meetyaothenstop/vscode/README.md

# STM32G474 双向 Buck-Boost 主工程

用户要求的主工程为 **`MDK-ARM/bidreaction.uvprojx`**，Target 为`bidreaction`，
HEX为`MDK-ARM/bidreaction/bidreaction.hex`。保留正向Buck/Boost及反向Buck/Boost，
不复制工程。原`bench12_buck_fast`保留为唯一受限台架参考。用户自行下载，助手不烧录。

## 当前版本

2026-11-10：**MAIN反向Buck/Boost完整共用正向控制**，版本`FCTRL1`，
标签`main-reverse-forward-control-20261110`。正反向独立状态，反向只映射端口、电流符号和模式。
电压PI0.3/8、Boost前馈0.2倍、90%Vin预充、初始化/滤波/软启动/抗饱和与正向一致；
取消MAIN反向独有HOLD/重新软启动，独立OVP和其他电气/ADC/方向/时序保护保持。
反向Boost欠压仍7V试验，其余三模式9V；ADC物理通道保持。
两Buck50/10kHz、两Boost25/5kHz，PWM/ADC/快速保护150kHz；默认正向18→3V、反向12→18V。
首页`MAIN ADC FCTRL1 R7`，反向页面`REVERSE BUCK/BOOST FCTRL1`。

89组完整回归、144万步对备份正向算法完整状态逐位对比、主/bench ARM6.18构建0错误0警告、
实际映像核验通过；bench HEX保持。主HEX SHA256：
`8335E0910AECE02CA2D87E3F88C80C4CA665CDF798BE3172CDD0171EAA39390F`。
模型12→18V约17.994V；24/35→36V启动正反两方向均触发原过流保护，不能称全范围稳压通过。
新算法启动电流需求可能超过现有0.9A限流，实板仍待用户下载验证；没有证实16V抖动已解决。
修改前`pre-reverse-forward-control-20261110`已先上传核对，
见[版本与备份对照](docs/版本与备份对照.md)和[替换与测试记录](docs/反向共用正向控制测试-20261110.md)。
2026-11-11仅补充主机机制分析：90%Vin预充结束后，输出尚低于输入即进入Boost，
模型中占空命令已到0仍出现接管电流峰值；见[接管输入冲击机制](docs/Boost接管输入冲击机制-20261111.md)。
该分析没有改固件，也未确定实板欠压根因；用户工作区后续默认18→36V改动保留。

## 反向7V试验及16V现场历史（2026-11-09）

修改前板测反馈：7V反向Boost可RUNNING，但12→18V/100Ω的实测与显示输出约16V且抖动，
输入显示12V、电源面板约0.3A、CC不亮。根因未确定，待核对HOLD/参考/占空比；
本次排查未改固件。源码及合成机制证据见[16V抖动排查](docs/反向Boost16V抖动排查-20261109.md)。

2026-11-09后续：用户在反向12→18V、100Ω、电源限流0.9A时报2/IN8.99V，
要求将欠压降至7V试验。本版仅将MAIN反向Boost输入窗改为**7～42V**，
其他三模式仍9～42V；请求与后续各阶段共用该门限，其他保护、ADC、PI及控制频率保持。
保留用户默认正向18→3V、反向**12→18V**；首页`MAIN ADC B25/5 R7`，
反向Boost页`REVERSE BOOST R25V7`。版本标签`main-reverse-boost-uv7-20261109`。
86组完整回归及独立只读审查通过；主/bench ARM6.18构建均0错误0警告，实际映像核验通过，bench HEX保持。
主HEX SHA256：`54B96039A64A9CFA48E7ABD7A8A880C63BCA93AA66AE67188BF7F5E18FC23479`。
7V是用户要求的门限试验，尚未确定8.99V属于真实压降还是采样干扰；实板行为仍待用户下载验证。
详情见[反向Boost欠压7V测试](docs/反向Boost欠压7V测试-20261109.md)。

## 反向Boost门限与频率对齐历史（同日早先）

2026-11-09：MAIN反向Boost的输入/启动/过压检查及控制频率已对齐正向Boost，
版本标签`main-reverse-boost-align-20261109`。
四模式共享输入9～42V、启动严格|IL|<1A、输出残压≤3V、
OVP为min(max(最终目标×1.5,6V),40V)；两个Boost均25kHz电流/5kHz电压计算，
两个Buck50/10kHz，PWM/ADC/快速保护150kHz。
反向保持右ADC1输入、左ADC1输出及负IL，连续PI和原预充/HOLD恢复逻辑保持。
86组完整主机回归、独立旧源72万步状态对比、主/bench ARM6.18重建0错误0警告和实际映像核验通过；bench HEX保持。
首页`MAIN ADC B25/5 R1`，反向Boost页`REVERSE BOOST R25V9`。
主HEX SHA256：`93990C58277572D5109B2E6035DA3866BF8B1AE747F5380C69A9436F31C90CE6`。
保留用户默认正向18→3V、反向12→6V；反向Boost需在菜单选择reverse并设置有效升压目标。
下载由用户操作，实板时序、电气表现及硬件OCP接线未验证。
范围、指纹和复测说明见[反向Boost对齐测试](docs/反向Boost对齐测试-20261109.md)。

用户历次报错的触发条件、已知结论及完整S/T编号见[故障报错对照清单](docs/故障报错对照清单-20261109.md)。

此前接续信息见[2026-11-08对话摘要](docs/对话接续摘要-2026-11-08.md)：用户反馈正向12→24V正常，12→36V/100Ω在0.7A电源限流时报欠压，调到0.9A后报128 S7，尚未定位。本轮未继续排查这些实板故障，板上版本仍需单独核对。

## 主工程欠压9V历史（2026-11-08）

2026-11-08：按用户要求，将MAIN共用输入欠压门限**10V降至9V**，输入保护窗口为9～42V。
适用于正向Buck、正向Boost和反向Buck；请求检查与后续各阶段保护共用
`Core/Inc/power_build_config.h`的`POWER_MAIN_BUCK_INPUT_MIN_VOLTS=9.0f`。
反向Boost保持6～40V，受限bench策略及HEX保持；Buck原占空比/目标可达性检查仍生效。
保留本次工作区已有的正向**12→24V**默认设置（上版为18V输出），反向仍12→6V。
ADC2固定4.8us输入采样、Boost25/5kHz及其余50/10kHz、150kHz快速保护保持，页面标识仍B25A2。
81组完整主机回归及审查后定向边界测试通过；主/bench ARM6.18构建0错误0警告，实际镜像核验通过。
主HEX SHA256：`96CDC014A36699EF721FAFF97398E8ECA5BEA6910E376F3F5E238CCB614973BD`。
修改前4a3b4bd已用`pre-main-uv9-20261108`上传核对，版本标签`main-uv9-20261108`。
验证见[9V欠压测试](docs/主工程欠压9V测试-20261108.md)。用户自行下载并使用配套AXF；不宣称采样噪声或实板T7已解决。

## 正向统一ADC2历史

2026-11-08：按用户要求，将MAIN**正向Buck和Boost的输入电压统一到ADC2/PA0延后采样**，版本`B25A2`。
固定在PWM周期起点后4.8us触发，配置为`Core/Inc/power_build_config.h`中的`POWER_INPUT_ADC_PHASE_TICKS=23040U`。
请求快照、有效性、自举/装载/预充/换向/运行保护和worker使用同一来源；ADC2无效则拒绝启动或关断，无ADC1回退。
电流与输出电压继续原ADC1序列，反向模式保留ADC1语义。
PWM/ADC/快速保护150kHz、Boost25/5kHz、其余模式50/10kHz和10V欠压等全部门限保持。
首页`MAIN ADC B25/5 A2`，正向Boost页`FORWARD BOOST B25A2`，默认仍12→18V。

用户进一步明确关注开关沿干扰：当前4.8us为固定触发，**未动态随PWM占空比避开边沿**。
例如Boost占空指令0.18时，右桥CMP1约4.8467us，仍会靠近触发点；实际还需考虑触发延迟、采样窗口及死区。
本版不保证全工况避沿，也不宣称实板欠压或T7已消除。

81组完整主机回归及独立只读审查通过；主/bench ARM6.18构建0错误0警告，bench HEX保持。
实际HEX/CCM/整数快速路径/AXF导出核验通过。
主HEX SHA256：`ABCB45F73628DA7D55C5817E744CDC62960BAD57533679889AE78101292829F7`。
修改前`802b9ad`已用`pre-forward-input-adc2-20261108`上传并核对；版本标签`main-forward-input-adc2-20261108`。
用户自行下载主工程HEX并使用配套AXF；验证及复测见[正向统一输入ADC2测试](docs/正向输入统一ADC2测试-20261108.md)。

## 正向Boost25/5kHz历史

2026-11-08：主工程正向Boost采用用户批准的**25kHz电流/5kHz电压计算**，版本`B25/5`。
PWM、ADC及快速保护仍150kHz；正向Buck、反向Buck/Boost仍50/10kHz，唯一bench保持原150kHz控制。
mode2每6个PWM请求后台计算，T7窗口由20us变为40us，超期仍关断；其余模式每3个PWM。
仅专用Boost入口积分步长改40/200us，6238rad/s低通按对应步长重新离散化；连续PI增益及每秒斜坡保持。
原一步逻辑延迟在此频率下为40us，实际换向仍需至少3个PWM全关断并等到新的Boost plan。
输入10～42V、启动<1A/残压≤3V等保护门限保持，未因电源表12V反馈放宽欠压10V。
首页`MAIN ADC B25/5`，正向Boost页`FORWARD BOOST B25/5`；其他模式保留原参数页标识。
默认仍正向12→18V、反向12→6V。

78组完整主机回归、两速率旧算法同采样率完整状态对比、四模式名义开关模型通过。
主/bench ARM6.18构建0错误0警告，实际HEX/CCM/快速整数路径/AXF导出核验通过，bench HEX保持。
主HEX SHA256：`8389EC0754E6815AAB6A173CE2CBE537B3FDFC36CADAC166B8992FD30A9A914F`。
降频前`8564652`已用`pre-forward-boost-25k-20261108`上传并核对；版本标签`main-forward-boost-25k-20261108`。
验证与下载后观测见[正向Boost25/5kHz测试](docs/正向Boost25k5k测试-20261108.md)。
用户自行下载HEX并使用配套AXF。本版尚待实板验证，不宣称T7已消除或IN9.9V物理根因已确定。

## 正向Boost精简OPT1历史

2026-11-08：正向Boost后台精简版OPT1，保持150/50/10kHz、PI及保护门限。
真实worker仅mode2改用受保护专用入口；保留全部状态更新，移除未使用的Buck除法。
77组主机回归通过，包括独立旧源两速率共72万步完整B/X/Y逐位比对；主/bench ARM6.18均0错误0警告，bench HEX保持。
专用函数1460字节、1条VDIV，原完整入口1612字节、2条VDIV；这不是实板耗时证明。
用户已重新编译下载精简版，反馈仍报64 T7，并另报2 IN9.9V，电源表12V。
因此本版**未解决实板T7**；2表示ADC测得输入低于10V，瞬态压降与采样异常尚未区分。
用户已批准下一版仅正向Boost改25/5kHz；此处先保留OPT1原版作为降频前基线。
主HEX SHA256：`A16B03ACCC516B9DCB4FBD75D73F511150DB34E510A3007126344BAA5BBF18A7`。
记录见[正向Boost精简测试](docs/正向Boost运行精简测试-20261108.md)，版本标签`main-boost-worker-opt1-20261108`。

## 正向Boost门限对齐历史

2026-11-07：用户明确选择将MAIN正向Boost的全部电气保护与冷启动门限对齐Buck：
实测输入10～42V、启动`|IL|<1A`、输出残压≤3V、
过压线`min(max(最终目标×1.5,6V),40V)`。
统一引用[`Core/Inc/power_build_config.h`](Core/Inc/power_build_config.h)中的`POWER_MAIN_BUCK_*`门限组，
不再保留单独的正向Boost启动电流副本。请求校验与后续冷启动/运行IRQ共用缓存策略。
正向Boost启动仍要求最终目标高于实测输入、目标≤36V；不使用Buck的0.95降压关系。
10～42V是采样保护窗口，不表示当前36V输出上限能够在42V输入时升压启动。
反向Boost保持原6～40V、0.25A/0.25V、目标×1.1；电流参考6A、采样过流7.5A、
方向/ADC/时序保护、Boost预充/换向/软启动和150/50/10kHz频率保持。
这是门限策略调整，不证明原128 S8/S9或故障4的物理根因已解决。

保留用户已设置的正向默认12V→18V、反向默认12V→6V。
标识仍为`MAIN ADC ADG2 50/10`、`M-ADG2`，事件版本4。
75组完整主机回归通过；主/bench ARM6.18构建均0错误0警告，bench HEX保持，独立只读审查无需修正的问题。
主HEX SHA256：`624DA1162750FC0567DD4D6959101F2DE2C6065D6F73BB3F6D1F127C77BDDDDD`。
修改前`7c985e9`已用`pre-forward-boost-align-20261107`上传核对，
本版标签`main-forward-boost-align-20261107`。验证及范围见[正向Boost门限对齐](docs/正向Boost门限对齐Buck-20261107.md)，
前一版仅修改启动电流的记录见[启动1A历史](docs/正向Boost启动1A-20261107.md)。
由用户下载；本次没有操作板子，未证明实板稳压、最坏时序或硬件OCP接线。

## 默认电压设置

正反向菜单的默认输入、输出电压统一在
[`Core/Inc/power_build_config.h`](Core/Inc/power_build_config.h)的`Power-on menu defaults`段。
主工程修改`#if POWER_MAIN_APPLICATION`下面相邻的四个宏：

```c
#define POWER_FORWARD_DEFAULT_INPUT_VOLTS  18U
#define POWER_FORWARD_DEFAULT_OUTPUT_VOLTS  3U
#define POWER_REVERSE_DEFAULT_INPUT_VOLTS  12U
#define POWER_REVERSE_DEFAULT_OUTPUT_VOLTS 18U
```

菜单初始化直接引用这些宏；调试邮箱`power_target_volts`仍默认取正向输出值。
输入设定用于菜单选择Buck/Boost，实际输入仍由ADC测量；这里的默认值不是软启动斜坡起点。
先前集中配置时的等价性验证见[默认电压配置整理](docs/默认电压配置整理-20261107.md)；
当时的正向默认24→12V随后多次由用户调整；2026-11-09修改前以`70e5a84`保存当前18→3V默认。

用户本次反馈反向Buck已能正常从36V降至6V；本次未补充负载、运行时长或同步波形。
该反馈不扩展为全范围、实板最坏时序或硬件OCP验证；历史故障1/4/16的物理根因和调试连接状态未重新核验。

## ADG2版本历史

2026-11-04：当前为**MAIN ADG2 启动ADC入口时序定位候选**，首页`MAIN ADC ADG2 50/10`、参数页`M-ADG2`，事件版本4。
ADG1补充实板记录：ADC1入口0x1（仅ADRDY）、ADC2入口0xF（有EOC/EOS且无OVR）、reason1；用户确认持续运行，只按板上START。
冷启动BOOTSTRAP剩余30，正常闭环尚未投入。已在真实后端的合成迟到时序中复现相同标志/阶段；这不是实板迟到或物理根因的证明。
ADG2仅在ADC故障分支补填原`power_status.fault_spacing_cycles/fault_counter_ticks/fault_elapsed_cycles`，保留精确ADC入口标志，用下一次实板记录验证前一次IRQ迟到的假设。
频率仍为PWM/ADC/快速保护150kHz、电流50kHz、电压10kHz；PI、保护条件/门限及FRM1界面续传保持。用户操作下载，助手未操作板子。
修改前7564102已用`pre-adcphase-20261104`上传核对；版本标签`main-adcdiag2-20261104`。主/台架ARM6.18重建0错误0警告，台架HEX保持。
71组回归及诊断关闭兼容检查通过，独立只读审查无问题；实际镜像/CCM/栈/DMA/AXF及快速整数指令检查通过。
主HEX SHA256：`739DAAE0835E7A8207615E6D8B67473832D11E45665CA3B8819043114328E815`。
复测表达式、证据与假设边界见[ADG2测试说明](docs/ADG2启动ADC时序测试.md)。下载主工程HEX并加载配套AXF，不沿用旧地址；不宣称报1/16已解决。
最新用户反馈：目前主要报4和16，按START立即出现与接近6V后出现两种情况都有。此前提交的截图power_status.fault=0、power_event.fault.valid=0，尚无这两类新故障的有效首包；需读取fault_v_left/right、fault_il及首故障code/state。反向Buck目标6V时，4为计算输出>9V，16为计算IL>+1A连续16个PWM采样；ADC专用字段不用于判断这两项。真实越限与采样偏差仍未区分，未据此改动固件。
最新阻塞：Keil大量`Cannot access Memory`，同一fault独立项16与结构体0x01010000矛盾；用户确认OLED正常刷新、显示4。用户确认功率输出停止且故障保留后，助手尝试一次暂停CPU，Keil报`Cannot access target. Shutting down debug session.`，未能确认暂停成功；保留错误弹窗，未复位/重连/下载。用户要求先整理交接，完整接续信息见[2026-11-04摘要](docs/对话接续摘要-2026-11-04.md)，先恢复可靠调试读取，再判断电气根因。

## ADG1版本历史

2026-11-04：当时为**MAIN ADG1 ADC首故障定位候选**，首页`MAIN ADC ADG1 50/10`、参数页`M-ADG1`。
用户确认OLED已正常刷新，但按START一开始偶发报1，工况仍是右12V→左6V、100Ω。
报1为ADC有效性保护，尚无足以确定转换/触发/清标志根因的实板记录，不能据此认定控制频率过高。
本版关断后锁存原中断入口ADC1/ADC2标志，新增`power_event.fault.adc_reason`及`adc1_entry_flags/adc2_entry_flags`，事件版本3。
原因1=缺JEOS，2=JQOVF，3=两者同时，4=正向Buck所需ADC2延后采样无效；`fault_detail`同步记录原因，OLED故障码仍为1。
保留FRM1界面续传，频率仍为PWM/ADC/快速保护150kHz、电流50kHz、电压10kHz；PI和保护条件/门限保持。
修改前d54d61a已用`pre-adcdiag-20261104`上传核对，版本标签`main-adcdiag1-20261104`。
70组回归和诊断关闭兼容后端通过，独立只读审查无阻断问题；主/台架ARM6.18重建0错误0警告，实际镜像/CCM/栈/DMA/AXF及快速指令检查通过，台架HEX保持。
主HEX SHA256：`82AD7C7F52F283F974369F1B8F45C204F83DB79E6A4A9AF7C62E9B68176A7428`。
用户自行下载原主工程HEX并加载配套AXF，复测方法及原因表见[ADG1测试说明](docs/ADG1故障1定位测试.md)。不沿用旧地址，不宣称实板报1/16已解决。
ADG1首次故障截图：valid=1、code=1、detail=1，锁存冷启动BOOTSTRAP（state=1）、反向Buck（mode=3），自举剩余30、占空指令/参考均0；启动年龄0x570个CPU周期（按150MHz约9.28μs）。已定位到闭环运行前的ADC1入口JEOS缺失分支，原始ADC入口标志尚未提供，触发/完成/清标志根因待查。

## FRM1版本历史

2026-11-04：当时为**MAIN FRM1 界面续传与长时间观测候选**，首页`MAIN ADC FRM1 50/10`、参数页`M-FRM1`。
用户更正万用表电流检测输出为2.49V（运行及报错后），输出约5.9V，界面约1～2分钟后恢复并报16。
修复已复现的启动/运行切换时反复丢帧问题：暂停保存页面快照，数据包完成后推进页码，完整帧后合并新遥测；停止/故障仍优先，启动不开始新传输。
power_event.version=2，新增完整帧计数及基于既有ADC周期数的年龄，避免仅凭28.63秒回绕的DWT解释分钟级现象。
ADC计数不是独立墙钟；物理电流反转/采样尖峰/ADC异常未区分，本版不宣称16或实板问题已消除。频率、PI、保护门限保持。
修改前14b4a76已用pre-oledframe-20261104上传核对，版本标签main-oledframe1-20261104。
69组回归及独立只读审查完成；主/台架ARM6.18重建0错误0警告，实际镜像/CCM/栈/DMA/AXF和快速指令检查通过，台架HEX保持。
主HEX SHA256：`E0A1963EEFFAC4E2E9399342CE7F9FFCC6BB4CD7B64FDA79105472D4B6A365BE`。
验证记录及用户复测方式见[FRM1测试说明](docs/FRM1界面续传测试.md)。继续原主工程，用户自行下载HEX并加载配套AXF，不沿用旧地址。
用户随后报告FRM1的OLED已可正常刷新，但偶尔报1。代码1为ADC有效性保护：ADC1注入序列未完成/队列溢出，或适用时ADC2延后输入样本无效；尚无本次故障包，不能认定控制频率或模拟电流门限为根因。

## EVT1版本历史

2026-11-03：当时为**MAIN EVT1 故障阶段/前台进度诊断候选**，首页`MAIN ADC EVT1 50/10`、参数页`M-EVT1`。
基于RAW1定位反向12→6V、100Ω的故障16及OLED停更，频率/PI/保护门限保持；不宣称已修复实板问题。
Watch新增`power_event.fault`，关断后锁存原状态、自举/装载/恢复计数、指令，以及前台/UI入口和上次页面提交的时间。
前台双缓冲发布不新增关中断区，正常快速IRQ/worker无新增事件探针；下载由用户操作。
66组回归通过，主/台架ARM6.18重建0错误0警告，实际镜像/CCM/栈/DMA/AXF及快速指令检查通过；台架HEX指纹保持。
主HEX SHA256：`C8BA5AD2686512F89992D31F3282BB414555903AF222EF9A37371D1B0515936B`。
修改前9652d4b已用`pre-eventdiag-20261103`上传核对；版本标签`main-eventdiag1-20261103`。
由用户下载原主工程HEX并加载配套AXF，按[EVT1测试说明](docs/EVT1故障定位测试.md)复测，故障后保留`power_status`及`power_event.fault`。
启动准备期间mode/target可能是暂定配置；页面提交不等于物理显示完成，计时/现场解释限制见测试说明。
最新EVT1复测仍报16：锁存RUNNING、恢复标志1、参考4.300V、输出5.453V、电流+1.006A。
本次前台/UI入口最大间隔约22ms，故障前约1.7ms执行过；主机复现启动/运行频繁切换导致界面反复重发第0页、后续页饥饿的机制。
这未唯一证明实板界面根因，也未定位真实回流/采样原因；固件仍EVT1，详见[EVT1现场](docs/EVT1反向故障16现场-20261103.md)。

## RAW1版本历史

2026-11-03：当时为**MAIN RAW1 整数快速路径候选**，首页`MAIN ADC RAW1 50/10`、参数页`M-RAW1`。
PWM、ADC及快速软件保护仍为150kHz，电流环50kHz、电压环10kHz。
快速IRQ使用原始ADC整数区间及Q24脉冲密度累加，换算和浮点控制计算放在PendSV；原保护边界和T1..T7保留。
增加正常快速路径峰值、worker启动等待、运行墙钟时间和观测到的快速IRQ C耗时字段，便于区分下一次T7的时间消耗。
修正前040164c已以`pre-fastirq-raw-20261103`备份到GitHub。版本标签`main-fastirq-raw1-20261103`。
62组回归通过，主/台架ARM6.18重建均0错误0警告；实际HEX/AXF导出、CCM/PendSV/DMA及正常快速函数无FP指令检查通过。
主工程栈2KiB，台架HEX与此前逐字节一致。主HEX SHA256：`EC70E24DD17AC423BAA0C875F83C4F595246AE9813FD9F72FBE6F1239F5CA04A`。
用户反馈反向12→6V、100Ω时万用表到6V，OLED数秒停更后报16；锁存输出5.225V、电流+1.232A。
经用户授权只读查看Keil，恢复标志1、自举/装载计数均0、最后发布参考4.1898V；至少经历过HOLD恢复，故障不在未完成的自举/装载等待中。
本次记录为方向保护，尚未定位真实回流/采样异常及OLED停更根因，不能据此称实板时序、闭环稳定性或硬件OCP接线通过。
固件仍为RAW1，未修改/重新下载；现场和补测见[反向故障16记录](docs/RAW1反向故障16现场-20261103.md)，原交付验证见[RAW1测试记录](docs/控制降频RAW1测试.md)。

## 50/10kHz首版历史

2026-11-03：当时为**MAIN 50kHz电流环 / 10kHz电压环候选**，首页`MAIN ADC I50 V10`、参数页`M-50/10`。
PWM载波、ADC触发和快速软件保护仍为150kHz；控制计算移到可被快速中断抢占的PendSV，每3个PWM周期请求一次。
电压PI每5次电流环更新一次。积分/反馈滤波器按20us/100us重新离散化，连续PI增益保持。
计算完成后在最近的安全PWM中断提交两侧比较值，下一共同更新边界装载；未能在下一次50kHz请求前完成则报64 T7关断。
低占空比Buck/预充使用逐PWM周期最小/空脉冲密度调制，避免三周期脉冲成组引起低压启动摆动；正反Boost交接全关断等待新plan。
30周期自举、2周期装载等待及原有电气保护门限保留。唯一台架参考保持150kHz控制，HEX与RES1台架一致。
修改前源码已以`pre-control-multirate-20261103`备份到GitHub并核对远端SHA；大改前备份约定已写入AGENTS.md。
54组回归通过，主/台架ARM6.18均0错误0警告，实际HEX/CCM/PendSV/DMA/AXF导出核验通过；主工程专用栈2KiB。
这是待用户下载的候选，**尚无实板最坏时序或闭环稳定性验证**。构建和测试记录见[控制降频记录](docs/控制降频50k10k测试.md)。

## RES1版本历史

2026-11-03：当时为**反向Buck HOLD分步恢复候选RES1**，首页`MAIN ADC RBUCK RES1`、参数页`M-RRES1`。
W128后用户在12→6V遇到64 T5：907/1000/31072，恢复标志1、自举剩余30，确认在HOLD恢复开通低侧后超退出相位。
仅MAIN反向Buck将恢复计算/缓存与低侧开通拆到相邻IRQ：先保持全关断，下周期新鲜采样及全部保护后复查再开低侧；
完整30周期自举和2周期装载等待保留。840/27904、936/29952及T1/T2/T6、电压/电流保护保持。
48组完整回归、独立代码审查、主/台架ARM重建0错误0警告、实际HEX/CCM/DMA/无探针及AXF导出核验通过；台架HEX未变。
主HEX SHA256：`B0231D707403A763FA916BFD5CF72535160FB7ABA88B3E756B295D031CF97A55`。
本版未板测，不能据此声称T5或输出异常已消除；用户自行下载，见[分步恢复测试](docs/反向Buck分步恢复测试.md)。
下个对话接续请先读[2026-11-03对话摘要](docs/对话接续摘要-2026-11-03.md)；相同摘要已整理用于最初的`双向buckboost.md`文档顶部。

## 反向W128版本历史

2026-11-02：当前为**反向Buck W128写入窗口候选**，首页`MAIN ADC RBUCK W128`、参数页`M-RW128`。
OPT1交付后用户反馈64 T4：写前792周期、间隔1000、相位27232，比旧26880线晚11CPU周期。
本版仅将MAIN反向Buck写前相位期限26880→27904，与正向相同，更新前工程预留160→128CPU周期；
写前DWT840、写后DWT936/相位29952及T1/T2/T6保持，Boost/台架仍26880。
PI、ADC/PWM、OPT1精简直达路径及电压/电流保护保持；48组回归及主/台架ARM重建0错误0警告，
实际HEX/CCM/无探针/DMA/AXF导出核验通过；成对写入段13条ARM指令与OPT1相同，台架HEX保持。
主HEX SHA256：`8376F6A02A2C32C86D16BD85C072A85AB67D711783A62877F7083BABBE5B58BF`。
128/64周期为工程预留，不是板上最坏耗时证明；本版待用户下载测12→6V，见[反向W128记录](docs/反向Buck写入窗口W128测试.md)。

## 反向首步OPT1版本历史

2026-11-02：当时为**反向Buck首步时序OPT1候选**，首页`MAIN ADC RBUCK OPT1`、参数页`M-RBO1`。
首版交付后的用户截图为64 T3：写前855周期、间隔1000、相位29248，超过840及26880两条截止线；
参考0.1V、isr_cycles_max0符合首次控制步写前退出。当前减少重复校验/通用分发与小占空比转换开销，
只让已通过ADC及输入/输出/电流保护的后台直达Buck步；公开reverse_step接口继续检查无效输入。
时序门限840/26880、936/29952及T1/T2/T6均保持，PI/采样/PWM/全部电压电流保护保持。
48组回归通过，公开/直达路径共60万次位一致性及独立旧源参考比对通过；主/台架ARM均0错误0警告，
实际HEX/CCM/无探针/DMA与AXF导出一致性通过，台架HEX未变。Buck主体788→656字节，非实测周期结论。
主HEX SHA256：`ABE8985210FC9D531A1BFB235F3A888CBC0AAC0EE1478D6746A9AE6FA55E623D`。
本版仍待板测，不能由主机/静态代码声称T3/T4已经修复。用户自行下载并重复12→6V，见[首步时序OPT1](docs/反向Buck首步时序优化测试.md)。

## 反向12V→6V首版历史

2026-11-02：当时为**反向Buck12V→6V候选**，首页`MAIN ADC RBUCK12-6`、参数页`M-RB126`。
右侧输入12V、左侧输出6V；反向菜单默认12/6，四模式及同一主工程保留。
反向Buck保护对齐当前正向：实际输入10–42V、目标≤实际输入×0.95、OVP=min(max(目标×1.5,6V),40V)，
6V目标过压线9V；启动|IL|<1A/输出残压≤3V。6A参考/7.5A采样过流及反向错误极性检查保持。
新增反向Buck编译期精简控制步及内联比较值映射；Buck/完整Boost共享模板，PI参数保持。
反向Buck沿用较早的写前T4=26880，增加写后绝对T5=29952；DWT840/936及T1/T2/T6保持。
48组回归通过，含30万次逐步一致性、旧提交控制器比对及12→6V名义开关模型；主/台架ARM6.18均0错误0警告。
实际HEX/CCM/无探针/DMA、反向精简步/完整步及AXF导出一致性核验通过；台架HEX未变。
主HEX SHA256：`697435B7A09E3B4AA4E5244268D9F1DFA71A855D7BF35336D71668CEC19EC27B`。
本版未板测，静态代码体积和主机测试不证明板上时序/电气结果。用户自行下载，见[反向12→6V测试](docs/反向Buck12V转6V测试.md)。

## 正向过压6V下限版本历史

2026-11-02：当时为**正向Buck过压6V下限、40V上限候选**，首页`MAIN ADC OVP6-40`、参数页`M-OV640`。
用户要求目标低于6V时，原过压门限不足6V的提高到6V。仅MAIN正向Buck应用：
`OVP=min(max(目标×1.5,6V),40V)`（有效非零目标）；1/2/3/4V目标均为6V，5V仍7.5V、6V仍9V。
0V关断、启动1A/3V、反向Buck/Boost/台架、W128、PI/ADC/PWM和运行电流保护保持。
47组主机回归及主/台架ARM6.18重建0错误0警告，实际HEX/CCM/无探针/DMA及AXF导出一致性核验通过。
主HEX SHA256：`224F5F2F2EAB0CD0D2D38D150E1A4C800A3B06290E0E3A4A3D72EE80B7466D95`。
本版未板测；本次只改变过压门限，未证明低目标过冲/采样根因修复。用户自行下载，见[6V下限记录](docs/正向Buck过压6V下限测试.md)。

## 正向启动1A/3V版本历史

2026-10-31：当时为**正向Buck启动1A/3V候选**，首页`MAIN ADC START1A 3V`、参数页`M-S1A3V`。
用户在36V输入、18V目标报128 S8后要求放宽启动准备门限；仅MAIN正向Buck改为
电流绝对值<1A、输出残压≤3V，启动请求及待启动/自举/上管开放前复查使用同一门限。
反向Buck仍0.5A/1V，Boost仍0.25A/0.25V；准备时长、软启动初始参考0.1V、PI/ADC/PWM、
6A参考/7.5A采样过流、负向电流保护、W128及正向OVP=min(目标×1.5,40V)保持。
47组主机回归通过，主/台架ARM6.18重建0错误0警告，实际HEX/CCM/无探针/DMA及AXF导出一致性通过。
主HEX SHA256：`2CF1E6DFB537CAE7F0BE536A8F25B3F71F1E6B590F32F8281A580DADC03EC35B`。
本版未板测，未认定S8的物理根因或修复结果；用户自行下载，见[启动1A/3V记录](docs/正向Buck启动1A3V测试.md)。

## 正向OVP1.5、40V封顶版本历史

2026-10-31：当时为**正向Buck OVP1.5、40V封顶候选**，首页`MAIN ADC OVP1.5 C40`、参数页`M-15C40`。
按用户后续要求，正向Buck保护线=`min(目标×1.5,40V)`：9V→13.5V、26V→39V、27/30/36V→40V，
原36V目标对应54V的问题已在门限设置中取消。菜单0–36V及降压输入关系、其他模式/台架保护保持。
反向Buck仍×1.25，Boost仍×1.1，单次采样停机/首故障、W128时序、PI/ADC/PWM和6A/7.5A保持。
47组回归、主/台架ARM6.18重建0错误0警告，实际HEX/CCM/无探针/DMA及AXF导出一致性通过。
主HEX SHA256：`17BDE4B29EFDF0072DA76A4D302A6651965456751EC71214039F29039B4E8880`。
40V是软件保护设定上限，不是实际峰值保证；本版未板测，也未证明低目标过压根因修复。
用户自行下载，见[40V封顶测试](docs/正向Buck过压40V封顶测试.md)。

## 正向1.5未封顶版本历史

2026-10-31：当时为**正向Buck OVP1.5测试候选**，首页`MAIN ADC OVP1.5 6A`、参数页`M-OV1.5`。
按用户要求，仅主工程正向Buck过压线改为目标×1.5：9V→13.5V、12V→18V；
反向Buck仍×1.25，正反Boost仍×1.1，唯一受限台架指纹不变。
保护仍是单次原始ADC换算值越限即关断并锁存，W128时序、PI/软启动、ADC/PWM及6A参考/7.5A停机保持。
47组当前主机回归通过，主/台架ARM6.18重建均0错误0警告，实际HEX/CCM/无探针/DMA及AXF导出一致性通过。
主HEX SHA256：`4E5AAA5F828CCC15C33CFBED3412065002F0BE7D453967C4CDD2CB206E6EC2F5`。
这是放宽保护的测试候选，尚未板测，不代表低目标过压根因已修复。
**36V目标的新保护线是54V，高于用户此前所述50V电容额定；本候选仅供当前24V低功率测试，
不能据此认定36V/高压工况得到保护覆盖。** 用户自行下载；详细步骤见[正向Buck过压1.5测试](docs/正向Buck过压1.5测试.md)。

## W128与1.25倍过压版本历史

2026-10-31用户板测反馈：24V输入时，12V及其上方的降压目标可稳定输出，低于12V时报故障4。
本反馈接续W128交付，板上Flash身份、负载/运行时长及电气波形尚未独立核验。
用户随后补充11V及以下均报4，OLED读数闪一下即保护；该现象尚不能定位电气触发时刻。
最新用户截图已取得9V目标的故障4：锁存输出11.5719309V，超过11.25V保护线约0.322V，
保留参考9V、占空比0.393263996、采样电流−0.141685486A；尚缺故障前一控制步反馈和PI状态，
不能由锁存采样单独判定真实过冲或PI饱和。名义100Ω模型24→11/10/9/8/6/1V均未复现过压，
9V目标峰值约9.010953V；这些不是板测。见[低目标排查](docs/低目标输出保护排查.md)。
随后用户确认同次故障并提供控制状态：前一步输出采样10.0994549V、电流0.246299744A，
电流参考0.390101403A、外环积分0.71421355、内环积分0.0156148393；电流环占空比算术吻合。
到故障11.5719309V的相邻采样差约1.472V，优先同步抓输出电容端与PA1波形；尚未认定PI饱和或ADC误报。
主工程没有12V输出下限：非零后端目标允许1–36V，12V仅为默认值，0V为PWM关闭。
故障4是输出采样超过目标×1.25的保护；当前重点为低目标下的过压触发，待区分真实过冲与采样偏高，
不据此宣称全范围或最坏时序通过，也未改变PI或保护门限。

2026-10-30：当时为**W128写入窗口候选**，首页`MAIN ADC W128 6A`、参数页`M-W128`，
同一主工程保持`POWER_UNIFIED_DIAGNOSTICS=0`，四模式、PI、ADC/PWM150kHz、使能顺序及保护电流保持。
仅主工程正向Buck的写前绝对相位期限26880→27904，原160CPU周期预留改为128周期，
写前DWT840保持；新增该模式写后绝对相位T5检查29952，预留64周期给剩余检查/返回。
原DWT收尾936、T1/T2/T6保持；主Boost/反向及台架写前期限仍26880。
128/64是待板测的工程预留，静态反汇编不能证明总线/FPU/异常返回最坏耗时。
47组主机回归通过，包含首控制步792/27232、27904/27905、29952/29953、T3优先/T5/T6、
四模式切换和首故障保持；主/台架ARM6.18零错误零警告，实际HEX CCM/无探针/DMA核验及AXF导出一致。
主HEX SHA256：`221D8D688D62346430E208BA6BE16ED19B5421B2B1F7CF1F44AE5D944DABDA7B`。
台架HEX保持`A9BA257BA3FFBB49C8FAED9803E3462671F692A9B4D063C9975512D09EF6D451`。
主`power_status`链接地址已变为`0x20000B10`，不要沿用OPT2的旧绝对地址。
构建轮次未下载、连接调试器或操作板子；用户后续稳压反馈见上，完整返回余量及硬件OCP仍未独立验证。
用户下载和取数见[写入窗口测试](docs/主工程写入窗口测试.md)。

## OPT2历史（0b277f9）

2026-10-30：当时为**OPT2无插桩时序优化候选**，首页`MAIN ADC OPT2 6A`、参数页`M-OPT2`，
同一主工程保持`POWER_UNIFIED_DIAGNOSTICS=0`。
前一OPT实板读到64 T4：806周期、间隔1000、写入计数27680，超过相位期限800刻度。
OPT2将Buck比较值映射内联，并消除未使用占空比字段保存；PI/采样/四模式/使能及保护条件保持。
46组回归通过，主/台架ARM零错误零警告，实际HEX CCM/内联/无探针/DMA检查通过。
该OPT2主HEX SHA256：`D845A25DB8D14F24294885701FA8EED4EE5DF230A169D3FF4DE6DA3EC2BF93E8`。
共享代码台架新指纹为`A9BA257BA3FFBB49C8FAED9803E3462671F692A9B4D063C9975512D09EF6D451`。
OPT2交付后的最新用户截图显示64 T4：写前792周期、间隔1000、定时器计数27232，
超过26880相位期限352刻度，等效11个CPU周期、约73ns；参考仍约0.1V、isr_max为0。
截图地址与当前MAP一致，但尚未独立核验板上固件身份。806/27680属于前一OPT版；
两次读数相差14周期不等于受控提速或最坏余量证明。下一步核查完整中断/首次使能预算。
不能声称T4已消除；接续上下文见[对话接续摘要](docs/对话接续摘要-2026-10-30.md)，
操作与取数见[主工程OPT2测试](docs/主工程OPT2测试.md)。

## OPT1历史（dd3e6ff）

2026-10-30：当时为**无插桩时序优化候选**，首页`MAIN ADC OPT 6A`、参数页`M-OPT`，
同一主工程显式设置`POWER_UNIFIED_DIAGNOSTICS=0`。
依据首次控制步的分段记录，将固定保护限值移到启动发布前计算，并为主Buck增加固定模式PWM映射。
PI、四模式、ADC相位、使能顺序、6A参考/7.5A停机与840/936时限保持。
46组回归通过，主/台架ARM重建零错误零警告，实际HEX CCM/无探针/DMA检查通过。
当时台架HEX指纹不变。该版主HEX SHA256：
`FC0F63F5641465B0293D941270DA603C4E713D0C0E5CC0A7842D4719869FAD5F`。
尚未验证本候选的实板耗时或T3消除；下载与取数见[主工程时序优化测试](docs/主工程时序优化测试.md)。

## 分段诊断历史（8dc59c7）

2026-10-30：用户在24→12V启动时立即遇到64 T3，非插桩实测858周期、
计数器29344，参考约0.1V。当时同一主工程启用`POWER_UNIFIED_DIAGNOSTICS=1`，
当时交付的是**分段计时诊断候选**，用于定位首控制步热点，尚未修复或验证消除T3。
首页`MAIN ADC DIAG 6A`，参数页`M-DIAG`。PI/四模式/6A参考/7.5A停机及840/936时限保持。
45组回归通过，ARM重建零错误零警告，实际HEX CCM/DMA检查通过。
该诊断HEX SHA256：`E6F5E9E4364F70DC0FAE56BAEE760A908F9E61051E3E81BFB8392F48F6D2CC17`。
助手没有板上操作；取数步骤见[主工程T3诊断](docs/主工程T3诊断.md)。
诊断探针改变耗时，不能用其总耗时直接比较下面的非插桩版本。

## 非插桩主工程基线（4bb0c4f）

- 主配置`POWER_MAIN_APPLICATION=1`、`POWER_MAIN_ADC_SOFTWARE_ONLY=1`，台架标志全为0。
  用户明确选择ADC软件保护测试；硬件OCP接线/就绪不伪造，当前未确认硬件保护。
- Buck菜单输入12–40V、输出0–36V，保持1V步进，默认正向24→12V、反向36→12V。
  非零后端目标1–36V；0V为关闭全部PWM、负载被动放电，不是主动0V稳压/放电。
  零请求可在准备/运行/故障时执行，取消待启动并保留首故障；正目标重启仍须新鲜样本与冷启动条件。
- 限流控制为电流参考上限6A；采样过流保留主工程原7.5A，为跟踪瞬态留余量。
  参考是电感采样控制目标，实际纹波/瞬时峰值和平均负载电流不等同该数值。
- Buck输入采样保护10–42V，为标称12/40端点留余量；输出保护为目标×1.25，
  36V目标对应45V；冷启动要求电流绝对值<0.5A、输出≤1V。
  Boost沿用原输入6–40V、目标1–36V、1.1倍OVP及0.25A/0.25V冷启动；反向Boost同原策略。
- 降压输出须低于实际输入。正向Buck请求及每次新样本均检查目标≤实际输入×0.95，
  36V可在40V输入下测试；12V输入下设置36V时菜单选择Boost。不可达的Buck请求拒绝启动，
  运行中输入跌至不可达时停机。反向Buck保留严格输出<实际输入及原HOLD/恢复流程。
- 正向Buck用优化控制步，正向Boost保留完整步，反向算法保留；共用一个步模板，
  通过STOP/重新初始化切换，PI系数不变。所有模式热路径迁入CCM，840/936周期保护保持。
- 正向Buck和STOP显示使用ADC2晚PA0采样；活动Boost/反向继续原ADC1反馈时序，
  每周期清理不用的ADC2标志；需要的采样缺失/溢出仍停机。STOP/清故障使样本失效，重启需新样本。
- OLED使用200ms调度的前台DMA页刷新，按键/STOP先处理、启动阶段静默；
  主界面`MAIN ADC SW 6A`，参数页`SW-MAIN`，与台架版本区分。

2026-10-30复验：**43组主机测试通过**（旧32组保留），包含主工程四模式、零输出所有阶段、
新旧采样选择、硬件故障锁存、输入/目标/过流边界、不可达/输入跌落、DMA和菜单。
优化/完整控制步对比540000个Buck及120000个Boost样本，并验证模式重新初始化。
名义100Ω开关模型覆盖12→1/6/11V、24→12V、40→1/12/36V，40→36V最终约36.015V、
峰值36.216496V；这些不是实板测量或6A满载验证。

主工程Keil ARM6.18重建0错误0警告；Code45500/RO1288/RW44/ZI4476。
CCM7712字节，运行0x10000000、加载0x080098A4；实际HEX向量/启动拷贝、四模式函数、
DMA普通SRAM和无插桩检查通过。主HEX SHA256：
`C21781791837435A881C1C96CB96A9982E10094D842736E7459EFF39D50A7749`。
本轮没有连接、下载、复位或启动硬件；主工程板上时序、电流标定、各负载和全范围稳定性待验证。
详细范围/0V语义/启动步骤见[主工程Buck测试](docs/主工程Buck测试.md)。

## 受限台架历史（共享源码参考）

下列记录属于以前台架实验；本轮共享代码重建台架也通过0错误0警告、CCM/显示链接检查，
新台架HEX哈希为`7D9ADE7EC0931D15CEA20725440093E05D75BE36B98B11FE4B0A2B6FB23C0056`。
旧记录中的哈希仅对应其当时构建，不代表现在磁盘上的主工程或台架映像。

- 24V→12V过压15V/采样过流6A待测版：OLED首页 `24V BUCK DMA OVP15 C6`，参数页 `SW15-C6`。
- 用户最新反馈：12V输入已可稳定输出6V，同时OLED正常显示。已记录为用户板测反馈，
  未独立核对运行时长、波形、最坏IRQ耗时或固件指纹。
- 当前受限正向Buck默认设置24V输入、12V输出，后端目标允许1–12V。
  用户已补充负载额定150W、输出电容耐压50V；若继续100Ω，12V稳态负载功率1.44W，
  这两项额定值有余量。用户随后说明输入/输出对称、当前输入24V，并确认正常STOP/输出关闭；
  两侧电容按该用户描述记录为50V，未独立读取器件标识，也不代表整板应力验证。
- 用户确认电流电阻串在电感与右桥之间；右输出电容标称2×220µF＋2×10µF，
  合计460µF，台架模型已按此修正。
- 准备阶段 `|采样电流| < 0.5A`、右输出电压 `<= 1V`。
- 当前24V测试档输入允许20.0–28.0V，给标称24V留出采样余量，
  启动及运行统一检查，超出窗口仍按单次采样立即关断。
- 用户在24V档报故障8后要求最大电流6A：本档采样过流门限1.5A→6A，电流参考仍1.0A。
  冷启动0.5A/1V、反向电流和ADC量程保护保持；旧12V档采样过流仍1.5A。
  硬件过流保护接线尚未验证，6A门限不等于保证实际峰值受限。
  1A参考是电压环给电流内环指令的上限；实际采样电流有纹波和超调，可超过该目标。
  6A是独立的采样过流停机线，负载平均电流则由负载及输出电压决定。
  固定相位采样电流不等于平均负载电流：实际C开关模型在24→12V、0.5A参考下只到6.367V；
  0.75A在28V输入也不能到12V。1.0A在20/24/28V输入的名义模型均收敛12V，
  最大采样电流约1.079A、输出峰值约12.589V。这些不是板测或真实瞬时电流上界。
- FAST输入电压改为ADC2在每周期4.8µs硬件触发采样同一PA0；ADC1电流、
  输出电压采样时刻及PI参数保持。缺少新鲜ADC2结果或溢出时拒绝启动/停机。
- 用户在6A版交付后报告故障4并要求保护提高到15V：24V档输出保护为15/12倍，
  12V目标对应15V，6V目标对应7.5V，低目标仍按比例；默认/最高目标仍12V。
  PI保持。`POWER_BENCH_24V_BUCK_TEST`默认随FAST开启，显式0恢复旧12V档的
  10–14V输入、默认6V、0.5A参考及8/6倍输出保护；非FAST仍为原配置。
- 控制热路径放置于 CCM；裁掉未参与 Buck 的 Boost 计算。
- 840周期写入、定时器相位和936周期收尾等时序保护仍启用。
- FAST运行态恢复每200ms调度一帧遥测，通过I2C1 TX DMA分8页发送，
  控制IRQ优先级0、显示IRQ优先级3。启动请求/预充电/等待使能仍暂停新显示传输。
- 按键和STOP先处理；显示错误或单包超过50ms时将显示锁定离线直到复位，
  不等待屏幕、不复用可能仍被DMA使用的缓冲。此时控制/按键继续，屏幕可能停在旧值。
- `POWER_BENCH_LIVE_OLED`在FAST默认1；设为0可恢复原来的全活动态静默对照。

2026-10-29本轮24V候选版：完整主机测试32组通过，Keil ARM6.18重建0错误0警告。
包含24V档20/28V请求边界及各启动/运行阶段越界、15V相邻ADC码首次关断、
低目标比例、ADC2失效、冷启动、电流/反向/时序保护、菜单/实时UI/STOP，及旧28组回归。
Code40420、RO1288、RW32、ZI4264；CCM3380字节，加载0x080095B8、运行0x10000000。
CCM拷贝/向量/无插桩及显示DMA/I2C向量/普通SRAM缓冲检查通过。
HEX SHA256：`744BE08E77F5F78F9F5DD417255C01ABC313BEF55D8D97FED45A5A227BA5788C`。
输出raw865约14.98461V通过、raw866约15.00193V首次关断；6V目标7.5V比例保护通过。
新增6A边界检查：raw3822约5.99333A通过，raw3823约6.00142A首次停机并锁存。
原动态模型采样峰值<1.5A断言保持，不因保护放宽而放宽模型要求。
当前15V/6A候选尚未由助手下载。按用户要求，只交付编译固件，由用户操作下载。
本次故障4仅为用户报告，未读取同次RAM/波形或重新核对板上身份；提高门限不等于根因修复。
前一版1.5A固件在用户确认STOP后下载，Keil日志18:46:59显示Erase Done、
Programming Done、Verify OK，CLI退出0；该旧1.5A版AXF导出HEX的SHA256为
`F07116B02C42882430DAC75602AEECB8F07C36F70CA7D4FD1BD4841EB189E631`，与新6A候选区分。
用户已确认旧`SW24-14`及12V目标，随后手动启动报故障8。HOTPLUG只读得到首故障采样
1.6527462A/raw3285、输出6.0804605V、保留参考7.170691V、前步电流参考0.6817135A。
PI参考未达1A上限；实际电流/电压波形及根因仍未确认。现场已保存，未清故障或重启。
后续按[Buck测试步骤](docs/Buck优化版测试.md)执行，840/936周期门限保持。

前一轮12V显示修复反馈：实际输出已可稳定在6V，但OLED停在启动前一刻。
源码确认原FAST启用了运行态静默，这足以解释此显示现象；本轮未连接调试器核对
板上固件身份和电气波形，也未下载、复位或启动板子。
当时实时显示候选版通过28组主机测试及Keil ARM6.18重建（0错误0警告），
含DMA页快照、错误/超时/时钟回绕、繁忙或离线时STOP、启动静默及旧FAST对照。
CCM向量/拷贝/无插桩检查通过（3384字节），新增DMA/I2C向量与普通SRAM缓冲通过核对。
Code40412、RO1288、RW32、ZI4264；HEX SHA256为
`9444BC857DAE17ED4159AE13CA9BB7AD78FC476571A9F70DAEE89ED407FFC924`。
随后授权的下载尝试因“No ST-LINK detected”未完成，用户按Esc停止Computer Use。
用户之后报告12V→6V与OLED均正常；本轮没有读取核对这次实际板上固件身份。

前一版本软件验证（2026-10-29，8V保护静默版）：25组主机测试通过，含54万个算法采样点对比、
7.05056V样本通过、8V两侧相邻ADC码的通过/首次关断、较低目标比例保护、ADC2六个配置/启动失败点
及缺失/不完整/溢出样本保护；Keil 编译0错误0警告。
CCM向量、拷贝和无插桩检查通过，代码3384字节；IRQ反汇编确认晚采样读取为
寄存器操作，无新增HAL等待调用。这些检查不证明板上耗时和采样精度。
新HEX已生成，本轮没有下载、复位或启动硬件；板上8V效果待验证。新构建后不能
直接把旧AXF/旧故障读数当作新映像的现场。ARM中保护系数字面量已核对为0x3FAAAAAB（8/6）。
固件SHA256为`6B66382C4F72FC9F3CAD21AF988D5B5945E4BDE1DE7CB5AFC0E03721A09FE94F`。
用户提供调整电容后的PLECS截图并报告仿真电流上限6A、PI未改，输出收敛到约6V。
该截图不等同实板采样或全工况闭环验证；实板仍为0.5A电流参考上限及1.5A采样过流。
2026-10-28最新现场：Keil已有17:35:55的Verify OK日志；直接读取板上Flash和
执行中的CCM，均为7/6保护系数，相关IRQ指纹及状态地址也与当前AXF一致，
未进行整片Flash哈希比对。实际目标/软启动参考均为6V，fault=4，首故障输出
7.05056286V（raw407），上一控制步输出反馈5.94187450V，电流参考0.22793305A，
占空比0.46383464。PI算术相符且未到上限，不能据此判定积分饱和；相邻输出采样
相差1.10868836V，需要同次输出电容/PA1波形区分真实过压与采样瞬态。
用户确认尚未抓到本次波形。已记录的isr_cycles_max=773来自已完成的普通路径，
不是这次故障IRQ耗时。会话保持暂停，未发送复位、清故障或启动命令；输入晚采样
效果、完整稳态及长期时序仍未通过实板验证。
较早板上反馈（2026-10-26）：Buck FAST 连续计算至参考约0.601V后触发输入保护2，
用户报告 IN13.53V；此前记录中断最大耗时755周期，首次控制计算的T3障碍本次已跨过。
用户随后用万用表及示波器观察输入约11.9–12V，因此采样干扰需继续核查。
随后另一次报IN10.31V，说明故障采样也存在偏低读数；当前已放宽到10–14V，待复测。
当时完整6V运行尚待验证；后续6V用户反馈见上，不等同独立时序验证。详见[板上测试记录](docs/板上测试记录.md)，
操作步骤见[Buck优化版测试](docs/Buck优化版测试.md)。

此前输出保护调查：10ms/div、约6.63V上升沿触发的示波器记录显示峰值6.6875V，
随后输出放电，真实输出越过6.6V保护线已有测量依据。460µF理想模型峰值约6.136V，
尚未复现板上越限；当时PI状态因调试连接丢失未能读取，固件PI参数暂未调整。

2026-10-27最新重读：旧会话读取故障RAM及CPUID均报AGDI读取失败，
此前Watch零值不能作为实时现场。重新附加后，未加载符号即按当前AXF核对的
RAM地址取得完整12项：fault=4，fault_v_right=6.65212822V，参考5.74725485V，
上一控制步V_right=5.17965174V，电流参考0.35579288A，占空比0.421813309。
该控制步的PI运算与代码系数一致，不能据此认定积分饱和；需解释上一控制输入
与首故障采样相差约1.472V。此次参考尚未到6V，勿与历史尝试拼接。
SWD请求1MHz（选择0.950MHz），Cache Memory关闭；保留不自动下载、
不自动运行到main、不连接后复位的配置。当次会话保持暂停，PI参数未修改；
未执行下载、复位、清故障或启动命令。原12项Watch 2保留，新会话尚未加载
符号，因此当前显示cannot evaluate；有效数值来自Command的直接RAM查询。
完整数值、地址及证据边界见[板上测试记录](docs/板上测试记录.md)。

## 以前使用的工程

| 工程文件（MDK-ARM 下） | 用途 |
| --- | --- |
| `bidreaction.uvprojx` | 通用工程 |
| `ocp_verified_build.uvprojx` | 硬件保护配置验证 |
| `bench12_buck.uvprojx` | 12V 受限 Buck 台架 |
| `bench12_buck_oled_test.uvprojx` | OLED 活动期间暂停刷新对照 |
| `bench12_unified_diag.uvprojx` | 分段耗时与首故障诊断 |
| `bench12_ccm_diag.uvprojx` | CCM 放置及耗时诊断 |
| `bench12_ccm_base.uvprojx` | CCM 无额外耗时插桩对照 |
| `bench12_buck_fast.uvprojx` | 当前维护的 Buck 优化工程 |

这些工程共享 `Core` 和 `Drivers`。这次 Git 初始提交记录的是当前文件状态，
不是过去各次测试时的完整源码历史；旧工程重新编译会使用当前共享源码。
此前的源码备份、诊断记录、构建脚本和固件哈希保存在 `.superpowers` 相关目录，
设计与测试文档在 `docs`。原先嵌套的 `bidreaction` 目录作为已有参考资料保留。

## 构建和版本记录

GitHub 仓库：[meetyaothenstop/vscode](https://github.com/meetyaothenstop/vscode)。
`origin` 使用 SSH 地址：

```text
git@github.com:meetyaothenstop/vscode.git
```

按用户约定，每次新版本或修改完成并验证后，都要提交并推送当前分支及该版本新建的
标签到 GitHub，不再等待单独的上传请求。推送后核对远程分支提交号；本地提交不等于
上传完成。若网络或认证失败，保留本地提交并明确说明待上传，不强制覆盖远程历史。
若SSH认证尚不可用，可使用同仓库的HTTPS地址及本机已有Git凭据推送，保留SSH
`origin`并说明实际上传方式；不关闭主机验证。
主应用维护既有`MDK-ARM/bidreaction.uvprojx`，受限台架仅保留上述唯一参考工程；
上传源码、测试和文档，不上传可重建二进制及IDE界面状态。

Keil MDK 工程使用本机 ARM Compiler 6.18；生成的 HEX 位于
`MDK-ARM/bidreaction/bidreaction.hex`。
受限台架参考产物另为`MDK-ARM/bench12_buck_fast/bidreaction_bench12_buck_fast.hex`，
不作为主应用下载文件。
编译产物可以重新生成，由 `.gitignore` 排除。

运行主机回归：

```powershell
./tests/run_tests.ps1
```

普通修改在同一个工程进行，完成适当验证后提交。记录板上测试结果时，注明
提交号、输入电压、负载、故障码和关键观测值；确认有意义的测试节点后再打标签。
首次导入不能标记为“硬件已通过”。通过 Git 查看/恢复旧文件时，不需要复制工程目录。
