meetyaothenstop/vscode/.superpowers/hardware-overcurrent/progress.md

# SDD ledger — plan: docs/superpowers/plans/2026-10-23-hardware-overcurrent.md

- User asks to add hardware-fast overcurrent code; original circuit and code use INA240A1 OUT on PA2,2.5V zero,.1V/A. MCU STM32G474CBT6 LQFP48 confirmed inIOC.
- No Git repo. Work in authorized outer project; source backups before mutation. No flashing or physical operations.
- Pre-flight: backend and driver share the four PowerProtection APIs; backend tests use a stub, hardware module has separate fixture. Hardware pin confirmation is pending; default image must not allow an unverified power start.
- Ruling: use internalCOMP1/COMP2 +DAC3 andFAULT4/FAULT1, not ADC polling. G4 lacks common-input window mode; need two extra physical signal connections. PB1/PA7 proposed and unused incode; user asked asynchronously about board availability.
- Ruling: prepare the code with confirmation0, no unknown GPIO configuration, startup fault512; actual activation waits for verified wiring, regardless of code build success. Costs: current default HEX no longer starts power until commissioning.
- Primary hardware route audit complete: RM0440Table228 confirmsCOMP1→FLT4 andCOMP2→FLT1; CSR.VALUE is before inversion, soCOMP2raw0 islowerfault; DACMODE3 internalnormal, transfer/4096; hardwarefaultclearsOEN andrequiresmanualrearm; commonFLTlockfreezesenablebits,enablebeforelock. INAresponse andinputrange limitations recorded.
- Task1: complete. BackendtestfirstfailedmissingprotectionInitcall. Init/readiness512/FAULT256/startfinalcommit/clearIRQ andperiodpollimplemented; testsPASSincludingtransientflag,activeclearrefusal,pendingstart,allmodesandHOLD. Addedbootstrap/arming/changeover andforegroundcommitfaultcoverage.
- Task2: complete. TestsREDinitialmissingmodule; initialmodulefailedinvalidhandleleavingIERenabled, movedmaskbeforehandlevalidation. Confirmed/unconfirmeddriver testsnowPASS; testscover15HALfailurepoints,rawpolarity,bothroutes/DACcodes,bootflagpreservation,maskonlyIRQandACKraces. DefaultKeil0errors0warnings; enabledbranchverifiedcopyKeil0errors0warnings(Code38684RO1292RW40ZI4176).
- Ruling: KeilcannotparseXmlDocument-reserializedemptytags(producedexit15,nolog); verificationprojectnowcopiesraworiginaltextandreplacesonlydefines/outputpaths. Verifiedbuilddoesnotchangeoriginalprojectdefaultguard0 oritsHEX.
- Independent finalreview foundP1: shortfaultafterentrypollcouldbeoverriddenbylaterOENinsamepriorityTimerIRQ. Newafter-safe-snapshotinjectionreproducedRED(ARMING→RUNNING,output0xf,fault0). Centralenable_outputsnowchecksbefore&afterOEN, tripsandabortsallfourenablepaths. Testsforentry/preenableinjectionatcoldbootstrap/finalarming/readyBoostchangeover/HOLDresumeGREEN. Reviewerrecheckedandre-ranbackendPASS, no remainingimportantfindings. No zero-instruction-window orphysicaldelay guaranteeclaimed.
- Task3: complete. Finalfreshfullsuite12/12PASS; bothKeilfullrebuilds0errors/0warnings. DefaultCode35768RO1272RW40ZI4080; enabledverificationCode38936RO1292RW40ZI4176. Staticforeground528+IRQ144+FPframe104≈776/1024B(withunknownboundaries); steadyFaultPendingstack0andnoHALcalls.
- Finalartifacts: Core/Src/power_protection.c, Core/Inc/power_protection.h; updatedmainKeilproject+ISR/backend+HALdrivers/tests; 硬件过流保护接线与验证.md andPWM使用说明.md. DefaultHEXMDK-ARM/bidreaction/bidreaction.hexremainsguard0(START→FAULT512); enabledbranchonlycompileverifiedseparateMDK-ARM/ocp_verified. AwaitphysicalPB1/PA7wiringavailability/confirmation; noactivation, flashing orpoweroperationperformed. OriginalPLECSreversehashesunchanged. DownloadmanualhelpercancelledwithCtrlCafterserverstall; primarymanualevidenceobtainedthroughSTindexedsectionsinstead.
