meetyaothenstop/vscode/docs/superpowers/specs/2026-11-07-forward-boost-t7-design.md

# 正向Boost T7计算精简设计

## 依据与目标

用户已同意针对正向Boost正常运行的T7核对预算并优先做保持控制行为的精简。
首包valid1/code64/detail7/state3/mode2，目标与参考均18V，软件运行年龄237.378ms。
此前锁存输入12.010574V、输出18.01618V、IL0.618118A；请求到检查3388周期，
已完成请求峰值2985周期，不能由这些峰值唯一确定纯PI或抢占耗时。

实际ARM6.18基线完整正向控制步1612字节、两条VDIV，其中一条计算未选择的Buck前馈。
目标是减少MAIN mode2后台的无效运算，保持所有有效控制输出和控制器状态逐步一致。
交付为待用户板测的优化候选，不把静态指令减少称为T7已消除或实板WCET通过。

## 方案

采用既有编译期控制模板生成受保护的`forward_main_boost_step()`：固定mode2使能，
移除未选择的Buck前馈除法及零权重Buck电流参考项，保留其余预充、滤波、PI、斜坡、
积分器状态和更新顺序。只由已通过保护的多速率worker调用，公共`forward_step()`保留原行为。
新增入口按既有reverse后台头文件模式声明，错误模式清输出并锁存错误。

选择该方案是因为可明确限定调用契约，并保持公共完整路径作为兼容路径。
仅在通用函数中跳过未选分支会扩大公共输入语义变化；改变控制频率涉及重新离散化，
本轮不采用。没有冻结任何预充或滤波状态，以便对全部B/X/Y做独立基线逐位对比。

## 保持的约束

- 沿用现有`codex/main-buck`及活动`MDK-ARM/bidreaction.uvprojx`；原IDE改动排除在提交外。
- 唯一bench仍为`bench12_buck_fast.uvprojx`，四模式保持；用户操作下载。
- PWM/ADC/快速保护150kHz、电流50kHz、电压10kHz及PI、全部门限、T1～T7保持。
- 受保护入口消费已初始化mode2及新鲜、有限、正输入电压的ADC快照；不供未校验外部输入调用。
- 紧急关断、启动、换向、HOLD、取消/发布竞争逻辑保持。
- 修改前标签`pre-boost-t7-opt-20261107`已上传核对，指向`307bcdd2b06b0e086968c88d3aa5e129c00e24e2`。
- 新入口必须在CCM，HEX拷贝/向量、AXF导出、栈/DMA位置需核验，二进制不提交。

## 验收

以备份标签的独立旧源编译参考控制器，在150kHz兼容及实际50/10kHz两种配置下逐步比较
预充、切换、软启动、随机反馈、饱和及重初始化的B/X/Y和电压更新数。
实际ARM入口VDIV由2条减至1条、函数小于基线完整步，worker确实调用新入口且位于CCM。
完整回归与主/bench构建通过、bench HEX保持，再做独立只读审查、提交上传核对远端。
