meetyaothenstop/vscode/docs/superpowers/specs/2026-10-29-bench24-ovp15-design.md

# 24V档15V输出保护试验

用户在6A固件交付后报告“这次报错4，把输出电压保护升高到15v”；未独立核对该次板上固件身份。
按既有比例保护语义，将24V档比率14/12→15/12：12V目标对应15V，6V目标对应7.5V。
只维护bench12_buck_fast工程，旧12V档8/6和非bench1.1保持。
采样过流6A、参考1A、输入20–28V、默认/最高目标12V、PI、ADC/DMA及时序保持。
新首页`24V BUCK DMA OVP15 C6`、参数`SW15-C6`，均须适配21列。
测试14.2V通过、15V相邻ADC码首次停机/锁存及低目标比例，原13.2V名义模型峰值断言保持。
本次只收到用户故障4报告，未读取本次RAM/真实波形；提高门限不证明过冲或采样根因修复。
按用户最新要求仅修改、验证、上传和交付固件，不连接板子或代为下载。
