meetyaothenstop/vscode/docs/superpowers/specs/2026-10-29-bench24-oc6-design.md

# 24V档6A采样过流门限试验

用户在24V→12V启动报错8后明确要求“将最大电流升为6安”。按该故障上下文，
本次将24V档采样过流门限1.5A→6A，电流参考上限保留1A；不是要求恒流输出6A。
只维护既有bench12_buck_fast工程，不复制工程。

故障8首现场已用HOTPLUG只读取得并保存；报错时采样电流约1.652746A、输出6.08046V、
参考7.17069V，前一步电流参考约0.6817A，未达1A参考限幅。尚未取得同次真实电流/电压波形，
该门限修改是用户要求的试验，不证明原事件为误报或已修复采样/环路根因。

- 24V档仅改采样过流宏6A；旧12V档1.5A、非bench7.5A保持。
- 目标12V、输入20–28V、输出保护14V、参考1A、启动0.5A/1V、反向电流、ADC量程和
  ADC新鲜度、PI/相位、DMA及840/936时序保护保持。
- 新首页`24V BUCK DMA OVP14 C6`（21列），参数`SW24-C6`，明确区分已下载旧1.5A版。
- 验证旧故障1.652746A可通过；6A两侧相邻ADC码、首次关断/锁存、量程端点及其他保护保持。
  名义动态模型的原1.5A采样峰值回归断言不随保护放宽。
- 编译/CCM/链接/主机验证后提交推送。下载会复位并清现场，需保持故障停机或STOP；
  当前故障8现场保留后才下载，不自动发功率启动。板上6A门限和运行效果待测试。
