meetyaothenstop/vscode/docs/superpowers/specs/2026-10-29-bench24-design.md

# 24V→12V受限Buck测试设计

用户已报告12V输入下可稳定输出6V并更新OLED，要求下一步24V→12V，适当提高保护范围。
这是用户板测反馈，未独立测量持续时间、波形或板上固件指纹。

继续唯一活动工程`MDK-ARM/bench12_buck_fast.uvprojx`，不创建复制工程。
选择现有FAST配置中的编译开关`POWER_BENCH_24V_BUCK_TEST`，默认随FAST开启；
显式0保留旧12V→6V测试，非FAST仍用原配置。与直接全局改门限相比，这保留历史回归；
新增独立工程不符合用户约定。具体电压余量由用户要求“适当提高”授权工程判断。

- 24V档默认输入设置24V、输出12V，后端目标允许1–12V，仍只接受正向Buck。
- 输入启动/运行窗口20–28V；采样越界仍首次关断，无新增滤波或故障忽略。
- 输出保护比例14/12，12V目标对应14V，6V目标对应7V；越限仍首次关断。
  14V是本次选择，低于照搬旧8/6比例所得16V；并非用户确认的元件耐压。
- 24V档电流参考1.0A，旧12V档0.5A；采样过流1.5A、反向电流保护、冷启动0.5A/1V保持。
  真实C开关模型证实24→12V沿用0.5A只达到6.367V，固定相位采样电流不等于平均负载电流。
  0.75A在28V输入只能8.826V；1.0A在20/24/28V均收敛12V，模型采样峰值1.079A。
  这是本次基于模型的配置决定，不能代替板测或作为瞬时峰值电流上界。
- PI、软启动、ADC2晚采样、DMA OLED、840/936时序保护保持；不自动启动输出。
- OLED首页`24V BUCK DMA OVP14`，参数页`SW24-14`，用于区分档位。
- 下载/24V上电前确认STOP和输出关闭，并确认负载功率/元件耐压。100Ω在12V下1.44W，
  大于旧6V下0.36W。原始上下文给出额定输入12–36V，未证明本次元件额定值。
  同日用户后续确认负载额定150W、输出电容耐压50V；输入侧耐压和当前STOP状态待确认。
  再后续用户说明输入/输出对称、当前24V且正常STOP/输出关闭；已下载校验，功率输出待测。

验证：旧28组保留，新增实际24V输入/12V目标的后端保护、菜单与实时UI、理想开关模型；
核对20/28V边界及越界、14V邻近ADC码首次故障、低目标比例、电流/ADC/时序保护。
ARM重建、CCM/向量/SRAM检查和独立审查。软件检查不证明实板时序/电气通过。
最后按长期约定提交推送并核对远程SHA。
