meetyaothenstop/vscode/docs/superpowers/specs/2026-10-29-live-oled-design.md

# FAST运行态OLED实时显示

用户报告实板可稳定输出6V，OLED停在启动前画面。源码确认原因是
POWER_TEST_SKIP_OLED_ACTIVE令pending/STARTING/RUNNING直接返回。
恢复FAST稳定运行态的既有200ms刷新周期；启动阶段不开始新的显示传输。

## 边界

- 同一bench12_buck_fast工程/分支，保留现有未提交IDE设置。
- 6V目标、8V输出保护、0.5A电流参考、1.5A过流、输入10–14V、PI和采样相位保持。
- HRTIM优先级0和840/936周期保护保持；显示DMA/I2C中断优先级3。
- 使用DMA1_Channel1/DMAMUX的I2C1_TX。无其他DMA用户。
- HAL_I2C_Master_Transmit_DMA发送SSD1306控制字节和负载；避免Mem_Write_DMA
  中仍存在的I2C_RequestMemoryWrite轮询。初始化屏幕的阻塞操作仍在PWM启动前完成。

## 传输与UI

一页先发送4字节命令包，再发送129字节数据包（含0x40控制字节）。
驱动复制到静态独立缓冲；DMA使用期间不修改。完成/错误回调只标记状态，
后续传输由前台轮询推进。只在上一页完成后接受下一页，整帧完成后才重新绘图。
HAL_BUSY表示未完成，不当作失败。按键扫描/STOP在传输轮询之前执行。

pending/STARTING时不启动新页；正在发送的数据包允许完成，完成的命令包可直接
舍弃其数据阶段。STOP/FAULT后重画完整新帧，不沿用先前页号。

每个包超时50ms。初始化/提交/异步错误或超时只令显示离线，停止其IRQ及后续提交，
直到复位后重新初始化；不阻塞等待、不在故障路径重置共用时钟、不影响控制或按键。
该取舍避免在卡住的总线上反复重启DMA或复用仍被DMA持有的缓冲。

## 验证

硬件边界测试验证包内容、快照所有权、分阶段完成、错误/超时/计时回绕、IRQ配置。
UI行为测试验证RUNNING下6V读数更新、启动静默、繁忙时STOP和故障后的完整重画。
保留旧静默配置测试，完整主机回归及ARM/CCM检查、独立代码审查。
本轮只准备候选固件，不在用户正在稳定输出时下载/暂停CPU；板上显示、总线和
最坏控制耗时需在停机后换版实测。按AGENTS提交、推送并核对GitHub。
