meetyaothenstop/vscode/PWM使用说明.md

# PWM 与双向闭环使用说明

本次修改的是外层 `bidreaction` 工程。Keil 工程为 `MDK-ARM/bidreaction.uvprojx`。

**2026-10-25 独立12V测试版：用户选择暂不新增硬件过流飞线，使用可调电源12V/0.2A开始正向Buck。另建 `MDK-ARM/bench12_buck.uvprojx`，输出独立HEX，仅允许输入10.5～13.5V、正向Buck、目标1～6V，电流参考0.5A、采样过流1.5A，OLED带SW标识。默认工程仍保留下面的硬件保护启动要求。详见[12V正向Buck测试](docs/12V正向Buck测试.md)。十五组主机测试和两个最终Keil构建通过；实际PWM/驱动与功率闭环仍待实测。**

后续实板报告不同尝试出现128、64、2，静态反馈11.95V/0.03V/0.1A，电源未见CC；根因尚未确认。最新同路径测试HEX为诊断版，首页 `12V BUCK SW DIAG`，保留首故障S/T子码、计时值及故障时采样，报2时底行显示锁存输入电压。仍未放宽任何保护门限，详见上述测试文档的诊断章节。

**2026-10-23 更新：已加入可配置的双向硬件过流代码。默认未确认新增 PB1/PA7 接线，`POWER_OCP_WIRING_CONFIRMED=0`，当前默认固件拒绝功率启动并显示 `FAULT:512`；OLED、按键、ADC可用。见 [硬件过流保护接线与验证](硬件过流保护接线与验证.md)。**

## 硬件前提

- PA0 / ADC_VH：左侧 H_VIN+ 电压；PA1 / ADC_VL：右侧 L_VIN+ 电压。
- PA2 / ADC_L：**电感电流**。新增 5 mΩ 电阻串在 SW_1 与 D4 左端之间，INA240A1 的 IN+ 接 SW_1 侧，IN− 接 D4 侧。U8 原来通向输入 R33 的采样连接应改接到新增电阻两端。
- 2026-10-24/25 初步实板标定统一在 `Core/Inc/adc_measure.h`：ADC 参考 3.31 V、左侧电压增益 0.0461、右侧电压增益 0.04666、电流零点 2.49 V。INA240A1 增益 20、5 mΩ 对应 0.1 V/A，电流增益尚未用已知电流验证。OLED、控制中断和硬件过流阈值共用这些参数。
- 左侧标定依据：未焊 MOS 管、STOPPED 状态，实测输入 11.83 V，旧显示约 11.57±0.02 V；上一组 11.93 V 对旧显示 11.63～11.68 V 也基本一致。按旧增益 0.047 与旧参考 3.30 V，修正增益为 `0.047×(11.57/11.83)×(3.31/3.30)≈0.046107`，取 0.0461。随后实测 11.93 V 对显示 11.91～11.94 V、5.88 V 对显示 5.89～5.91 V，已作初步复核。PA0 的粗测 0.54 V 不用于精确反算增益。
- 2026-10-25 右侧初标依据：右侧供电、reverse 页面，端口实测 11.9 V 对旧显示约 11.8 V，23.9 V 对旧显示 23.70～23.77 V；两处 IL 均约 0～0.1 A。取后一组显示中值 23.735 V，拟合共同显示比例约 1.00725，右侧增益暂取 0.04666；读数精度有限，这不是精密校准。新固件烧录后需复测两点，预计显示约 11.89 V、23.87～23.94 V。此项不增加显示滤波，原有小幅波动仍会显示；当前零点和名义电流灵敏度保持不变。
- PA10 = 左上管，PA11 = 左下管；PA8 = 右上管，PA9 = 右下管。两路驱动输入均按高电平有效。
- 该版本按双侧均只有自举供电设计，已接入正反向 Buck / Boost。正向输入左侧、输出右侧；反向输入右侧、输出左侧。IL 始终以物理左到右为正。

## 已接入的执行链路

HRTIM A CMP2 → HRTIM ADC Trigger 2 → ADC1 注入序列（PA2 电流、PA0 VH、PA1 VL）→ 下一个 Timer B 周期中断 → 按方向执行 `forward_step()` 或 `reverse_step()` → Timer A/B 比较值预装载 → 下一周期共同生效。每周期只执行一个方向的控制器。

2026-10-24 实板排查修正：原代码误用 HRTIM ADC Trigger 1。该触发源仅适用于 ADC3/4/5 的注入组；其 JEXTSEL 编码在 ADC1/2 上实际选择 TIM16_CC1，导致无采样、OLED 实时反馈持续显示横杠。现改为 ADC1 支持的 Trigger 2，并使用 Timer A CMP2，保持周期 25% 的采样时刻。后台测试增加 ADC 实例与触发路径检查；之前的主机合成 JEOS 测试未发现此硬件映射错误。

- CPU/HRTIM 基础时钟 150 MHz，HRTIM 倍频 32，周期寄存器 32000：150 kHz。
- A/B 同时启动，两个周期相同；A 驱动右侧，B 驱动左侧。
- 硬件互补输出，双边正死区 200 ns；死区寄存器时钟为 150 MHz × 8，数值 240。
- ADC 时钟 37.5 MHz，每路采样 24.5 周期，加转换 12.5 周期；三路共约 2.96 μs。在周期 25% 处触发，在下一周期开始读取。
- ISR 不轮询 ADC，也不调用毫秒延时。主循环的 `adc_measurements` 为同步注入采样的换算结果。

自举刷新适配以有效上管占空比表示：

| 方向/阶段 | 左上管 | 右上管 |
| --- | --- | --- |
| 正向 Buck/预充 | `0.85 × D_cmd` | `0.85` |
| 正向 Boost | `0.85` | `0.85 × (1 − D_cmd)` |
| 反向 Buck/预充 | `0.85` | `0.85 × D_cm_R` |
| 反向 Boost | `0.85 × (1 − D_cm_R)` | `0.85` |

这样保留理想平均电压变比，同时让两边下管均周期导通。比较值补偿 200 ns 的上管导通延迟。正向保持原约 267 ns 最小有效脉宽。反向 Buck/预充的输入侧脉冲小于此值时使用 CMP1=0 的零占空比，避免冷启动时强制小脉冲造成电流冲击；依赖 HRTIMv2 连续模式、周期置位、CMP1 复位及 EQUAL 比较设置（AN4539 A.1.9）。反向 Buck/预充命令允许到 1，但实际上管占空比仍不超过 85%；Boost 命令上限 0.95。**停止通过关闭全部输出实现**。

这些设置采用 ST [AN4539 HRTIM cookbook](https://www.st.com/resource/en/application_note/an4539-hrtim-cookbook-stmicroelectronics.pdf) 中的互补输出、预装载和同步 ADC 触发机制。刷新时间是否满足实际自举充电条件，需要测量 HB–HS 电压确认。

## 启动和停止

上电运行采样与时间基准并显示首页，四路 PWM 输出均禁用。硬件保护接线与配置就绪后，只有在参数页确认 `start` 才请求启动。

### OLED 与四按键

0.96 寸 OLED 按 128×64、6×8 字体显示。首页选择 `forward` 或 `reverse` 后，直接进入参数页，不再单独选择 Buck/Boost。

| 按键 | 浏览时 | 电压编辑时 |
| --- | --- | --- |
| KEY1 / PB4 | 向上循环选择 | 加 1 V |
| KEY2 / PB5 | 向下循环选择 | 减 1 V |
| KEY3 / PB6 | 进入、编辑或执行 start/stop | 确认保存 |
| KEY4 / PC13 | 返回首页；运行中先停机 | 取消本次修改 |

左列从上到下是 `input_v`、`output_v`、`start`；右列是只读的 `IL`、`intput_ret`、`output_ret`，分别显示电感电流、输入电压和输出电压，约每 200 ms 更新。`>` 为当前选择，`*` 为正在编辑。数值在标签下一行显示，底部显示状态或故障码。

`input_v` 是外部输入电源的标称设置，不会调节外部电源；范围 6～40 V。`output_v` 是闭环输出目标，范围 1～36 V。正反向各保留一组 RAM 参数，重新上电恢复默认：forward 12→36 V，reverse 36→12 V。

标题按已经确认的设置自动显示 `BUCK` 或 `BOOST`：输出低于输入执行 Buck，输出高于输入执行 Boost；两者相等时提示 `SET VIN != VOUT`，不启动。实际启动还会检查 ADC 实测输入电压与目标的关系；若标称设置与实际输入不一致，可能被拒绝启动。

选择 `start` 按 KEY3 后，先显示 `STARTING`，进入实际运行后显示 `RUNNING`，原位置变为 `stop`。再次确认 `stop` 或按 KEY4 返回均停机；启动准备阶段也可停止。启动/运行中不允许编辑电压。

reverse 页面已接入反向控制，按设定电压自动选择反向 Buck 或 Boost，并显示右侧输入、左侧输出电压。反向运行时 IL 为负，不应再次取反。无有效采样显示 `--`。

故障保持锁存并显示 `FAULT:位掩码`；菜单不自动清故障或重启，使用下面的调试命令显式清除后，再按 start。硬件故障来源仍有效时不得清除；保护未确认接线时，再次启动仍被拒绝。OLED 逐页传输，每轮主循环最多发送一页，传输与绘字不关闭 HRTIM 控制中断。

OLED 初始化使用 `20h + 02h` 的页寻址设置，与逐页传输相配合，见 [SSD1306 数据手册，第 10.1.3 节](https://www.olimex.com/Products/Modules/LCD/MOD-OLED-128x64/resources/SSD1306.pdf)。

### 调试器启停接口

在 Keil Watch 中查看 `power_status`，使用运行期间可更新变量的调试方式修改：

| 操作 | 变量赋值 |
| --- | --- |
| 正向 Boost，默认输出 36 V | `power_target_volts = 36.0`，然后 `power_command = 1` |
| 停止四路输出 | `power_command = 2` |
| 清除锁存故障，回到停止 | `power_command = 3` |
| 正向 Buck | 先设 `power_target_volts`，然后 `power_command = 4` |
| 反向 Buck | 先设 `power_target_volts`，然后 `power_command = 5` |
| 反向 Boost | 先设 `power_target_volts`，然后 `power_command = 6` |

主循环读取命令后会自动清零。清除故障不会自动启动。前台 `Power_RequestStart(mode, target)` 的模式为：1=正向 Buck，2=正向 Boost，3=反向 Buck，4=反向 Boost；例如反向 36→12 V 调用 `Power_RequestStart(3U, 12.0f)`。停止/清故障接口为 `Power_Stop()`、`Power_ClearFault()`。

启动检查要求：至少两组采样有效，输入 6～40 V，输出目标 1～36 V，静态电流绝对值小于 0.25 A，**输出电容已放电至 0.25 V 以下**。当前按零输出冷启动设计，避免输出已有残压时小占空比预充电引起反向电流。Boost 要求输入小于目标，Buck 要求输入大于目标。启动先只开放两侧下管约 200 μs，等待比较值生效，再开放上管。

**带电运行期间不要断点暂停或单步控制 ISR。** 暂停 CPU 会让软件保护停止执行，调试器命令也需要主循环继续运行才能处理。

## 控制器适配与限值

沿用原 `forward.c` 的电压 PI、电流 PI、反馈滤波器、预充电和 Boost 状态机。为 MCU 做了以下修改，当前文件不再与 PLECS 原始导出文件逐字相同：

- 模型状态、接口和常量改为单精度，使用 Cortex-M4F 硬件浮点。
- `forward_configure()` 设置初始参考、目标和电流参考上限。Boost 参考从启动时输入电压开始，以 120 V/s 升到目标并保持；Buck 从 0.1 V 开始。
- 预充电结束门槛从 95% 输入改为 90%，避免停留在可达占空比边界；保留原三周期延迟和 Boost 电流参考渐入。
- 电压环参考电流上限暂设 6 A，预充电参考仍最多 2.5 A；增加 PI 条件积分，限制饱和时继续积累。
- 采样电流绝对值达到 7.5 A、PA2 接近 ADC 上下轨、输出超过目标 110%、输入超界、控制结果非法、ADC 序列缺失或计算超时，均关断四路输出并锁存故障。正向仍在 IL＜−1 A 时判定方向异常；反向以连续 16 次 IL＞+1 A 判定方向异常（约 107 μs），容许同步 Boost 轻载恢复的短暂纹波。绝对过流判据不做这项延迟。

反向工程副本另外修正了原始导出的以下问题（桌面 `plecs/四开关代码/reverse.c/h` 保持不变）：

- 原参考固定从 24 V 开始、以 120 V/s 无上限增加；现支持目标配置并限幅。反向 Buck 从 0.1 V 开始，Boost 从实测输入开始，Boost 预充期间暂停参考爬升。
- 原预充参考以 500 A/s 无上限增加；现限制在 2.5 A，电压环电流参考上限 6 A，并使用条件积分。
- Boost 前馈由错误的 `Vin/Vref − 1` 改为 `1 − Vin/Vref`。
- 反向预充门槛为 99% 输入电压，配合预充命令上限 1，降低进入 Boost 时的电感冲击；原三周期延迟期间关闭四路输出。Boost 比较值再跨过一个预装载边界后才重新使能输出。
- 输出达到最终目标的 100.5% 时进入 `POWER_HOLD`：关闭四路输出，继续更新滤波与参考，冻结电压积分并清除电流积分。输出降到目标的 99% 以下、且 |IL|＜0.25 A 后，参考从实测输出重新起步，保留 Boost 状态，刷新自举 200 μs、等待正确比较值生效后恢复。避免空载继续充电和轻载反复恢复时积分累积。OLED 将 HOLD 显示为 RUNNING，仍可停机，不能编辑电压。

`power_status.state`：0=停止，1=自举，2=比较值准备，3=运行，4=故障，5=反向预充切换，6=反向输出保持。

6 A 是首轮软件参考上限。原采样电路 +8 A 已对应 3.3 V 满量程，因此留出裕量；本次没有把软件设置成能在 8 A 附近持续调节。输入 12 V、目标 36 V 时，负载过重会触及电流限制，不能保证升到目标。

`power_status.fault` 是位掩码：1=ADC，2=输入电压，4=输出过压，8=过流/电流 ADC 轨，16=反向电流，32=控制器，64=计算超时，128=启动条件不满足，256=硬件过流，512=保护未就绪。`power_status.protection_ready`表示硬件保护外设配置状态，默认为0。`power_status.isr_cycles_max` 记录成功执行的最长 ISR 周期数；150 MHz 下一个 PWM 周期为 1000 个 CPU 周期。

PA2 反馈是固定相位的瞬时电感电流，不能直接当作平均值或峰值。软件电流门槛约束的是采样值，纹波峰值可能更高；需要结合实测纹波设置允许的负载和限流值。相邻中断进入时间也会检查，防止漏执行整个周期却被 REP/JEOS 的单个标志位掩盖。

已加入 COMP1→HRTIM Fault4、COMP2→Fault1 的双向过流代码，初始约±7A、回差10mV，不启用消隐或数字滤波。只有确认新增接线并编译启用后才配置硬件路径；默认保持未就绪并阻止启动。故障硬件关断四路，软件锁存，不自动重启。实板阈值、输入限压、噪声及响应延迟尚未验证。

## 验证范围与后续实板检查

主机测试覆盖占空比映射、刷新窗口、非法命令、参考上限、状态复位，以及 22 μH / 690 μF / 36 Ω 平均模型下的正向 12→36 V 收敛。平均模型不包含 MOSFET 开关过程、死区体二极管、ADC 噪声、采样相位造成的电流纹波偏差和 PCB 寄生参数；不能作为实板稳定性证明。

另有理想开关数值测试，按实际电流采样相位和一周期预装载延迟运行同一控制器；它也不包含真实死区二极管导通和 INA240 瞬态响应。运行全部主机测试：在工程根目录执行 `./tests/run_tests.ps1`（需要 gcc）。

当前共十二组主机测试。`reverse_control_test` 覆盖参考/电流限幅、状态复位、反向 PWM 和八组平均模型；`reverse_switching_test` 覆盖十一组 Buck/Boost 理想开关工况，包括空载、轻载停脉冲恢复，使用实际 ADC 采样相位和一周期预装载延迟。`power_control_test` 编译真实后台与控制器，通过隔离的寄存器仿真验证启动、预充切换、正确方向的电压/电流保护、停机、故障清除、ADC/时序故障及 HOLD 恢复；该仿真不测量实际执行时间。

`power_menu_test` 和 `power_ui_test` 还覆盖反向自动模式、真实模式编号 3/4、切换/HOLD 状态及按键停机。`oled_render_test` 使用实际字库核对绘字边界、页寻址命令并导出预览。[菜单预览](docs/previews/oled-menu.png) 为主机生成的真实字库图，尚不是实板拍照。新增硬件保护测试分别覆盖确认/未确认配置；后台还验证短故障发生在输出使能前后的竞争。最新构建日志为 `MDK-ARM/ocp_unconfirmed_build.log`及`MDK-ARM/ocp_verified_build.log`，生成固件为 `MDK-ARM/bidreaction/bidreaction.hex`。

本次两种配置 Keil 完整构建均为0错误、0警告。默认未确认配置：Code35768B、RO1272B、RW40B、ZI4080B；启用硬件通路的编译验证配置：Code38936B、RO1292B、RW40B、ZI4176B。静态调用图前台最大栈528B、启用配置控制中断调用链144B；加硬件浮点异常帧104B后估算约776B，当前栈1024B。调用图有未知边界，仍须实板检查余量。反向周期控制采用 F32 硬件浮点，未调用双精度运算库；前台 ADC 换算仍保留原有双精度。尚未下载或运行功率板；150 kHz 的实际 ISR 预算（每周期 1000 CPU 周期）需观察 `power_status.isr_cycles_max` 和保护状态确认。

实板首次测试先观察四路逻辑 PWM 的引脚映射、互补关系和死区，再验证驱动输出及 HB–HS 电压、ADC 标定、启动电流和闭环波形。原 PI 参数尚未经过新板实测整定。

重新用 CubeMX 生成代码后，仍需核对 HRTIM 周期 32000、死区 240、Timer B CMP1 的 EQUAL 模式和 ADC AutoWait 禁用。注入 ADC、触发和中断设置由 `Power_Init()` 配置；中断入口与初始化调用放在 USER CODE 区域。
