meetyaothenstop/vscode/docs/反向共用正向控制测试-20261110.md

# MAIN反向完整采用正向控制：FCTRL1（2026-11-10）

## 修改前备份与本版身份

用户要求先上传当前版本，再将反向控制环路全部替换为正向，并能区分每次备份。
编辑控制源码之前，已推送并核对：

- 分支`codex/main-buck`及修改前标签`pre-reverse-forward-control-20261110`均为
  `d000bfb0218a561984a27f3e56d5e5f3fb1ae33e`。
- 该标签的固件源码与`d023414`相同：旧反向算法、电压PI0.8/10、Boost前馈1倍、99%Vin预充、
  独有HOLD/恢复；mode4欠压7V、默认反向12→18V；用户报告约16V抖动尚未解决。
- 修改前主HEX为`54B96039A64A9CFA48E7ABD7A8A880C63BCA93AA66AE67188BF7F5E18FC23479`，
  AXF为`AD6744977400927DCD830305DA732E193771122A5393DED38A28CA3F5EC0B5EE`。

本版用独立标签`main-reverse-forward-control-20261110`固定，页面标识FCTRL1。
不移动旧标签。完整索引见[版本与备份对照](版本与备份对照.md)，长期规则已写入AGENTS.md。
历史uvprojx共享源码，不能通过打开旧工程文件复现旧控制；回退应独立检出对应标签后重建该目录的主工程。

## 算法与物理适配

|项目|修改前MAIN反向|FCTRL1 MAIN反向|
|---|---|---|
|初始化、控制计算|独立reverse实现|与正向同一份可实例化模板，状态独立|
|电压PI Kp/Ki|0.8/10|0.3/8，与正向相同|
|电流PI Kp/Ki|0.015/20|保持，与正向相同|
|Boost前馈倍率|1|0.2，与正向相同|
|预充完成|99%Vin|90%Vin，与正向相同|
|参考、预充、接管斜坡及积分/滤波|旧反向状态更新顺序|全部使用正向初始化/更新/抗饱和/复位逻辑|
|输出阈值HOLD与恢复|单样本超过目标×1.005关断，满足恢复条件后重置参考/PI|取消MAIN独有调节，连续闭环；独立OVP继续关断锁存|

`forward.c`与MAIN `reverse.c`分别实例化`forward_controller_impl.inc`及原有
`forward_step_impl.inc`，不复制另一套可漂移的数学实现。反向适配为：
右物理电压→控制器输入、左物理电压→控制器输出、物理IL取负、mode3→1/mode4→2。
PWM比较值严格左右镜像；故障记录仍保持物理左/右电压及物理IL。
配置、延迟缓冲、相位、B/X、错误状态及计数器均各自独立。

MAIN `reverse_B/X`现在与`forward_B/X`类型相同：旧`Product3`对应新`Product2`，
预充滤波旧`DiscreteTransferFcn2`对应新`DiscreteTransferFcn1`，电压积分及接管状态使用正向同名字段。
`reverse_U/Y`原物理接口、`power_status`及事件包接口保留；调试必须用配套新AXF，不沿用旧绝对地址。
MAIN旧hold入口仅保留为普通控制步兼容别名，prepare_resume为无动作兼容入口；生产IRQ/worker无调用。
非MAIN旧参考仍显式使用`reverse_legacy_impl.inc`/旧reverse模板，仅供历史通用及受限bench回归，
不能据该参考路径判断当前MAIN算法。

## 保留条件

- 既有主工程`MDK-ARM/bidreaction.uvprojx`，唯一bench仍`bench12_buck_fast.uvprojx`。
- 两个Buck50/10kHz、两个Boost25/5kHz；PWM/ADC/快速保护150kHz，原T1～T7截止保持。
- 反向输入仍右ADC1、输出左ADC1，正向输入仍左ADC2固定4.8us；本次没有改触发、校准或动态避沿。
- mode4输入7～42V试验，其他三模式9～42V；启动严格|IL|<1A/残压≤3V、OVP、7.5A采样过流、方向/ADC/硬件故障门控保持。
- 冷启动30个完整PWM自举及2周期装载保持；Boost换向仍至少3个完整PWM全关断并等待新Boost计划跨预装载边界。
- 默认正向18→3V、反向12→18V保持。首页`MAIN ADC FCTRL1 R7`，反向页面`REVERSE BUCK/BOOST FCTRL1`。

## 验证结果

- RED：旧反向在预充阶段参考不按正向方式前进，与备份正向参考比较失败；旧后端仍进入HOLD，新连续调节测试失败。
- `pwsh -NoProfile -File tests/run_tests.ps1`最终89/89组通过。
- 独立终审未发现Critical/Important问题。审查指出对比测试最初跳过了每条轨迹前两步的反向B/X核对；
  已加强为从第一个样本逐位比较，最后两种速率配置定向重编译通过，计数1440000为完整比较步数。
- 从修改前标签提取独立原正向源码/模板/头文件。在150kHz兼容及多速率配置下，
  mode3/4、公有/受保护入口、随机反馈、预充、切换、饱和、重初始化及兼容别名共1440000步；
  每步核对当前正向、镜像反向与独立参考的全部B/X及输出，逐位一致。
- 状态隔离：不同参数的正反向交错运行、重初始化和模式切换，反向结果与单独运行轨迹逐位一致，
  正向状态不被覆盖；反向非法模式/非有限输入/配置拒绝、错误锁存、mode0关输出及重新初始化恢复通过。
- 全部合法占空比网格的PWM比较值/高侧占空比严格左右镜像；PDM、STOP、挂起worker取消及物理故障快照回归通过。
- 实际原始整数多速率、浮点多速率及单速率后端：目标附近及合成采样尖峰不再进入旧HOLD或复位参考；
  独立OVP、启动复查、过流、方向、ADC与T3/T4/T5/T6/T7等继续验证。
- 原MAIN旧反向HOLD/恢复用例改为连续闭环及正常写入/退出时限验证；原NON-MAIN历史HOLD用例保留。
- 主/bench ARMCLANG6.18全量重建均0错误0警告，bench HEX与备份完全一致。
  主Code52672、RO1320、RW44、ZI6500；CCM12772字节，执行0x10000000、加载0x0800A104。
- 实际HEX/AXF导出一致，CCM复制/向量、反向wrapper及共享core调用、2KiB栈/DMA普通SRAM、
  快速IRQ无浮点/正常路径无事件探针核验通过。编译器将control_write内联到已检查的两个调用者，
  验证脚本按实际存活函数审查；没有为保留审查符号而额外增加快速路径调用。

## 模型结果与必须保留的限制

以下均是名义开关模型，不是实板测量：

- 新反向12→18V最终17.994V、启动峰值18.612V；12→36V最终35.998V。
- 对此前人为+2.2V、每60PWM一个输出ADC尖峰的机制试验，新版0次HOLD，后0.3秒输出平均17.9993V、
  范围17.9921～18.0136V。旧版同一构造平均15.8223V/118次HOLD；构造的尖峰并非用户测得。
- 采用正向算法也继承其启动限制：100Ω名义模型中，反向24→36V、35→36V分别在PWM4328/5241
  触发原7.5A采样过流线，故障IL约−7.5781A/−8.0550A。正向相同工况也在相同PWM触发过流。
  新测试用真实保护后端确认关断锁存，未把旧独立反向模型的安全电流断言简单抬高，也不称这两个工况稳压通过。
- 12→18V新算法的理想模型PWM周期平均输入电流启动峰值约3.86A，高于用户现有0.9A电源限流。
  它不是实板峰值，也不是要求调整电源到某个值；0.9A限流下仍可能出现启动压降，需要板端实测。

目前仅完成用户要求的控制替换。不能据此宣布实板16V抖动根因已确认、已修复，
也不能证明全范围闭环稳定、最坏执行时间或硬件OCP接线就绪。用户负责下载；助手未操作板子。

## 交付映像

```text
主HEX：MDK-ARM/bidreaction/bidreaction.hex
SHA256：8335E0910AECE02CA2D87E3F88C80C4CA665CDF798BE3172CDD0171EAA39390F
配套AXF：MDK-ARM/bidreaction/bidreaction.axf
SHA256：C0CBC8C4D726A072A1DC63CB7E70053F16B20978B98B2AF8035055DD9046352B
bench HEX SHA256：A9BA257BA3FFBB49C8FAED9803E3462671F692A9B4D063C9975512D09EF6D451
```

上传使用同仓库HTTPS及既有凭据/本机代理，保留SSH origin，不强推。版本源码与标签完成后须核对远端SHA。
