meetyaothenstop/vscode/docs/反向Boost欠压7V测试-20261109.md

# 反向Boost欠压7V试验（2026-11-09）

用户确认右侧12V输入、电源限流0.9A、100Ω负载、目标18V，报错2/IN8.99V；
明确要求降低欠压到7V试验。本轮只调整当前测试的MAIN反向Boost(mode4)，
输入窗7～42V；正向Buck/Boost与反向Buck仍9～42V，唯一受限bench保持。

配置：`Core/Inc/power_build_config.h`中
`POWER_MAIN_REVERSE_BOOST_INPUT_MIN_VOLTS=7.0f`。
`MODE_INPUT_MIN_VOLTS(mode)`同时用于请求校验和`active_limits`缓存，
准备、自举、装载、预充、换向、运行及HOLD/恢复均沿用该缓存的实际输入保护。
没有给欠压增加延时或屏蔽，仍按每个150kHz新样本立即判断。

反向ADC1右侧输入/左侧输出、两Boost25/5kHz计算、Buck50/10kHz、
PWM/ADC/快速保护150kHz、连续PI、启动严格|IL|<1A、输出残压≤3V、
OVP及42V输入上限、采样过流7.5A与方向保护保持。
保留用户默认：正向18→3V、反向12→18V。
首页`MAIN ADC B25/5 R7`，反向Boost页`REVERSE BOOST R25V7`。

## 验证

- RED：新增7.1V反向Boost应可请求，原9V策略拒绝，测试按预期失败。
- 完整回归命令：`pwsh -NoProfile -File tests/run_tests.ps1`，86/86组通过。
- mode4的7.1V和现场8.99V：请求及独立准备/自举/装载/运行阶段接受。
  6.9V及7V两侧相邻ADC码验证请求/各阶段输入保护；其他三个模式仍在8.9V关断，9.1V接受。
- 两Boost各5个后台计算间隔PWM中的欠压/过流仍检查，mode4欠压注入改6.9V；
  42V上限、冷启动电流/残压、OVP、电流方向、控制频率与旧源状态对比继续回归。
- 主/bench ARMCLANG6.18全量重建均0错误0警告；主Code53012、RO1312、RW44、ZI6508。
  CCM12588字节，执行0x10000000、加载0x0800A308。
- 实际HEX与AXF导出、CCM复制/向量/栈/DMA/Boost调用路径、整数快速IRQ、正常路径无事件探针及正向Boost指令检查通过；bench HEX保持。
- 独立只读审查未发现Critical/Important/Minor阻塞项；审查者独立核验实际映像与指纹通过，完整86组最终结果由主执行者核对。

```text
主HEX：MDK-ARM/bidreaction/bidreaction.hex
SHA256：54B96039A64A9CFA48E7ABD7A8A880C63BCA93AA66AE67188BF7F5E18FC23479
配套AXF：MDK-ARM/bidreaction/bidreaction.axf
SHA256：AD6744977400927DCD830305DA732E193771122A5393DED38A28CA3F5EC0B5EE
bench HEX SHA256：A9BA257BA3FFBB49C8FAED9803E3462671F692A9B4D063C9975512D09EF6D451
```

修改前以`e197a1172163f33b543c5f7480bd564d1143c527`保存用户12→18V默认，
标签`pre-reverse-boost-uv7-20261109`已在编辑前上传并核对远端。
版本标签`main-reverse-boost-uv7-20261109`；上传使用同仓库HTTPS及既有凭据，保留SSH origin。

## 试验边界

若负载确为100Ω，18V稳态需要3.24W，12V/90%效率估算输入0.30A，
不能沿用此前36V/100Ω时0.9A不足以维持稳态的结论。
目前只确认9V版本采到了8.99V，尚无电源CC/板端瞬态波形或同步ADC证据，
未区分真实压降与采样干扰。7V是用户要求的软件门限试验，不证明这些物理原因已解决，
也不证明7V输入下的驱动供电或实板运行就绪。
下载由用户操作；本轮未下载、复位或控制板子，硬件OCP接线与实板最坏时序仍未验证。
