meetyaothenstop/vscode/docs/反向Boost对齐测试-20261109.md

# 反向 Boost 门限与25/5kHz对齐（2026-11-09）

用户要求准备反向输入，将检查对齐正向Boost，并明确补充控制频率。
继续使用主工程`MDK-ARM/bidreaction.uvprojx`，不新建工程；下载由用户操作。

## 修改范围

|项目|MAIN反向Boost现在|修改前|
|---|---|---|
|实测输入窗口|9～42V|6～40V|
|冷启动电流|严格\|IL\|<1A|<0.25A|
|冷启动左输出残压|≤3V|≤0.25V|
|左输出过压|min(max(最终目标×1.5,6V),40V)|目标×1.1|
|电流/电压计算|25/5kHz，40/200us|50/10kHz，20/100us|
|后台请求/T7截止|每6个PWM/40us，超期仍关断|每3个PWM/20us|

四模式统一引用既有`POWER_MAIN_BUCK_*`门限组，名称保留以减少无关改动。
Boost目标仍须高于实测输入，范围1～36V，0V目标仍拒绝；Buck0.95可达性保持。
输入窗口上限42V不表示能在42V输入、36V目标下升压启动。

反向仍以ADC1右电压为输入、ADC1左电压为输出，IL正常为负；不改为左侧ADC2。
ADC2固定4.8us仍只供正向两模式输入。电流参考6A、采样绝对过流7.5A、
反向异常正电流>1A连续16样本、HOLD恢复|IL|<0.25A及其他保护保持。
启动1A是互锁，不是运行电流设定或电源限流值。

生产mode4 worker使用`reverse_main_boost_step/hold_step`，复用`boost_control_rates.h`。
积分步长40/200us、6238rad/s滤波按新周期；反向连续电压PI0.8/10、电流PI0.015/20保持。
反向参考在CTRL_RUN前保持、120V/s参考斜坡、500A/s预充、100/s接管保持原逻辑。
公共`reverse_step/hold_step`仍为50/10kHz兼容入口（单速率配置150kHz），不用于生产mode4。
PWM/ADC/快速软件保护150kHz；两个Buck50/10kHz；原正向Boost25/5kHz保持。
换向仍至少3个完整PWM全关断，并等待新Boost计划生效，不保证固定20us交接。

保留用户当前默认：正向18→3V，反向12→6V。后者默认选择反向Buck，
测试反向Boost时在菜单选择reverse并设置输入12V、输出24V等有效升压目标；
这里是菜单设置说明，不是实板运行已验证的结论。
首页`MAIN ADC B25/5 R1`，反向Boost页`REVERSE BOOST R25V9`，正向Boost页仍B25A2。

## 验证记录

- RED：原版mode4在第3个PWM重复计算，新的6PWM断言失败；原版8.9V不触发9V欠压断言。修改后两项通过。
- `pwsh -NoProfile -File tests/run_tests.ps1`：86/86组通过。
- 反向原始整数/浮点单速率/浮点多速率真实后端：9V相邻ADC码及准备、自举、装载、运行检查；9～42V、严格1A/3V、左侧OVP相邻码；错误方向16样本和绝对过流关断。
- 四模式实际worker节拍、两Boost的T7及5个间隔PWM中的欠压/过流保护通过；反向预充换向全关断及25/5kHz下HOLD、30周期自举、2周期装载恢复通过。
- 以备份标签70e5a84的独立旧源编译参考，分别按150kHz兼容和25/5kHz重采样；两速率共720000步完整B/X/Y逐位一致，含预充、切换、随机输入、HOLD/恢复、重新初始化和非法模式拒绝。随机工况先完成可行的预充斜坡，避免35→36V案例在150kHz旧滤波尚未锁存时被随机信号打断。
- 四模式名义开关模型通过：反向12→24V最终23.988V、峰值24.082V，90000PWM中控制14995步/电压3000步；这不模拟电源限流、传感器噪声或实板最坏执行时间。
- 主/唯一bench ARMCLANG6.18全量重建均0错误0警告。初次沙箱构建无法读用户设备包，使用可访问既有安装包的本机构建；未安装新包或改变IDE项目。
- 主Code52996、RO1312、RW44、ZI6508；CCM12588字节，执行0x10000000、加载0x0800A2F8。实际HEX/AXF导出一致、CCM复制/向量/两个Boost调用入口/2KiB栈/DMA普通SRAM/快速路径无浮点/正常路径无事件探针核验通过。
- 链接脚本用`reverse*hold_step`匹配实际存活的HOLD入口，兼容公共函数被裁剪的情况，最终无未使用节区匹配警告。
- 独立只读代码审查无Critical/Important或需修正Minor；审查者独立重跑四项实际映像检查并核对主/bench指纹通过。实板稳定性、执行截止时间、电气切换与硬件OCP不在主机审查可证明的范围内。

## 交付与追溯

修改前保存用户默认的提交`70e5a84bc5985e07807d93a4f12037151043b89b`，
标签`pre-reverse-boost-align-20261109`已在编辑前上传并核对远端SHA。
版本标签`main-reverse-boost-align-20261109`；本轮使用同仓库HTTPS及既有凭据、
OpenSSL TLS后端和本机代理，保留SSH origin，没有关闭主机验证。

```text
主HEX：MDK-ARM/bidreaction/bidreaction.hex
SHA256：93990C58277572D5109B2E6035DA3866BF8B1AE747F5380C69A9436F31C90CE6
配套AXF：MDK-ARM/bidreaction/bidreaction.axf
SHA256：38455D55B8B94E58319F20DED870A86015CB28A5B00491B0737F7EB58BCA5B19
bench HEX SHA256：A9BA257BA3FFBB49C8FAED9803E3462671F692A9B4D063C9975512D09EF6D451（保持）
```

用户使用主工程HEX和配套AXF下载/观察，不沿用旧绝对RAM地址。
本轮未操作板子；实板反向Boost的时序、电气行为、旧故障根因和硬件OCP接线仍未验证。
