meetyaothenstop/vscode/docs/对话接续摘要-2026-11-08.md

<!-- HANDOFF-2026-11-08-BEGIN -->
# 最新对话交接摘要：Boost输入统一ADC2、欠压9V，当前待查128 S7（2026-11-08）

> 下个对话优先读本节。它取代下方历史记录中关于“当前固件、控制频率、输入采样和下一步”的旧说法，旧记录继续保留以便追溯。本节记录历史事实、既有工作约定和待查问题，不是新的下载、复位、调试连接或功率运行授权。执行仍以用户当前请求及项目AGENTS.md为准。本次用户要求整理交接，不继续修改固件或操作板子。

## 1. 一分钟接手

1. **最后由助手完成验证并上传的固件源码为`b46861103352e4a99642dbecf53b7616af6bc335`，标签`main-uv9-20261108`。** MAIN共用欠压门限已从10V降至9V；正向Buck/Boost输入电压都采用ADC2固定延后采样；正向Boost控制计算25/5kHz，其他三模式50/10kHz；PWM、ADC与快速软件保护仍150kHz。
2. 用户最新反馈：**12V升24V正常；12V升36V时，在刚启动或预充转Boost期间报输入欠压`2 IN8.99V`。** 负载100Ω，12V电源限流当时0.7A。随后用户把限流提高到0.9A，最新报错改为**128 S7**。
3. **0.7A和0.9A都不足以维持36V/100Ω稳态。** 36V/100Ω需要12.96W；12V输入即使无损耗也需1.08A，按90%效率估算约1.20A，启动充电另需余量。限流引起板端输入下降是欠压的首要排查方向，但用户尚未确认CC指示或板端瞬态波形，不能宣称物理根因已被测量证实。
4. **128 S7不是电流门限。** 它是启动模式/目标与实际输入电压关系不满足：Boost要求目标>实测输入；Buck要求目标<实测输入，MAIN Buck还要求目标≤实测输入×0.95。若确实是正向Boost、目标36V、实测输入12V，按当前源码不应因该关系拒绝，必须核对实际请求参数、采样和固件。
5. **当前工作区有用户后续修改，不能当作已验证版本。** 本次整理读取到MAIN默认为正向18V→36V、反向12V→6V；相对b468611的正向12V→24V默认尚未提交。不要擅自覆盖。磁盘HEX/AXF指纹也已不同于助手最后交付版本，见第3节；本次没有重建或验证这些后续生成物，更未确认板上Flash是哪一版。
6. **采样尚未动态避开开关沿。** ADC2固定在每PWM周期约4.8μs触发；这只能统一输入来源，不能保证全占空比无开关干扰。用户明确关注此点，不能向其声称“已经动态避沿”。
7. 最后已验证版本为81组完整主机回归通过，主/唯一bench ARM6.18构建0错误0警告，实际映像/CCM/快速整数指令/AXF导出及独立只读审查通过。**这不证明实板最坏时序、所有工况电气行为或硬件OCP就绪。** 用户反馈反向Buck已能从36V降至6V；正向Boost24V正常，但没有完整负载/时长/波形验证记录。

## 2. 路径、授权和Git

```text
工作目录：C:\Users\k\Desktop\keil\hal\bidreaction
最初文档：C:\Users\k\Desktop\codex\双向buckboost.md
本摘要版本化副本：docs\对话接续摘要-2026-11-08.md
主工程：MDK-ARM\bidreaction.uvprojx；Target：bidreaction
主HEX：MDK-ARM\bidreaction\bidreaction.hex
配套AXF：MDK-ARM\bidreaction\bidreaction.axf
唯一受限bench：MDK-ARM\bench12_buck_fast.uvprojx
分支：codex/main-buck
origin：git@github.com:meetyaothenstop/vscode.git
```

- 保留同一主工程及四模式，不因每次调试新建工程；历史工程共享源码，重现旧版要使用Git提交/标签。
- **用户操作固件下载。助手只准备、构建、验证和交付；没有再次明确授权，不控制板子下载、复位或恢复功率运行。** 本轮后半段未操作板子。
- 用户明确要求大改前把原版上传GitHub。AGENTS.md长期约定：重大固件重构前打标签、推送并核对远端SHA；每次完成并验证的版本提交、推送分支及标签并核对，不需重复请求上传授权，不强推。
- SSH认证先前不可用；本轮实际通过同仓库HTTPS及既有凭据上传，使用本机代理`http.proxy=socks5h://127.0.0.1:10808`，保留SSH origin，未关闭主机校验。网络或认证失败应保留本地提交并明确说明上传待完成。
- 本次整理前再次只读核对远端：分支`codex/main-buck`与`main-uv9-20261108^{}`均指向b468611。后续仅文档提交会推进HEAD，不能据此认为固件已改变。
- 主工程保持用户授权的ADC软件保护测试，硬件OCP接线/就绪性未验证。`protection_ready=0`不能靠强行改1伪装为通过；旧截图中`power_diag.fault`不可求值与统一诊断关闭有关，活动记录主要为`power_status`和`power_event.fault`。
- 保留且不混入文档/固件提交的原有IDE改动：`MDK-ARM/bench12_buck_fast.uvoptx`、`MDK-ARM/bench12_buck_fast.uvprojx`、`MDK-ARM/bidreaction.uvoptx`。bench工程存在Flash首选项差异，不能据此声称编译策略改变。
- 其他已有scratch/生成目录：`.superpowers/live-oled/review-package.md`、`.superpowers/voltage-sense-explanation/`、`MDK-ARM/bench12_buck_fast/`、`tests/main_forward_full_suite.log`。本次还有后续用户默认配置改动，**不要声称工作区干净，不要reset/clean覆盖。** 不提交可重建HEX/AXF/OBJ或IDE界面状态。

## 3. 必须区分：已验证源码、当前工作区、磁盘二进制、板上固件

### 最后由助手验证并交付的版本

```text
源码：b46861103352e4a99642dbecf53b7616af6bc335
标签：main-uv9-20261108
修改前备份：pre-main-uv9-20261108 -> 4a3b4bd18d06575e9dc22829548c4fa933bb716f
当时MAIN默认：正向12V→24V，反向12V→6V
MAIN HEX SHA256：96CDC014A36699EF721FAFF97398E8ECA5BEA6910E376F3F5E238CCB614973BD
MAIN AXF SHA256：411607C8DD2E73F1B361AD294CCDDC7B1731C52CB57DDC1A93041BAE2B91FC8A
bench HEX SHA256：A9BA257BA3FFBB49C8FAED9803E3462671F692A9B4D063C9975512D09EF6D451
```

### 本次整理时只读观察到的工作区

`Core/Inc/power_build_config.h`的MAIN默认已由用户后续调整为：

```c
#define POWER_FORWARD_DEFAULT_INPUT_VOLTS  18U
#define POWER_FORWARD_DEFAULT_OUTPUT_VOLTS 36U
#define POWER_REVERSE_DEFAULT_INPUT_VOLTS  12U
#define POWER_REVERSE_DEFAULT_OUTPUT_VOLTS  6U
```

这些默认值集中于`Power-on menu defaults`段，约第122～125行；欠压宏在约第149行。**下次先重新读取当前文件，行号和值可能继续由用户改变。** 菜单默认与调试邮箱共用宏；菜单输入设定只用于比较输入/输出以选择Buck/Boost，实际输入反馈仍来自ADC，不会被设定值覆盖。菜单目标与调试邮箱`power_target_volts`是不同入口，不能把后者一概当成按键菜单实际请求目标。

本次整理读取到磁盘生成物已变化：

```text
本地MAIN HEX SHA256：EA9A01B23EC8767649E77314D8E38128A33349330090C80B4D6BA0D103142263
本地MAIN AXF SHA256：FB93C81F73A4A905DDD95EA0380F592F2E46B17CE9824A19BB52A2940AC3E852
bench HEX SHA256：A9BA257BA3FFBB49C8FAED9803E3462671F692A9B4D063C9975512D09EF6D451
```

这里只记录文件现状，不宣称其生成来源、完整验证或与板上Flash一致。下次不要把上述本地新指纹套用到b468611的验证结果。调试应使用实际下载固件配套AXF，禁止沿用历史固定RAM地址解释新构建。

## 4. 本轮实现顺序与版本记录

|源码提交|实现与结果|
|---|---|
|f1beaaf|将正反向默认输入/输出统一放到power_build_config.h；当时71组通过，主/bench HEX与基线一致，代码整理没有改变时序行为。|
|3ad070f|保存用户当时选择的正向12→18V默认，反向12→6V。默认后来又由用户调整，不能当成当前文件值。|
|7c985e9|MAIN正向Boost冷启动电流检查由0.25A改为严格小于1A；73组通过。|
|307bcdd|用户明确批准把正向Boost全部电气/启动门限对齐Buck：当时10～42V、启动<1A、残压≤3V、过压min(max(目标×1.5,6V),40V)。75组通过；反向Boost保持独立策略。|
|8564652|Boost后台OPT1：共享模板生成受保护mode2专用入口，保留全部B/X/Y状态更新，去掉未使用Buck除法；77组及两速率共72万步独立旧源完整状态逐位对比通过。**用户重新编译下载后仍报64 T7，故未证明修复。**|
|802b9ad|用户明确批准仅正向Boost计算降至25/5kHz，连续PI保持并重算积分/滤波；其他模式50/10kHz，快速150kHz保持。78组通过。|
|4a3b4bd|用户要求正向两模式输入采样统一，Boost改用Buck已有ADC2固定4.8μs输入样本；启动/有效性/运行/worker全部同步。81组通过，标识B25A2。|
|b468611|用户要求欠压降至9V，MAIN共享门限9～42V；保留工作区当时已有12→24V默认。81组及审查后定向边界测试、主/bench构建和实际镜像核验通过。最后已验证并上传版本。|

关键备份标签均已在编辑前推送核对：`pre-boost-t7-opt-20261107`→307bcdd、`pre-forward-boost-25k-20261108`→8564652、`pre-forward-input-adc2-20261108`→802b9ad、`pre-main-uv9-20261108`→4a3b4bd。

详细持久记录：

- `docs/默认电压配置整理-20261107.md`
- `docs/正向Boost启动1A-20261107.md`
- `docs/正向Boost门限对齐Buck-20261107.md`
- `docs/正向Boost运行精简测试-20261108.md`
- `docs/正向Boost25k5k测试-20261108.md`
- `docs/正向输入统一ADC2测试-20261108.md`
- `docs/主工程欠压9V测试-20261108.md`

历史测试文档中的10V门限描述反映各自当时版本，当前共享欠压以9V宏为准。测试临时日志保存在Git忽略的`.superpowers/boost-t7-opt/`与`.superpowers/forward-input-adc2/`，持久结论以docs、tests和Git版本为准。

## 5. 当前控制频率、软启动与T7

|项目|正向Boost mode2|正向Buck与两个反向模式|
|---|---|---|
|PWM/ADC/快速软件保护|150kHz，6.667μs|150kHz，6.667μs|
|电流控制计算|25kHz，40μs，每6个PWM请求一次|50kHz，20μs，每3个PWM请求一次|
|电压控制计算|5kHz，200μs，每5次电流更新一次|10kHz，100μs，每5次电流更新一次|
|T7请求截止窗口|40μs，超期仍关断|20μs，超期仍关断|

CPU/HCLK150MHz，每PWM周期约1000个CPU时钟。HRTIM快速IRQ优先级0、PendSV控制worker优先级15，OLED DMA/I2C优先级3。快速路径正常执行仍保持整数，不把全部PI塞回快速IRQ。
新Boost系数在`Core/Inc/boost_control_rates.h`，仅生产mode2专用入口使用；公开forward_step兼容入口仍按control_rates.h工作，不能据forward_sampleTime的公共值误判真实worker节拍。模式改变先重新初始化。
连续电压PI 0.3/8、电流PI 0.015/20保持；6238rad/s低通按40/200μs重算。电压斜坡120V/s、预充电流斜坡500A/s、接管斜坡100/s保持。Boost启动参考配置以实测Vin为起点，Buck为0.1V；菜单默认输入不是强制ADC输入。

用户曾询问约0.8ms的转Boost电流震荡。当前保留预充/锁存/接管平滑和保护，**没有新增固定0.8ms保护屏蔽**。多速率Boost换向至少3个完整PWM全关断，并等待新的Boost plan跨越预装载边界后重新开通；新25kHz下一步逻辑延迟为40μs，不能把全部实际交接时间仍说成固定20μs。100/s接管斜坡名义约10ms，不是实板电流已无震荡的保证。

旧T7有效截图（50/10kHz版本、正向Boost12→18V）要点：

- 首包code64/detail7、mode2、state3 RUNNING，目标/参考18V；输入12.010574V、输出18.01618V、IL约0.618118A。
- request到检查elapsed=0xD3C=3388CPU周期，约22.587μs；spacing0x3E8=1000；counter0x34C0=13504。
- 完成请求峰值0xBA9=2985周期≈19.9μs；正常快速处理段峰值0x2CA=714周期≈4.76μs；启动等待峰值835周期；worker墙钟峰值2184周期。
- 这些是不同样本的独立峰值，不能相加/相减当成纯PI时间或平均CPU利用率；请求elapsed包含等待、抢占及检查开销，旧isr峰值也可能含故障冷处理。
- 专用Boost函数1460字节/1条VDIV，原完整入口1612字节/2条VDIV；静态体积不能证明实板节约了多少周期。用户确认OPT1下载后仍T7，随后才批准25/5kHz。

目前用户主要反馈欠压/S7，**降频后的T7是否彻底消失没有独立确认**。

## 6. ADC来源与开关沿问题

- ADC1每周期约1.667μs触发注入序列：第1通道电流PA2、第2通道左侧电压PA0、第3通道右侧电压PA1。各通道不是同一时刻采样，序列触发点不等于输入电压采样完成点。
- ADC2读同一PA0输入，Timer A CMP4=`POWER_INPUT_ADC_PHASE_TICKS=23040U`，固定每周期约4.8μs触发。实际还要考虑触发延迟、采样保持时间和转换时间。
- 以前正向Buck用ADC2、正向Boost用ADC1第2通道。助手在真实后端合成ADC1=9.9V、ADC2=12V，得到Buck不报/Boost报2；反过来则相反。这验证数据选择机制，不证明实板读差的物理原因。
- 用户要求统一后，**正向Buck/Boost的请求、样本有效性、冷启动、自举/装载/预充/换向/运行保护及worker输入均采用ADC2**。ADC2缺EOC/EOS或有OVR时拒绝启动/ADC故障关断，不回退ADC1。电流/右侧输出仍ADC1；反向左侧输出仍ADC1第2通道。
- 固定相位尚未动态跟随MOS边沿。现有Boost映射右桥CMP1=round(0.85×(1-d)×32000)+960；d=0.18时为23264ticks≈4.846667μs，距离4.8μs触发仅46.7ns，可贴近边沿。因此**不能宣称当前全工况已避沿或采样噪声已消除**。动态选窗尚未实现，不能当作已完成工作。
- 标识：首页`MAIN ADC B25/5 A2`、正向Boost页`FORWARD BOOST B25A2`。欠压9V版本沿用该页面标识，不能只凭标识区分A2原10V版与UV9版。

## 7. 当前故障含义与电气门限

故障为位掩码，0x40=十进制64；首包与后续OR入的fault可能不同，要优先核对首故障。

|故障|当前解释|
|---|---|
|1|ADC有效性：ADC1缺JEOS/JQOVF，正向两模式还要求有效ADC2。事件adc_reason掩码1=缺JEOS、2=JQOVF、4=晚相位ADC2无效。|
|2|输入不满足。MAIN正向Buck/Boost、反向Buck输入窗9～42V；MAIN Buck还含目标≤实际输入×0.95条件。因此不能说只有低于9V才会报2。|
|4|输出过压。MAIN mode1/2/3为min(max(最终目标×1.5,6V),40V)；6V目标线9V，36V目标线40V。|
|8|采样过流/电流ADC近轨；MAIN采样绝对过流线7.5A。|
|16|电流方向保护；正向IL<−1A立即触发，反向IL>+1A连续16个150kHz样本。|
|32|控制器异常。|
|64 T7|后台请求到下一次请求时仍未完成/发布，关断；不是只量纯PI计算。其他T编号仍按源码。|
|128 S7|启动模式/目标与实际输入关系不满足，见第9节。|
|128 S8|冷启动准备/自举/装载复查时电流绝对值未低于启动门限；MAIN共享为严格<1A。请求入口的电流拒绝编号为S5，别混用。|
|128 S9|同阶段输出残压超过启动门限；MAIN共享≤3V，反向Boost仍≤0.25V。|

MAIN正向Buck/Boost与反向Buck共用：9～42V输入、启动|IL|<1A、输出残压≤3V、目标上限36V；正向/反向Buck仍有0.95可达性条件；Boost仍须目标高于实测输入，0V Boost目标无效。反向Boost保持输入6～40V、启动<0.25A/残压≤0.25V、OVP目标×1.1。
**1A是启动互锁，不是运行恒流设定，也不是台式电源CC设置。** MAIN电流参考上限6A、采样过流7.5A保持，未因用户电源限流0.7/0.9A而同步改动。

## 8. 最近欠压现场与功率预算

用户明确给出的信息：

- 正向12V升24V现在正常。
- 升36V时仍报2、显示输入8.99V，发生在刚启动或预充转Boost时。
- 负载100Ω，12V电源限流0.7A；以前用户报告电源/电表12V，未提供板端瞬态波形。
- 提高限流至0.9A后出现128 S7。尚未确认CC指示是否亮过，也没有这次S7的可靠入参/采样首包。

|100Ω负载|输出电流|负载功率|12V输入理想电流|按90%效率估算|
|---|---|---|---|---|
|24V|0.24A|5.76W|0.48A|约0.533A|
|36V|0.36A|12.96W|1.08A|约1.20A|

0.7A输入上限对应8.4W，0.9A对应10.8W，均小于36V负载所需12.96W，尚未计损耗和输出电容充电。因此提高至0.9A仍未解决稳态功率不足。输出由24到36V，在同电阻下功率/近似输入电流增加2.25倍；欠压门限本身没有随目标升高。
助手此前建议在板子/电源额定允许时先以约1.5A限流复测，观察CC与板端输入，并保留9V欠压线；**用户仅确认调到0.9A，不能记成已试1.5A或已证实限流是唯一原因**。也不能把该建议当作下个助手擅自操作电源的授权。

8.99V是输入故障锁存的ADC换算值。当前左侧约0.0175337V/count，raw513约8.99478V，低于9V；raw514约9.01231V。OLED两位小数显示8.99与刚越过门限相符，不能凭数值本身证明真实压降或ADC误报。
参考计算来源：[TI Boost输入/输出电流与效率说明](https://www.ti.com/document-viewer/lit/html/slvafc4)、[TI功率级计算](https://www.ti.com/lit/an/slva372d/slva372d.pdf)。90%仅为估算例子，不是本板实测效率。

## 9. 最新128 S7：下一对话优先处理

用户最新问题：“提高到0.9安会报错128 s7”。助手已只读查到源码条件，但该回答被用户中断，随后用户要求先总结。**未完成S7根因诊断，未为此改代码或操作板子。**

`Core/Src/power_control.c`的Power_RequestStart，约第600行：

```c
else if ((boost && vin >= target_volts) ||
         (!boost && vin <= target_volts)) rejection = 7U;
else if ((mode == 1U || mode == 3U) &&
         target_volts > vin * POWER_MAIN_BUCK_MAX_DUTY) rejection = 7U;
```

- mode1=正向Buck，mode2=正向Boost，mode3=反向Buck，mode4=反向Boost。
- 菜单比较**设定**input/output来选Buck/Boost，实际保护vin来自ADC；要核对OLED顶部模式、菜单输入/输出值、实际接线及电源电压。
- 当前工作区18→36会选择Boost；若实际输入仍12V、目标确实36V，单凭这些数值不应触发S7。需要查实际调用Power_RequestStart的mode、target_volts和vin，不能直接把S7解释成0.9A电流太低。
- **启动拒绝首包的事件mode/target可能是上一次配置。** event_capture使用active_mode/active_target，而这两个变量在请求全部校验通过后才更新。S7是在此之前拒绝，不能只根据power_event.fault.mode/target_volts认定当前被拒绝的请求是什么。
- RAW拒绝路径通过request_sample锁存当次电压/电流，可先看power_status.fault_v_left/right、fault_raw_vh/vl/il、fault_detail；同时由菜单/实际入参确认请求目标。不要只看停机后仍更新的实时v_left/v_right，也不要把调试邮箱目标直接当菜单目标。
- 先明确板上实际固件与配套AXF，当前磁盘二进制已不同于最后助手验证版本；如用户需要重新构建，先保护其未提交18→36默认改动，不要擅自回退12→24。

建议接续顺序：先解释S7含义并核对真实模式/目标/请求电压；将电源功率不足与S7启动关系拒绝分开处理；再由用户按额定条件提供CC/板端输入和故障首包。不要继续盲目降低欠压线或据此放宽S7。若之后要做新的固件大改，先按AGENTS.md备份上传原版，再实现并验证。

## 10. 验证范围与本次整理边界

最后助手交付b468611：81组完整主机用例通过，审查后边界/启动阶段用例定向重编译通过；ARMCLANG6.18主/bench均0错误0警告。主Code51552、RO1312、RW44、ZI6508；CCM11168字节，执行0x10000000、加载0x0800A2E0；主栈2KiB。AXF导出HEX一致、实际CCM复制/向量/DMA/SRAM和正常快速函数无FP指令检查通过，bench HEX保持。
名义开关模型12→24V约24.007V、峰值24.843V；12→18V约17.994V、峰值18.611V。这些模型输入稳定，不模拟供电限流/板端压降/开关噪声，也不证明12→36V实板可在0.7/0.9A限流下工作。

本次只整理摘要并保留原文：未修改固件、未重建当前用户变更后的二进制、未下载、未复位、未更改电源。下方2026-11-04摘要及更早全文是历史资料，其“当前版本/频率/阻塞”等措辞不再代表本节最新状态。
<!-- HANDOFF-2026-11-08-END -->
