meetyaothenstop/vscode/docs/主工程欠压9V测试-20261108.md

# MAIN欠压门限9V

用户要求将欠压保护降低到9V。修改前4a3b4bd18d06575e9dc22829548c4fa933bb716f已用pre-main-uv9-20261108上传并核对远端SHA。版本标签main-uv9-20261108。

生产配置：Core/Inc/power_build_config.h，POWER_MAIN_BUCK_INPUT_MIN_VOLTS由10.0f改9.0f。现有共享策略适用于mode1正向Buck、mode2正向Boost、mode3反向Buck，启动请求及缓存后的启动/运行保护共用，输入上限仍42V。
mode4反向Boost仍6～40V。受限bench原策略保持：12V FAST编译配置10～14V，当前24V bench配置20～28V；bench HEX保持一致。
Buck目标与实际输入的0.95占空比约束保持，故故障2仍可能由Buck目标不可达或输入过高触发，不能把所有故障2都解释为低于9V。

工作区并行出现正向默认输出18U→24U的设置，已向用户说明保留。当前默认正向12→24V、反向12→6V，菜单及调试邮箱共用宏。本版将实际构建采用的默认值一并保存，不覆盖为旧18V。
正向输入仍ADC2固定4.8us触发；电流/输出及反向原ADC1采样、PWM/ADC/快速保护150kHz、Boost25/5kHz及其他模式50/10kHz、PI与其他保护保持。固定相位仍未动态避开开关沿。

验证：

- RED：先将9.1V Boost请求改为应接受，在原10V配置上被detail4拒绝；将生产门限改9V后通过。
- 81组完整主机回归通过。新增在既有raw/float真实后端门限用例中覆盖三个共享模式：9.9V启动、9.1V通过/8.9V关断，以及9V两侧相邻ADC码的启动与运行保护。审查后分别重新启动，在待启动、自举、装载及运行各阶段独立注入9.1V/8.9V，防止测试阶段偏移；定向两种后端重新编译通过。
- 旧10V边界测试同步为9V。采样源差异用例的低值改8.9V，以继续验证错误选用ADC1会故障；快速中断中间周期欠压保护、反向恢复、12位全部原始码枚举与只读审查通过。
- 审查指出的两条旧PASS文案已同步，相关limits与MAIN用例按最终测试源码定向重编译通过。IDE的uvprojx/uvoptx变化排除提交。
- 主/bench ARMCLANG6.18全量重建均0错误0警告。主Code51552、RO1312、RW44、ZI6508，CCM11168字节，加载0x0800A2E0。实际HEX的CCM复制/向量/DMA/普通SRAM缓冲和2KiB栈通过；AXF导出HEX一致，检查的正常快速函数无浮点指令。

主HEX：MDK-ARM/bidreaction/bidreaction.hex，SHA256 96CDC014A36699EF721FAFF97398E8ECA5BEA6910E376F3F5E238CCB614973BD。
配套AXF：MDK-ARM/bidreaction/bidreaction.axf，SHA256 411607C8DD2E73F1B361AD294CCDDC7B1731C52CB57DDC1A93041BAE2B91FC8A。
bench HEX仍A9BA257BA3FFBB49C8FAED9803E3462671F692A9B4D063C9975512D09EF6D451。

用户自行下载，助手未操作板子。9V门限按ADC换算值判断，量化边界用原始码测试；主机及镜像验证不证明实板欠压为误报、T7已消除或硬件OCP就绪。硬件OCP接线未确认，保持用户授权ADC软件保护测试。
