meetyaothenstop/vscode/docs/正向输入统一ADC2测试-20261108.md

# 正向Buck/Boost统一输入电压采样

用户要求直接将两种正向模式的输入采样统一为Buck现有方案。修改前802b9ad4854043d732814b7a9e49ed26a9a86e3d已用pre-forward-input-adc2-20261108推送并核对远端提交，随后才修改生产代码。本版标签main-forward-input-adc2-20261108。
继续MDK-ARM/bidreaction.uvprojx、Target bidreaction，唯一bench参考保持。用户自行下载，助手未操作板子。

MAIN正向Buck/Boost请求及运行均采用ADC2通道1/PA0输入电压：HRTIM Timer A CMP4固定23040 ticks，即PWM周期起点后4.8us触发。配置位置Core/Inc/power_build_config.h的POWER_INPUT_ADC_PHASE_TICKS。
Power_RequestStart的raw/float快照与有效性、Power_TimerIRQ的选源与有效性共享main_uses_late_input(mode1/mode2)。自举/装载/预充/换向/运行保护和后台使用选中的同一份输入；无效ADC2不回退ADC1，按原规则拒绝启动或ADC故障关断。STOP/清故障后仍要求新样本。
ADC1通道3电流及通道2右侧电压的原注入采样保持；反向左侧是输出，继续采用ADC1第2通道，未使用的ADC2持续排空。
主工程150kHz PWM/ADC/快速保护、正向Boost25/5kHz及其他模式50/10kHz、PI、10～42V输入窗、1A/3V启动与全部其他电气/时序保护保持。硬件OCP接线与就绪性未确认，继续用户授权ADC软件保护测试。

用户进一步追问是否避开上下开关沿。当前是固定相位，未随占空比动态选窗。按现有映射，Boost d=0.18时，右桥CMP1=round(0.85×(1-0.18)×32000)+960=23264 ticks，即4.846667us，距离4.8us触发仅约46.7ns；可能靠近开关沿。
4.8us是触发时刻，实际采样还需加触发延迟，并占用采样窗口；死区和驱动延迟也会影响实际MOS边沿。当前修改不能保证全占空比避沿或消除噪声。用户旧图d≈0.414时映射CMP1为3.52us、左桥5.8667us，仅为配置计算，不是实测波形，也不能推及整个启动过程。

验证：

- RED：新真实后端用ADC1=9.9V、ADC2=12V发起Boost，在原版出现128/detail4，未按新契约接受；改后通过。
- 81组完整主机用例全部通过。新增三种profile：实际raw多速率、float非多速率及float多速率；独立两路输入覆盖请求/有效性、待启动/自举/装载/运行各阶段、ADC2真实低于10V仍关断，以及四种缺EOC/EOS/OVR标志拒绝/关断且不回退。
- 多速率后端覆盖真实POWER_CHANGEOVER全关断期间的ADC2故障；非多速率兼容后端保持既有内部控制器换向逻辑，通过BOOST_RUN及随后的故障检查，不新增外部CHANGEOVER行为。真实worker接收ADC2输入；两种反向模式仍接受有效ADC1而忽略丢失/不同值ADC2。
- 既有请求重入快照测试改为锁存ADC2低值，后续新采样不覆盖拒绝首包。主工程模式选源/停止清故障测试与新来源同步更新。独立只读审查无问题，并重新运行三个新profile和拒绝首包测试通过。
- 四模式名义开关模型通过：正向12→18V稳态17.994V、峰值18.611V，电流14995/电压3000次；12→24V稳态24.007V、峰值24.843V。模型输入源稳定，不模拟开关干扰、真实供电瞬降或板上WCET。
- ARMCLANG6.18主与唯一bench全量重建均0错误0警告。主Code51552/RO1312/RW44/ZI6508；CCM11168字节，执行0x10000000，加载0x0800A2E0。实际HEX的CCM复制、向量/DMA/普通SRAM缓冲及2KiB栈核验通过；AXF导出HEX一致。
- 专用Boost1460字节/1条VDIV、完整入口1612字节/2条VDIV，worker调用/CCM放置通过；检查的正常快速函数无浮点指令。主机验证不能证明实板最坏耗时或电气表现。

主HEX：MDK-ARM/bidreaction/bidreaction.hex，SHA256 ABCB45F73628DA7D55C5817E744CDC62960BAD57533679889AE78101292829F7。
配套AXF：MDK-ARM/bidreaction/bidreaction.axf，SHA256 E03913AEE0DA621CB2A19A6AFF296B3A179A8F6A6010ED3907134D8B49B9B4C0。
bench HEX仍A9BA257BA3FFBB49C8FAED9803E3462671F692A9B4D063C9975512D09EF6D451。

下载后首页MAIN ADC B25/5 A2，正向Boost页FORWARD BOOST B25A2。保持用户12→18V工况复测启动/预充转升压；若故障，保留power_event.fault及power_status首包，欠压观察fault_input_volts/fault_raw_vh，ADC故障观察adc_reason及两ADC入口标志，使用本版AXF。
暂无本版实板反馈，不能宣称“2 IN9.9V”误报或T7已解决；固定相位是否处于干扰较小的窗口需结合实际两桥PWM与板端输入/PA0波形核对。
