meetyaothenstop/vscode/docs/正向Boost25k5k测试-20261108.md

# 主工程正向Boost 25/5kHz候选

用户明确批准的频率调整。继续使用MDK-ARM/bidreaction.uvprojx，Target bidreaction，不新建工程；用户自行下载，助手未操作板子。
降频前精简版8564652556f6b00d7ef3f25437e28822fa7baba6已推送，备份标签pre-forward-boost-25k-20261108的远端解引用提交核对一致，之后才修改固件。
版本标签main-forward-boost-25k-20261108。

|项目|正向Boost mode2|正向Buck及两个反向模式|
|---|---|---|
|PWM/ADC/快速软件保护|150kHz，保持|150kHz，保持|
|后台请求/电流计算|25kHz，每6个PWM|50kHz，每3个PWM|
|电压计算|每5次电流更新，5kHz|每5次电流更新，10kHz|
|积分步长|40us/200us|20us/100us|
|T7截止窗口|40us，未完成仍关断|20us，保持|

电压环切换使能时沿用原强制更新机制。PWM保护仍每个有效采样检查，不等待电流环。
Core/Inc/boost_control_rates.h集中25/5系数，仅forward_main_boost_step模板采用；公共forward_step兼容入口仍使用control_rates.h。生产worker仅mode2调用专用入口，模式变更先重新初始化。
电压和预充低通均保持连续6238rad/s极点：b=w*T/(2+w*T)，a=(2-w*T)/(2+w*T)，状态系数b*(1+a)。反馈T=200us，预充T=40us。
电压PI 0.3/8、电流PI 0.015/20、120V/s电压斜坡、500A/s预充电流斜坡及100/s接管斜坡保持。
原单步逻辑延迟在新周期下为40us；后台仍强制至少3个完整PWM全关断，且必须等到新的Boost plan后才重新开启，不把实际换向描述为固定20us。

输入10～42V、启动|IL|<1A、残压≤3V、目标高于实测输入、目标≤36V及原过压线保持。ADC相位、7.5A过流、方向保护和T1～T7保持。
用户报告精简版仍报64 T7，另报2 IN9.9V且电源表12V；本版未放宽10V欠压线，也未改变采样相位。瞬态实际压降与采样偏差待实测区分，不能由电源表12V推断输入每一瞬间都正常。

验证结果：

- RED：在原三周期代码上，新六周期用例在第三周期发现第二次更新而失败；实现模式专用节拍后通过。
- 78组完整主机用例通过。新增真实IRQ测试覆盖四模式请求间隔、分别3/6周期的T7关断、正向Boost每个中间PWM的过流/欠压即时保护；定向补充测试验证预充滤波、40/200us积分、每5次外环更新及各斜坡。
- 独立固定307bcdd旧源算法，按相同25/5kHz系数重新采样，与新专用入口360000步完整B/X/Y逐位一致；150kHz兼容另360000步一致。此结论不表示25/5与旧50/10轨迹逐位相同。Buck/反向、故障取消、抢占及停止回归通过。
- 四模式真实后台的名义开关模型通过，模型不含传感器瞬态、ESR、二极管恢复或板上WCET。正向12→18V稳态17.994V、峰值18.611V，14995次电流和3000次电压更新；12→24V稳态24.007V、峰值24.843V。其他模式仍约29990次电流更新。
- ARMCLANG6.18主/bench全量重建均0错误0警告。主Code51636、RO1312、RW44、ZI6508；CCM11272字节，执行0x10000000、加载0x0800A2CC。实际HEX复制/向量/DMA/普通SRAM缓冲及2KiB栈核验通过，AXF导出HEX一致。
- 专用入口1460字节/1条VDIV、完整入口1612字节/2条VDIV；实际worker调用及CCM放置通过，检查的正常快速函数无浮点指令。静态映像不证明板上最坏执行时间。
- 独立只读审查通过，无未解决的问题。修正菜单测试的旧宏分支预期后，定向重编译menu/UI的默认、关闭ADC详情、关闭整数快速路径、非多速率兼容及HW标识配置均通过；backend/preempt与补充速率测试按最终源码重编译通过，保留反向Boost原第三PWM开启断言。此后固件源码与已验证映像未变。

主HEX：MDK-ARM/bidreaction/bidreaction.hex，SHA256 8389EC0754E6815AAB6A173CE2CBE537B3FDFC36CADAC166B8992FD30A9A914F。
配套AXF：MDK-ARM/bidreaction/bidreaction.axf，SHA256 7F98F39082E784B10D176B41F7CB9BD5BF73E7AC7A4E787DD0BE90EBB983CE6B。
bench HEX仍A9BA257BA3FFBB49C8FAED9803E3462671F692A9B4D063C9975512D09EF6D451。

下载后首页应为MAIN ADC B25/5、正向Boost页FORWARD BOOST B25/5。保持用户当前12→18V工况，观察是否仍报64 T7或2 IN9.9V；若报错，保存power_status与power_event.fault首包，使用本版配套AXF，避免旧地址解释错误。T7重点为fault_elapsed_cycles、control_cycles_max、control_start_delay_max、control_run_wall_cycles_max和mode/state；欠压保留fault_input_volts、fault_v_left/right及fault_raw_vh/vl。
本候选未新增实板验证，未宣称T7或欠压问题已消除；硬件OCP接线及就绪性未验证，保持用户授权的ADC软件保护测试策略。
