meetyaothenstop/vscode/docs/正向Boost运行精简测试-20261108.md

# 正向Boost后台精简OPT1记录

修改前基线307bcdd已用pre-boost-t7-opt-20261107推送并核对远端提交。
本版标签main-boost-worker-opt1-20261108；主工程仍MDK-ARM/bidreaction.uvprojx，四模式保留。

仅主工程后台mode2使用forward_main_boost_step：共享原模板，消除零权重Buck除法及无效模式分支，保留预充、换向、斜坡、滤波和全部PI状态更新。公共forward_step兼容入口保持。
调度仍150kHz PWM/ADC/快速保护、50kHz电流、10kHz电压；T1～T7及电气保护保持。

验证：

- 测试先在原映像观测2条VDIV超过1条预算；新增入口未实现时独立对比链接失败。
- 77组完整主机用例通过。固定标签307bcdd的独立旧源与新入口在150kHz兼容及50/10kHz两种编译下，共720000步完整B/X/Y逐位一致，覆盖预充、换向、随机、饱和及重新初始化；拒绝错误模式并保持故障锁存。
- 真实后台12→18V名义开关模型：17.997V稳态、峰值18.603V，29990次电流/5999次电压更新。该模型不能证明实板稳定性。
- ARMCLANG6.18主/唯一bench全量构建均0错误0警告。实际HEX的CCM复制、PendSV及DMA向量、SRAM缓冲和2KiB栈检查通过；AXF导出HEX一致。
- 新入口1460字节/1条VDIV，完整入口1612字节/2条VDIV，worker确实调用专用入口且都在CCM。正常快速路径检查未见浮点指令。CCM共11264字节。
- 独立只读审查通过，无需修正的问题；审查者重跑两速率等价程序及实际ARM映像核验通过。

主HEX SHA256：A16B03ACCC516B9DCB4FBD75D73F511150DB34E510A3007126344BAA5BBF18A7。
主AXF SHA256：3F7037D6C27F9D22834B953915C039353C8760F65E7962F056BF92CFA4C69A5E。
bench HEX仍A9BA257BA3FFBB49C8FAED9803E3462671F692A9B4D063C9975512D09EF6D451。

用户确认重新编译并下载精简源码后仍报64 T7，并另报2 IN9.9V，电源表12V。软件验证不等于T7已修复，静态体积不等于实测WCET。T7仍是请求尚未完成即到下一截止时刻；2表示采样输入低于10V，尚不能确定是瞬态实际压降还是采样偏差，CC限流情况未确认。

先保存本版，再按用户明确批准将仅正向Boost改为25/5kHz，连续PI增益保持并重新离散化；PWM、ADC、快速保护150kHz和其余模式50/10kHz保持。用户操作下载，助手不操作板子；硬件OCP未验证。
