meetyaothenstop/vscode/docs/正向Boost启动1A-20261107.md

# MAIN正向Boost启动电流1A（2026-11-07）

## 请求与实现范围

用户在正向Boost测试中仍报128 S8，明确要求将启动电流检查也设为1A。
按当前上下文仅修改MAIN正向Boost（mode2），维持绝对值严格小于门限的比较。

入口：`Core/Inc/power_build_config.h`：

```c
#define POWER_MAIN_FORWARD_BOOST_START_CURRENT_LIMIT_AMPS 1.0f
```

`Power_RequestStart()`仅为MAIN mode2选择此值，并发布到已有`active_limits`和整数`raw_policy`。
请求S5及待启动、自举、装载阶段的S8因此共用1A门限，不在150kHz正常保护路径增加模式判断。
该设置不是运行限流，也不自动清错或重新启动。

| 模式 | 启动电流绝对值 | 启动输出残压上限 |
| --- | --- | --- |
| MAIN正向Buck | <1A | 3V |
| MAIN正向Boost | <1A（本次修改） | 0.25V |
| MAIN反向Buck | <1A | 3V |
| MAIN反向Boost | <0.25A | 0.25V |

原6A电流参考、7.5A采样过流、正向负电流保护、ADC/时序/硬件故障锁存保持。
预充、全关换向、PI、软启动、PWM/ADC150kHz、电流50kHz、电压10kHz保持。
唯一受限bench和普通历史配置继续使用原门限。

## 用户默认值与基线

开始前发现用户已将集中配置的正向默认值改为12V→18V，反向仍12V→6V。
这些设置完整保留，先独立提交为`3ad070fc9e5ac36751aa2b99ad120436f9c6450e`。
该基线ARM6.18重建0错误0警告，HEX SHA256为
`5F9131A192AF0D0347BB87922F8AF4707230B46C19CAE6363418857B336185E2`。
修改门限前创建并通过HTTPS推送`pre-forward-boost-start1a-20261107`，核对分支和标签解引用均为该提交。
SSH origin保留，未强推；既有IDE修改及无关未跟踪文件保持，不混入本次提交。

## 验证

- 新增真实后台测试`tests/forward_boost_start1a_test.c`：多速率整数路径和兼容浮点路径分别在旧门限下RED，均停在新的±0.98A启动请求；修改后均GREEN。
- ±0.3A、±0.98A通过请求及33个完整启动周期；±1.02A请求拒绝，浮点路径额外检查±1A等号拒绝。
- 在初次低侧使能前、自举中及两个装载边界注入+1.02A，均报S8并保持输出关闭，锁存正确首故障电流。
- 反向Boost仍在±0.3A拒绝启动，接受−0.2A后遇−0.3A仍报S8；正向Boost输出残压0.3V仍按原S6/S9拒绝。
- 正向Boost进入运行后7.6A采样过流、−1.02A错误方向仍立即关断。
- 菜单/UI测试用明确的按键或设置选择四模式测试工况，避免将可编辑的默认12→18V误当成固定24→12V；原有两处Boost0.3A/0.5A拒绝断言按新要求更新。
- 主/bench ARMCLANG6.18全量构建均0错误、0警告；主Code50068/RO1312/RW44/ZI6508，bench HEX逐字节保持。
- `tests/run_tests.ps1`完整73组回归通过，按脚本中用例名称核对73/73；内部断言打印不重复计组。
- 独立只读审查无Critical/Important/Minor问题，支持本次软件交付；未独立重跑构建或主机回归，也不判断实板时序/电气/OCP。

主HEX SHA256：`9E0A07792B71EB3AC647C6E1BCC675AB0829AFA8352D223EFE4F90DE43CD4CB0`。
主AXF SHA256：`488C8AF581AB18E009982A0D476FFDAD019C841A7DD8440B9AB1313B1DA146B3`。
bench HEX SHA256：`A9BA257BA3FFBB49C8FAED9803E3462671F692A9B4D063C9975512D09EF6D451`。
标识仍为`MAIN ADC ADG2 50/10`、`M-ADG2`，事件版本4；版本标签为`main-forward-boost-start1a-20261107`。

## 交付与证据边界

主工程仍为`MDK-ARM/bidreaction.uvprojx`，Target为`bidreaction`。
用户下载`MDK-ARM/bidreaction/bidreaction.hex`，调试须使用同次`MDK-ARM/bidreaction/bidreaction.axf`。
本次仅准备和构建，没有下载、复位、启动或操作板子。
这是用户要求的启动门限放宽，不证明原S8由真实电流还是采样误差导致，也不证明实板最坏时序、稳定性或硬件OCP。
