meetyaothenstop/vscode/docs/默认电压配置整理-20261107.md

# 默认电压配置整理与验证（2026-11-07）

## 修改入口

统一文件：`Core/Inc/power_build_config.h`，搜索`Power-on menu defaults`。
主工程使用紧随`#if POWER_MAIN_APPLICATION`的四个宏：

| 宏 | 当前默认值 | 用途 |
| --- | --- | --- |
| `POWER_FORWARD_DEFAULT_INPUT_VOLTS` | 24U | 正向输入设定 |
| `POWER_FORWARD_DEFAULT_OUTPUT_VOLTS` | 12U | 正向输出目标 |
| `POWER_REVERSE_DEFAULT_INPUT_VOLTS` | 12U | 反向输入设定 |
| `POWER_REVERSE_DEFAULT_OUTPUT_VOLTS` | 6U | 反向输出目标 |

输入设定决定菜单选择Buck还是Boost，实际输入和启动校验仍使用ADC采样。
`Menu_Init()`只引用配置宏，不再单独保存反向电压常量。
调试邮箱`power_target_volts`继续默认取正向输出值；反向菜单目标不会自动改写此独立邮箱。
这些默认值在初始化时装入RAM，按键修改不永久保存。
Boost参考起点仍由启动时实测输入配置，Buck仍从0.1V起步。

## 保持的配置

| 配置 | 正向输入/输出 | 反向输入/输出 |
| --- | --- | --- |
| MAIN | 24V / 12V | 12V / 6V |
| 24V FAST bench | 24V / 12V | 36V / 12V |
| 12V bench | 12V / 6V | 36V / 12V |
| 普通历史配置 | 12V / 36V | 36V / 12V |

仅集中宏定义和菜单引用，并修正`power_control.h`中调试目标固定36V的过时注释。
既有主工程和唯一受限bench工程保持；不修改PI、状态机、保护条件或150/50/10kHz频率。

## 验证

- 先用当前源文件全量重建主工程和bench，保存整理前HEX。
- 整理后主/bench ARMCLANG6.18全量重建均为0错误、0警告。
- 两个HEX分别与整理前逐字节一致，说明本次没有改变Flash运行镜像。
- GCC四种配置下的`power_menu.c`对象文件分别与整理前逐字节一致。
- `tests/run_tests.ps1`完整71组主机回归通过；按运行脚本中的用例名称逐项核对71/71，内部断言打印不重复计组。
- 差异审查确认所有原条件分支的默认数值及整数类型保持，无新增运行时配置读取或控制中断路径。

主HEX SHA256：`739DAAE0835E7A8207615E6D8B67473832D11E45665CA3B8819043114328E815`。
bench HEX SHA256：`A9BA257BA3FFBB49C8FAED9803E3462671F692A9B4D063C9975512D09EF6D451`。
构建标识仍为`MAIN ADC ADG2 50/10`、`M-ADG2`，事件版本4。
本次未下载、复位或操作板子，也未重新测量实板时序、电气行为或硬件OCP。

## Git与现场范围

整理前基线：`e1c1d9a735f5a83c7565900628c904371a17e7b8`。
备份标签：`pre-voltage-defaults-20261107`，编辑前已通过HTTPS上传并核对远端解引用提交。
整理版本标签：`main-voltage-defaults-20261107`；保留SSH origin，不移动既有ADG2标签。
用户原有IDE配置和未跟踪内容保留，不纳入本次提交；生成的HEX/对象文件及临时日志不提交。

用户本次反馈反向Buck能够正常36V降至6V；负载、时长和同步波形未补充。
这不是本次主机验证取得的实测结论，历史故障1/4/16根因仍未唯一确定。
