meetyaothenstop/vscode/docs/对话接续摘要-2026-11-04.md

# 最新对话交接摘要：ADG2已交付，当前先恢复调试连接（2026-11-04）

> 下个对话优先读本节。它更新并取代下方历史内容中关于“当前版本、控制频率、下一步”的说法，旧记录保留用于追溯。本节记录事实、历史授权和待查方向，不是新的烧录、复位或功率运行授权；执行时仍以用户当前请求及项目AGENTS.md为准。用户最后要求先停止排查、整理交接，本次只更新文档。

## 1. 一分钟接手

1. **当前固件为MAIN ADG2诊断候选**，源码提交`fcc6e3f7e21dd8ff5c1c7f1dc8edf4a15a6812d7`，标签`main-adcdiag2-20261104`，首页`MAIN ADC ADG2 50/10`，参数页`M-ADG2`，`power_event.version=4`。此后的文档提交会推进分支HEAD，不能把HEAD变化误当成固件变化。
2. **当前频率：PWM/ADC/快速软件保护150kHz，电流环计算50kHz，电压环计算10kHz。** 不要再说两个PI环目前都是150kHz。唯一受限bench仍保持原有参考行为。
3. 用户主要测试**反向Buck：右侧12V输入、左侧6V输出、100Ω负载**。用户已确认OLED在FRM1之后能正常刷新；最新主要报**4和16**，按START后立即出现和输出接近6V后出现两种情况都有。
4. **当前直接阻塞是调试连接不可用。** 最新Keil窗口持续报`Cannot access Memory`，同一fault在单独Watch项显示`0x10`、结构体展开却显示`0x01010000`；多个浮点值均为`2.3693558e-38`。这些不是可信的同次电气现场。
5. 用户当时确认**OLED正常刷新，实际显示故障4**；随后明确确认**已用板上返回/STOP停止功率输出，故障保留**。助手在此确认后点击过一次Keil的Stop，**暂停未能成功确认**，Keil弹出`Cannot access target. Shutting down debug session.`。错误弹窗最后仍保留，未点确定；没有复位、重新连接、下载、恢复运行或写目标变量。下一对话先重新核对现场，不能假定CPU已暂停。
6. **下一步应先恢复可靠的ST-LINK/SWD读取，再抓4/16的首故障电压、电流和阶段。** 目前没有这次故障4的有效锁存值。不要根据异常Watch数值继续改PI、频率或保护阈值；报1、4、16的物理根因均未唯一确定。
7. ADG2交付时71组主机回归、诊断关闭兼容检查、主/bench ARM6.18构建0错误0警告、实际镜像/CCM/栈/DMA/AXF及快速整数指令检查和独立只读审查通过。**主机通过不等于实板最坏时序、稳压、电气行为或硬件OCP已验证。**

## 2. 路径、Git与工作约定

```text
工作目录：C:\Users\k\Desktop\keil\hal\bidreaction
用户最初文档：C:\Users\k\Desktop\codex\双向buckboost.md
本节版本化副本：docs\对话接续摘要-2026-11-04.md
主工程：MDK-ARM\bidreaction.uvprojx
Target：bidreaction
当前HEX：MDK-ARM\bidreaction\bidreaction.hex
当前AXF：MDK-ARM\bidreaction\bidreaction.axf
唯一受限台架参考：MDK-ARM\bench12_buck_fast.uvprojx
分支：codex/main-buck
origin：git@github.com:meetyaothenstop/vscode.git
```

- 保留既有主工程及正向Buck/Boost、反向Buck/Boost四模式，不为每次调试另建工程。历史工程共享当前源码，重现旧版本要用Git提交/标签。
- 用户操作固件下载。不要自行重进Debug、复位或连接恢复时顺带下载；Keil现有启动调试选项可能装载应用/运行到main，需先核对设置及用户意图。当前用户要求先做交接，不继续操作板子。
- 用户要求每次大改前备份原源码到GitHub。项目AGENTS.md规定：重大固件重构前打标签、推送、核对远端；完成并验证新版本后提交并推送分支和标签、核对远端SHA，不强推。SSH认证此前不可用时使用同仓库HTTPS及既有凭据，**保留SSH origin**；近期上传均为HTTPS。
- 主工程使用用户明确接受的ADC软件保护测试：`POWER_MAIN_ADC_SOFTWARE_ONLY=1`。`protection_ready=0`可以是当前策略的预期；不能改成1来伪装硬件OCP已就绪，也未验证硬件OCP接线。
- 本次整理前分支最新提交为文档提交`e6911e66d4e8f2f9ba83cfd3006089fd950a5e87`；当前固件仍对应fcc6e3f。交接文档提交会再次推进HEAD。
- 已存在的无关修改必须保留、不要混入提交：`MDK-ARM/bench12_buck_fast.uvoptx`、`MDK-ARM/bench12_buck_fast.uvprojx`、`MDK-ARM/bidreaction.uvoptx`。另有旧scratch/生成目录：`.superpowers/live-oled/review-package.md`、`.superpowers/voltage-sense-explanation/`、`MDK-ARM/bench12_buck_fast/`、`tests/main_forward_full_suite.log`。不能声称整个工作区干净。
- 不提交可重建HEX/AXF/OBJ或IDE界面状态。近期任务的临时ADC诊断工作目录已经清理，持久记录以docs、tests和Git为准。

## 3. 当前固件指纹与验证范围

```text
源码：fcc6e3f7e21dd8ff5c1c7f1dc8edf4a15a6812d7
标签：main-adcdiag2-20261104
修改前备份：pre-adcphase-20261104 -> 7564102b3e732f095a0deb92b0edecbff2fdc33a
MAIN HEX SHA256：739DAAE0835E7A8207615E6D8B67473832D11E45665CA3B8819043114328E815
MAIN AXF SHA256：EE7F41D2D21830DE4FEF4B330F3B0FE952D5FADCB3E723D6E8726B02A5F5FBB5
bench HEX SHA256：A9BA257BA3FFBB49C8FAED9803E3462671F692A9B4D063C9975512D09EF6D451
```

备份标签、ADG2源码分支及版本标签均已推送并核对远端SHA。整理交接时再次核对本地主/台架文件指纹一致；**这不证明板上Flash与本地文件一致，也不证明调试连接正常**。

ARMCLANG6.18，主Code50060/RO1312/RW44/ZI6508；CCM9704字节，执行地址0x10000000、加载地址0x0800A2C4。主栈2048字节，bench栈1024字节，bench HEX保持不变。
当前map：`power_event=0x20000BB0`（712字节），`power_status=0x20000E78`（124字节）。**这些地址仅适用于本次AXF，不可移植到旧/新构建。**

验证记录：`docs/ADG2-验证.json`、`docs/ADG2启动ADC时序测试.md`。独立只读审查无Critical/Important/Minor问题，支持交付诊断版，不是实板根因结论。

## 4. 频率与时序结构：本轮从150kHz单速率改为多速率

用户先询问控制频率是否过高、部分代码是否执行不完，以及如何降低频率，并授权修改；还指出此前反复改代码却未先说明频率和执行预算的问题。

| 当前MAIN项目 | 频率/周期 |
| --- | --- |
| PWM载波 | 150kHz，约6.667μs；HRTIM周期32000ticks |
| ADC触发与快速软件保护 | 150kHz |
| 电流环计算 | 50kHz，20μs，每3个PWM周期请求一次 |
| 电压环计算 | 10kHz，100μs，每5次电流更新一次 |
| CPU/HCLK | 150MHz；每PWM周期1000CPU时钟 |

快速HRTIM_TIMB IRQ优先级0，负责新鲜ADC原码、快速保护、状态和两桥比较值提交。计算在可被抢占的PendSV worker（优先级15），OLED DMA/I2C IRQ为3。未引入RTOS。
PI积分/反馈滤波按20μs/100μs重新离散化，连续PI增益保持；低占空比用逐PWM周期的最小/空脉冲密度调制，避免三周期脉冲成组。
RAW1之后健康快速路径用整数ADC区间与Q24累加，浮点换算/计算在worker或故障冷路径；实际链接指令检查无快速健康路径FP指令，但仍需实板测完整异常开销和最坏时序。

**64 T7**是多速率请求在下一次50kHz请求前仍未完成/发布的截止期保护。可能涉及worker计算、等待和抢占，不等于只量到了PI纯运算。曾有T7现场：elapsed3435周期约22.90μs、spacing1000、counter15968；完成请求峰值2903周期约19.35μs。不能将历史isr_cycles_max单独当作稳定CPU占用率。
30个完整自举周期、2个装载等待周期及Boost交接全关断要求仍保留，未因诊断版本放宽T1～T7或电气门限。

## 5. 当前代码的相关故障码与门限

代码是位掩码；`0x10`是十进制16。首故障包只锁存第一次，`power_status.fault`还可能OR入后续位，因此要同时看`power_event.fault.code`。

| fault | 含义与当前条件 |
| --- | --- |
| 1 | ADC有效性：ADC1缺JEOS或有JQOVF；需要晚相位样本的正向Buck还检查ADC2 EOC/EOS完整且无OVR |
| 2 | 输入条件不满足 |
| 4 | 输出过压；MAIN Buck门限为min(max(最终目标×1.5,6V),40V)，6V目标即计算输出>9V |
| 8 | 采样绝对过流/电流ADC近轨；主工程绝对过流线7.5A |
| 16 | 电流方向保护；反向模式计算IL>+1A连续16个150kHz样本（约106.7μs）；正向IL<−1A立即触发 |
| 32 | 控制器异常 |
| 64 | 时序保护，结合detail T1～T7 |
| 128 | 启动拒绝/复查，结合S编号，不能与fault4等混读 |

反向软件电流预期为负（正方向约定左→右）。实际采样极性、增益和波形尚需已知电流/实板测量确认。
MAIN Buck输入10～42V、非零目标≤实际输入×0.95，冷启动电流绝对值<1A、输出残压≤3V；0V请求是关断，不是主动稳0V，也不清首故障。保护值是软件判据，不是实际峰值保证。

## 6. 用户实际反馈与电气信息

- 工况一直主要为反向12V→6V、100Ω。万用表输出约5.9～6V。
- 电流检测输出最初误说2.45V，用户随后明确更正为**2.49V**，运行及报错后都约2.49V。以后不得沿用2.45V作为最新实测。
- 当前软件ADC参考3.31V，电流零点2.49V，灵敏度100mV/A；INA240A1×20、5mΩ为当前代码假定，增益未完成已知电流标定。电压左右标定系数分别0.0461、0.04666。
- 100Ω、6V约60mA是平均负载电流，不等于固定相位电感电流。万用表读数不能代替故障时采样；真实尖峰/反向电流与采样偏差尚未区分。
- 用户确认右母线电容2×220μF+2×10μF=460μF。不要未经证实把同样参数当作左输出侧。旧文电压前端100Ω/470nF约47μs等仅为已有记录，现板完整模拟链路仍未独立核实。
- 曾报告按START后OLED冻结、万用表到6V，数秒后/另次描述1～2分钟后OLED恢复报16。不同运行不能混成同一个11秒现场。
- FRM1之后用户明确反馈OLED可正常刷新；之后偶发启动报1，最新则以4和16为主，两种出现时机都有。当前OLED正常刷新并显示4，调试器却已经无法访问目标。

## 7. 版本推进：这些功能已经做过，不要重复实现

| 阶段 | 源码/标签与主要改动 |
| --- | --- |
| 50/10首版 | `040164c`：把计算移到PendSV，快保护/PWM150kHz，电流50kHz、电压10kHz；之后出现过T7 |
| RAW1 | `4f69eff`，`main-fastirq-raw1-20261103`：快速整数保护与Q24逐PWM调制，主栈2KiB |
| EVT1 | `5b242c7`，`main-eventdiag1-20261103`：新增关断后的首故障阶段/前台/UI进度包，不加正常快速路径探针 |
| FRM1 | `6bdd74e`，`main-oledframe1-20261104`：修复真实UI/DMA夹具复现的页面饥饿，新增完整帧/ADC样本计数年龄，事件版本2；用户确认OLED恢复 |
| ADG1 | `5fc50b8`，`main-adcdiag1-20261104`：锁存中断入口ADC1/2原标志和reason，事件版本3 |
| ADG2 | `fcc6e3f`，`main-adcdiag2-20261104`：ADC故障额外填写既有fault时序字段，事件版本4；没有改门限/PI/频率，也没把猜测中的启动延迟来源改掉 |

FRM1的具体机制：启动/运行频繁切换时，旧UI反复丢弃帧并从第0页重来。真实UI夹具400次切换可复现第0页401次、后续多数页0次。修复为保存不可变待发快照、启动静默时暂停未发数据、数据完成后才推进页码、完成一帧后合并新遥测，STOP/故障可优先替换。
FRM1还补充已有ADC样本计数的年龄用于分钟级观测；DWT32在150MHz约28.63s回绕，HAL tick也可能受低优先级抢占。样本计数是“已接受的ADC周期数”，不是独立墙钟，缺样/暂停会影响其含义。

## 8. 已经取得的有效历史故障证据

### 8.1 RAW1与EVT1的16：历史有效包，不能被最新坏读数否定

RAW1首包：左5.22503805V、右12.056982V、IL+1.2324295A；原码0x012A/0x02B8/0x0CA1；duty0.368729293，比较值左0x6E00/右0x2AED。恢复标志1，后续只读计数自举/装载均0，至少经历HOLD恢复。

EVT1首包：valid1、code0x10、state3=RUNNING、mode3、bootstrap_resume1、自举/装载剩余0、polarity_samples16。目标6V、参考4.29981804V、duty0.377516657；左5.45297575V、右12.0396585V、IL+1.00610352A；原码0x0137/0x02B7/0x0C85；比较左0x6E00/右0x2BDC。
该次软件运行年龄约11.484326s，前台/UI入口最大间隔约22ms，故障前约1.7ms执行过。它不支持该次“前台连续数秒完全没执行”的解释，但不能排除其他运行的分钟级现象。
只锁存16次中的最后一个电流样本，不能重建整段波形或断言真实回流。主机名义开关/RC模型未报16，不证明板上正常。

详见：`docs/RAW1反向故障16现场-20261103.md`、`docs/EVT1反向故障16现场-20261103.md`。

### 8.2 ADG1的启动报1：已定位直接分支，物理原因未确认

有效首包：valid1、code1、detail1、state1=BOOTSTRAP、mode3、run_id1、start_pending0、bootstrap_resume0、自举剩余30、装载0；目标6V，duty/reference/比较值记录0。
run_age_cycles=0x570=1392，按150MHz约9.28μs；这是从软件event_run_start计时点到故障包，不是物理按键消抖后的独立墙钟测量。正常PI闭环尚未投入运行。
补充截图：`adc1_entry_flags=0x1`、`adc2_entry_flags=0xF`、`adc_reason=1`。用户确认上电持续运行、只按板上START，没有暂停/单步后继续。

- ADC1的0x1仅ADRDY，JEOC/JEOS/JQOVF都0。
- ADC2的0xF含ADRDY/EOSMP/EOC/EOS，OVR为0。
- reason1确定“ADC1入口JEOS缺失”，不是已经证明ADC没收到触发。标志也可能此前已被读取/清除；读取JDR能清JEOC，不能据此说会清JEOS。

reason编码：1缺JEOS，2有JQOVF，3两者同时，4正向Buck需要的ADC2延后样本无效。反向不因未使用的ADC2样本无效而报1。首故障为非ADC时，三个ADC专用字段按设计为0。

### 8.3 ADG2要验证的“前一次IRQ迟到”假设

真实后端夹具中人工注入：前一次STOP/待启动IRQ晚至CPU周期相位750（HRTIM计数24000）时，可能读走本周期已完成的ADC1并清JEOS，然后开始自举；下一正常IRQ在相位20到来，仅相隔270CPU周期，此时新ADC1序列尚未发生，ADC2晚相位样本已有完成标志。
此构造能复现code1/reason1、ADC标志1/F、自举剩余30、PI步数0；正常相位对照无ADC故障。**这是合成时序，不是实板迟到已经被测出的证据。** 测试已保存为`tests/adc_bootstrap_phase_test.c`，该exe预包含`tests/adc_real_isr_flags.h`使用真实ISR掩码。

链接反汇编还确认`event_run_start()`在启动提交PRIMASK锁内清零/复制两份172字节事件邮箱。它是待测延迟来源之一，实板耗时未知，尚未移出锁或改启动资格；不能宣称已找到根因。
ADG2只让ADC故障分支把已读取的begin/spacing/counter传入原首故障记录，不增加正常IRQ硬件读探针；先关断再建包：

```text
power_status.fault_spacing_cycles  # 原IRQ入口间隔
power_status.fault_counter_ticks   # 原入口计数器读数
power_status.fault_elapsed_cycles  # 关断之后、故障包复制之前的elapsed
```

elapsed含冷故障分支开销，不能当健康IRQ耗时。正常周期1000CPU时钟，明显短间隔加周期前段的counter支持上一IRQ迟到方向；仍须结合实板数据。DWT和counter读取不是同一条指令时刻，不做无误差相位反算。**当前未取得新的有效ADG2报1入口时序包。**

## 9. 最新4/16与调试读取失败：下个对话最先处理这里

用户明确现在主要报4和16，发生时机既有刚START，也有接近6V后。最初几张补测图中`power_status.fault=0`、`power_event.fault.valid=0`，是空包，不能解释4/16。
后来独立Watch一行`power_status.fault=0x10`，`power_status.fault_v_left`显示`<cannot evaluate>`；展开结构体后出现：

```text
power_status基址 0x20000E78（与本地ADG2 map相符）
state=0
fault/protection_ready/samples/isr_cycles_max/多个其他uint = 0x01010000
v_left/v_right/il/多个fault浮点值 = 2.3693558e-38
```

`2.3693558e-38`恰好是32位模式`0x01010000`的float解释；这不是三路独立测量都接近0的可靠证据。实际打开Keil读取UI后确认Command窗口反复`Cannot access Memory`，同一变量在独立项与结构体子项矛盾。
用户确认此时**OLED正常刷新、显示4**，所以不能把Keil残留16当成与OLED4同步的首故障。旧RAW1/EVT1的有效16记录仍有效，勿混为同一次。

随后操作边界与最后状态：

1. 助手先只读检查窗口；未重建或修改固件。核对本地HEX/AXF指纹正确，只能证明本地文件，不能证明芯片Flash或SWD正常。
2. 用户明确回复“已停止，故障保留”，确认通过板上返回/STOP停止功率输出；没有要求清错或复位。
3. 助手随后在Keil点击一次Stop，试图暂停CPU读取。没有成功暂停的证据；出现`Debugger - Cortex-M Error`，正文`Cannot access target. Shutting down debug session.`，Command还出现`Internal command error`。
4. **最后保留此错误弹窗，未点击确定、未重连、未复位、未下载、未恢复运行、未改调试连接设置。** CPU是否暂停/仍运行不能由该失败请求保证，输出停止是用户确认，硬件门极未用仪器验证。
5. 用户接着要求先总结本对话至最初Markdown。新对话不要接着盲点Run/Reset/Debug或重新下载。

没有这次故障4可靠的`fault_v_left/right/il`或code/state首包，无法区分真实过压、采样/校准偏差和控制行为。调试访问失败的具体来源（供电、接线/共地、信号完整性、探针/驱动、时钟设置等）也未确认，不能直接等同控制频率太高或RAM已经损坏。

## 10. 新对话建议的接续顺序

1. 先确认用户当前板子功率输出、OLED和Keil弹窗状态。当前用户选择先整理文档，不自动继续板子操作。
2. 在输出安全停止的条件下恢复ST-LINK/SWD连接，先核对MCU供电、共地、SWDIO/SWCLK和接口设置。具体SWD频率、Vref/NRST连接、探针型号与驱动状态尚未读取，不能写成已查证。暂停CPU尝试本次已失败，不要反复用坏Watch值判断。
3. 若尝试重新进入Debug、复位/断电、Connect Under Reset或下载，先明确这可能重启/清掉RAM现场；遵守用户自主下载约定，不擅自烧录。存在Hot Plug保留运行现场的连接方式，但本机是否可用、是否能恢复尚未实测。
4. 读取恢复后核对ADG2首页/`power_event.version=4`及匹配AXF。故障出现后先保留现场，确认`power_event.fault.valid=1`，再看首个code/state/mode与锁存电气值。

```text
# 报4/16时优先看（这些名称在当前PowerStatus源码中确实存在，类型float）
power_status.fault
power_status.fault_v_left
power_status.fault_v_right
power_status.fault_il
power_status.fault_raw_vh
power_status.fault_raw_vl
power_status.fault_raw_il
power_event.fault.valid
power_event.fault.code
power_event.fault.state
power_event.fault.mode
power_event.fault.target_volts
power_event.fault.reference_volts
power_event.fault.duty
power_event.fault.polarity_samples

# 若再报1，再看精确ADC入口及ADG2入口时序
power_event.fault.adc1_entry_flags
power_event.fault.adc2_entry_flags
power_event.fault.adc_reason
power_status.fault_spacing_cycles
power_status.fault_counter_ticks
power_status.fault_elapsed_cycles
```

state锁存的是关断前阶段：0停止、1自举、2装载、3运行、4故障、5换向、6保持。ADC专用字段为0并不表示非ADC故障没发生。报4/16时的时序字段通常为0，也不能解释成时间没有流逝。
若长表达式不能求值，可展开整个`power_status`查看成员；但当前问题已经有明确内存访问错误，**不是继续加Watch项就能证明读数恢复**。恢复后再验证同一成员在独立项和结构体中的一致性。
5. 根据可靠首包再决定：4是计算输出确实超过9V还是读数偏差；16是正常运行/HOLD恢复/启动哪个阶段出现正向IL，以及16个采样与真实波形的关系。必要时同步测电压/电流/门极波形，不盲目放宽阈值。
6. 不把“换了诊断版后主要报别的码”当成旧问题已根治；不要把主机合成模型或审查结论升级为板上时序/电气验证。用户已表达不希望无证据反复改代码，后续先定位再做最小改动。

## 11. 快速查阅资料

```text
README.md
Core/Inc/power_control.h
Core/Inc/power_build_config.h
Core/Inc/power_event_diag.h
Core/Src/power_control.c
Core/Src/power_raw_fast.inc
Core/Src/power_multirate.inc
Core/Src/power_event_diag.inc
docs/控制降频RAW1测试.md
docs/RAW1反向故障16现场-20261103.md
docs/EVT1反向故障16现场-20261103.md
docs/FRM1界面续传测试.md
docs/ADG1故障1定位测试.md
docs/ADG2启动ADC时序测试.md
docs/ADG2-验证.json
docs/superpowers/plans/2026-11-04-adc-entry-phase.md
tests/adc_fault_diag_test.c
tests/adc_bootstrap_phase_test.c
```

参考资料：[ST RM0440，ADC标志与注入序列](https://www.st.com/resource/en/reference_manual/rm0440-stm32g4-series-advanced-armbased-32bit-mcus-stmicroelectronics.pdf)；[ST ST-LINK连接模式说明](https://www.st.com/resource/en/user_manual/um0892-stlink-v2-incircuit-debugger-and-programmer-for-stm8-and-stm32-stmicroelectronics.pdf)。手册支持位定义/连接模式，不能替代本板时序和连接实测。

最后有效优先级：**当前先恢复调试读取；主要电气问题4/16仍待可靠首包；OLED刷新已由用户确认改善；固件为ADG2，频率150/50/10kHz，禁止用旧RES1“最新”结论接续。**
