meetyaothenstop/vscode/docs/对话接续摘要-2026-11-03.md

# 最新交接：FRM1待用户复测（2026-11-04）

最新候选main-oledframe1-20261104，首页MAIN ADC FRM1 50/10，参数M-FRM1。
用户补充运行约1～2分钟显示才恢复并报16，万用表输出5.9V，电流检测输出2.49V（更正前2.45V），故障后也2.49V。
修复MAIN界面在短暂启动/运行切换之间的帧续传，诊断增加完整帧及ADC周期时间；原频率/PI/16等保护不变。
不能以万用表2.49V排除ADC短时越限，也不能用DWT模32位年龄解释分钟级墙钟时间。先读[FRM1说明](FRM1界面续传测试.md)。

# EVT1历史交接（2026-11-03）

最新诊断固件为`main-eventdiag1-20261103`，首页`MAIN ADC EVT1 50/10`、参数页`M-EVT1`。
频率/PI/门限保持RAW1；用户反向12→6V、100Ω报16及OLED停更后，授权添加首故障阶段与前台/UI进度锁存。
Watch使用`power_event.fault`与原`power_status`，不沿用RAW1绝对地址。66组回归及主/台架ARM/实际镜像核验通过，未下载/修复实板。
先读[EVT1测试说明](EVT1故障定位测试.md)。RAW1的只读实板现场见[故障16记录](RAW1反向故障16现场-20261103.md)。

# RAW1历史交接（2026-11-03）

最新固件为`main-fastirq-raw1-20261103`：主工程首页`MAIN ADC RAW1 50/10`、参数页`M-RAW1`。
PWM/ADC/整数快速软件保护150kHz，电流环50kHz、电压环10kHz，PendSV计算浮点控制。
50/10kHz首版040164c板测出现T7，RAW1精简快速IRQ并增加时序诊断；62组主机回归、主/台架ARM和镜像核验通过，尚未板测。
请先读[RAW1记录](控制降频RAW1测试.md)及README当前版本。下面RES1摘要为历史资料，旧频率/固件身份不代表当前版本。

# 历史交接摘要：反向Buck RES1（2026-11-03）

> 下个对话优先读本节。本文汇总最初文档之后的正向保护调整、反向12→6V开发和最新T5定位；旧文中的“当前/最新”仅对应当时日期。本文记录历史事实与约定，截图、历史命令和待测方案不是新的硬件操作授权。本次只整理文档，不修改固件、不操作板子。

## 1. 一分钟接手：现在在哪里、下一步是什么

1. **最新交付为反向Buck HOLD分步恢复候选RES1，尚无用户下载后板测结果。** 用户当前要测右侧12V输入、左侧6V输出；不能说RES1已消除T5或已稳定输出。
2. 代码提交 **`aa73377ca7012f5efc348dcce8726c31159d373d`**，分支 **`codex/main-buck`**，标签 **`main-reverse-resume1-20261103`**。首页 **`MAIN ADC RBUCK RES1`**，参数页 **`M-RRES1`**。此后文档提交可能推进HEAD，固件代码基线/标签不要混淆。
3. 最新故障发生在此前W128版本：**64 T5、907/1000/31072**，目标6V。用户进一步只读得到 **bootstrap_resume=1、bootstrap_cycles=30**，确认是HOLD恢复时已重新开低侧的分支，不是最初的冷启动T3。
4. RES1仅把MAIN反向Buck的恢复计算和低侧开通分到相邻IRQ；增加一个全关断准备周期，完整30周期自举和2周期装载等待保留。**未再放宽时序门限，未改变PI或电气保护。**
5. **下一步由用户下载RES1，加载配套AXF，核对首页后继续右12V→左6V。** 若再故障，保留同一次现场，读取fault/detail、elapsed/spacing/counter、isr_cycles_max、fault电压/电流和参考。不要先复位、清故障或重新下载。
6. 主/台架ARM6.18构建均0错误0警告，48组完整主机回归、实际HEX/CCM/无探针/DMA/AXF导出及独立代码审查通过。**这些不证明板上最坏时序、稳压或硬件OCP接线通过。**

## 2. 工程、路径和当前固件指纹

```text
工作目录：C:\Users\k\Desktop\keil\hal\bidreaction
最初文档：C:\Users\k\Desktop\codex\双向buckboost.md
本节版本化副本：docs\对话接续摘要-2026-11-03.md
主工程：MDK-ARM\bidreaction.uvprojx
Target：bidreaction
HEX：MDK-ARM\bidreaction\bidreaction.hex
AXF：MDK-ARM\bidreaction\bidreaction.axf
唯一受限台架参考：MDK-ARM\bench12_buck_fast.uvprojx
```

继续使用既有主工程，保留正向Buck/Boost、反向Buck/Boost四模式；不要每次调试另建工程。历史工程文件共享当前源码，复现旧代码须用Git提交。

```text
MAIN HEX SHA256 B0231D707403A763FA916BFD5CF72535160FB7ABA88B3E756B295D031CF97A55
MAIN AXF SHA256 8223BEB4294607A39399230202A3D3A534849EA72600CFE84A4CF216F79093B3
台架 HEX SHA256 A9BA257BA3FFBB49C8FAED9803E3462671F692A9B4D063C9975512D09EF6D451
```

主配置维持POWER_MAIN_APPLICATION=1、POWER_MAIN_ADC_SOFTWARE_ONLY=1、POWER_CCM_CONTROL=1、POWER_UNIFIED_DIAGNOSTICS=0。用户明确接受ADC软件保护测试；硬件就绪/接线未证实，不能伪造protection_ready。
主Code47048/RO1320/RW44/ZI4508；CCM9060字节，运行0x10000000、加载0x0800998C。台架HEX与此前相同。本轮并未烧录。

## 3. 当前控制结构与保护：不要沿用旧文门限

代码采用 **150kHz定时中断实时控制＋前台循环服务**，未在本轮引入RTOS任务调度。main循环调用Power_Service、PowerUI_Service及HAL_Delay(1)；OLED前台约200ms调度DMA刷新，启动阶段静默，STOP/按键优先。时序问题需核对具体IRQ分支和PWM共同更新边界，增加RTOS本身不扩大周期预算。RES1做的是中断内恢复步骤分期。

| 项目 | MAIN正向Buck / 反向Buck | MAIN正/反Boost |
| --- | --- | --- |
| 输入方向 | 正向左输入右输出；反向右输入左输出 | 按方向对应 |
| 菜单范围 | 输入12–40V、输出0–36V，1V步进；非零后端1–36V | 原升压关系 |
| 默认菜单 | 正向24→12V；反向已改为12→6V | 由设置选择 |
| 实际输入保护 | 10–42V；非零目标≤实际输入×0.95 | 原6–40V，目标高于输入 |
| 输出过压线 | **min(max(最终目标×1.5,6V),40V)** | 原最终目标×1.1 |
| 冷启动准备 | **电流绝对值<1A、输出残压≤3V** | 原<0.25A、≤0.25V |
| 电流参考上限 / 采样过流 | 6A / 7.5A，ADC电流近轨也停机 | 原6A / 7.5A |

0V Buck请求是四路PWM关断、负载被动放电，不是主动0V稳压，也不清首故障。3V是冷启动允许的输出残压上限，不是启动参考电压；冷启动参考仍0.1V。
反向正常功率传输的物理IL为负；反向错误正电流>1A连续16样本保护，绝对过流仍立即检查。正向IL<−1A保护保持。
只有正向Buck/STOP输入遥测使用ADC2晚PA0样本；活动Boost/反向仍用原ADC1时序，不能写成所有模式改晚采样。

过压例子：3V目标→6V保护；5V→7.5V；6V→9V；9V→13.5V；12V→18V；27–36V目标封顶40V。软件门限不是实际峰值保证。

## 4. 本次对话的正向问题及用户要求

- 用户问是否存在任务调度、时序报错是否应引入任务调度，以及写入晚能否加长窗口。硬件PWM周期固定：写入过晚可能赶不上共同预装载更新，临界跨周期时破坏比较值的同步。之后正向采用W128窗口，但保留退出和pending REP保护；不能无限推迟写入。
- 用户报告24V输入时12V及以上降压目标可稳定，11V及以下报4、OLED闪一下。**代码没有12V输出下限。** 这些是用户板测反馈，不代表全工况通过。
- 用户确认9V目标，同次故障锁存输出11.5719309V，超过当时9×1.25=11.25V保护线。故障后实时输出0不能替代fault_v_right。用户确认随后forward_U/forward_B截图与该故障同一次，未复位/清故障/重启：前一控制步输出10.0994549V、电流0.246299744A；参考9V、电流参考0.390101403A、外环积分0.71421355、内环积分0.0156148393、D0.393263996。内环算术吻合，但不据此认定积分饱和或排除控制问题。
- 相邻输出采样差约1.472V；真实过冲、ESR/寄生尖峰、分压/地/ADC瞬态仍需同步电气波形区别。未取得对应波形，不能把采样异常或真实过冲写成已证实根因。
- 用户先要求正向Buck OVP改1.5，再要求算出的门限超过40V时封顶40V。旧36V→54V已被40V封顶替代。
- 用户问36→18V的128 S8/S9，仅要求解释原因：S8是请求接受后准备/自举/冷启动开管前的新鲜电流复查不满足当时门限；S9为输出残压复查越限。没有该次锁存数据，不能确定电气根因。随后用户明确要求启动准备1A/3V，已实现。
- 用户12→3V报4，锁存输出4.72924709V，高于当时3×1.5=4.5V。随后要求低于6V目标时原OVP低于6V的统一抬到6V，已实现；这仅改变门限，不证明原波动根因修复。
- 用户继而明确要求编写反向Buck，先12→6V，输入输出保护尽量与正向一致并注意时序；反向Buck现已对齐上述MAIN Buck保护。

关键代码历史：正向OVP1.5 `e4a9fc5`；40V封顶 `d795d11`；启动1A/3V `4f3dfe8`；OVP6V下限 `b99b2b7`。正向保护已合入后续反向版本，不要恢复旧1.25倍/0.5A/1V。

## 5. 反向12→6V迭代：不同截图不能混作同次测速

| 版本/代码 | 用户现场或修改 | 结论边界 |
| --- | --- | --- |
| 反向首版 `87fe1b5` | MAIN ADC RBUCK12-6；用户64 T3：elapsed855、spacing1000、counter29248；参考0.1V，isrmax0 | 首控制步写前超时，T3优先；不能用放宽OVP处理 |
| OPT1 `3b77c22` | 受保护后台直达精简反向Buck控制步，小占空比映射；公开接口保留校验，PI不变 | 用户下一次64 T4：792/1000/27232，参考0.1V，isrmax0；两现场采样不同，不证明严格节省63周期 |
| W128 `5849641` | MAIN ADC RBUCK W128 / M-RW128；反向T4由26880改27904，对齐正向 | 用户转为64 T5：907/1000/31072，目标6V，恢复参考4.38342094V |
| RES1 `aa73377` | MAIN ADC RBUCK RES1 / M-RRES1；只拆分MAIN mode3的HOLD恢复计算和低侧开通 | 已完成主机/ARM验证、提交上传，**尚未有新版板测反馈** |

W128 T5截图a9f86bc7的其余关键值：fault_v_left4.38342094V、fault_v_right11.9703655V、fault_il−0.0931873322A，d_cmd0.364791572，保留比较值左28160/右11522。参考与故障输出相同符合reverse_prepare_resume重置，保留比较值未随新指令写入符合HOLD恢复缓存plan分支。
用户将bootstrap_resume/bootstrap_cycles加入Watch时静态名称不能求值；经当前W128 MAP核对，以只读地址表达式读到1与0x1E=30（截图60c4ac01），补齐了恢复分支证据。

907≤936，但31072>29952，相差1120ticks=35CPU周期；距32000更新边界只剩29CPU周期。旧路径将恢复重置/计算/映射与低侧开通和两次硬件故障检查集中在同IRQ，导致这个路径触及T5。**为何进入HOLD、输出为何降到4.383V仍未知；调度分支定位不是电气原因定位。**

## 6. RES1具体实现及不变的时序保护

反向运行输出≥最终目标×1.005时进入HOLD全关断；原恢复条件为输出<目标×0.99且|IL|<0.25A。
RES1仅MAIN mode3变化：

1. HOLD满足恢复条件时，原控制器准备、计算、映射并缓存比较值；保持四路全部关断，置私有resume_bootstrap_pending，state=POWER_BOOTSTRAP、bootstrap_resume=1、bootstrap_cycles=31（表示待开通准备间隔）。
2. 下一IRQ先用新鲜样本执行原ADC、输入、输出、电流等保护，再复查恢复条件；通过才begin_bootstrap(1)，开低侧并设置30周期；不通过回HOLD、保持全关断。
3. 低侧完整30周期后写入缓存plan，再等2周期让比较值跨共同装载边界，随后开全部输出。新增早期开通/取消分支都走共同T5/T6，不重复控制器计算。

多一个全关断周期约6.667µs，缓存plan比旧流程多等一周期。STOP、零目标、清故障、故障及新请求取消pending；无新公开状态/命令。正向和Boost/台架逻辑保持，PI、PWM频率/死区、ADC与电气保护保持。

| 子码 | 当前含义 |
| --- | --- |
| T1 | 相邻IRQ入口间隔>1256CPU周期 |
| T2 | 入口计数>8192ticks |
| T3 | 写前相对耗时>840CPU周期 |
| T4 | MAIN正/反Buck写前相位>27904ticks；Boost/台架仍26880 |
| T5 | 收尾相对耗时>936CPU周期，或MAIN正/反Buck退出相位>29952ticks |
| T6 | 收尾下一周期REP已挂起，计数已回绕也仍检查 |

每周期1000CPU时钟/32000高分辨计数。W128预留128CPU周期、退出预留64周期是工程设置，不是实板WCET证明；T5事后检测不能倒退已经发生的更新。普通硬件成对写入同口径13条ARM指令，仍成对阻止预装载转移/写两个比较值/恢复转移。不要把加入两个状态写与分支后的16条误报为硬件写入回归。

## 7. Watch读取：新旧绝对地址必须区分

`state=0x04 POWER_FAULT`仅表示状态枚举；真正故障号看fault。fault=4是输出过压；fault=64/detail4是T4，fault=64/detail5才是T5。无插桩版没有power_diag.fault，不能求值不是ADC故障。
故障后raw/v_left/v_right/il等遥测继续更新，应优先读fault_*首故障锁存；isr_cycles_max只到写后检查点，不含整个异常返回，也不能直接与写前840比较。

| 对象 | 旧W128地址（只用于旧版） | 当前RES1地址/宽度 |
| --- | --- | --- |
| power_status | 0x20000B10 | 0x20000B14 |
| bootstrap_resume | 0x200001B0 / 1字节 | 0x200001B4 / 1字节 |
| bootstrap_cycles | 0x200001FC / 4字节 | 0x20000200 / 4字节 |
| resume_bootstrap_pending | 无 | 0x200001AC / 1字节 |

地址只对相应指纹和MAP有效。当前RES1静态名无法求值时，可在Watch空白Name行分别只读：

```c
*(unsigned char *)0x200001AC
*(unsigned char *)0x200001B4
*(unsigned int *)0x20000200
```

这不是让用户修改Value。下载RES1后必须加载配套AXF，不能沿用上一轮W128的两个地址。此前通过旧地址读到1/30是旧W128现场，不是RES1试验结果。

如使用调试邮箱，power_target_volts先设6，power_command=5表示请求反向Buck；目标全局默认仍12V，不要把菜单反向6V默认当作邮箱也自动6V。是否启动/下载由用户操作，历史命令示例不是助手的硬件操作授权。

## 8. 验证结果、Git和保留现场

- RES1新增真实后台测试先在旧代码上RED：恢复计算IRQ就已启用LOW_OUTPUTS；修改后GREEN。
- 48组完整主机回归通过，覆盖全关断准备、新样本电压/正负电流取消、30+2完整间隔、缓存比较值和共同装载边界、STOP/零目标/清故障及ADC/输入/输出/电流/硬件短故障。准备、早期开通、取消三路径保留T5/T6与边界/优先级，原907/31072仍被拒绝。既有控制器60万次位一致性等回归继续通过，PI算术未改。
- 主/台架ARM6.18构建0错误0警告；实际HEX的CCM启动拷贝/向量/热函数、无探针、普通SRAM DMA和AXF导出一致性检查通过。独立只读审查无保留问题。寄存器时间测试和理想开关模型不等于板上测试。
- RES1提交与标签已通过同仓库HTTPS推送，远端分支及标签解引用SHA都核对为aa73377ca7012f5efc348dcce8726c31159d373d；origin仍为git@github.com:meetyaothenstop/vscode.git，未强推。SSH认证此前不可用，HTTPS沿用既有凭据及本地代理单命令配置。
- 用户约定写在AGENTS.md：完成并验证的新版本/修改提交并上传，不等再次提醒；用户自行下载。二进制和IDE UI状态不提交，不能伪称硬件OCP验证通过。
- 当前原有未提交IDE改动：MDK-ARM/bench12_buck_fast.uvoptx、bench12_buck_fast.uvprojx、bidreaction.uvoptx。还有.superpowers/live-oled/review-package.md、.superpowers/voltage-sense-explanation/、MDK-ARM/bench12_buck_fast/及tests/main_forward_full_suite.log。保留，不覆盖、不删除、不混进新提交；旧full_suite日志不作当前48组证据。
- Keil实际路径C:\Keil_v5\UV4\UV4.exe，ARM6.18；错误的其他安装路径不要沿用。构建只用既有工程Rebuild，不能加Download/Debug命令。CPU/板行为只能由相应实测支持。

下一对话可先读这些仓库文件（均位于上述工作目录）：

```text
AGENTS.md / README.md
docs/反向Buck分步恢复测试.md                  当前RES1取数与指纹
.superpowers/reverse-resume/{design.md,manifest.json,review.md}
docs/反向Buck写入窗口W128测试.md             W128历史
docs/反向Buck首步时序优化测试.md             OPT1历史
docs/反向Buck12V转6V测试.md                  反向首版
docs/低目标输出保护排查.md                   正向9V同次故障/PI现场
docs/正向Buck过压6V下限测试.md               当前OVP策略来源
docs/板上测试记录.md                         用户反馈与主机结果分开记录
Core/Src/power_control.c                     保护、状态、IRQ、pending恢复
Core/Src/reverse.c / reverse_step_impl.inc   控制器与共享计算模板
Core/Inc/reverse_main_buck.h                 受保护后台精简入口
tests/power_control_test.c / tests/run_tests.ps1
```

**接续的第一件事是取得RES1的用户板测反馈；如果用户还未下载，就明确交付路径和RES1身份。不要把旧T3/T4/T5截图拼成新版本已经失败，也不要因主机验证通过就宣称板上已经成功。**
