meetyaothenstop/vscode/docs/控制降频50k10k测试.md

# MAIN控制降频候选：50kHz电流环 / 10kHz电压环

日期：2026-11-03。用户明确要求实施，并要求每次大改前上传原源码。
工程仍为`MDK-ARM/bidreaction.uvprojx`，Target`bidreaction`。
首页`MAIN ADC I50 V10`，参数页`M-50/10`；不是RES1。

## 备份

修改前代码为`32a9bc8cb93201b7f3ef34309ce2cdc2c8236360`（固件源码基线RES1 aa73377）。
已建立并上传注释标签`pre-control-multirate-20261103`，远端标签解引用和分支SHA均核对为32a9bc8。
使用同仓库HTTPS/OpenSSL及已有凭据/代理；origin仍为SSH地址，没有关闭主机/证书验证、没有强推。
原有未提交IDE改动及其他任务的未跟踪文件未纳入本次提交。

## 实现及取舍

- PWM载波、ADC、快速保护和状态机计时仍150kHz，每周期6.667us。
- 电流PI/斜坡运行50kHz，20us；电压PI/输出反馈滤波运行10kHz，100us。
- 连续PI增益保持；相关Tustin滤波系数重算。预充检测滤波为50kHz；Boost延迟由旧3步改为新1步，仍20us。
- PendSV优先级15，低于优先级0的快速控制中断。它只计算并发布带代号的结果，不写PWM/使能输出。
- 每3周期发出一个请求；结果完成后由最近安全快速IRQ成对写入预装载，再在共同PWM边界生效。
- 等到下一50kHz边界才提交的初始方案，在24→12V低压启动仿真出现负电流越线，已用复现用例否决；采用较短提交延迟。
- 50kHz下将最小脉宽成组保持3周期，在40→1V仿真出现负电流越线。MAIN Buck/预充对小于最小有效脉宽的指令采用逐PWM周期一阶脉冲密度调制；每次只输出原最小脉宽或空脉冲，PI仍50/10kHz。原受限台架不变。
- 正反Boost在预充结束、Boost延迟期间均全关断；至少3个完整PWM全关断周期（20us）且新Boost比较值跨装载边界后才重新使能。此项避免延迟期间继续使用预充空脉冲导致回流。
- 反向HOLD恢复保留全关断准备、随后新鲜采样复查、完整30周期自举及2周期装载等待；正反两种反向模式均使用准备阶段。
- STOP、零目标、故障、清故障和新启动代号取消旧计算；快中断抢占到发布前也不能让旧结果重新开管。

## 时序诊断

T1..T6仍针对150kHz快速IRQ，写前840CPU周期、Buck写前27904ticks、收尾936CPU周期/Buck退出29952ticks及pending REP检查保留。
新增`fault=64, fault_detail=7`表示：下一50kHz请求到期，上个计算仍未发布；全关断，不静默复用旧结果。
T7的elapsed是自请求开始的墙钟CPU周期数，含快速IRQ抢占；不是单次快速IRQ执行时间。
`power_status.isr_cycles_max`现在测快速路径；新增`control_cycles_max`测请求到worker完成的墙钟周期数，
`control_steps`、`voltage_steps`统计新运行的更新次数。不要直接与旧150kHz整控制ISR测速混用。
旧文档中的绝对Watch地址已经失效，下载后加载本版配套AXF，优先使用符号读取。

## 验证

测试真实控制器/后台，寄存器、时间与开关功率级由主机模型提供；不替换PI算术。
覆盖20us斜坡/积分、100us积分/滤波和参考保持、每300PWM周期100次电流/20次电压的稳态节拍、
T7缺失计算、逐周期ADC/输入/输出/电流/方向保护、停机和发布前抢占取消、HOLD恢复/新样本取消、30+2周期及Boost交接。
四模式理想开关模型，以及正向12→1/6/11V、24→12V、40→1/12/36V、反向12→1/6V、40→1/36V和双向12→24V，负载100Ω、输出460uF。
仅为这些名义参数的主机结果，不能替代电感/电容容差、ESR、传感器瞬态、负载阶跃、实板最坏时序和稳定性测量。

最终54组回归全部通过（48组保留150kHz旧执行契约，6组验证实际MAIN多速率控制/菜单/界面/后台/抢占/13种名义开关工况）。
主工程ARM6.18重建0错误0警告，Code49728/RO1320/RW44/ZI5708；CCM11064字节，运行0x10000000、加载0x08009C30。
主HEX SHA256：`1D767D9282D392B51A1EA41DE3E50D6C1FE95E753D5AE6E6FCF631C25E71FE43`。
主AXF SHA256：`B33B6F3EE63C0FC2975746E649EA07E93ED0D12A76D6019CD6CF4B48CE7E1047`。
台架0错误0警告，HEX SHA256仍为`A9BA257BA3FFBB49C8FAED9803E3462671F692A9B4D063C9975512D09EF6D451`，逐字节指纹不变。
实际HEX启动拷贝、HRTIM/PendSV向量、worker CCM、Flash紧急关断、OLED DMA/SRAM及AXF导出字节一致性检查通过。
独立只读审查指出两项P1：变计算延迟下Boost全关断间隔可能不足20us、MAIN1KiB栈不足。
已先用故障用例复现，再以快中断计满3个完整PWM关断周期并确认新plan装载、主工程专用2KiB栈修正，测试RED→GREEN。
台架栈保持1KiB。审查同时指出正向全关断理想模型的母线方向问题，已修正并明确模拟低侧使能/理想二极管，13工况重跑通过。
PendSV调用已放入CubeMX用户代码区。审查后修正由作者以回归和实际镜像检查验证，没有声称二次独立审查。
本版标签`main-control-50k10k-20261103`；完整机器记录见`控制降频50k10k-验证.json`。

## 用户下载交接

HEX：`MDK-ARM/bidreaction/bidreaction.hex`。
AXF：`MDK-ARM/bidreaction/bidreaction.axf`。
下载由用户进行。本轮未连接/操作板子，未验证硬件OCP接线。
新版若报错，请保留同一次现场读取fault/detail、fault_elapsed_cycles/spacing/counter、
isr_cycles_max、control_cycles_max和fault电压/电流。T7需与旧T3/T4/T5区别分析。
