meetyaothenstop/vscode/docs/主工程Buck测试.md

# bidreaction主工程：Buck12–40V/0–36V/6A参考

最新版本见[反向Buck分步恢复RES1](反向Buck分步恢复测试.md)。下文为历史，
当前正反Buck冷启动均为1A/3V，过压均为1.5倍、最低6V/最高40V。

2026-10-30当前为OPT2无插桩候选，下载身份、HEX指纹和取数步骤见
[主工程OPT2测试](主工程OPT2测试.md)。分段计时历史见[主工程T3诊断](主工程T3诊断.md)。
下文是非插桩主工程原基线，不能将历史指纹当作当前版本。

工程`MDK-ARM/bidreaction.uvprojx`，Target`bidreaction`，
固件`MDK-ARM/bidreaction/bidreaction.hex`。用户自行下载，本任务无板上操作。
不新增工程；原bench12_buck_fast仅保留为受限参考，Boost及反向模式继续存在。

## 配置与范围

| 项目 | 主工程Buck（正/反） | 主工程Boost（正/反） |
| --- | --- | --- |
| 输入菜单 | 12–40V，1V步进 | 同菜单 |
| 非零输出菜单/后端 | 1–36V，菜单1V步进 | 1–36V且目标高于实际输入 |
| 0V | 关闭四路PWM，负载被动放电 | 零请求按Buck OFF操作，非升压目标 |
| 电流参考上限 | 6A | 原6A |
| 采样过流停机 | 7.5A | 原7.5A |
| 实际采样输入保护 | 10–42V，覆盖标称端点误差 | 原6–40V |
| 输出过压 | 目标×1.25；36V对应45V | 原目标×1.1 |
| 冷启动 | 电流绝对值<0.5A、输出≤1V | 原<0.25A、输出≤0.25V |

主界面`MAIN ADC SW 6A`、参数页`SW-MAIN`。默认正向输入24V/目标12V、反向36V/12V。
界面按输入/输出设置选择Buck/Boost；实际启动仍核对采样输入，不能靠菜单设置伪装电源。
正向Buck最大Dcmd0.95，后端要求目标≤实际输入×0.95，运行中每次新样本也检查。
例如40→36V可达，12→36V是Boost工作点。反向Buck保持输出严格低于实际输入。

6A是电感采样电流控制参考的上限。7.5A是独立采样停机线；控制跟踪有纹波、延迟和超调，
不保证实际瞬时电流≤6A。硬件比较器通路尚未确认；当前由用户明确选择ADC软件保护测试，
未把protection_ready伪造为1。设`POWER_MAIN_ADC_SOFTWARE_ONLY=0`可恢复未就绪禁止启动，
本机默认未确认接线时会报512；只有验证接线后才能启用`POWER_OCP_WIRING_CONFIRMED`。

## 0V与调试命令

0V表示关闭所有门极输出并取消待启动，不是强制将带电输出电容瞬间拉到0V。
正向/反向Buck直接请求0或-0在STOP、准备、运行和FAULT均可执行；FAULT及首故障数据保持。
负数、NaN/无穷、0和1V之间的非零后端目标不作为OFF接受。

调试邮箱编号保持：1正向Boost、2停止、3清故障、4正向Buck、5反向Buck、6反向Boost。
要零关断，先设`power_target_volts=0`，再提交4或5。单改target不会实时改变当前运行目标。
正目标运行中不允许直接重启/改目标，先STOP，等待新鲜STOP阶段样本和残压/电流满足条件。
0V关断不清故障，也不绕过下次正目标冷启动检查。

## 采样、显示和模式保留

正向Buck用优化控制步；正向Boost用完整步，二者由单一私有模板编译生成，
U/B/X及初始化接口保持。反向step/hold/resume保留并迁入CCM。
正向Buck用ADC2在4.8µs的PA0输入采样，电流/右输出继续ADC1原采样；
活动Boost/反向使用原ADC1反馈时序。ADC2不用时仍消费标志，不能将旧ADC1样本误作晚样本重启。
OLED前台DMA约200ms调度一帧；启动期间不发新显示页，键/STOP优先，错误仅显示离线。
840周期写入/936周期收尾和相位检查保持，搬到CCM和主机测试都不等同板上耗时通过。

## 软件验证及板上下一步

43组串行主机测试通过，含旧32组、主工程SW/硬件guard两种策略、四模式/邮箱、
32个直接/邮箱零状态组合、样本切换、输入/目标/7.5A相邻码和6A参考边界、故障锁存、
DMA和菜单；540000个Buck/120000个Boost参考轨迹一致。
100Ω/22µH/460µF名义模型覆盖12→1/6/11、24→12、40→1/12/36V。
主模型采样峰值回归上限2A（40→36V约1.507A），旧台架1.5A要求不变；这不是板上保护门限。
主/台架ARM重建均零错误零警告；主HEX的CCM拷贝/向量/四模式函数/SRAM检查通过，
CCM7712字节，运行0x10000000、加载0x080098A4，Code45500/RO1288/RW44/ZI4476。

主HEX SHA256：`C21781791837435A881C1C96CB96A9982E10094D842736E7459EFF39D50A7749`。
本轮无板上下载/复位/启动。用户先正常STOP，再自行下载主工程，核对新身份。
先按原低功率24→12V/100Ω条件验证遥测、STOP、首次故障和最坏IRQ耗时，
再逐点检查低/高输入及输出，保持实测输出目标可达；保留启动波形和故障样本。
当前100Ω在36V仅0.36A/12.96W，不验证6A限流；若验证36V/6A，负载功率为216W，
超过用户已报150W负载额定，不能将原负载额定当作该满载点已满足。
主工程在全部负载下的稳定性、当前标定/硬件OCP、输入晚采样收益和最坏时序仍待板测。
