meetyaothenstop/vscode/docs/对话接续摘要-2026-10-30.md

# 最新交接摘要：反向Buck分步恢复RES1候选待板测（2026-11-03）

## 最新：HOLD恢复T5现场确认，拆分计算与低侧开通

用户目标6V、右输入12V，T5现场907/1000/31072，reference=fault_v_left=4.38342094V，
fault_v_right11.9703655V/IL−0.0931873322A。用户随后按W128 MAP地址读出resume=1、cycles30，
确认旧HOLD恢复已在同IRQ完成控制器准备并开低侧，绝对退出相位超过29952共35CPU周期。
为何HOLD/输出变化仍未确定。当前RES1仅MAIN mode3先全关断缓存plan并pending，下IRQ新样本复查后开低侧，
保留30完整自举+2arming及840/27904、936/29952、T1/T2/T6，STOP/zero/clear/fault均取消pending。
48组回归、独立只读审查、主/台架ARM零错误零警告、实际HEX/CCM/DMA/无探针与AXF导出核验通过，台架HEX保持。
主HEX`B0231D707403A763FA916BFD5CF72535160FB7ABA88B3E756B295D031CF97A55`，
CCM9060/load0x0800998C，power_status0x20000B14；resume新地址0x200001B4、cycles0x20000200、pending0x200001AC。
旧W128绝对地址不适用于RES1。普通硬件写入仍13条，不含两个状态写，不代表WCET。
无板上操作；用户自行下载核对`MAIN ADC RBUCK RES1`/`M-RRES1`并继续12→6V。
当前手册：[分步恢复测试](反向Buck分步恢复测试.md)。以下为历史。

## 最新：反向792/27232的T4后，采用正向已有的W128窗口

OPT1交付后用户报告64 T4并给出7e91b4bd截图：elapsed0x318=792、spacing0x3E8=1000、
counter0x6A60=27232、reference0.1V/isrmax0、D0.0101074623，左比较28160/右0。
锁存左0.0526010543V、右11.9357195V、IL+0.0361404419A。Flash身份未独立验证。
T3已通过，但相位超旧26880线352ticks=11CPU周期；距32000更新边界仍149CPU周期。
与上一T3现场的两个读数相差63CPU周期，但两次采样条件不同，不能将其当作严格同条件优化耗时/WCET。
当前`MAIN ADC RBUCK W128`/`M-RW128`：仅MAIN mode3写前相位改为27904，与正向相同，预留128周期；
DWT840、写后936/29952及T1/T2/T6保持，Boost/台架仍26880。电气保护/PI/ADC/PWM/OPT1路径保持。
48组回归通过，含该首步回放、27904/27905、T3优先、T5、回绕低计数REP/T6及模式缓存切换。
主/台架ARM6.18零错误零警告，实HEX/CCM/无探针/DMA及AXF导出一致；正常成对写入13条指令与OPT1相同。
主HEX`8376F6A02A2C32C86D16BD85C072A85AB67D711783A62877F7083BABBE5B58BF`，
CCM9100/load0x0800996C，power_status0x20000B10；台架HEX保持。
没有板上操作，128/64预留及正常/HOLD恢复尾部均无实板最坏耗时证明。由用户下载并复测，
当前手册：[反向W128测试](反向Buck写入窗口W128测试.md)。以下为历史。

## 最新：反向首个控制步T3后，优化重复校验及零脉冲路径

用户截图522a01d8：fault64/detail3、elapsed0x357=855、spacing0x3E8=1000、counter0x7240=29248。
参考0.1V、D0.0106072314、左比较28160/右0、isrmax0；锁存左2.47224951V、右11.9357195V、IL+0.108888626A。
写前DWT超15周期，绝对相位超2368ticks=74CPU周期，优先记T3；符合首控制步写前退出，未证明哪段耗时占比。
用户问下一步，当前准备`MAIN ADC RBUCK OPT1`/`M-RBO1`：已通过保护的ADC后台直达Buck/hold步，
公开接口保留输入校验；小占空比按原规则直接生成28160/0比较值。PI、采样及电压/电流保护保持。
时序840/26880、936/29952和T1/T2/T6全部保持；旧855/29248在新增首步回放中仍报T3并禁止写入。
48组回归及公开/直达路径60万次逐步位一致性、独立b99b2b7旧源参考比对通过。
主/台架ARM6.18零错误零警告；实HEX/CCM/无探针/DMA、直达调用/零脉冲分支及AXF导出核验通过。
主HEX`ABE8985210FC9D531A1BFB235F3A888CBC0AAC0EE1478D6746A9AE6FA55E623D`，
CCM9100/load0x08009968，power_status0x20000B10；台架HEX未变。主体788→656字节不代表已测节省周期。
没有板上操作，OPT1实际T3/T4和稳压效果须用户下载后验证，见[首步时序OPT1](反向Buck首步时序优化测试.md)。
以下均为旧版本及此前板测记录。

## 最新：反向Buck12V输入、6V输出

用户要求编写反向Buck，先右输入12V降至左输出6V，输入/输出保护尽量与左输入正向相同并注意时序。
同一主工程保留四模式；反向菜单默认12/6，身份`MAIN ADC RBUCK12-6`/`M-RB126`。
正反Buck共享输入10–42V、目标≤0.95×实际输入、OVP=min(max(目标×1.5,6V),40V)、启动1A/3V。
6V目标OVP9V；Boost保留原规则，正向规则/采样与台架HEX保持。物理反向电流IL为负。
反向Buck新增编译期精简步和内联比较值映射，完整Boost同模板保留，原PI/软启动不改。
新增函数均在CCM；原反向写前T4=26880保持，增加写后绝对T5=29952，DWT840/936和T1/T2/T6保持。
ADC1原IL→左输出→右输入相序保持；ADC2仍读PA0，反向不将此左输出晚采样错当右输入。
48组回归、30万次逐步/旧提交控制器比对、12→6V名义100Ω/12Ω/空载模型通过；均非板测。
主/台架ARM6.18零错误零警告，HEX/CCM/无探针/DMA和AXF导出核验通过；反向精简788字节、完整1572字节。
主HEX`697435B7A09E3B4AA4E5244268D9F1DFA71A855D7BF35336D71668CEC19EC27B`，
CCM8992/load0x08009968，power_status仍0x20000B10；台架HEX仍A9BA257…6D451。
没有板上操作；时序实际耗时、稳压/电流标定与硬件OCP未独立核验。用户自行下载，见
[反向Buck12→6V测试](反向Buck12V转6V测试.md)。以下为之前版本历史。

## 最新：低目标的正向Buck过压线最低6V

用户12V→3V报4，截图锁存输入12.0105734V、输出4.72924709V、IL−0.0770206451A、
参考3V、D0.23559022，raw_vl0x111=273；超过当时4.5V门限约0.229V。
实时输出0.225V是关断后采样；尚未判断真实过冲或采样偏高。用户随后要求低于6V目标时，
原OVP不足6V的提高到6V。仅MAIN mode1，等价于有效非零目标下OVP=min(max(目标×1.5,6V),40V)。
1/2/3/4V目标6V；4.01V目标6.015V、5V目标7.5V、6V目标9V；40V上限保持。
当前身份`MAIN ADC OVP6-40`/`M-OV640`，启动1A/3V、其他模式/台架及W128等保持。
47组主机回归、主/台架ARM6.18零错误零警告、实际映像/CCM/无探针/DMA及AXF导出一致性通过。
主HEX`224F5F2F2EAB0CD0D2D38D150E1A4C800A3B06290E0E3A4A3D72EE80B7466D95`，
CCM7760/load0x08009960，power_status仍0x20000B10，台架HEX不变。
没有板上操作，门限调整不代表稳压/采样根因已修复。当前手册：[6V下限测试](正向Buck过压6V下限测试.md)。
以下均为旧版本记录。

## 最新：正向Buck启动电流1A、输出残压3V

用户反馈36V输入、18V目标报128 S8，随后明确要求启动准备电流1A、启动电压3V。
仅MAIN mode1改为|IL|<1A、输出≤3V；S5/S6及S8/S9使用相同选择后缓存的门限。
反向Buck0.5A/1V、Boost0.25A/0.25V、唯一台架均保持；3V不是软启动参考值。
30周期自举/2周期arming、0.1V软启动初始参考、PI/ADC/PWM、W128、6A/7.5A、
负向电流保护及OVP=min(目标×1.5,40V)保持。身份`MAIN ADC START1A 3V`/`M-S1A3V`。
47组回归、主/台架ARM6.18零错误零警告、实际HEX/CCM/无探针/DMA及AXF导出一致性通过。
主HEX`2CF1E6DFB537CAE7F0BE536A8F25B3F71F1E6B590F32F8281A580DADC03EC35B`，CCM加载0x08009938，
`power_status`仍0x20000B10。台架HEX未变。本版无板上操作，S8实际电流/采样根因及新门限效果未板测。
当前手册：[启动1A/3V测试](正向Buck启动1A3V测试.md)。以下均为之前版本历史。

## 最新：正向Buck保护设定最高40V

用户针对原36V目标对应54V的说明，要求超过40V的保护门限自动设为40V。
当前同一主工程为`MAIN ADC OVP1.5 C40`/`M-15C40`，正向Buck=`min(目标×1.5,40V)`，
26V目标39V门限、27/30/36V目标40V；其他模式/台架、目标菜单范围、PI/采样及W128策略保持。
47组回归、主/台架ARM6.18重建0错误0警告，实际HEX/CCM/无探针/DMA及AXF导出一致性通过。
主HEX`17BDE4B29EFDF0072DA76A4D302A6651965456751EC71214039F29039B4E8880`，CCM加载0x0800992C，
`power_status`仍0x20000B10。用户自行下载，本版未板测；40V是软件门限上限，不是物理峰值保证。
当前手册：[40V封顶测试](正向Buck过压40V封顶测试.md)。以下为之前未封顶等版本的历史。

## 最新：用户要求仅正向Buck过压比例1.5

主工程/分支保持，首页`MAIN ADC OVP1.5 6A`、参数页`M-OV1.5`；仅mode1门限=目标×1.5，
反向Buck仍1.25、Boost仍1.1、台架指纹不变。继承W128时序及全部PI/采样/电流策略。
47组回归及主/台架ARM6.18零错误零警告，实际HEX/CCM/无探针/DMA/AXF导出一致性通过。
主HEX`4E5AAA5F828CCC15C33CFBED3412065002F0BE7D453967C4CDD2CB206E6EC2F5`，
`power_status`仍0x20000B10。**36V×1.5=54V超过用户所报50V电容额定；本候选供当前24V低功率测试，
未验证高压、硬件OCP、最坏返回余量或新倍率稳压结果。** 用户自行下载，无助手板上操作。
之前同次9V故障证据和PI算术/采样跃变分析见[低目标排查](低目标输出保护排查.md)，
没有证明根因修复；新门限下旧11.5719309V样本通过只代表放宽保护。
当前手册：[正向Buck过压1.5测试](正向Buck过压1.5测试.md)。以下W128等原文保留为历史。

## 0. 最新后续：仅正向Buck适当后移T4并增加绝对相位收尾检查

用户讨论预装载更新边界与软件提前截止线后，授权继续核算并准备候选。
当前同一主工程为`MAIN ADC W128 6A`/`M-W128`，诊断宏0，标签拟为`main-write-w128-20261030`，
实际提交以Git记录为准。MAIN正向Buck T4=27904（预留128CPU周期），新增T5绝对相位29952
（检查点距周期末64CPU周期）；T3仍840、DWT T5仍936、T1/T2/T6保持。
主Boost/反向、台架T4仍26880。四模式、PI、ADC/PWM频率/相位、使能、成对写入和电流保护保持。

47组主机回归、主/台架ARM6.18重建0错误0警告、实际HEX CCM/无探针/DMA及AXF导出一致性通过。
主HEX`221D8D688D62346430E208BA6BE16ED19B5421B2B1F7CF1F44AE5D944DABDA7B`，
CCM7760字节，加载0x080098F0；`power_status`新地址0x20000B10，旧OPT2地址不可沿用。
台架HEX仍A9BA257BA3FFBB49C8FAED9803E3462671F692A9B4D063C9975512D09EF6D451。
独立代码审查无重要问题；64周期返回余量没有板上实测保证，不能由静态指令数认证WCET。
本轮没有连接/下载/调试/运行板子，不能宣称T4修复或电气验证通过。

下一步由用户在原24→12V低功率条件下载W128，核对身份并记录同次故障/运行结果。
T5新增相位失败也可能出现，须同时看elapsed/counter；不要因为T4换成T5就继续扩大门限。
详细手册：[主工程写入窗口测试](主工程写入窗口测试.md)。以下OPT2及更早状态为历史。

> 新对话优先读本节，再按需查历史。原交接时本节同步到 `C:\Users\k\Desktop\codex\双向buckboost.md`。后续792/27232截图补记只更新仓库文档，外部原文未同步；原文中的旧“当前/最新”不能覆盖这里。本文是事实记录，历史命令/方案不是新的硬件操作授权。本轮没有修改控制代码或操作板子。

## 1. OPT2阶段接续记录（历史，当前候选见第0节）

1. **尚未解决的问题：主工程24V输入、12V目标启动后时序保护停机。** 原主工程报64 T3，第一次局部优化后报64 T4；OPT2交付后用户仍报T4，后续截图取得本次写前792周期/间隔1000/计数27232，超相位期限352刻度，等效11个CPU周期。尚未独立核验板上固件身份，也未确认稳定12V输出。不要说OPT2已修复或没试过。
2. 用户已确认早期受限台架 **12V→6V可稳定输出且OLED实时显示**。这是用户板测反馈；不能推广为当前主工程全范围/满载/最坏时序通过。
3. 当前主工程是既有 **`MDK-ARM/bidreaction.uvprojx`，Target `bidreaction`**。保留正向Buck/Boost及反向Buck/Boost四模式。原 `bench12_buck_fast.uvprojx`仅作唯一受限台架参考，用户明确不要每轮另建工程。
4. 当前代码交付基线 **`0b277f9`，分支 `codex/main-buck`，标签 `main-timing-opt2-20261030`**。首页应为 **`MAIN ADC OPT2 6A`**，参数页 `M-OPT2`；诊断宏 **`POWER_UNIFIED_DIAGNOSTICS=0`**。本次交接文档整理可产生后续文档提交，实际HEAD以 `git log`为准。
5. **用户自行下载固件。** 助手只准备、构建、验证、交付；本轮没有烧录。用户明确选择沿用ADC软件保护测试；硬件OCP接线/就绪仍未确认，不伪造 `protection_ready=1`。
6. 主工程电流参考上限 **6A**，独立采样过流停机线 **7.5A**。二者不等同；不保证电感瞬时峰值≤6A，也不是平均负载电流硬限6A。
7. 目前反复T4说明真实写入时限仍未解决。本次792/27232数据已取得，下一步核对运行时身份、重新评估完整中断路径/150kHz最坏预算；不要继续把时序故障当PI超调、输出过压或ADC失效来处理，也不以只省11周期为余量目标。

## 2. 路径、构建与固件身份

```text
工作目录：C:\Users\k\Desktop\keil\hal\bidreaction
原始交接文档：C:\Users\k\Desktop\codex\双向buckboost.md
本节版本化副本：docs\对话接续摘要-2026-10-30.md

主工程：MDK-ARM\bidreaction.uvprojx
Target：bidreaction
主AXF：MDK-ARM\bidreaction\bidreaction.axf
主HEX：MDK-ARM\bidreaction\bidreaction.hex
主scatter：MDK-ARM\bidreaction_ccm.sct
受限参考：MDK-ARM\bench12_buck_fast.uvprojx
受限参考Target：bench12_buck_fast
```

不要误改已有内层旧副本或切换到历史工程来代替主工程。源码共享，历史 `.uvprojx`不代表历史源码快照；要复现旧版本用对应Git提交。

主工程定义（整理时重新读取确认）：

```text
USE_HAL_DRIVER,STM32G474xx,POWER_MAIN_APPLICATION=1,POWER_MAIN_ADC_SOFTWARE_ONLY=1,POWER_CCM_CONTROL=1,POWER_UNIFIED_DIAGNOSTICS=0
```

当前OPT2指纹（整理时核对磁盘文件）：

```text
HEX SHA256 D845A25DB8D14F24294885701FA8EED4EE5DF230A169D3FF4DE6DA3EC2BF93E8
AXF SHA256 C92E52CC6ECEBE549E1A57BD2E5098DC0B6D13CB8E9A8954CAD3350CC3284A0A
```

ARM Compiler6.18；主构建零错误零警告，Code45588/RO1288/RW44/ZI4500。
CCM7756字节，运行0x10000000、加载0x080098D0。实际HEX的启动拷贝/向量/四模式热函数/无Buck外部映射调用/无探针/DMA普通SRAM检查通过；AXF导出HEX完全一致。
当前46组主机回归通过，包含200016条映射指令的通用/专用/比较值适配器对照、非法值与空指针输出保持，以及HOLD/恢复和硬件故障竞态。
最终独立审查未发现问题；较早一次审查因额度限制中断，恢复后已补完，不能把额度中断当作测试或代码失败。

共享代码的台架重新构建也零错误零警告，CCM3376字节，最新台架HEX为
`A9BA257BA3FFBB49C8FAED9803E3462671F692A9B4D063C9975512D09EF6D451`。
它是重建参考，不是此次重新验证过的台架电气结果。

## 3. 用户要求、硬件和当前保护范围

- 用户要求主工程Buck标称输入 **12–40V**、输出设置 **0–36V**、限流控制 **6A**；明确要求保留升压和反向功能。
- 菜单1V步进；默认正向24→12V、反向36→12V。正目标后端允许1–36V。**Buck目标0/-0为四路PWM全部关闭、负载被动放电**，不等于主动0V稳压；不清首故障，重启仍需新鲜样本/冷启动条件。
- 正向Buck请求和每次新样本均检查目标≤实际输入×0.95；反向Buck仍要求目标严格低于实际输入。菜单按设置选择Buck/Boost，后端用实际采样校验。
- Buck实际采样输入保护 **10–42V**，为标称端点留误差余量；OVP为目标×1.25（12V对应15V，36V对应45V）；冷启动要求 |IL|<0.5A、输出≤1V。
- Boost正/反保留原输入6–40V、1.1倍OVP、0.25A/0.25V冷启动策略。其他电流、反向、ADC、硬件故障锁存、时序保护保持。
- 用户明确接受ADC软件保护测试；硬件就绪真实保持未确认。`POWER_MAIN_ADC_SOFTWARE_ONLY=1`仅绕过未就绪启动限制，不宣称硬件保护完成。
- MCU STM32G474CB系列，当前配置CPU150MHz、PWM150kHz；电感模型22µH，右输出电容按用户确认2×220µF＋2×10µF=460µF。用户随后说明输入输出对称、两侧电容50V，负载额定150W；这些是用户描述，不是助手实测器件/温升。
- 模型/此前测试常用100Ω，但本轮没有重新确认当前实接电阻值及电源实际限流。**不要把旧文的电源0.2A限流当作现在的已知设置**。36V×6A=216W，超过用户所报150W负载额定；全范围/6A满载没有通过板测。
- 电流5mΩ采样电阻位于电感与右桥之间，属于电感电流测量。代码名义ADC参考3.310V、零点2.490V、100mV/A，左/右电压增益0.0461/0.04666；标定及实际瞬时峰值仍未完整验证。

## 4. 本段对话推进过程（2026-10-27之后）

### 4.1 受限台架：过压、输入采样及OLED

- 用户因6V目标故障4先要求输出保护7V，仍报4；之后同实物电容参数的仿真未见明显电压超调，提出8V。PI没有因此修改；仿真稳定不等于实板PI/采样链已经排除问题。
- 输入电压偶发过高/过低的排查，最终采用 **ADC2对同一PA0在每周期4.8µs晚采样**；ADC1电流/输出相位保持。当前主工程仅正向Buck及STOP输入遥测用晚采样，活动Boost/反向继续ADC1原反馈时序；未使用的ADC2仍排空标志。不能写成所有模式都改晚采样。
- 用户报告能稳定6V但OLED停在启动前，随后前台 **I2C TX DMA约200ms调度一帧**修复后，用户确认12V输入下能同时输出6V并实时显示。启动阶段仍静默，键/STOP优先；显示传输失败可离线，不能只凭旧屏幕判断CPU/输出状态。

### 4.2 24V→12V台架：电流与过压门限

- 用户改测24→12V，先OVP14V，随后报故障8，要求最大电流6A；台架采样停机阈值提高到6A，而台架 **电流参考仍1A**。
- 后续故障4，用户要求保护15V；台架12V目标对应15V，低目标按比例。对应代码基线 `c59df1c`。
- “1A参考”指电压环给电流环的指令上限，和采样过流停机线、平均输出电流不同。迁入主工程后改用原主工程6A参考/7.5A采样停机。

### 4.3 主工程集成与三种时序配置

| 代码提交 | 版本/标识 | 主要内容及结果 |
| --- | --- | --- |
| `4bb0c4f` | 主工程 `MAIN ADC SW 6A` / `SW-MAIN` | 保留四模式，Buck范围/0V OFF/6A参考，CCM、晚ADC、DMA；43组回归。用户先128 S7，纠正实际输入后64 T3。 |
| `8dc59c7` | 分段诊断 `MAIN ADC DIAG 6A` / `M-DIAG` | 同一工程启用已有分段探针，45组回归；用于定位，探针增加耗时，不是T3修复版。 |
| `dd3e6ff` | 第一优化 `MAIN ADC OPT 6A` / `M-OPT` | 固定保护限值启动时缓存，主Buck专用映射；46组回归。实板仍64 T4，读到806/27680。 |
| `0b277f9` | 当前OPT2 `MAIN ADC OPT2 6A` / `M-OPT2` | 原映射算术移到内联头，比较值适配器消除调用/无用字段存储，HOLD只保存比较值；46组回归。交付后仍64 T4，后续截图取得792周期/27232刻度；运行时身份未独立核验。 |

四模式fast/full分发共享同一控制步模板，正向Buck剪掉Boost独有计算，完整Boost/反向路径保留。有效PI、抗饱和、软启动保持，不曾凭这些T3/T4记录调PI。
OPT2检查过部分初始化：后端仅消费已写入的两个比较值，静态resume结构未使用浮点字段有零初始化，不读未初始化数据。
软件审查/主机测试/ARM链接通过不代表实际周期已达标；不要用代码字节数或测试模型宣布时序修复。

## 5. 故障现场：严格区分不同尝试

### 5.1 128 S7已解释，输入设置原因由用户确认

128是启动拒绝，S7是模式/目标与实际输入的电压关系不满足；正向Buck还检查目标≤0.95×实际输入。
主工程默认24→12V，如果仍接12V却设12V目标，会被拒绝。用户明确回复输入电压弄错，随后实际24V/目标12V，转为64 T3。不要回头靠抬OVP处理S7。

### 5.2 时序数据表

| 尝试 | 故障/数据 | 能确认的结论 |
| --- | --- | --- |
| 原主工程非插桩 | 64/detail3；elapsed0x35A=858，spacing0x3E8=1000，counter0x72A0=29344，reference0.10000001 | START后立即T3；耗时超过840，实际相位也超过26880。 |
| 主分段诊断 | 64/detail3；mode1/target12；入口ARMING、捕获RUNNING；写前952，spacing1000，入口counter4800、写前counter352、capture1147，mask0x3F | 同一轮刚完成使能/状态转换后首控制计算超时；RUNNING捕获不代表持续稳压；小counter不能排除回绕。 |
| OPT第一优化 | 64/detail4；elapsed0x326=806，spacing1000，counter0x6C20=27680，reference0.10000001；fault_left24.0211468V/right0.0692929998V/IL0.100805283A | 耗时通过840，但真实相位仍晚800刻度，等效25CPU周期，约0.167µs。isr_max0符合尚未走到写后统计。 |
| **OPT2交付后新截图** | fault0x40/detail4；elapsed0x318=792，spacing0x3E8=1000，counter0x6A60=27232，reference0.10000001；isr_max0；fault_left23.9685459V/right0.173232496V/IL0.100805283A | **仍未解决；实际相位超过26880共352刻度，等效11CPU周期、约73ns。** 截图地址0x20000B08与当前MAP一致；运行时固件身份/指纹未独立核验。 |

本次截图`codex-clipboard-c7cfd01e-6a3c-4d22-a2a8-3921174e4ad0.png`由用户提供，
不是助手操作调试器读取。与旧OPT读数相比，耗时/相位均少14CPU周期，但不同次启动和身份边界
使其不能作为受控测速或最坏余量证明。两组`counter/32 - elapsed`均约59CPU周期，
包含入口/函数前导/读取时差等因素，尚不能归因于某一项。上方实时采样与`fault_*`不是同一采样时刻。

诊断版累计完成点为 `[145,249,416,533,808,938,0]`；区域差值：入口145、ADC104、保护167、状态/使能117、控制器275、PWM映射130周期，包含探针和边界开销。
mask0x3F只证明0～5有效；第6点0表示尚未完成写入，不能解释为写入零耗时。capture1147包含关断/记录之前的开销，不可替代准确写前952。不同版本/不同次启动不可拼成严格A/B测速。

### 5.3 时序子码的确切含义

```text
64 = POWER_FAULT_TIMING
T1：入口间隔 >1256 CPU cycles
T2：入口定时器计数 >8192 ticks
T3：写比较值前 DWT耗时 >840 CPU cycles
T4：写比较值前 HRTIM计数 >26880 ticks（且此次耗时未先触发T3）
T5：收尾耗时 >936 CPU cycles
T6：收尾时下一周期REP已经挂起
```

当前配置每PWM周期1000CPU时钟≈6.67µs、32000高分辨计数。写入检查需在约5.60µs前完成，预留160CPU时钟≈1.07µs给写入/收尾。
T3从函数内计时点算耗时，T4看真实周期位置，包含中断入口/保存上下文等在内的影响，因此T3合格仍可T4。
这里T4的“4”是时序子项，不是输出过压故障4。该故障本身不能证明PI不合适。
抬电压/电流门限不能解决它；仅把时间保护放宽也不等于能安全跨过成对PWM更新边界。

## 6. Keil踩坑与读取方法

- 曾多次出现“编译/烧录后首页不变”。查到Keil打开的工程仍缓存 `POWER_UNIFIED_DIAGNOSTICS=1`，覆盖磁盘0并重新编出诊断版；一次普通版则缺少诊断定义。不能仅凭首页不变说烧录失败。
- 最后查到GUI烧录日志有 `Erase Done / Programming Done / Verify OK`，而实际宏仍1。助手在编辑态关闭工程，磁盘写回0，再在**同一Keil窗口**重开并通过GUI Rebuild，实际HEX/AXF与当时OPT指纹匹配；没有代替用户点击Download。
- 当前诊断宏保持0，当前应看到OPT2标识；若又看到DIAG，先查当前打开Target的C/C++ Define和实际产物，别重复改错工程。
- Watch曾浮到主窗口之外，点总开关不显示。已通过 `Window → Reset View to Defaults`中的当前布局Reset恢复右下Watch1；这次Reset只是IDE布局，不是MCU复位，未选择Restart。
- `View → Watch Windows → Watch 1`打开观察窗口；`<Enter expression>`位于Name列最下方。可双击空白行输入 `power_status`，提交后展开。比较值相位记录在该结构内。
- 诊断版才有 `power_diag.fault`。当前无插桩版没有该对象，其 `cannot evaluate/undefined identifier`正常，不代表ADC不工作；旧 `\power_control\sample_valid`观察表达式也可能无法求值，暂不靠它判断ADC。
- 曾有samples/raw全0截图，后来能读到数百万采样；全0快照可能是进入调试后的初始化/复位状态或无效读取，不能据此认定ADC故障。
- 本地主工程曾开启Load Application at Startup/Run to main，驱动连接也可能暂停/复位CPU。取得同次故障时不要先清故障/复位/再次下载；若没有现成可读调试会话，不默认擅自重连硬件。

当前新故障优先读取：

```text
power_status.fault
power_status.fault_detail
power_status.fault_elapsed_cycles
power_status.fault_spacing_cycles
power_status.fault_counter_ticks
power_status.isr_cycles_max
power_status.v_reference
power_status.fault_v_left
power_status.fault_v_right
power_status.fault_il
```

本轮助手只恢复/查看界面、添加/展开/滚动观察项，没有发送板上运行、暂停、清故障、复位或下载命令。故障后遥测会继续，使用 `fault_*`锁存字段区分现场与后来的实时值。

## 7. Git状态、授权边界与可查记录

- origin保持 `git@github.com:meetyaothenstop/vscode.git`；仓库 https://github.com/meetyaothenstop/vscode ，当前开发分支 `codex/main-buck`。
- `4bb0c4f / 8dc59c7 / dd3e6ff / 0b277f9`已提交上传并核对远端SHA。OPT2标签指向0b277f9；不要为文档提交移动既有代码标签。
- 用户约定：每次完成并验证的新版本/修改都提交并推送当前分支和该次新标签，不等用户重复催上传；不能以本地commit宣称已上传，不强推。
- SSH认证此前不可用，实际通过同仓库HTTPS和已有凭据上传，并保留SSH origin；会话中使用过已有本地代理 `socks5h://127.0.0.1:10808`的单命令覆盖，未全局改网络/主机验证。后续仍需实际验证网络与远端SHA。
- 整理时未提交的IDE改动：`MDK-ARM/bench12_buck_fast.uvoptx`、`bench12_buck_fast.uvprojx`、`bidreaction.uvoptx`。保留，不覆盖/删除、不混进提交。另有历史scratch、输出目录和 `tests/main_forward_full_suite.log`，不要随手清理。
- 可重建HEX/AXF/MAP/对象/可执行文件及IDE UI状态不提交Git；原用户文档的完整历史只保留在原路径，本节摘要另留repo副本便于版本管理。
- Keil CLI主工程构建曾因沙箱读不到已安装PDSC误报缺包；保留原RTE包设置，在具有读取权限的环境构建通过。不要因此擅自删RTE或安装/升级包。软件构建不包含下载操作。
- 现有主工程scatter把控制热路径放CCM、数据/栈/DMA放普通SRAM，避免CCM别名；静态链接正确不等于实板最坏中断耗时通过。

参考文件（均在上述工作目录）：

```text
AGENTS.md / README.md
docs/主工程OPT2测试.md                 当前候选说明与取数
docs/主工程时序优化测试.md             OPT1历史
docs/主工程T3诊断.md                   分段诊断历史
docs/主工程Buck测试.md                 主工程原范围/0V/模式设计
docs/板上测试记录.md                   按尝试区分现场
.superpowers/main-opt2/{design.md,manifest.json,review.md}
.superpowers/main-opt/{design.md,manifest.json,review.md}
.superpowers/main-timing/{design.md,manifest.json,review.md}
tests/run_tests.ps1                    当前46组主机回归
.superpowers/ccm-timing/verify_build.ps1 实际映像核验
Core/Src/power_control.c               T3/T4、启动/状态机/保护
Core/Inc/pwm_plan_inline.h             当前共享内联映射
Core/Src/forward.c + forward_step_impl.inc
```

## 8. 新对话的下一步

1. 先确认当前实际运行的首页身份与工程/宏；用户交付OPT2后已反馈T4，不能宣称已经成功或完全没试过。
2. 本次用户截图已取得792/1000/27232和约0.1V参考，保留首故障，先核对板上身份；后续复测独立记录，不能拿OPT1的806/27680或本次单点代表最坏时序。
3. 对照实际定时器相位重新分析入口延迟、函数前导/FPU上下文、临界区、保护/状态使能/控制器/映射整条路径。已有多轮局部优化仍失败，应重新评估150kHz完整时序预算，再决定结构方案；不要继续盲调PI或抬T4门限。
4. 降控制频率、多速率外环、重排首次使能/计算等只是待评估方向，**尚未选择、实现或得到板上验证**；若改变架构，要统一验证PWM/ADC/保护/模式切换，不把建议写成已完成改动。
5. 继续沿用同一主工程，保留四模式与用户下载习惯。软件修正完成时做合适回归/ARM及真实映像核验，上传GitHub后核对SHA；用户再在原低功率条件测试。

原交接任务是整理最初Markdown；后续用户补充上述T4截图，本轮将新数据和判读补入仓库记录，未修改外部原文、控制代码或操作板子。T4仍未解决。
