meetyaothenstop/vscode/docs/板上测试记录.md

# 板上测试记录

## 2026-11-03：反向12→6V的HOLD恢复T5

W128后用户截图a9f86bc7：64 T5，elapsed907/spacing1000/counter31072，isrmax907；
reference=fault_v_left4.38342094V，右输入11.9703655V，IL−0.0931873322A，目标确认6V。
用户截图60c4ac01通过W128配套MAP地址读到bootstrap_resume1、bootstrap_cycles0x1E=30。
这确认HOLD恢复后开低侧的分支，绝对退出线29952被超过1120ticks=35CPU周期，非相对936线触发。
为何进入HOLD及输出采样变化未定，Flash身份/电气波形未独立核验。
本轮RES1将仅MAIN反向Buck恢复准备与低侧开通拆到相邻IRQ，保留30+2周期及全部时序/电气门限。
48组主机回归及主/台架构建/实际镜像核验通过，不等于板上故障已消除。
用户自行下载并继续12→6V，完整指纹、修改与待测项见[RES1记录](反向Buck分步恢复测试.md)。
本轮助手没有板上操作，硬件OCP仍未验证。

## 2026-10-26：Buck FAST 输入保护

用户截图：`codex-clipboard-be5236d4-86f6-439f-818c-1786825b2abc.png`。
调试器加载 `bench12_buck_fast/bidreaction_bench12_buck_fast.axf`。
对应当前 Git 源码基线 `e71f061`；未独立读取板上固件哈希。

| 项目 | 观察值 |
| --- | --- |
| fault | 0x02，输入电压保护 |
| fault_detail | 0 |
| OLED IN | 用户报告13.53V，截图未展开fault_input_volts |
| isr_cycles_max | 0x2F3 = 755周期，150MHz下约5.033µs |
| v_reference | 0.601065713V |
| fault_v_right | 0.242525503V |
| fault_il | 0.351379395A |
| fault_elapsed/spacing/counter | 均为0，本次非时序故障，不据此推断无耗时 |

判读：参考从冷启动0.1V已上升至约0.601V，说明已执行连续控制计算；
本次此前完成的IRQ记录最大755周期，首次控制计算的T3障碍已跨过。
并不证明6V稳态、全负载或长时间时序已经通过。

该台架允许输入10.5–13.5V，13.53V超过上限而触发保护。
若电源确设12V，13.53V比设定高约1.53V；不能因为只超门限约0.03V，
就认定只是ADC量化噪声。当前左电压换算约17.534mV/ADC计数；
仍需fault_raw_vh、锁存输入值及实际输入测量来区别瞬态与采样异常。

下一步：核对电源设定、万用表在板上左输入正极/GND测量值，以及
`power_status.fault_input_volts`、`power_status.fault_raw_vh`。
万用表稳态值不能排除短暂尖峰；如果稳态约12V，后续再抓启动时左输入
电压波形并与ADC原始值对照。此次仅记录证据，未修改电压/时序门限。

### 后续反馈及输入门限调整

用户确认电源设定12V，万用表在输入端约11.9V；随后报告用示波器持续观察
输入保持11.9–12V。未提供对应的波形截图/带宽/触发设置，因此这些观察支持
优先排查采样链路，但不能据此精确定位干扰来源。

用户要求给部分报错范围增加余量。此次仅将当前FAST台架的输入上限从13.5V
提高到14.0V，启动请求及运行检查共用配置；低于10.5V或高于14V仍立即保护。
准备电流0.5A、准备输出1V、运行电流1.5A及时序门限保持此前配置。
新门限允许13.53V采样通过，并不证明采样准确或供电瞬态已排除。

同一调试过程中用户又报告`IN10.31V`，未提供这次Watch或固件哈希；
不能把它与之前13.53V拼成同一次故障波形。10.31V低于原10.5V下限。
按用户要求增加测试余量，将当前FAST输入窗口进一步统一为10.0–14.0V，
超界仍单次采样保护。新增10.31V运行通过、低于10V首次采样关断及精确门限测试。
输入实际约12V而采样两侧偏移仍未定位；后续需观察PA0分压采样点和地参考。

## 2026-10-26：输出保护4与S9复现

- 截图`codex-clipboard-ac042ec1-1211-40ef-8f17-49a7d72ee94c.png`：
  fault4，v_reference6V，fault_v_right6.68677425V，fault_il0.213968277A，
  isr_cycles_max0x2F3（755周期）。此记录为采样过压，单凭它不能排除采样偏差。
- 随后独立一次S9截图`codex-clipboard-30f8b343-c3b3-4c27-b8d7-6b5320128401.png`：
  fault128/detail9，v_reference0，fault_v_right1.6457088V，fault_il0.189718246A。
  超过当前1V冷启动门限；可能有上次运行残余电压，尚未核对同一时刻实际输出。
- 用户先报告实际最大约6.3V，后给出的两张10µs/div照片触发约6.3V和6.39V，
  不能覆盖完整启动/停机过程，不能据此否定另一次6.6V过压。
- 最终照片`e4985b220d933e3e9eeb3bc04fae1e62.jpg`：C1测右输出，
  10ms/div，2V/div，10X，DC，上升沿触发约6.63V，最大6.68750V，
  最小−0.350V（含启动基线/测量噪声），过峰后呈放电下降。
  该独立记录支持实际输出确实越过6.6V，不能继续将故障4仅视为ADC误报。

用户确认当前电流5mΩ电阻在电感与右桥之间，属于电感串联采样，
不需要因其位于右侧就搬到左侧；增益、零点及正负极性仍需实测状态支持。
输出电容为2×220µF＋2×10µF，标称总460µF。原台架模型690µF已修正，
并增加启动全过程峰值断言（原测试只看最终稳态电压，可能漏掉过冲）。

460µF、22µH、100Ω的现有理想开关模型：最终约5.999V，峰值约6.136324V，
峰值时刻约0.12166s；未复现实测6.6875V。它不含完整模拟采样/传感器误差、
MOS体二极管、驱动延迟、ESR和PCB寄生，因此不能用模型通过替代板上证明。

尝试通过Keil读取PI状态时，表达式查询及RAM地址查询均返回AGDI内存读取失败。
用户继续后尝试暂停，Keil明确弹窗“Cannot access target. Shutting down debug
session.”；没有取得有效PI数据。此前界面残留的fault4/7.03323936V等值不作为
新鲜读取记录。下一步恢复供电/SWD连接，在故障4停机后读取forward_B的Product2、
Saturation、DiscreteIntegrator、DiscreteIntegrator1，以及power_status.d_cmd、
forward_U.IL，判断输出已偏高时电流指令及积分是否仍推动送能量。

## 2026-10-27：Watch 2取证配置与现场不一致

> 下节重新附加后的直接RAM读取已取得故障4。此节保留旧会话的界面/命令结果，
> 其中零值未通过后续实时访问复核，不作为板上真实无故障或PI全零的证据。

源码基线为`bd39b80`，继续使用`bench12_buck_fast`，未重新构建固件。
用户确认板上已显示故障4、保持供电后，通过computer-use操作Keil。
核对自动下载、运行到main、连接后复位及调试前更新均关闭；仅附加，
使用`LOAD %L NOCODE INCREMENTAL`补载符号，未发送下载、复位、清故障或启动命令。

首次附加查询出现“Cannot access target. Shutting down debug session.”，
Command随后显示AGDI cannot access target while executing，未取得有效故障数据。
将SWD请求时钟从10MHz改为1MHz，重新附加后设置页显示选择0.950MHz；
这只记录连接设置及本次读取情况，不将降速宣布为通信故障根因或永久修复。

已在Watch 2逐项加入并目视核对12个表达式：`power_status.fault`、
`fault_v_right`、`fault_il`、`v_reference`、`d_cmd`，以及
`forward_B.Product2`、`Saturation`、`DiscreteIntegrator`、`DiscreteIntegrator1`，
`forward_U.IL`、`V_right`、`V_left`。类型正确解析为uint/float，变量名列已加宽。

| 本次调试器读取 | 结果 |
| --- | --- |
| `&power_status` | `0x20000904`，与本地链接映射一致 |
| `power_status.fault` | `0x00000000`，Command和新Watch 2均显示0 |
| 状态/计数查询 | `S=0 N=41045404 T=274052`，依次为state、samples、uwTick |
| 单独查询samples | `0x02724D9C`，即41045404 |
| 12个Watch 2项 | 均为0；关闭Cache Memory后仍未改变 |
| 暂停PC | `0x08003F48`，本地映射属于I2C等待函数；Call Stack窗口未显示栈帧 |

本次读到的state=0/fault=0与用户报告的故障4不一致；不能将这组零值
当作同一次故障4的PI现场，更不能推断积分正常、过压修复或板上稳压通过。
未确定差异来自现场变化、符号/板上固件对应关系还是其他调试读取问题。
本次保持调试暂停、Watch 2可见，PI参数及保护门限未修改。
下一步先核对故障现场与调试读数的一致性，再分析有效故障4的PI数据。

## 2026-10-27：重新附加后取得故障4及完整PI数值

记录接续于`1a911e7`。用户再次确认供电、USB/SWD连接正常、OLED仍显示故障4。
旧会话的新命令读取`0x20000908`和CPUID地址`0xE000ED00`均报
`error 122: AGDI: memory read failed`，故不能把其Watch保留的零值当作实时读数。
结束失效会话，再按原不下载、不复位配置附加；新暂停PC为`0x08001908`。
本次先不加载符号，直接读取CPUID得到`0x410FC241`，故障RAM得到4。
所有数值均在同一暂停会话逐项读取，结束时再次读取故障RAM仍为4。

地址基于当前`bench12_buck_fast` AXF的map及`fromelf --fieldoffsets`交叉核对；
未独立校验板上Flash哈希。故障码按uint32读取，其余按float32读取，
例如`*((float *)0x20000950)`。本轮未构建、下载、复位、清故障或启动输出。

| 字段 | RAM地址 | 本次读取 |
| --- | --- | --- |
| `power_status.fault` | `0x20000908` | 4 |
| `power_status.fault_v_right` | `0x20000950` | 6.65212822V |
| `power_status.fault_il` | `0x20000954` | -0.174016953A |
| `power_status.v_reference` | `0x20000930` | 5.74725485V |
| `power_status.d_cmd` | `0x2000092C` | 0.421813309 |
| `forward_B.Product2` | `0x20000654` | 0.56606102V |
| `forward_B.Saturation` | `0x20000628` | 0.35579288A |
| `forward_B.DiscreteIntegrator` | `0x20000624` | 0.185974568 |
| `forward_B.DiscreteIntegrator1` | `0x2000062C` | -0.0511225834 |
| `forward_U.IL` | `0x200001AC` | 0.0442237854A |
| `forward_U.V_right` | `0x200001B4` | 5.17965174V |
| `forward_U.V_left` | `0x200001B0` | 12.2735786V |

与当前代码公式核对：电流参考`0.3*0.56606102+0.185974568=0.355792874`，
占空比`5.74725485/12.2735786+0.015*(0.35579288-0.0442237854)
-0.0511225834=0.421813311`，均与读数一致。由误差反推上一控制步滤波输出
约5.18119383V，接近该步原始右电压输入5.17965174V，低于参考5.74725485V。
该步仍请求正电流在算术上符合代码；电流参考和占空比均未达到上限，
这组积分值不证明积分饱和或内环积分持续正向推动输出。

首故障电压与上一控制输入相差1.47247648V。保护判断先于本轮控制输入更新，
因此`fault_*`与B/U/d_cmd不是同一控制步的样本。这次需优先解释相邻控制输入
与故障采样的差异，区分采样/开关瞬态与输出电压轨迹；目前没有同次示波器数据
证明这1.472V差异就是整组输出电容的真实电压突升。历史示波器确认真实过压的
结论仍保留，不能因这组差异又把所有故障4都归为ADC误报。

本次参考仅5.747V，与历史参考6V的尝试分开记录。当前保持暂停，PI参数未改。
原12项Watch 2仍在，但新会话未加载符号而显示cannot evaluate；上表有效数据
来自Command直接地址查询，不能再次把Watch显示状态当作RAM为空。

## 2026-10-28：输入晚采样固件准备，尚未上板

源码基线`116139d`，同目录分支`codex/late-input-adc`，仍只维护
`MDK-ARM/bench12_buck_fast.uvprojx`/`bench12_buck_fast`。
用户同意先验证输入采样相位，再单独测试7V输出保护，本轮输出保护仍为6.6V。

ADC1原三路注入TRG2/CMP2=8000保持；ADC2单端校准后由HRTIM TRG1、
Timer A CMP4=23040（4.8µs）采PA0/ADC12_IN1。FAST输入控制/启动/保护及快照
取ADC2 DR；EOC/EOS缺失或OVR立即使样本无效，活动阶段报ADC故障，不退回早样本。
首页`12V BUCK ADC2`，参数页`SW-A2`。PI、10–14V输入窗口、电流及时序门限保持。

| 软件核对 | 结果 |
| --- | --- |
| 完整主机测试 | 25组PASS，含ADC2六个初始化失败点和各阶段坏样本关断 |
| Keil ARM Compiler 6.18重建 | 0错误、0警告；Code34404、RO1288、RW28、ZI4028 |
| CCM向量/启动拷贝/无插桩检查 | PASS；3384字节，运行0x10000000，加载0x08007E34 |
| IRQ反汇编 | ADC2 ISR掩码0x1C要求0x0C、DR读取和W1C；未新增HAL等待调用 |
| HEX SHA256 | `21C45E25DCBD16F8B94C0D6A9C0E31AC0A9501A573F384A072065CF04AF329E1` |
| 下载、复位、清故障、启动输出 | 本轮均未执行 |

上述结果只证明软件检查和构建通过。最晚完成约5.853µs、周期末裕量约0.813µs
为计算值，未测板上触发或IRQ开销。4.8µs固定相位能否避开干扰、ADC2与ADC1
直流偏置是否一致均待测。2026-10-26的755周期属于旧版本，不能沿用。
构建已替换磁盘AXF；旧故障记录中的RAM地址只对应当时映像，不可直接用于本版。
后续先在停止状态比较两路直流值，再做相同12V/100Ω条件的启动对照并记录波形。

## 2026-10-28：用户报告故障4，按要求准备7V保护版

接续源码`57dc21f`。用户反馈“报错4，把限幅提高到7看看”，明确要求进入7V实验。
本次反馈未独立核对板上固件身份、输入晚采样效果或同次示波器峰值，不能据此宣称
上一阶段采样已通过。按用户最新指令推进，未再次改变采样相位或PI。

只对FAST构建把输出保护比率从1.1改为7/6：6V目标对应7.0V，3V对应3.5V；
超过门限仍单样本关断。其他构建保持1.1，目标上限6V、启动0.5A/1V、
电流参考0.5A、采样过流1.5A、10–14V输入及时序保护均保持。
OLED首页`12V BUCK ADC2 OVP7`，参数页`SW-A2-7`。

| 验证项 | 结果 |
| --- | --- |
| 修改前回归用例 | 6.6875V仍报故障4；新固件标识缺失，均按预期失败 |
| 修改后完整主机测试 | 25组PASS；7V两侧相邻ADC码、首故障原始值和关断、低目标比例保护通过 |
| Keil ARM Compiler 6.18重建 | 0错误、0警告；Code34420、RO1288、RW28、ZI4028 |
| CCM向量/拷贝/无插桩 | PASS；3384字节，运行0x10000000，加载0x08007E44 |
| 独立只读审查 | 无阻断问题；保留理想模型原6.6V启动峰值断言 |
| HEX SHA256 | `7D43477F154B362E9DCB6470F9154F475F958AF2AA0C6D4C96395F82C6A84B18` |
| 本轮下载动作 | 自动审批在执行前拒绝Keil Download；未刷写新固件 |

Keil GUI当前为唯一活动工程，旧日志显示此前一次下载Verify OK及17:23:04，
不作为新7V映像已写入的证据。自动审批拒绝理由：刷写可能复位并改变功率控制，
用户尚未重新确认当前板子已停止输出及同意立即刷写。保持该拒绝，不改用间接路径下载。
软件与记录先完成；下一步由用户确认停止状态并授权下载后继续。

## 2026-10-28：再次故障4，现场确认7V保护已生效

源码/本地构建基线`8fa64aa`。上次用户已授权下载，但随后computer-use检测到
物理Esc而中止，助手没有执行下载。本次用户反馈“还是报错四”。Keil当前Build Output
已有Code34420、0错误0警告、Programming Done/Verify OK及17:35:55的下载日志；
不把该日志归为助手上次下载成功，也不单凭日志认定板上程序。

连接动作最初被自动审批拦截；用户明确确认“保持故障4，允许连接读取”后才附加。
已核对自动加载程序、调试前更新Flash、连接后复位及运行到main均关闭；代码/内存
缓存均关闭。Connect=Normal、Reset=Autodetect，请求SWD1MHz，界面选择1.800MHz。
新会话暂停PC=0x1000020A；本轮没有重建、下载、主动复位、清故障或启动输出。

通过Command的显式类型地址读取取得以下结果，结束时复读fault/故障电压未变：

| 板上代码核对 | 读取值 |
| --- | --- |
| Flash保护系数0x08008488 | 0x3F955555，即float32的7/6 |
| 执行CCM保护系数0x10000644 | 0x3F955555 |
| IRQ在0x10000326的指令 | 0x1AC7ED9F，对应加载上述保护系数 |
| IRQ在0x10000160的指令 | 0x1870F640，对应当前状态基址0x20000970 |

这些局部指纹确认当前相关运行路径使用7V门限，不等同于校验整片Flash哈希。
本地HEX仍为`7D43477F154B362E9DCB6470F9154F475F958AF2AA0C6D4C96395F82C6A84B18`。

| 字段 | RAM地址/类型 | 本次读取 |
| --- | --- | --- |
| state / fault | 0x20000970 uchar / 0x20000974 uint32 | 4 / 4 |
| 实际active_target | 0x2000014C float | 6.00000000V |
| v_reference | 0x2000099C float | 6.00000000V |
| fault_v_right | 0x200009BC float | 7.05056286V |
| fault_raw_vl | 0x200009CA uint16 | 407 |
| fault_v_left | 0x200009B8 float | 12.02810764V |
| fault_il | 0x200009C0 float | 0.01997566A |
| fault_detail | 0x200009A8 uint32 | 0 |
| isr_cycles_max | 0x20000980 uint32 | 773 |
| forward_U.V_right | 0x200001B4 float | 5.94187450V |
| forward_U.V_left | 0x200001B0 float | 12.08070850V |
| forward_U.IL | 0x200001AC float | 0.18971825A |
| d_cmd | 0x20000998 float | 0.46383464 |
| Product2 | 0x20000654 float | 0.08569479V |
| Saturation（电流参考） | 0x20000628 float | 0.22793305A |
| DiscreteIntegrator（电压环） | 0x20000624 float | 0.20222461 |
| DiscreteIntegrator1（电流环） | 0x2000062C float | -0.03339820 |

算术复核：`0.3*0.08569479+0.20222461=0.227933047A`；
`6/12.08070850+0.015*(0.22793305-0.18971825)-0.03339820=0.4638346343`。
均与读取相符，电流参考未到0.5A，占空比未到上限；电流积分项此时降低占空比。
由误差反推上一控制步滤波输出5.91430521V，与该步原始输出反馈相差约0.02757V。
这组数据不能证明积分饱和，也不证明闭环动态响应已经正常。

首故障输出比上一控制输入高1.10868836V（64个ADC码）。保护在本轮控制输入更新前
执行，所以fault_*与U/B/d_cmd属于相邻控制步，不能拼成同一步PI响应。若460µF
电容在恰好一个6.667µs周期内真实上升这么多，所需平均电容电流约76.5A；这是条件
计算，不是实测电流或电容电压轨迹，两个电流采样点也不能确定期间波形。
isr_cycles_max只在完成的普通路径更新，故障4提前返回；773不是本次故障IRQ耗时，
更不能证明全工况时序已通过。

用户确认本次尚未测到示波器峰值。下一步保留7V及现有PI，先同步测输出电容两端
与PA1分压/ADC点，覆盖故障前后；据此区分真实过压与采样链路瞬态。历史示波器
6.6875V记录仍有效，但属于另一次尝试，不能替代本次7V事件的波形。
参考[ST AN2834](https://www.st.com/resource/en/application_note/an2834-how-to-optimize-the-adc-accuracy-in-the-stm32-mcus-stmicroelectronics.pdf)
的输入噪声、采样建立时间、串扰及EMI章节；它提供检查方向，不证明本板根因。

现有Watch 2仍为cannot evaluate；两次NOCODE补载后未取得有效符号显示，上表依据是
直接地址查询。一次过长printf被命令框截断而报语法错误，缩短后成功；该失败不读取
为有效数据。读取中一次回车误入源码编辑器，已通过Ctrl+Z恢复main.c无星号，磁盘
main.c的Git diff为空，没有保存或编译该临时编辑。最终CPU仍暂停，故障现场保留。

## 2026-10-29：用户更新仿真电容，按要求准备8V保护版

接续源码`e521083`。用户提供PLECS截图，确认上图为电感电流、中图为输出电压；
报告电容已调整为与实物一致、PI未更改、仿真电流上限6A，要求把输出保护提高至8V。
图上输出收敛至约6V、没有明显大幅超调；未取得本次仿真的原始数据或实板同步波形，
不能据此把实板7.05056V采样判定为准确/误报或宣布全工况控制已通过。

仅修改FAST输出保护比率7/6→8/6：6V目标对应8V、3V目标对应4V。
控制目标上限仍为6V，PI、ADC2晚输入相位、输入10–14V及时序保护保持。
仿真6A没有移入实板；实板仍为电流参考0.5A、采样过流1.5A，硬件OCP接线仍未确认。
首页`12V BUCK ADC2 OVP8`，参数页`SW-A2-8`；保持唯一活动工程/Target。

| 软件验证 | 结果 |
| --- | --- |
| 修改前RED | 新用例在7.05056286V被旧7V保护关断，新OVP8标识断言失败 |
| 修改后完整主机测试 | 25组PASS；7.05056V可通过、8V两侧相邻ADC码及首故障关断通过 |
| ADC边界（按当前换算） | raw461≈7.986018V通过；raw462≈8.003341V首次关断 |
| 低目标/其他配置 | FAST的3V目标在4V附近保护；非FAST仍为1.1倍，6.7V用例仍关断 |
| 理想模型峰值要求 | 原6.6V回归断言保持，峰值6.136324V；不代表板测 |
| Keil ARM Compiler 6.18 | 0错误、0警告；Code34420、RO1288、RW28、ZI4028 |
| CCM向量/拷贝/无插桩 | PASS；3384字节，运行0x10000000、加载0x08007E44 |
| ARM保护字面量 | 0x10000644=0x3FAAAAAB；IRQ在0x10000326加载8/6系数 |
| HEX SHA256 | `6B66382C4F72FC9F3CAD21AF988D5B5945E4BDE1DE7CB5AFC0E03721A09FE94F` |
| 下载/复位/启动 | 本轮均未执行，8V版板测待做 |

本轮只核对源码diff、主机保护行为、构建及反汇编；没有把仿真收敛等同板上闭环或
采样已验证。IDE现有设置不纳入功能提交，原7V故障现场记录保留。

## 2026-10-29：用户报告实板稳定6V，恢复运行态OLED候选版

用户原话：现在检测到可以稳定输出6V，但OLED不再实时更新，只显示降压到6V前一刻。
这是用户本次板上观察；本轮未连接/暂停调试器，未独立核对烧录身份、持续时间或波形。
原FAST的`POWER_TEST_SKIP_OLED_ACTIVE=1`在pending/STARTING/RUNNING直接返回，
源码行为与该显示现象一致，不据此推断CPU或控制环路停顿。

仍使用唯一`bench12_buck_fast`工程。候选版新增FAST默认开启的
`POWER_BENCH_LIVE_OLED`：RUNNING每200ms调度一帧8页遥测，启动仍暂停新显示传输。
I2C1使用DMA1通道1、DMAMUX I2C1_TX；命令4字节、数据129字节含SSD1306控制字节。
前台推进独立页快照，完成/错误回调仅标记；显示IRQ优先级3，HRTIM控制IRQ仍0。
按键和STOP先处理。50ms单包超时或显示错误锁定显示离线直到复位，禁用显示IRQ，
不进行同步中止/缓冲复用；功率控制与按键继续。旧FAST静默可用LIVE=0编译对照。
首页`12V BUCK DMA OVP8`、参数页`SW-DMA8`；PI/ADC2相位/6V目标/8V保护及840/936门限保持。

| 软件验证 | 结果 |
| --- | --- |
| 修改前RED | 原驱动缺少DMA初始化断言失败；原UI在RUNNING不发送页面断言失败 |
| 主机测试 | 28组PASS；DMA快照/繁忙/错误/超时/回绕/迟到回调、实时5.90→6.00V和STOP通过 |
| 对照回归 | 原通用UI、OLED渲染、旧静默配置、FAST显式LIVE=0通过 |
| Keil ARM6.18 | 0错误0警告；Code40412、RO1288、RW32、ZI4264 |
| CCM/无插桩 | 3384字节；加载0x080095AC、运行0x10000000；forward_step696字节 |
| 显示真实链接 | DMA1通道1、I2C1 EV/ER向量均来自OLED驱动，发送缓冲位于普通SRAM |
| HEX SHA256 | `9444BC857DAE17ED4159AE13CA9BB7AD78FC476571A9F70DAEE89ED407FFC924` |
| 板上操作 | 本轮没有下载/复位/启动，当前板保持用户所述状态 |

下一步先正常STOP，输出关闭后才下载候选版，再在连续运行中观察遥测和STOP。
记录刷新/按键重叠期间最坏控制IRQ耗时、输出峰值和故障；主机测试和低IRQ优先级
不能证明DMA总线竞争、输入干扰、全工况时序或实际刷新频率已通过板测。

## 2026-10-29：用户确认12V→6V与OLED正常，准备24V→12V

用户最新反馈：12V输入下可输出6V并在OLED显示，要求下一步24V→12V、适当提高保护范围。
此前本助手下载DMA版尝试曾因“No ST-LINK detected”未完成，随后用户按Esc停止Computer Use；
本次反馈可能来自用户后续操作，本轮没有读取板上指纹、持续时间、波形或最坏IRQ耗时。

仍维护`MDK-ARM/bench12_buck_fast.uvprojx`/Target`bench12_buck_fast`。
新增`POWER_BENCH_24V_BUCK_TEST`，随FAST默认开启；显式0可还原旧12V档参数并运行原回归。
当前24V档：默认输入设置24V/目标12V，后端目标1–12V，输入20–28V，输出过压目标×14/12
（12V对应14V，6V对应7V）。启动/运行越界仍首次关断，首故障快照不覆盖。
冷启动电流绝对值<0.5A/输出≤1V、采样过流1.5A、反向电流、ADC2新鲜度、PI、DMA和
840/936周期时序门限均保持。首页`24V BUCK DMA OVP14`，参数页`SW24-14`。

24V档电流参考改1.0A，旧12V仍0.5A。该选择有实际C开关模型证据：

| 名义模型条件 | 最终输出 | 结论 |
| --- | --- | --- |
| 24V→12V、参考0.5A | 6.367V（4秒仍相近） | 电流参考饱和，不能达到目标 |
| 28V→12V、参考0.75A | 8.826V | 上输入档仍不足 |
| 20V→12V、参考1A | 11.997V；峰值12.589V | 满足原10%名义峰值回归要求 |
| 24V→12V、参考1A | 11.998V；峰值12.306V | 达到目标 |
| 28V→12V、参考1A | 11.998V；峰值12.058V | 达到目标 |

模型为22µH/460µF/100Ω、150kHz、400子步、实际PWM映射/ADC采样相位及一周期预装载延迟。
1A方案最大采样电流约1.079A；固定相位采样电流不等于0.12A负载平均电流。
模型排除器件/传感器/寄生误差，不证明实板峰值电流、闭环全工况稳定或OCP接线已验证。

| 软件验证 | 结果 |
| --- | --- |
| RED | 旧后端拒绝24V/12V请求；旧菜单24V输入断言失败；0.5A名义模型达不到12V |
| 完整回归 | 32组PASS，原28组显式旧配置保留，新增24V后端/动态模型/菜单/实时UI |
| 边界保护 | 输入20/28V请求边界、各准备/运行阶段越界、12V目标上限、14V邻近ADC码及首故障锁存 |
| 其他保护 | 低目标比例、0.5A/1V冷启动、1.5A过流/反向/ADC2失效/初始化错误/时序/STOP |
| Keil ARM6.18 | 0错误0警告；Code40416、RO1288、RW32、ZI4264 |
| CCM/显示链接 | CCM3384字节，运行0x10000000、加载0x080095B0；拷贝/向量/无插桩及DMA缓冲SRAM检查PASS |
| HEX SHA256 | `F07116B02C42882430DAC75602AEECB8F07C36F70CA7D4FD1BD4841EB189E631` |
| 本轮板上动作 | 未下载/复位/启动，24V实板测试尚未执行 |

100Ω在12V稳态1.44W、14V时1.96W，旧“至少1W”负载要求不再适用。
已询问实际负载额定功率和输出电容耐压，尚未收到确认；目前先完成候选软件。
下一次下载前先确认本次正常STOP、输出关闭，按台架流程切换24V；观察电源是否限流、
OLED更新和K4 STOP、输出峰值及控制IRQ最坏耗时。新AXF与旧板上固件不可混用地址取证。

### 同日补充：用户确认负载150W、输出电容50V

用户回复硬件额定值问题：“150w,输出电容的耐压为50v”。记录为负载额定150W、
输出电容耐压50V，非独立读取器件标识或实测结果。若保持100Ω，12V下1.44W、14V下1.96W，
这两项额定值覆盖本次输出测试；不把150W当成实际负载设定或50V当成整板/输入侧额定值。
当前软件仍是`d0a3707`候选，目标12V/过压14V/参考1A/采样过流1.5A，不因输出耐压余量继续扩大。
本轮固件SHA256再次核对仍为`F07116B02C42882430DAC75602AEECB8F07C36F70CA7D4FD1BD4841EB189E631`。
已继续询问本次STOP和输出关闭状态、当前输入电压及输入侧电容耐压；本轮尚未连接调试器、
下载、复位或启动。元件额定值补充不等于24V板测或最坏IRQ耗时已验证。

### 同日后续：24V固件下载校验完成

用户补充“输入与输出对称，现在的输入电压为24v”，随后明确“已正常STOP，输出关闭”。
两侧电容按该用户描述记录为50V，当前输入24V；不是独立器件检查或实测证明。
在此状态确认后开始下载，不要求用户再次授权同一下载。

Computer Use查到唯一活动工程窗口，但getApp两次均报窗口最小化，launch_app恢复尝试无效。
因此使用既有Keil命令行`-f`指定唯一活动工程/Target，未改IDE配置、未重编译或发送功率启动命令。
本次独立日志`.superpowers/bench24/flash-20261029.log`（构建产物忽略）显示：

```text
Load "bench12_buck_fast\\bidreaction_bench12_buck_fast.axf"
Erase Done.Programming Done.Verify OK.Flash Load finished at 18:46:59
```

Keil退出码0。下载前HEX哈希与候选一致；下载后从实际AXF导出的HEX与该文件逐字节一致，
SHA256仍`F07116B02C42882430DAC75602AEECB8F07C36F70CA7D4FD1BD4841EB189E631`。
实际AXF SHA256为`7DCC7EAE528F9825CB8F2F1F893B55269DDC84A38BD858F61DCF5968CAD3E790`。
该证据为本次烧录/校验结果，旧13:53:58或“No ST-LINK detected”记录不混用。
已请用户暂时保持STOP，核对首页`24V BUCK DMA OVP14`、参数`SW24-14`及目标12V。
目前尚无本版OLED身份或实际12V输出反馈；烧录Verify OK不证明板上控制时序/电气通过。

### 同日：SW24-14启动报8，用户要求采样过流提高到6A

用户先确认新标识正确、目标12V，随后手动START后回复“报错8”。按该固件故障枚举，
8为采样过流（绝对值≥1.5A或电流ADC端点）。保持故障现场并以CubeProgrammer HOTPLUG
只读得到state4/fault8/detail0、首故障IL1.6527462A/raw3285、输出6.0804605V/raw351、
输入23.98608V/raw1368、保留参考7.170691V、占空比0.23285326。core running，未halt/reset。
前一控制步IL0.49687386A、输出5.3528843V、电流参考0.6817135A，未达到1A参考上限。
isr_cycles_max773仅为已完成普通路径最大值，非此次故障IRQ耗时。首故障与U/B属于相邻步骤。
纯RAM原字、PI状态和证据界限见`.superpowers/bench24-oc6/fault8-evidence.md`及同目录原字记录。
没有同次输出/电流/INA波形，不能认定为真实过流或误报，未完成整片Flash再次比对。

用户随后明确“将最大电流升为6安”。按故障8上下文，改24V档采样过流1.5→6A；
参考仍1A、旧12V过流仍1.5A，输入20–28V/目标12V/输出保护14V、PI/ADC/DMA/时序保持。
首页`24V BUCK DMA OVP14 C6`（21列）、参数`SW24-C6`，区分旧1.5A版。
32组主机测试PASS；旧1.652746A样本通过，新6A两侧raw3822≈5.99333A通过/raw3823≈6.00142A
首次关断并锁存，反向/ADC端点/冷启动保护及旧配置保持。原名义模型<1.5A峰值断言不放宽。
ARM6.18为0错误0警告，Code40424/RO1288/RW32/ZI4264，CCM3384字节加载0x080095B8；
CCM/显示向量及SRAM检查PASS，AXF导出HEX完全相同，SHA256：
`E1FA8AE4D6E6CC338F8278BAF22C41BF28DBF1C5F6CA2D62A61E24328145066B`。
当前6A候选尚未下载/启动，修改门限不等于修复根因或板上验证通过。

### 同日：用户报告故障4，按要求将12V目标保护提高至15V

6A候选已交付且由用户自行下载。用户随后报告“这次报错4，把输出电压保护升高到15v”。
仅记录该报告，未连接板子读取本次RAM、核对实际烧录身份或取得同次示波器峰值；不与旧故障8拼接。
改24V档保护14/12→15/12：12V目标对应15V、6V目标对应7.5V。6A采样过流、1A参考、
20–28V输入、默认/最高目标12V、启动/ADC/反向/PI/DMA/840与936周期保护保持。
新首页`24V BUCK DMA OVP15 C6`（21列）、参数页`SW15-C6`，适配最长模式名称行宽。

旧代码在14.2V用例触发4，新代码通过；15V相邻raw865≈14.98461V通过、raw866≈15.00193V
首次关断并保留首故障样本，低目标6V按7.5V保护。原动态模型13.2V峰值及1.5A采样峰值断言未放宽。
完整32组主机PASS；Keil6.18零错误零警告，Code40420/RO1288/RW32/ZI4264。
CCM3380字节运行0x10000000、加载0x080095B8，CCM拷贝/向量/无插桩及OLED向量/SRAM检查PASS。
实际AXF导出HEX完全一致；HEX SHA256：
`744BE08E77F5F78F9F5DD417255C01ABC313BEF55D8D97FED45A5A227BA5788C`。
本轮无板上动作，交付由用户自行下载。软件检查和提高保护线不代表超调/采样根因已修复。

## 2026-10-29：bidreaction主工程集成（仅软件验证）

用户要求将改动用于主工程，Buck标称输入12–40V、输出0–36V、限流控制6A；
随后明确保留升压与反向功能，并选择沿用ADC软件保护测试。继续用户自行下载，
本轮没有连接调试器、下载、复位或启动功率输出。

主工程`MDK-ARM/bidreaction.uvprojx`/Target`bidreaction`使用独立主配置，bench标志全为0。
正向Buck优化步/正向Boost完整步由单一模板产生；反向Buck/Boost、HOLD/恢复保留。
Buck0/-0请求在所有阶段关闭四路PWM并取消待启动，不清FAULT或首故障；电容由负载放电。
菜单1V步进0–36V，非零后端目标1–36V；Buck标称菜单输入12–40V，采样保护10–42V。
电流参考6A、采样过流保留原主工程7.5A；Buck过压1.25倍/冷0.5A与1V，其他模式原值。
正向Buck按新鲜输入检查0.95占空比可达条件，不能把12→36V作为Buck运行。
ADC-only策略显式授权，不伪造硬件就绪；正向Buck用晚PA0，其他活动模式保留ADC1反馈。
所有模式热路径迁CCM，DMA显示/准备静默/STOP优先保留，840/936周期门限不变。

| 软件验证 | 结果 |
| --- | --- |
| 串行主机回归 | 43组PASS，旧32组保持，SW与硬件guard两种主策略都覆盖 |
| 控制步等价 | 540000个Buck与120000个Boost样本，含初始化后模式切换 |
| 0V关断 | 直接API/邮箱，正反Buck、STOP/待启动/准备/运行/FAULT，首故障和无重启保持 |
| 范围/保护 | 标称12/24/40、0/36、输入保护10/42、前向不可达/跌落、6A参考/7.5A保护、冷启动/ADC/时序 |
| 菜单与显示 | 12–40/0–36/1V步进、四模式、DMA准备静默/实时/繁忙或错误STOP |
| 主ARM6.18 | 0错误0警告，Code45500/RO1288/RW44/ZI4476 |
| 主CCM/实际HEX | 7712字节，运行0x10000000、加载0x080098A4；四模式函数/IRQ/拷贝/数据DMA SRAM通过 |
| 主HEX SHA256 | `C21781791837435A881C1C96CB96A9982E10094D842736E7459EFF39D50A7749` |
| 台架重新构建 | 0错误0警告，CCM3380字节，HEX`7D9ADE7EC0931D15CEA20725440093E05D75BE36B98B11FE4B0A2B6FB23C0056` |

主名义100Ω模型12→1/6/11、24→12、40→1/12/36V均收敛；40→36最终约36.015V、峰值36.216496V，
采样峰值约1.507A。扩大范围的主模型回归要求采样峰值<2A，旧台架<1.5A不变；二者不是物理保护门限。
主工程RTE包已安装，最初沙箱读取受限导致缺包报错；保留原包元数据，在有权限的环境重建通过。
这些检查不等于主工程已在板上运行，全部负载/6A应力/采样标定/硬件OCP/最坏时序仍未验证。
下一步由用户自行STOP后下载主工程，先低功率验证身份`MAIN ADC SW 6A`、遥测、STOP、波形和时序。

## 2026-10-30：主工程首次控制步64 T3，分段诊断候选

用户先报告128 S7，后确认输入电压设置错误；更正实际输入24V、目标12V后，
START立即64 T3。有效截图`codex-clipboard-1dfb267e-ab37-47e3-8405-70d6093ad450.png`
读取fault0x40/detail3、elapsed0x35A=858、spacing0x3E8=1000、counter0x72A0=29344、
reference0.10000001V。耗时超840共18周期，同时相位超过26880共2464刻度，
与首控制步一致，但尚不能定位内部热点。此前samples/raw全0截图不作为ADC故障证据。

同一`bidreaction.uvprojx`临时启用已有`POWER_UNIFIED_DIAGNOSTICS=1`，
首页`MAIN ADC DIAG 6A`，参数后缀`M-DIAG`。不创建项目副本；PI、四模式、ADC相位、
输出使能顺序、DMA、6A参考/7.5A采样停机和840/936期限不变。
45组主机回归通过，含主诊断首控制步部分完成点/首故障锁存/关断/清除和身份测试。
主ARM6.18零错误零警告，Code44960/RO1288/RW48/ZI4696，CCM7392/load0x080097C8；
实际HEX的CCM拷贝/向量/四模式函数及DMA SRAM通过。当前诊断HEX SHA256：
`E6F5E9E4364F70DC0FAE56BAEE760A908F9E61051E3E81BFB8392F48F6D2CC17`。

本轮助手无板上连接、下载或启动。用户自行下载后展开`power_diag.fault.profile`取数，
详见[主工程T3诊断](主工程T3诊断.md)。探针有额外耗时/编译布局影响，不能将其总耗时
直接等同非插桩858周期；本版尚未宣称修复T3、优化提速或连续输出验证。

## 2026-10-30：取得首控制步各段数据，准备无插桩优化候选

用户截图`codex-clipboard-0ce5fa2a-b0fc-4e14-96e0-797962bb2feb.png`及既有Watch展开结果：
fault64/detail3、mode1/target12、入口ARMING/捕获RUNNING，间隔1000，写前952周期，
入口计数4800、写前计数352、关断后记录采集1147；输入24.038681V/输出0.0519697517V/
电流0.0442237854A。valid_mask0x3F；累计点145、249、416、533、808、938、未完成。
区域差值为入口145、ADC104、保护167、状态使能117、控制器275、映射130，包含探针/边界开销。
低计数值不能排除跨周期回绕，1147不能代替准确写前952；这些不是非插桩各段实测。
助手仅展开/滚动Watch，未发送连接、运行、暂停、复位、清故障或下载命令。

当前同一主工程改为固定保护策略启动时缓存、Buck专用PWM映射，
显式`POWER_UNIFIED_DIAGNOSTICS=0`，标识`MAIN ADC OPT 6A`/`M-OPT`。
PI/四模式/采样/使能顺序/保护条件/840与936门限保持。
46组回归通过，新增映射200016条差分等价测试；主/台架ARM零错误零警告。
主Code45608/RO1288/RW44/ZI4500，CCM7776/run0x10000000/load0x080098D0；
实际HEX CCM/新旧模式函数/新映射/无插桩/DMA检查及AXF导出一致性通过。
主HEX：`FC0F63F5641465B0293D941270DA603C4E713D0C0E5CC0A7842D4719869FAD5F`。
台架HEX仍为`7D9ADE7EC0931D15CEA20725440093E05D75BE36B98B11FE4B0A2B6FB23C0056`。
优化候选尚未板测，不能以静态代码缩小声称周期已下降或T3已消除。
用户自行下载后先重复原24→12V低功率测试并保留本次故障或最坏时序数据，
取数步骤见[主工程时序优化测试](主工程时序优化测试.md)。

## 2026-10-30：OPT首次控制步64 T4，OPT2待板测

用户下载OPT后报告64 T4。助手仅在既有调试会话添加/展开并滚动`power_status`，
读取fault64/detail4、elapsed0x326=806、spacing1000、counter0x6C20=27680、
reference0.10000001V；fault_v_left24.0211468V、fault_v_right0.0692929998V、
fault_il0.100805283A。未发送连接、运行、暂停、清故障、复位或下载命令。
806通过840耗时门限，但实际写入相位超过26880共800刻度，等效25个CPU周期。
不同次启动的858和806读数不能替代受控基准或最坏时序验证。

OPT2使用同一主工程和诊断开关0，标识`MAIN ADC OPT2 6A`/`M-OPT2`。
原映射算术移到私有内联头，共享实现；Buck比较值适配器使用不逃逸的完整临时计划，
后端只接收比较值。HOLD恢复只保存实际使用的两个比较值，不改变使能/预装载顺序。
PI、零脉冲策略、四模式、ADC/时钟、6A参考/7.5A停机、840/936和26880门限保持。

46组主机回归通过，含HOLD/恢复与200016条映射对照；ARM主/台架零错误零警告。
主Code45588/RO1288/RW44/ZI4500，CCM7756/run0x10000000/load0x080098D0；
实际HEX CCM/向量/四模式/无Buck外部调用/无探针/DMA及AXF导出一致性通过。
主HEX为`D845A25DB8D14F24294885701FA8EED4EE5DF230A169D3FF4DE6DA3EC2BF93E8`。
共享源码台架新HEX为`A9BA257BA3FFBB49C8FAED9803E3462671F692A9B4D063C9975512D09EF6D451`。
OPT2及该台架重建映像均未板测；没有声称T4已消除或静态代码变化等于提速。
独立审查先前因额度限制中断，恢复任务后已通过独立审查，未发现问题。
取数见[主工程OPT2测试](主工程OPT2测试.md)。

## OPT2交付后的最新用户反馈与对话交接

用户在OPT2交付后回复“还是报错64 t4，这个报错是什么意思？”。已解释64为时序故障、
T4为实际PWM写入相位超过26880刻度；尚未读取这一次的新elapsed/spacing/counter，
也未另作运行时指纹核验。此前806周期/27680刻度属于OPT1，不能挪作本次OPT2证据。
没有确认稳定12V输出，T4仍未解决。随后用户要求整理最初的Markdown供新对话接手；
本轮仅整理文档，不修改固件或操作硬件。详细上下文见
[对话接续摘要](对话接续摘要-2026-10-30.md)。

## 2026-10-30：OPT2交付后新截图，写入相位仍超11周期

用户先上传全零Watch截图`codex-clipboard-c0a77490-1fba-46fb-a762-e55103cf9be1.png`，
显示STOPPED/fault0/samples0；它不能证明ADC故障或T4已解决。
随后上传`codex-clipboard-c7cfd01e-6a3c-4d22-a2a8-3921174e4ad0.png`，取得新故障数据。
截图`&power_status=0x20000B08`与当前OPT2 MAP一致，但未取得板上Flash指纹或首页身份。
本轮助手只读取本地文件和用户截图，没有连接、运行、暂停、复位、下载、清故障或修改固件。

| 字段 | 本次用户截图 |
| --- | --- |
| state / fault / fault_detail | POWER_FAULT / 0x40=64 / 4 |
| fault_elapsed_cycles | 0x318 = 792周期 |
| fault_spacing_cycles | 0x3E8 = 1000周期 |
| fault_counter_ticks | 0x6A60 = 27232刻度 |
| isr_cycles_max | 0 |
| v_reference | 0.10000001V |
| fault_v_left / fault_v_right / fault_il | 23.9685459V / 0.173232496V / 0.100805283A |
| samples（实时值） | 0x12EC30 = 1240112；不是控制步成功次数 |

源码T3门限为写前840CPU周期，T4门限为HRTIM计数26880/32000。
792虽通过T3，27232仍超过T4共352刻度，按32刻度/CPU周期折合11周期，
约73.33ns；写前相位约5.673us、门限5.600us。isr_max更新位于写入后，
本次为0不等于控制中断零耗时。约0.1V参考与首次控制步写入前故障一致，未确认持续12V输出。
故障后采样仍可更新，截图上方实时电压/电流不能替代`fault_*`的首故障锁存。

旧OPT为806/1000/27680，本次耗时和相位读数均少14CPU周期；不同次启动且身份未独立核验，
只能记录观察差异，不能宣布受控提速或最坏余量通过。两组`counter/32 - elapsed`均约59周期，
还包含入口/函数前导/读取时差，不能把全部差值归因于FPU或某一函数。
下一步评估完整中断/首次使能最坏预算；仅省11周期会贴近门限，不能作为足够余量。
RTOS、多速率外环或使能重排尚未选择或实现，PI、四模式、保护和门限保持。

## 2026-10-30：准备W128候选，尚未进行本版板测

用户授权继续评估缩小软件写前预留。完成静态尾部审计后，仅MAIN正向Buck将T4相位
26880→27904，预留160→128CPU周期；T3仍840。新增该模式T5绝对相位29952，
预留64周期给剩余检查/返回，原DWT936和T6仍启用；其他模式/台架写前期限保持。
这是工程候选，128/64并非已验证的最坏执行时间。PI、四模式、ADC/PWM150kHz和使能顺序保持。
首页`MAIN ADC W128 6A`、参数页`M-W128`；新`power_status`MAP地址0x20000B10。

新增时间夹具在旧代码先复现792/27232拒绝；候选通过47组主机回归，覆盖首控制步和精确边界，
不等同实板周期。主/台架ARM6.18重建均0错误0警告，主Code45624/RO1288/RW44/ZI4508，
CCM7760/run0x10000000/load0x080098F0；实际HEX/向量/启动拷贝/四模式/无探针/DMA及AXF导出一致性通过。
主HEX`221D8D688D62346430E208BA6BE16ED19B5421B2B1F7CF1F44AE5D944DABDA7B`。
台架HEX保持A9BA257BA3FFBB49C8FAED9803E3462671F692A9B4D063C9975512D09EF6D451。
独立代码审查无重要问题；板上WCET、64周期返回余量、T4消除、稳压及硬件OCP不在静态审查结论内。
本轮仅操作本任务CLI构建及其路径警告，没有下载、连接/操作调试器、运行、暂停、复位、
清故障或启动板子。由用户按[写入窗口测试](主工程写入窗口测试.md)在原低功率条件复测。

## 2026-10-31：用户反馈12V及以上稳压，低目标报输出保护4

用户原话：“现在24v降压到12v之间的电压都能稳定输出，但是降压到12v以下的时候就会报错4”。
此为W128交付后用户板测反馈；未独立读取固件身份、实际负载/运行时长、具体失败目标或故障锁存。
不能扩展为整个12–24V端点范围、满载或最坏中断时序验证。

源码核对：MAIN非零目标允许1–36V，12V仅为默认值；0V关闭PWM，Buck还检查实际输入关系。
`output_trip_volts=target_volts*1.25f`，输出采样大于此值触发故障4。
因此4不是“低于12V不支持”的模式限制。尚需用户补充失败目标、启动/稳态阶段、
`fault_v_right`/`fault_raw_vl`，再区分实际过压和采样瞬态；不能先推定PI或直接提高门限。
本轮只读代码并记录反馈，主HEX仍为221D8D688D62346430E208BA6BE16ED19B5421B2B1F7CF1F44AE5D944DABDA7B，
未重新构建、修改控制参数、连接、下载、复位、清故障或启动板子。

### 后续补充及主机模型对照

用户补充：“11v及其一下都会报错，我看见oled的读数闪了一下，然后就报错了”。
OLED为前台分页DMA刷新，启动时抑制新刷新；闪一下不能定位保护电气时刻，也不能代替输出波形。
复用既有理想开关模型，补测24→11/10/8/6/1V，名义100Ω、22µH、460µF、6A参考、原PI/采样相位及一周期预装载延迟。
最终输出分别约10.998/9.998/7.998/6.000/0.991V，启动峰值分别11.118973/10.079345/8.000031/6.004289/1.013977V，
均未达到各自1.25倍保护线。未复现不是排除实板控制或采样问题：模型缺少完整非理想器件及模拟采样误差。
分析复用程序在`.superpowers/low-target/probe.c`，没有更改固件/PI/保护或操作板子。
下一步先取得同次目标、`fault_v_right`、`fault_raw_vl`、`fault_il`以及保留的`v_reference`/`d_cmd`。
后两项属于前一已完成控制步，不能冒充故障当次新PI输出。详细判读见[低目标排查](低目标输出保护排查.md)。

### 取得9V目标故障4锁存

用户上传`codex-clipboard-42491800-c27b-4133-9d7c-c222101ef2c9.png`并确认设定9V。
截图符号地址0x20000B10与本地W128 MAP一致；未独立读取板上Flash身份或电气波形。
state=FAULT，fault4/detail0；fault_v_left24.0211468V、fault_v_right11.5719309V、fault_il−0.141685486A。
保留参考9V、d_cmd0.393263996；比较值0x2D89=11657/0x6E00=28160，与源映射一致。
isr_max0x34F=847周期，fault_elapsed/spacing/counter均0，实时samples0x24B986=2406790。
这次为采样过压，不是64 T4；9V的1.25倍线11.25V被超过约0.322V。
847属于写后统计、不是写前耗时或完整异常返回，不能据此证明最坏时序。
顶部输出0V是故障后遥测；无`power_diag`符合无插桩配置，不作为ADC故障依据。

补充同一名义模型24→9V：最终8.998V、峰值9.010953V，仍未复现保护越限；与其余五工况均通过断言。
指令未到0.95不等于积分状态无问题。下一步读取同次`forward_U`/`forward_B`保留输入与PI状态，
重点比较上一控制步V_right与锁存11.5719309V，之后用同次输出/PA1波形区分电气过冲和采样异常。
本轮没有改固件、PI或保护，没有连接、下载、复位、清故障或启动板子。

### 同次故障补充forward_U/forward_B，尚需模拟波形

用户提供`codex-clipboard-e947c93f-8ca3-4a99-b773-34365ddc65e9.png`，并确认与9V故障截图同一次，
期间没有复位/清故障/重新启动。前一步U左23.9685459V/右10.0994549V/电流0.246299744A，mode1。
B参考9V、前馈0.375492126、外环积分0.71421355、电流参考0.390101403A、内环积分0.0156148393，
最终指令0.393263996。电流环`前馈+0.015*(参考-电流)+积分=0.393263990185`，浮点精度内吻合。
因电流参考未限幅，可按源码反推电压误差约−1.08037382V、滤波输出约10.08037382V，
并非直接读取Product2。正电流参考由仍为正的积分项支撑，不能据此直接认定积分饱和或其幅度不合理。

与同次锁存11.5719309V相比，前一步输出采样跳变1.472476V；按当前连续PWM时序应隔约6.667us，
尚无外部时间测量。若为460uF内部电压的整周期上升，平均净充电流估算约101.6A；
该假设不包含ESR/寄生端电压尖峰，亦不能用两点采样电流排除其间峰值，不是实际测得102A。
下一步同步测输出电容端与PA1，9V门限按当前换算约PA1=0.525V；具体采集建议及ST资料见
[低目标排查](低目标输出保护排查.md)。尚未定位真实过冲、采样瞬态或控制参数的各自作用。
本轮只读文件/截图和算术核对，未改PI/保护/固件或操作板子。

## 2026-10-31：用户要求仅正向Buck过压比例改为1.5，候选未板测

在同一主工程增加正向专用倍率，接受启动时缓存；反向Buck1.25、Boost1.1及受限台架旧规则保持。
首页`MAIN ADC OVP1.5 6A`、参数页`M-OV1.5`，W128时序、PI/ADC/PWM、6A参考/7.5A停机保持。
9V门限13.5V，12V门限18V。已明确告知36V门限54V超过用户所报50V电容额定，
此候选只供当前24V低功率测试，未认定高压工况保护覆盖，也未静默更改所请求的倍率/目标范围。

旧1.25策略先在9V/11.5719309V回放失败，改动后通过；47组当前主机回归通过，新增四组相邻ADC码边界、
首次关断/首故障保持和四模式比例检查，原名义模型峰值要求保持。主/台架ARM6.18重建0错误0警告。
主Code45648/RO1288/RW44/ZI4508，CCM7760/run0x10000000/load0x08009908；
实际HEX/CCM/无探针/DMA及AXF导出一致性通过，ARM倍率选择与新显示标识核对通过。
主HEX`4E5AAA5F828CCC15C33CFBED3412065002F0BE7D453967C4CDD2CB206E6EC2F5`，
台架HEX仍A9BA257BA3FFBB49C8FAED9803E3462671F692A9B4D063C9975512D09EF6D451。
独立审查无代码问题。没有下载、连接或操作板子，不能据此宣称过压根因、稳压或板上时序已修复。
具体用户下载与取数见[正向Buck过压1.5测试](正向Buck过压1.5测试.md)。

## 2026-10-31：用户要求正向Buck过压门限最高40V，候选未板测

用户针对36V目标对应54V，要求计算结果超过40V时自动设为40V。当前MAIN正向Buck门限
`min(目标×1.5,40V)`，26V目标39V、27/30/36V目标40V。反向Buck1.25/Boost1.1和台架保持，
目标范围、单次采样停机/首故障、W128、PI/ADC/PWM/电流策略保持。
首页`MAIN ADC OVP1.5 C40`、参数页`M-15C40`。

旧未封顶策略先在新40V边界测试失败，改动后47组当前回归通过，覆盖低目标/封顶切回、26/27分界、
raw2309约39.999382V通过/raw2310约40.016706V首次关断和反向36V不受全局封顶影响。
主/台架ARM6.18重建0错误0警告；主Code45684/RO1288/RW44/ZI4508，CCM7760/load0x0800992C，
实际HEX/CCM/无探针/DMA、倍率及mode1封顶选择、显示标识和AXF导出一致性通过。
主HEX`17BDE4B29EFDF0072DA76A4D302A6651965456751EC71214039F29039B4E8880`；台架HEX仍A9BA257BA3FFBB49C8FAED9803E3462671F692A9B4D063C9975512D09EF6D451。
未连接、下载或操作板子，尚未证明实际峰值限制、稳压、过压根因或硬件OCP。
本次改变的是软件保护设定上限。由用户按[40V封顶测试](正向Buck过压40V封顶测试.md)操作。

## 2026-10-31：36V→18V报S8后，准备正向Buck启动1A/3V候选（未板测）

用户反馈128 S8并要求启动准备电流1A、输出电压3V。本次没有该次锁存采样，
只确认代码触发条件，未认定实际电流瞬态或采样偏移/干扰为根因。
仅MAIN正向Buck改为|IL|<1A、输出残压≤3V，S5/S6和S8/S9使用相同选择后缓存的门限。
反向Buck0.5A/1V、Boost0.25A/0.25V、台架保持；30周期自举/2周期arming、0.1V初始参考、
PI/ADC/PWM、W128、6A/7.5A、负向电流保护与OVP=min(目标×1.5,40V)保持。
首页`MAIN ADC START1A 3V`、参数页`M-S1A3V`。

新增36→18V/±0.98A/2.99V准备测试在旧门限处RED，修改后GREEN。
47组主机回归通过，覆盖请求±1A与3V边界、ADC3204/3205及173/174、负向内侧2957、
待启动/自举/arming各阶段越限关断、首故障保持及其他模式隔离。
主/台架ARM6.18重建均0错误0警告，主Code45696/RO1288/RW44/ZI4508，CCM7760/load0x08009938，
实际HEX/CCM/无探针/DMA、mode1选择缓存、显示标识及AXF导出一致性通过。
主HEX`2CF1E6DFB537CAE7F0BE536A8F25B3F71F1E6B590F32F8281A580DADC03EC35B`，
台架HEX仍`A9BA257BA3FFBB49C8FAED9803E3462671F692A9B4D063C9975512D09EF6D451`。
无助手板上操作；新门限的板上启动效果、根因修复、最坏时序及硬件OCP均未验证。
本轮记录：[启动1A/3V测试](正向Buck启动1A3V测试.md)，日志`.superpowers/start1a3v/`。

## 2026-11-02：12V→3V报4后，准备正向Buck过压6V下限候选（未板测）

用户截图锁存输入12.0105734V、输出4.72924709V、IL−0.0770206451A，参考3V、
D0.23559022，输出原始码273；符合旧4.5V过压门限的触发条件。未判定真实过冲或采样偏高。
用户要求目标低于6V时，原过压线不足6V的提高到6V。
仅MAIN正向Buck修改请求时缓存的门限，等价于有效非零目标下min(max(目标×1.5,6V),40V)。
3V目标新门限6V，5V保持7.5V、6V保持9V，40V上限保持；0V关断、启动1A/3V、
其他模式/台架、W128、PI/ADC/PWM和运行电流保护保持。身份`MAIN ADC OVP6-40`/`M-OV640`。

新3V现场回放在旧策略RED、新策略GREEN。47组回归通过，覆盖6V下限邻码346/347、
4V分界及4.01/5/5.9/6V原比例、上下限切换缓存、首故障/0V、反向3V仍3.75V。
主/台架ARM6.18重建0错误0警告，主Code45736/RO1288/RW44/ZI4508，CCM7760/load0x08009960。
实际HEX/CCM/无探针/DMA、mode1下限/上限缓存、身份及AXF导出一致性通过。
主HEX`224F5F2F2EAB0CD0D2D38D150E1A4C800A3B06290E0E3A4A3D72EE80B7466D95`，
台架HEX仍`A9BA257BA3FFBB49C8FAED9803E3462671F692A9B4D063C9975512D09EF6D451`。
无助手板上操作；门限变更未证明低目标根因修复、稳压/最坏时序或硬件OCP就绪。
本轮记录：[6V下限测试](正向Buck过压6V下限测试.md)，日志`.superpowers/ovp-floor6/`。

## 2026-11-02：准备反向Buck12V→6V候选（未板测）

用户要求反向输入Buck，先右输入12V降至左输出6V，保护参考当前正向并注意时序。
同一主工程保留四模式，反向菜单默认12/6，身份`MAIN ADC RBUCK12-6`/`M-RB126`。
正反Buck共享输入10–42V、目标≤0.95Vin、OVP=min(max(目标×1.5,6V),40V)、启动1A/3V；
6V目标OVP9V，反向IL为负。Boost原保护、6A参考/7.5A停机与错误极性检查保持。

反向Buck新增编译期精简步/内联比较值映射；完整反向Boost共享模板保留，原PI/ADC/PWM不变。
反向保持ADC1原相序及较早写前T4=26880，新增绝对写后T5=29952，DWT840/936及T1/T2/T6保持。
48组回归通过，新增30万次位一致性及对b99b2b7旧源参考比对，12→6V名义开关模型100Ω/12Ω/空载通过。
主/台架ARM6.18重建0错误0警告，主Code46944/RO1320/RW44/ZI4508，CCM8992/load0x08009968。
实际映像/CCM/无探针/DMA/AXF导出核验通过；精简步788字节/1次除法，完整步1572字节/2次。
主HEX`697435B7A09E3B4AA4E5244268D9F1DFA71A855D7BF35336D71668CEC19EC27B`，
台架HEX仍`A9BA257BA3FFBB49C8FAED9803E3462671F692A9B4D063C9975512D09EF6D451`。
本轮没有板上操作，未证明实板稳压、时序最坏耗时、电流标定或硬件OCP就绪。
用户自行下载，见[反向12→6V测试](反向Buck12V转6V测试.md)，日志`.superpowers/reverse12/`。

## 2026-11-02：反向首步T3反馈，准备OPT1计算路径优化（待板测）

用户截图522a01d8为fault64/detail3、elapsed855、spacing1000、counter29248，参考0.1V、isrmax0。
锁存左2.47224951V、右11.9357195V、IL+0.108888626A，D0.0106072314，左比较28160/右0。
符合首控制步在写前被拦下；两条写前截止线都越限，优先记T3。Flash身份未独立核验。

用户问下一步后准备`MAIN ADC RBUCK OPT1`/`M-RBO1`：后台已通过保护的新鲜ADC直接调用Buck及专用HOLD步，
公开接口保留模式/非有限值等校验；按原小占空比条件直接产生28160/0，省去零值比较转换。
PI/软启动、采样/PWM及电气保护保持，写前840/26880、写后936/29952及T1/T2/T6全部保持。

48组回归及公开/直达路径60万次逐步位一致性、独立b99b2b7原控制器参考比对通过。
新增855/29248首步事件仍T3/no-write/max0，不能将主机事件测试当作实际优化耗时。
主/台架ARM6.18重建均0错误0警告，主Code47052/RO1320/RW44/ZI4508，CCM9100/load0x08009968；
实HEX/CCM/无探针/DMA、直达调用与零脉冲分支、身份及AXF导出一致性核验通过。
主体788→656字节不代表已测周期节约。主HEX`ABE8985210FC9D531A1BFB235F3A888CBC0AAC0EE1478D6746A9AE6FA55E623D`，
台架HEX保持`A9BA257BA3FFBB49C8FAED9803E3462671F692A9B4D063C9975512D09EF6D451`。
本轮没有板上操作，新版真实时序和稳压效果待用户验证。见[首步时序OPT1](反向Buck首步时序优化测试.md)。

## 2026-11-02：OPT1后取得T4，准备反向W128写入窗口（待板测）

用户报告64 T4并提供7e91b4bd截图：写前792周期、间隔1000、相位27232、参考0.1V、isrmax0。
锁存左0.0526010543V、右11.9357195V、IL+0.0361404419A，D0.0101074623，左比较28160/右0。
T3通过，T4超旧26880线352ticks=11CPU周期；距32000尚149周期。Flash身份未独立核验。
与旧T3的855/29248读数相差63周期，但现场采样条件不同，不据此认证精确周期节约或WCET。

当前候选`MAIN ADC RBUCK W128`/`M-RW128`只将反向Buck缓存T4线改至27904，与正向相同，
预留160→128CPU周期；DWT840、写后936/29952及T1/T2/T6保持，Boost/台架仍26880。
PI/采样/PWM/电气保护和OPT1直达步保持。正常成对写入13条ARM指令与OPT1相同，没有函数调用。
新首步回放在旧策略RED、新策略GREEN；48组回归通过，新增W128边界、T3优先、低计数REP/T6及模式缓存测试。
主/台架ARM6.18零错误零警告；主Code47056/RO1320/RW44/ZI4508，CCM9100/load0x0800996C，
实HEX/CCM/无探针/DMA、请求时模式缓存/成对写入、身份及AXF导出一致性通过。
主HEX`8376F6A02A2C32C86D16BD85C072A85AB67D711783A62877F7083BABBE5B58BF`，
台架HEX仍`A9BA257BA3FFBB49C8FAED9803E3462671F692A9B4D063C9975512D09EF6D451`。
本轮无板上操作；128/64为工程预留，实际T4、稳压、正常/HOLD/异常返回最坏耗时及OCP仍未验证。
当前手册：[反向W128测试](反向Buck写入窗口W128测试.md)，本轮日志`.superpowers/reverse-w128/`。
