meetyaothenstop/vscode/docs/反向Buck写入窗口W128测试.md

# 反向Buck W128写入窗口候选 — 2026-11-02

OPT1交付后，用户报告64 T4并提供7e91b4bd截图：写前792CPU周期、入口间隔1000、
相位27232，参考0.1V、isr_cycles_max0、D0.0101074623、左比较28160/右0。
锁存左0.0526010543V、右11.9357195V、IL+0.0361404419A。板上Flash身份未独立核对。
792≤840，T3已通过；27232比旧26880线晚352计数，即11CPU周期。
此点距32000更新边界尚149CPU周期。相较此前T3的855/29248，两项读数都相差63CPU周期；
这是两个独立现场，采样条件不同，不能据此认定严格同条件耗时节省或最坏耗时。

仍为`MDK-ARM/bidreaction.uvprojx`、Target`bidreaction`；HEX为
`MDK-ARM/bidreaction/bidreaction.hex`，用户自行下载。首页`MAIN ADC RBUCK W128`、参数页`M-RW128`。

| 检查 | MAIN反向Buck本次候选 |
| --- | --- |
| T3写前相对耗时 | 原840CPU周期 |
| T4写前相位 | 26880→27904，与正向相同；预留160→128CPU周期 |
| T5写后相对耗时/相位 | 原936CPU周期/29952，后者预留64CPU周期 |
| T1/T2/T6 | 原入口间隔/入口相位/待处理REP检查保持 |

只改变MAIN mode3请求接受时缓存的T4期限；正向、Boost和台架保持既有期限。
本次后移32CPU周期约213ns，没有改变硬件PWM周期或加速控制算法。
OPT1直达控制、PI/软启动、ADC相序、150kHz PWM/死区及全部电压/电流保护保持。
反向默认12→6V，仍输入10–42V、6V目标OVP9V、启动|IL|<1A/输出残压≤3V。

反汇编确认正常成对写入段与OPT1是相同13条ARM指令，无函数调用：阻止双计时器预装载转移，
写两个比较寄存器，再恢复转移，仍由下个共同边界装载。HOLD恢复有单独的低侧使能路径。
128周期须覆盖写前检查余段、成对写入和到写后检查的路径；64周期须覆盖余下检查/寄存器恢复/异常返回。
总线等待、FPU/异常返回及HOLD恢复尾部均未完成板上最坏耗时证明。T5能检测超期，不能倒退已发生的更新。

验证记录：

- 新792/27232首步测试先在旧26880线处RED，修改后GREEN并写入预期比较值。
- 48组完整回归通过，含600000次既有控制器位一致性；新增反向27904通过/27905拒绝且不写、
  T3优先、旧855/29248仍T3、29952通过/29953停机、DWT840/841及936/937、
  计数回绕至64但REP已挂起仍T6、模式切换恢复正确窗口、首故障不覆盖。
  合成寄存器时间只证明判据，不能证明真实ARM指令在预留内执行完。
- 主/台架ARM6.18重建0错误0警告。主Code47056/RO1320/RW44/ZI4508，CCM9100字节，
  运行0x10000000、加载0x0800996C，power_status0x20000B10。
  实HEX/CCM启动拷贝/向量/无探针/DMA核验通过，ARM确认仅Buck缓存27904、Boost26880，
  成对写入段与OPT1指令相同，首页立即数和参数身份核对通过，AXF导出HEX一致。
- 主HEX SHA256：`8376F6A02A2C32C86D16BD85C072A85AB67D711783A62877F7083BABBE5B58BF`。
  AXF SHA256：`8117E5E7C87858CB7A5A0EED26A862F92B29AC0B7CF290A761890D9A6EE15763`。
- 台架HEX仍`A9BA257BA3FFBB49C8FAED9803E3462671F692A9B4D063C9975512D09EF6D451`。
  本轮日志`.superpowers/reverse-w128/`，旧日志不作本轮依据。

用户下载新HEX并核对W128首页后，按右12V输入、左6V输出继续测试。
如再故障，保存同一次fault/detail、elapsed/spacing/counter、isr_cycles_max和fault电压/电流；
T4现在表示相位>27904，T5仍需区分相对耗时>936和绝对相位>29952，T6仍检查下一周期REP。
isr_cycles_max为写后检查点的最大值，不含全部IRQ返回尾部。
本轮没有板上操作；实际T4是否消除、稳压、尾部最坏时间及硬件OCP仍未验证。
