meetyaothenstop/vscode/docs/反向Buck首步时序优化测试.md

# 反向Buck首步时序OPT1候选 — 2026-11-02

本页记录3b77c22。用户随后取得792周期/27232相位的64 T4，新候选见
[反向W128写入窗口](反向Buck写入窗口W128测试.md)；以下标识和映像指纹为历史。

## 故障证据

用户在反向12V→6V候选后提供截图522a01d8：fault0x40=64、detail3，即T3。
这是用户板测反馈，板上Flash身份未独立核对。
写前耗时0x357=855CPU周期、入口间隔0x3E8=1000、写前相位0x7240=29248；
当前限制分别为840、正常周期1000及26880。两条写前条件都越限，代码优先锁存T3。
相对耗时超15周期约0.1µs；绝对相位超2368计数，相当于74CPU周期。
参考0.1V、isr_cycles_max0及左比较28160/右0符合首个控制步写前被拦下的特征。
isr_cycles_max仅在写后更新，0不代表控制函数未执行，也不代表测到了完整IRQ耗时。
锁存左输出2.47224951V、右输入11.9357195V、IL+0.108888626A；实时左2.805V等是关断后读数。

## 当前变更

工程`MDK-ARM/bidreaction.uvprojx`，Target`bidreaction`；HEX为
`MDK-ARM/bidreaction/bidreaction.hex`，由用户下载。首页`MAIN ADC RBUCK OPT1`、参数页`M-RBO1`。
反向菜单默认12V/6V及四模式保持。

1. 原反向Buck主体再次检查模式0/3/4、输入正值和三个浮点有限值，后台进入控制前已取得新鲜整数ADC、
   完成换算和输入/输出/电流及启动保护。本版由MAIN mode3后台直达专用步，省去公开接口分发和重复有限值检查。
2. `reverse_main_buck.h`是内部接口，要求已初始化mode3、输入为新鲜有限ADC值、右输入保护已通过。
   主体仍检查错误状态和mode3；公开`reverse_step()`仍拒绝非有限值、非正输入，mode0及Boost行为保持。
   HOLD有相同契约的专用入口，冻结电压积分并清理电流积分的行为不变。
3. 反向小占空比沿用原判断`0.85×command<0.04`，直接返回左28160、右0，省去零值的浮点到整数转换。
   有效范围、NaN/无穷/空指针拒绝及非零脉冲映射与通用函数一致。

PI/软启动、ADC相序/PWM/死区、6A参考/7.5A采样过流、错误极性及电压保护全部保持。
写前840CPU周期/T4相位26880、写后936/T5相位29952、T1/T2/T6保持。
本次没有通过放宽期限接受旧855/29248现场。

## 验证与指纹

- 48组完整回归通过。控制器公开/直达路径60万次位一致性，含Buck/Boost、重初始化、HOLD/恢复；
  另以独立b99b2b7原控制器源编译参考重复60万次比对，均通过。
- 公开接口NaN/±无穷、非正右输入和mode0行为与原实现一致；两方向映射200k+输入一致。
- 新增实际855/29248首控制步时序事件：仍T3，原始锁存数据保留、isrmax0、禁止写入；
  原26880/26881、29952/29953、840/841及936/937、T1/T2/T6和各类保护继续通过。
  这些事件只证明保护逻辑，不模拟实际ARM计算耗时。
- 主ARM6.18重建0错误0警告：Code47052/RO1320/RW44/ZI4508；CCM9100字节，
  运行0x10000000、加载0x08009968，power_status仍0x20000B10。
  Buck主体788→656字节，公开接口保留校验而体积增加；不能据此推算实板节省多少周期。
- 实际HEX/CCM启动拷贝/向量/无探针/DMA检查通过，新增HOLD入口也在CCM。
  ARM确认后台直接调用Buck主体/专用HOLD入口，小占空比分支跳过比较值转换；
  首页立即数解码和HEX参数身份核验通过，AXF导出HEX一致。
- 主HEX SHA256：`ABE8985210FC9D531A1BFB235F3A888CBC0AAC0EE1478D6746A9AE6FA55E623D`。
  AXF SHA256：`FB6FD994667402024E8BEA2F815BDFD13DEF0DA515A94A80D8A5203875149AE8`。
- 台架重建0错误0警告，HEX仍`A9BA257BA3FFBB49C8FAED9803E3462671F692A9B4D063C9975512D09EF6D451`。
  本轮日志`.superpowers/reverse-opt1/`，旧日志不作为本轮结果。

## 下一次板测

用户下载并核对OPT1首页后，选择reverse默认12V/6V，正常连续运行一次。
若仍报时序故障，保留同一次fault/detail、fault_elapsed_cycles、fault_spacing_cycles、
fault_counter_ticks、isr_cycles_max及fault电压/电流，使用本版AXF查看。
新的写前点需要同时满足840和26880，不能只因T3消失就认定时序通过。

本轮没有连接、下载、启动、复位或其他板上操作。实际耗时、首步能否通过、稳压及硬件OCP仍未验证。
