meetyaothenstop/vscode/docs/反向Buck12V转6V测试.md

# 主工程反向Buck12V→6V候选 — 2026-11-02

本页记录87fe1b5。用户随后给出该轮64 T3首步超时截图，新的OPT1身份和固件指纹见
[首步时序优化测试](反向Buck首步时序优化测试.md)。以下历史映像不作为当前版本。

按用户要求，先准备右侧12V输入、左侧6V输出的反向Buck，保护参照当前正向Buck，重点检查时序。
仍使用`MDK-ARM/bidreaction.uvprojx`、Target`bidreaction`；固件为
`MDK-ARM/bidreaction/bidreaction.hex`。保留正向Buck/Boost及反向Boost，不新建工程。
首页`MAIN ADC RBUCK12-6`、参数页`M-RB126`；反向菜单默认输入12V、输出6V。

## 控制与保护

| 项目 | 本版反向Buck |
| --- | --- |
| 功率方向 | 右侧Timer A/PA8、PA9输入；左侧Timer B/PA10、PA11输出 |
| 实际输入保护 | 右侧10–42V，启动及运行检查；目标≤实际输入×0.95 |
| 输出过压 | 左侧min(max(最终目标×1.5,6V),40V)；6V目标为9V |
| 冷启动条件 | 电流绝对值<1A，左输出残压≤3V；准备各阶段重新核对 |
| 电流方向与保护 | IL负值表示正常反向；参考幅值≤6A，采样绝对值≥7.5A停机 |
| 错误极性 | 原反向连续16次采样IL>+1A保护保持 |
| 关断 | 0V仍关闭四路输出；STOP/首故障锁存/硬件故障锁存保持 |

正反Buck现在共用上述输入/输出/冷启动规则。正向数值不变，Boost仍输入6–40V、输出目标×1.1、
冷启动0.25A/0.25V。反向范围仍由主工程保留，当前交付先供12→6V验证，不宣称全范围实板通过。
3V是冷启动残压上限，软启动仍由0.1V开始，斜率及原反向PI参数保持。
30周期自举、2周期arming、PWM150kHz及死区保持；右侧源桥采用原零占空比策略，左侧保留自举刷新。

反向Buck使用共享模板生成的`reverse_main_buck_step`，省去Boost预充电、延时及多余滤波/斜坡状态。
`reverse_main_full_step`保留完整反向Boost路径；HOLD/恢复仍调用当前模式的控制步。
Buck比较值计算内联，保留原映射结果和无效值检查。Watch中Boost专用状态在Buck模式可能保持初值，
不能将其误认为Buck PI未运行。

## 时序与采样

- 反向Buck写前T4仍为计数26880，留160CPU周期；写前DWT840保持，未套用正向较晚的27904期限。
- 新增反向Buck写后绝对T5：29952，留64CPU周期；原相对DWT936及待处理REP的T6保持。
- T1入口间隔、T2入口相位保护保持。越限关断及首故障时间记录继续有效。
- 反向ADC1仍为IL/PA2、左输出/PA0、右输入/PA1的原触发相序；ADC2晚采样仍是PA0，
  不将它复用于反向右输入。反向启动/运行用新鲜ADC1样本，原ADC2失效隔离测试保持。
- 精简步/完整步、IRQ及相关热函数均在CCM。静态体积下降不能替代板上最坏耗时测量。

## 本轮主机及构建证据

- RED：旧反向完整步会更新Boost专用状态，旧0.5A/1V规则拒绝新准备样本；新实现GREEN。
- 48组完整回归通过。反向新步对完整步30万次逐步位一致，含Buck/Boost重初始化、HOLD/恢复；
  另与b99b2b7旧源编译的独立参考完成相同30万次比对。原正向及Boost回归保留。
- 两方向比较值内联路径对通用映射200k+输入一致，含零/最小脉冲、上界、NaN/无穷及空指针。
- 真实后端验证右输入10–42V、左输出9V边界（ADC513通过/514关断）、启动1A/3V、
  待启动/自举/arming越限、反向采样−7.5A边界、首故障、0V及调试邮箱5启动6V。
- 主机时序事件测试验证反向26880/26881、29952/29953、DWT840/841及936/937，
  T3/T4禁止超期写入，T5/T6写后关断，首故障不覆盖；其他模式原保护保持。
- 名义22µH/690µF开关模型（非实板）12→6V：100Ω输出5.999V、峰值0.579A；
  12Ω输出5.999V、峰值1.007A；1MΩ输出6.000V、峰值0.540A。均未触发模型内原电流/反向条件。
- 主ARM6.18重建0错误0警告：Code46944/RO1320/RW44/ZI4508；CCM8992字节，
  运行0x10000000、加载0x08009968，power_status0x20000B10。
  反向Buck788字节/1次浮点除法，完整步1572字节/2次浮点除法；原主工程实HEX检查及新CCM符号核验通过。
  ARM的mode3分支确认跳过通用比较值映射调用，参数身份及首页立即数存储解码核对，AXF导出HEX一致。
- 主HEX SHA256：`697435B7A09E3B4AA4E5244268D9F1DFA71A855D7BF35336D71668CEC19EC27B`。
  AXF SHA256：`8863965FDFFF51B46F76C1CE2700DD15C0D14A0D4889AB590B2C4827D821E59A`。
- 台架重建0错误0警告，HEX保持`A9BA257BA3FFBB49C8FAED9803E3462671F692A9B4D063C9975512D09EF6D451`。
  本轮日志`.superpowers/reverse12/`；旧日志不作为本轮依据。

## 用户下载及取数

由用户下载主HEX并核对新首页。进入reverse参数页，默认12V/6V，选择start启动。
右侧供电、左侧为输出；反向正常IL显示负值。调试邮箱方式需先设`power_target_volts=6`，再提交命令5。
若发生故障，保留同一次`power_status`全部`fault_*`、`isr_cycles_max`及固件身份；
尤其时序故障看锁存的elapsed/spacing/counter，避免将关断后实时采样当作触发现场。

本轮没有连接、下载、启动、复位、暂停或清故障等板上操作。主工程仍是已授权的ADC软件保护测试，
硬件OCP接线/就绪、电流增益、实际波形、稳压与IRQ最坏耗时均需实板验证。
