meetyaothenstop/vscode/docs/正向Buck过压6V下限测试.md

# 主工程正向Buck过压6V下限候选 — 2026-11-02

本页记录b99b2b7。当前反向Buck也已对齐此保护规则，固件身份和下载记录见
[反向12→6V测试](反向Buck12V转6V测试.md)；以下历史指纹不代表当前版本。

用户在12V→3V时取得故障4截图：fault_v_left12.0105734V、fault_v_right4.72924709V、
fault_il−0.0770206451A，参考3V，raw_vl0x111=273。旧门限3×1.5=4.5V，
软件触发条件吻合；不能仅凭此断定实际过冲或采样偏高。
用户明确要求：目标低于6V时，如果原过压门限低于6V，统一提高到6V。

仍使用`MDK-ARM/bidreaction.uvprojx`，Target`bidreaction`，
HEX为`MDK-ARM/bidreaction/bidreaction.hex`，由用户下载。
首页`MAIN ADC OVP6-40`，参数页`M-OV640`，诊断宏0。

仅MAIN正向Buck在接受启动请求时计算并缓存门限。有效非零目标下等价于：

```text
OVP = min(max(目标电压 × 1.5, 6V), 40V)
输出ADC换算值 > OVP：首次越限立即停机，锁存故障4
```

| 目标 | 过压门限 |
| --- | --- |
| 1V、2V、3V、4V | 6V |
| 4.01V | 6.015V |
| 5V | 7.5V |
| 5.9V | 8.85V |
| 6V | 9V |
| 9V | 13.5V |
| 27V、30V、36V | 40V |

0V仍为关断，不套用过压下限。启动|IL|<1A/输出残压≤3V、准备时长和0.1V初始参考保持。
反向Buck仍×1.25，Boost仍×1.1；台架规则和HEX保持。IRQ仍比较已缓存的门限，
没有新增IRQ计算；原6A参考/7.5A采样过流、负向电流保护、PI/ADC/PWM及W128保持。

验证记录：

- RED：3V目标回放4.729247V在旧策略触发4；新增下限后GREEN。
- 47组完整主机回归通过；真实后端覆盖1/2/3/3.999/4V同一6V门限，
  raw346约5.993844V通过、raw347约6.011167V关断；4.01/5/5.9/6V保持原比例。
  40V封顶、缓存由高目标切回低目标、0V及首故障保持均通过；反向3V仍在3.75V边界停机。
- 主ARM6.18重建0错误0警告：Code45736/RO1288/RW44/ZI4508，CCM7760字节、
  运行0x10000000、加载0x08009960，power_status0x20000B10。
  实际HEX/CCM启动拷贝/向量/四模式/无探针/DMA检查通过，AXF导出HEX一致。
  ARM确认mode1专用下限/上限选择及缓存，首页立即数存储解码和参数页HEX身份一致。
- 主HEX SHA256：`224F5F2F2EAB0CD0D2D38D150E1A4C800A3B06290E0E3A4A3D72EE80B7466D95`。
  AXF SHA256：`50008CDD8233D9265083468C0E7EF29F60083A7AE992514F9959B41AEF3F19F6`。
- 台架ARM6.18重建0错误0警告，Code40420/RO1288/RW32/ZI4264，CCM3376/load0x080095BC，
  HEX仍`A9BA257BA3FFBB49C8FAED9803E3462671F692A9B4D063C9975512D09EF6D451`。
- 本轮日志位于`.superpowers/ovp-floor6/`，旧测试日志不作本次证据。

本轮无板上连接、下载、运行或调试操作。门限调整不代表低目标输出过冲/采样根因已经修复，
主机测试及构建不能证明板上启动/稳压效果、最坏时序或硬件OCP就绪。
