meetyaothenstop/vscode/docs/正向Buck启动1A3V测试.md

# 主工程正向Buck启动1A/3V候选 — 2026-10-31

本页记录4f3dfe8版本。当前过压规则及固件身份见[6V下限记录](正向Buck过压6V下限测试.md)；
本页启动1A/3V条件保持，以下HEX和标识为历史。

用户报告36V输入、18V目标出现128 S8，明确要求将启动准备电流门限设为1A、输出电压门限设为3V。
这次没有取得该次故障的锁存电流/原始码，不能确定真实瞬态与采样偏移/干扰中的物理原因。

仍使用`MDK-ARM/bidreaction.uvprojx`，Target`bidreaction`；固件
`MDK-ARM/bidreaction/bidreaction.hex`，用户自行下载。
首页`MAIN ADC START1A 3V`、参数页`M-S1A3V`，诊断宏0。

| 范围 | 电流绝对值须低于 | 输出残压不高于 |
| --- | --- | --- |
| MAIN正向Buck（本次修改） | 1A | 3V |
| MAIN反向Buck | 0.5A | 1V |
| MAIN正/反Boost | 0.25A | 0.25V |

启动请求S5/S6及后续待启动、自举、上管开放前S8/S9复查使用相同门限。
电流恰好1A拒绝，输出恰好3V允许；一次新鲜采样越限仍停机并保留首故障。
3V是允许的输出残压上限，不是软启动起点。自举30周期约200µs、arming2周期、
正向Buck初始参考0.1V保持。运行6A参考/7.5A采样过流、负向电流保护、PI/ADC/PWM、
W128及OVP=min(目标×1.5,40V)保持。负向电流低于−1A仍会触发原有反向电流保护。
受限台架规则及HEX未变。

验证记录：

- RED：新增36→18V、±0.98A/2.99V准备阶段测试在旧门限处报128而拒绝请求；修改后GREEN。
- 完整47组当前主机回归通过；真实后端覆盖请求±1A严格边界、3V/3.001V边界，
  电流ADC3204/3205、负向内侧2957及输出ADC173/174邻码；pending、自举及arming各阶段S8/S9关断；
  首故障不被实时采样/前台刷新覆盖；切回反向/Boost恢复原有门限。原W128/OVP/四模式保护测试继续通过。
- 主ARM6.18重建0错误0警告：Code45696/RO1288/RW44/ZI4508；CCM7760字节，
  运行0x10000000、加载0x08009938；`power_status`0x20000B10。
- 实际HEX/CCM启动拷贝/向量/四模式/无探针/DMA检查通过，AXF导出HEX一致。
  ARM确认仅mode1选择1A/3V，并缓存用于IRQ；首页立即数存储及参数页HEX身份核对通过。
- 主HEX SHA256：`2CF1E6DFB537CAE7F0BE536A8F25B3F71F1E6B590F32F8281A580DADC03EC35B`。
  AXF SHA256：`DCAF0D37806E284FD336A29A0FA18294F702CB04B79C9B6F93429A9D24ABEA53`。
- 台架ARM6.18重建0错误0警告：Code40420/RO1288/RW32/ZI4264，CCM3376字节、加载0x080095BC。
  HEX仍为`A9BA257BA3FFBB49C8FAED9803E3462671F692A9B4D063C9975512D09EF6D451`。
- 本轮日志在`.superpowers/start1a3v/`，旧测试日志不作本次证据。

本轮无连接、下载、启动、复位、暂停或清故障等板上操作。主机和构建结果不能证明板上启动效果、
最坏时序或电气行为；硬件OCP接线/就绪仍未验证。放宽门限不代表S8物理根因已修复。
