meetyaothenstop/vscode/docs/正向Buck过压40V封顶测试.md

# 主工程正向Buck OVP1.5、40V封顶候选 — 2026-10-31

本页记录d795d11版本；当前启动门限及映像身份已更新，见[启动1A/3V记录](正向Buck启动1A3V测试.md)。
下述过压规则保持，历史HEX和标识不代表最新固件。

用户针对旧36V目标对应54V保护线，要求超过40V的保护门限自动设为40V。
范围是正向Buck过压保护设定，不改变菜单目标范围，也不宣称物理输出峰值被钳在40V。

工程`MDK-ARM/bidreaction.uvprojx`，Target`bidreaction`，HEX为
`MDK-ARM/bidreaction/bidreaction.hex`，由用户下载。
首页`MAIN ADC OVP1.5 C40`、参数页`M-15C40`，诊断宏0。

## 当前规则

```text
MAIN正向Buck过压线 = min(本次启动目标电压 * 1.5, 40.0V)
ADC输出换算值 > 过压线：首次采样立即停机并锁存故障4
```

| 目标电压 | 正向Buck过压线 |
| --- | --- |
| 9V | 13.5V |
| 12V | 18V |
| 24V | 36V |
| 26V | 39V |
| 27V、30V、36V | 40V |

门限在接受请求时缓存，软启动过程中沿用最终目标计算的门限。
反向Buck保持1.25倍（36V目标仍45V），Boost保持1.1倍，台架规则/HEX不变；40V上限仅作用于MAIN正向Buck。
0V关断、目标0–36V、实际输入关系、6A参考/7.5A采样停机、PI/软启动、ADC/PWM和W128保护策略保持。

## 本轮验证

- RED：旧未封顶策略在新40V边界处未停机；增加封顶后GREEN。
- 47组当前完整主机回归通过。真实后端覆盖低目标比例、26/27V分界、27/30/36V同一40V边界，
  raw2309约39.999382V通过，raw2310约40.016706V首次报4/四路关闭；首故障及0V请求保留。
  从封顶高目标切回9V恢复13.5V门限；反向36V目标允许44.5V并在45.1V报4，证明未误加全局40V上限。
- 主ARM6.18重建0错误0警告：Code45684/RO1288/RW44/ZI4508；CCM7760字节，
  运行0x10000000、加载0x0800992C。实际HEX/启动拷贝/向量/四模式/无外部Buck映射调用/无探针/DMA检查通过。
- 实际ARM确认先取倍率、比较40V并仅mode1选择封顶结果，缓存仍在DMB/start_pending之前；IRQ不增加门限运算。
  首页立即数存储解码及参数页HEX标识核对通过；AXF导出HEX完全一致。
- 主HEX SHA256：`17BDE4B29EFDF0072DA76A4D302A6651965456751EC71214039F29039B4E8880`。
  AXF：`3229196E72F776286E44CE7CF2183F393E3F038B2D2344C33304F5EBF936454D`。
- 台架重建0错误0警告，CCM3376字节，HEX仍
  `A9BA257BA3FFBB49C8FAED9803E3462671F692A9B4D063C9975512D09EF6D451`。
- 当前日志为`.superpowers/main-forward-ovp40/suite.log`及同目录main.log/bench.log，旧日志不作本轮证据。

## 用户测试及边界

保存原故障数据，保持输出关闭，由用户下载同一主HEX并核对新标识。先沿用当前24V低功率工况，
记录实际输出和OLED、运行时长及波形；采样和控制问题的原排查仍见[低目标分析](低目标输出保护排查.md)。
若再报4，保留同次`fault_v_right`/`fault_raw_vl`和控制状态，以当前目标对应的封顶门限分析。
新MAP中`power_status`仍为0x20000B10；使用本版AXF/MAP，不把旧故障当作新固件现场。
40V软件门限不能证明实际瞬时峰值≤40V、硬件OCP就绪或整板高压安全；仍须板测。
本轮没有连接、下载、启动、运行、暂停、复位或清故障等板上操作。
