meetyaothenstop/vscode/docs/正向Buck过压1.5测试.md

# 主工程正向Buck OVP1.5候选 — 2026-10-31

> 本文保留未封顶1.5版本历史。用户后续要求超过40V的门限自动设为40V，当前实现见
> [40V封顶测试](正向Buck过压40V封顶测试.md)；下文54V仅为旧策略记录。

用户明确要求“将正向buck的过压保护转为1.5”。沿用`MDK-ARM/bidreaction.uvprojx`，
Target`bidreaction`，下载文件`MDK-ARM/bidreaction/bidreaction.hex`，由用户操作下载。
首页`MAIN ADC OVP1.5 6A`、参数页`M-OV1.5`，诊断宏0。

## 规则及范围

| 模式 | 目标乘数 | 示例 |
| --- | --- | --- |
| MAIN正向Buck | 1.5 | 6V→9V、9V→13.5V、11V→16.5V、12V→18V |
| MAIN反向Buck | 原1.25 | 12V→15V |
| MAIN正/反Boost | 原1.1 | 36V→39.6V |
| 唯一受限台架 | 原规则 | 当前24V档12V→15V，实际HEX保持不变 |

只在接受启动时选择正向专用倍率并缓存输出停机电压，现有IRQ的严格`>`比较和单次采样关断不改。
0V关闭、冷启动、首故障保持、6A参考/7.5A采样停机、PI/软启动、四模式、ADC/PWM150kHz及W128时序保持。
正向Buck新常量独立于原共享Buck1.25常量，避免连带改变反向Buck。

**已知硬件限制：36V×1.5=54V，超过用户此前提供的50V电容额定。**
本轮按用户要求实现确切1.5比例，没有暗中加电压上限或删除原目标范围；54V边界只在主机寄存器夹具验证，
不代表板子可承受54V。本候选供当前24V低功率条件测试，不据此进入36V或其他高压验证。
当前硬件OCP仍未确认；这次倍率调整也不验证硬件保护、波形或最坏中断返回余量。

## 软件验证

- RED：旧1.25策略在9V目标、用户故障采样11.5719309V处触发4，与新要求不符。
  GREEN：同一真实后端回放在1.5策略下通过，门限为13.5V。
- 47组当前完整主机回归通过；新边界覆盖6/9/12/36V目标的相邻ADC码519/520、779/780、
  1039/1040、3117/3118。低码通过、高码首次触发4/关闭输出；后续遥测和0V请求不覆盖首故障。
- 四模式验证正向1.5、反向1.25、Boost1.1和模式重新初始化；台架旧规则保持。
  名义开关模型的1.25倍峰值断言保持独立，没有因放宽保护而放宽模型要求。
- 主ARM6.18重建0错误0警告：Code45648/RO1288/RW44/ZI4508，CCM7760字节，
  运行0x10000000、加载0x08009908。实际HEX启动拷贝/向量/四模式/无外部Buck映射调用/无探针/DMA检查通过。
- ARM确认mode1才选择1.5，mode3选择1.25、其他选择1.1；IRQ代码不新增倍率分支。
  首页被编译成立即数写入，已从实际ARM存储指令解码核对；参数标识存在于HEX，AXF导出HEX哈希完全一致。
- 主HEX SHA256：`4E5AAA5F828CCC15C33CFBED3412065002F0BE7D453967C4CDD2CB206E6EC2F5`。
  AXF：`7F29C66AC53DF30B4A34DE99E03F38F6B21064BCBFC32248A73F6702B7F5ED49`。
- 台架重建0错误0警告，CCM3376字节，HEX仍为
  `A9BA257BA3FFBB49C8FAED9803E3462671F692A9B4D063C9975512D09EF6D451`。
- 独立审查无代码问题；交付前文档中已补充作用范围、54V/50V限制和当前核验结果。
  当前47组证据在`.superpowers/main-forward-ovp15/suite.log`，不使用旧的`tests/main_forward_full_suite.log`。

## 用户测试

由用户保存旧9V故障数据、保持输出关闭后下载上述主HEX，并核对新首页/参数页。
沿用原24V输入、原低功率负载，先设置原9V目标；实接负载/电源限流以现场确认为准。
记录实际输出、OLED显示、运行时间及波形。旧11.5719309V样本低于新门限只说明保护放宽；
若实际输出持续明显高于9V，也不能算作稳压成功。
若再报4，保留`power_status.fault_v_right`/`fault_raw_vl`及`forward_U`/`forward_B`，
区分首次越限与后续遥测；当前MAP的`power_status`仍为0x20000B10，以新AXF/MAP为准。
原9V故障的采样跃变与PI状态分析保留在[低目标排查](低目标输出保护排查.md)，根因仍待模拟波形确认。

本轮没有连接、下载、运行、暂停、复位、清故障或启动板子，尚未验证新倍率的实板结果。
