meetyaothenstop/vscode/docs/主工程写入窗口测试.md

# 主工程W128写入窗口候选 — 2026-10-30

> 本文保留W128与正向1.25保护的历史。当前候选继承W128时序并按用户要求仅将正向Buck改为1.5，
> 见[正向Buck过压1.5测试](正向Buck过压1.5测试.md)。

工程`MDK-ARM/bidreaction.uvprojx`，Target`bidreaction`，
下载文件`MDK-ARM/bidreaction/bidreaction.hex`。用户自行下载。
首页`MAIN ADC W128 6A`，参数页`M-W128`，诊断宏0；不新增工程。

## 2026-10-31用户反馈（未独立取证）

用户报告24V输入、降至12V及其上方目标可稳定输出，目标低于12V时报故障4。
用户随后补充11V及以下均报4、OLED读数闪一下即保护；尚不能据此确认启动/稳态时刻。
后续截图取得用户确认9V目标的故障4，锁存输出11.5719309V>11.25V、保留参考9V，
写后统计最大847周期。负载/波形和板上Flash身份仍缺独立核验；模型及新现场见[低目标排查](低目标输出保护排查.md)。
12V只是默认输出；主工程非零请求允许1–36V，Buck仍须满足目标≤实际输入×0.95，0V为关断。
故障4来自输出采样>目标×1.25，例如10V目标对应12.5V、8V对应10V、6V对应7.5V。
下一步保留同次故障并取得目标、`fault_v_right`/`fault_raw_vl`，必要时同步抓输出和PA1采样点波形。
本轮只核对源码/文档，没有更改PI/保护或操作板子。不能把用户稳压反馈当作完整时序/全负载验证。

## 改变与依据

OPT2交付后用户截图为fault64/detail4、写前792周期、间隔1000、计数27232。
此时距硬件32000更新边界仍149CPU周期，但超过软件26880线11周期。
旧160周期预留没有对应的板上最坏尾部实测。反汇编显示正常尾部为内联成对寄存器写入，
没有额外函数调用，但仍有总线访问、d8-d9/r4-r11恢复及硬件异常返回，不能靠指令条数认证WCET。

| 检查 | MAIN正向Buck | MAIN Boost/反向、台架 |
| --- | --- | --- |
| T1 / T2入口 | 原1256CPU周期/8192刻度 | 保持 |
| T3写前DWT | 原840CPU周期 | 保持 |
| T4写前HRTIM相位 | 27904（5.813us），预留128CPU周期 | 原26880（5.600us），预留160周期 |
| T5收尾 | 原DWT936；新增HRTIM相位29952（6.240us） | 原DWT936；无新增更紧相位要求 |
| T6 | 下一周期REP已挂起即停机 | 保持 |

相比旧T4窗口后移32CPU周期，约213ns；这是减少预留，没有增加硬件周期或加速算法。
期限在接受启动请求时随模式缓存，启动发布前完成；不在每步选择模式常量。
过界仍四管关断并锁存首故障。成对禁止预装载传输/写比较值/恢复传输的顺序保持。
PI、软启动、ADC触发、PWM频率、四模式、6A参考/7.5A采样停机、硬件故障真实状态保持。
本候选未引入RTOS或多速率算法。

128周期要覆盖写前检查余下指令、成对写入和到收尾检查的路径；64周期要覆盖收尾检查之后
剩余代码、寄存器恢复和异常返回。两者是工程预留，尚没有板上最坏耗时证明。
新增T5是检测，并不能倒退已经发生的预装载更新；不能把其存在当作永不漏更新的保证。

## 本轮软件验证

- 旧代码先跑46组基线；新增真实后端时序测试在792/27232点先失败，候选后通过。
- 47组完整主机回归通过，时序夹具覆盖ARMING后的首控制步、写前27904通过/27905拒绝且不写比较值、
  写后29952通过/29953停机、T3优先、DWT T5/T6、模式2/3/4旧窗口及首故障不被遥测覆盖。
  合成寄存器时间只证明判据，不证明真实指令周期。
- 主ARM6.18重建0错误0警告：Code45624/RO1288/RW44/ZI4508；CCM7760字节，
  运行0x10000000、加载0x080098F0。向量/启动拷贝/四模式热路径/无Buck外部映射调用/
  无探针/DMA普通SRAM检查通过，AXF导出HEX与交付HEX哈希一致。
- 主HEX SHA256：`221D8D688D62346430E208BA6BE16ED19B5421B2B1F7CF1F44AE5D944DABDA7B`。
  AXF：`3D1DF47BD5573909C4E7085DDAC4002C61B32A54F9D428BB7FE251B9141F28E7`。
- 唯一受限台架重新构建0错误0警告，Code40420/RO1288/RW32/ZI4264，CCM3376字节。
  HEX保持`A9BA257BA3FFBB49C8FAED9803E3462671F692A9B4D063C9975512D09EF6D451`，CCM/DMA核验通过。
- 独立审查未发现Critical/Important问题；建议补充一个低计数回绕的T6专用用例，作为后续覆盖项。
  当前T6用例已有pending REP；源码/ARM仍在T5后读取黏性REP，不以计数小为无回绕证据。

最初CLI误用了D盘另一套UV4，阻塞在缺编译器/包路径提示；只结束本任务创建的该进程，
改用原C:\Keil_v5安装重建通过，未安装/升级包或修改工程包配置。

## 用户下载及板测

1. 保存旧故障截图，保持输出关闭。由用户下载上述主HEX，确认W128首页和M-W128参数页。
   若自行Rebuild，仍用ARM6.18和`POWER_UNIFIED_DIAGNOSTICS=0`。
2. 沿用原24V输入、12V目标的低功率条件，确认实际负载/电源限流后手动测试；不扩大工况。
3. 若保护停机，保留现场，不先复位/清故障/重新下载。展开`power_status`读取以下字段：

   ```text
   state、fault、fault_detail
   fault_elapsed_cycles、fault_spacing_cycles、fault_counter_ticks
   isr_cycles_max、v_reference
   fault_v_left、fault_v_right、fault_il
   ```

   新MAP中的`power_status`地址为0x20000B10；旧OPT2地址0x20000B08不可用于新固件。
   使用新AXF符号，后续构建仍以各自MAP为准。T4表示本模式计数>27904，T5可能是DWT>936
   或绝对计数>29952；看同次锁存值区分，T6仍是下一周期已挂起。
4. 若输出稳定，记录万用表/OLED输出和运行时长、`isr_cycles_max`。该最大值不含全部尾部，
   不能单独宣布中断完整返回余量通过；后续仍需同步PWM边界的外部测量验证最坏相位及门极。

本轮助手仅构建和查看本任务CLI提示，没有连接、下载、暂停/运行、复位、清故障或启动板子。
尚未验证本候选板上T4消除、稳定12V、最坏异常返回时间、全范围负载、电流标定或硬件OCP。
