meetyaothenstop/vscode/docs/主工程T3诊断.md

# 主工程T3分段诊断 — 2026-10-30

本页为提交8dc59c7的诊断历史；当前已回到无探针优化候选，见
[主工程OPT2测试](主工程OPT2测试.md)。下文的开关、标识、指纹属于当时诊断版。

## 本次实板反馈

用户报告24V输入、12V目标，START后立即64 T3。截图读取：

| 字段 | 原值 | 解释 |
| --- | --- | --- |
| fault/detail | 0x40 / 3 | 写PWM之前执行耗时超限 |
| fault_elapsed_cycles | 0x35A = 858 | 5.72µs，超过840周期18周期 |
| fault_spacing_cycles | 0x3E8 = 1000 | 本次入口间隔符合150kHz周期 |
| fault_counter_ticks | 0x72A0 = 29344 | 同时超过写入相位上限26880刻度 |
| v_reference | 0.10000001V | 与刚进入第一个控制步一致 |

相位超出2464刻度，等效77个CPU周期；不能只按18周期考虑时序余量。
此记录未提供入口相位及各段耗时，不能据此确认具体函数热点或PI有问题。
截图文件：`codex-clipboard-1dfb267e-ab37-47e3-8405-70d6093ad450.png`。
此前全0截图不作为本次ADC故障证据。

## 当前交付的是诊断候选

仍打开`MDK-ARM/bidreaction.uvprojx`，Target `bidreaction`。
同一工程定义增加`POWER_UNIFIED_DIAGNOSTICS=1`；不创建新工程。
首页`MAIN ADC DIAG 6A`，参数页后缀`M-DIAG`。
复用已有七个CYCCNT完成点和首次故障快照，允许主工程使用该功能。
四模式、PI、ADC相位、输出使能顺序、6A参考/7.5A采样停机、840/936期限及DMA不变。

探针占用时间，也会影响编译布局。诊断版总耗时不能直接与非插桩858周期比较，
更不能用诊断版T3判断优化是否成功。本版没有声称解决T3或已验证连续12V输出。
非插桩主工程基线为提交`4bb0c4f`，其源代码和原固件指纹保留在Git历史及主工程manifest中。
后续取消该定义或设为0并重建，可恢复非插桩配置。

## 用户自行下载和取数

本轮助手没有连接、下载、复位或启动板子。用户保持输出关闭，自行下载本次主工程HEX，
核对新标识，再按原24→12V低功率条件复现一次。故障后不要清故障、复位或再次下载。
若调试器连接会复位，原故障数据会丢失；应先确认连接方式能保留现场。
本地Keil的Load Application at Startup/Run to main设置曾开启，读取前需留意是否改变运行状态。

在Keil Watch加入并展开`power_diag.fault`，重点保留：

```text
power_diag.fault.fault
power_diag.fault.detail
power_diag.fault.mode
power_diag.fault.context
power_diag.fault.profile.entry_state
power_diag.fault.profile.stage
power_diag.fault.profile.valid_mask
power_diag.fault.profile.entry_spacing_cycles
power_diag.fault.profile.entry_counter_ticks
power_diag.fault.profile.checkpoint_cycles
power_diag.fault.timing_elapsed_cycles
power_diag.fault.timing_counter_ticks
```

使用锁存的`fault.profile`，不要用故障后继续变化的`power_diag.irq`。
完成点按入口累计：0入口检查，1ADC，2保护，3状态/使能，4控制器，5PWM映射，6写入。
相邻有效点之差用于定位区域，包含探针和边界开销。
T3通常只完成0..5，`valid_mask=0x3F`；点6的0表示未完成，不能解读为写入零耗时。
entry_state=2表示ARMING入口；故障前state=3表示该轮已转RUNNING，可能已有短门极脉冲。
若现场变成其他故障，按其实际fault/detail及mask分析，不把不同次截图混合。

## 离线验证

45组主机回归通过，含原43组和新增主诊断后端/身份测试。
新增后端测试模拟首控制步延迟，核对ARMING入口、部分完成点、输出关断、
首故障一致性/不被后续遥测覆盖及清故障行为；模拟时间不是实板耗时。
ARM6.18零错误零警告，Code44960/RO1288/RW48/ZI4696。
CCM7392字节，运行0x10000000、加载0x080097C8；实际HEX拷贝/向量/四模式函数及DMA SRAM检查通过。
HEX SHA256：`E6F5E9E4364F70DC0FAE56BAEE760A908F9E61051E3E81BFB8392F48F6D2CC17`。
板上各段热点和正常版本最坏时序仍待用户测量。
