meetyaothenstop/vscode/docs/主工程时序优化测试.md

# 主工程时序优化候选 — 2026-10-30

本页保留dd3e6ff的OPT1历史。当前为OPT2，身份/指纹和取数步骤见
[主工程OPT2测试](主工程OPT2测试.md)，不要混用历史映像。

当前仍用`MDK-ARM/bidreaction.uvprojx`，Target为`bidreaction`。
固件仍是`MDK-ARM/bidreaction/bidreaction.hex`，不另建工程。
首页`MAIN ADC OPT 6A`，参数页后缀`M-OPT`。
明确设置`POWER_UNIFIED_DIAGNOSTICS=0`，本版去掉计时探针。

## 已取得的故障依据

非插桩基线24→12V启动立即64 T3：858周期、间隔1000、计数器29344、参考约0.1V。
随后用户提供主诊断版故障截图，助手只展开并滚动既有Watch，读到：
fault64/detail3，mode1/target12，入口ARMING、故障前RUNNING，mask0x3F；
写前952周期、间隔1000、入口计数4800、写前计数352、关断后采集点1147周期。
输入24.038681V、输出0.0519697517V、电流0.0442237854A。

| 完成点 | 累计周期 | 本区域周期（含探针/边界开销） |
| --- | --- | --- |
| 0 入口检查 | 145 | 145 |
| 1 ADC | 249 | 104 |
| 2 保护 | 416 | 167 |
| 3 状态/使能 | 533 | 117 |
| 4 控制器 | 808 | 275 |
| 5 PWM映射 | 938 | 130 |
| 6 写入 | 0，未完成 | 无效，不能当作零耗时 |

952是准确写前诊断测量，1147包含关断/记录之前的开销，不能替代它。
计数器每周期回绕，小值352不能单独证明写入相位安全；T3耗时检查仍必要。
诊断会改变执行开销和编译布局，不能将这些分段值直接当非插桩各段耗时。
ARMING入口、RUNNING捕获表示同一轮刚发生使能/状态转换，不代表已持续稳压。

## 本版修改与保持项

1. 主工程在接受启动请求时缓存输入上下限、冷启动电流/残压门限及目标×过压比例。
   缓存在已有DMB/待启动发布之前就绪；每周期仍核对新样本，不缓存输入测量或跳过保护。
   每次切换模式/目标会重新计算，前向0.95可达性、首故障与硬件故障优先逻辑保持。
2. 同一前向PWM实现生成固定Buck入口`PWM_MakeBuckPlan`，由主工程模式1调用。
   其他模式继续原通用/反向映射；空指针/非法指令、零占空比、最小脉冲和死区策略保持。

四模式、PI和软启动方程、ADC相位、输出使能顺序、6A参考/7.5A采样停机、
840/936周期及真实相位检查全部保持。没有通过放宽门限来规避T3。
这是优化候选，尚未证明实板提速或T3消除。

## 离线验证与固件身份

46组主机回归通过（旧45组全部保留）；新增专用/通用Buck映射差分对比200016个指令，
覆盖零/负零、最小脉冲相邻浮点数、0.95边界、NaN/无穷和无效输出保持。
原四模式跨目标/输入保护相邻ADC码、冷启动各阶段、硬件故障竞态、DMA和菜单回归通过。
控制器参考轨迹和名义开关模型保持通过；它们不验证真实ISR耗时。

主ARM6.18零错误零警告，Code45608/RO1288/RW44/ZI4500，
CCM7776字节，运行0x10000000、加载0x080098D0。
实际HEX启动拷贝/向量/四模式函数/专用映射/无探针及DMA SRAM检查通过，AXF导出HEX完全一致。
ARM反汇编确认Buck映射右桥比较值折叠为28160，且控制IRQ实际调用了专用入口。
专用映射148字节（通用232），IRQ2724字节（旧非插桩2808）；这些静态大小不是周期测量。
共享代码重建台架零错误零警告，HEX保持旧指纹`7D9ADE7EC0931D15CEA20725440093E05D75BE36B98B11FE4B0A2B6FB23C0056`。

本版主HEX SHA256：`FC0F63F5641465B0293D941270DA603C4E713D0C0E5CC0A7842D4719869FAD5F`。
历史诊断HEX及原非插桩HEX指纹见各自manifest，不代表当前磁盘固件。

## 用户自行下载后的检查

本轮助手只读既有调试会话中的Watch，无连接、运行、暂停、复位或下载命令。
故障记录已保存后，由用户在输出关闭状态自行下载候选版。
注意Keil已打开的旧工程配置可能覆盖磁盘：重开工程后，在C/C++ Define核对
`POWER_UNIFIED_DIAGNOSTICS=0`，再Rebuild/Download；新首页必须是`MAIN ADC OPT 6A`。
若显示DIAG，说明仍有探针；若显示SW，说明仍是更早的普通版。

先保持原24V输入/12V目标/低功率负载，仅复现一次启动并记录实际输出和OLED。
若仍有64/T子码，保留该次现场，不先放宽门限。非插桩Watch读取：

```text
power_status.fault
power_status.fault_detail
power_status.fault_elapsed_cycles
power_status.fault_spacing_cycles
power_status.fault_counter_ticks
power_status.isr_cycles_max
power_status.v_reference
```

本版无`power_diag`。成功启动后仍需测量最坏IRQ与写入相位，且全范围/满载/硬件OCP仍未验证。
