meetyaothenstop/vscode/docs/Buck优化版测试.md

# Buck 优化版：24V→12V与实时OLED

本页保留受限台架配置及历史。当前主应用已按用户要求集成到`MDK-ARM/bidreaction.uvprojx`，
完整四模式与新Buck范围见[主工程Buck测试](主工程Buck测试.md)。
共享代码集成后，台架本轮重建HEX为`7D9ADE7EC0931D15CEA20725440093E05D75BE36B98B11FE4B0A2B6FB23C0056`，
下文旧哈希只代表相应历史构建。

工程：`MDK-ARM/bench12_buck_fast.uvprojx`

Target：`bench12_buck_fast`

固件：`MDK-ARM/bench12_buck_fast/bidreaction_bench12_buck_fast.hex`

首页：`24V BUCK DMA OVP15 C6`；参数页：`SW15-C6`。继续使用同一活动工程，
旧工程只是历史参考，共享当前源码。

## 当前24V测试档（2026-10-29）

用户报告旧12V→6V已稳定输出且OLED正常显示，当前准备24V→12V，尚未板测。

| 参数 | 当前24V档 | 旧12V档（显式24V开关=0） |
| --- | --- | --- |
| 默认输入/目标 | 24V/12V | 12V/6V |
| 实测输入允许 | 20–28V | 10–14V |
| 后端目标范围 | 1–12V | 1–6V |
| 输出过压 | 目标×15/12；12V时15V | 目标×8/6；6V时8V |
| 电流参考上限 | 1.0A | 0.5A |
| 采样过流 | 6A（用户要求的门限试验） | 1.5A |
| 冷启动 | 电流绝对值<0.5A、输出≤1V | 相同 |

新开关`POWER_BENCH_24V_BUCK_TEST`默认随FAST开启；明确设0才能重建旧12V档。
PI、软启动、PWM、ADC1电流/输出采样、ADC2输入晚采样、DMA实时OLED及时序保护均保持。
输入或输出越限仍首次关断，不增加故障忽略/滤波延时。

用户确认旧SW24-14/12V目标后，启动报故障8；只读现场首故障采样1.6527462A、输出6.0804605V，
参考7.170691V，前一步电流参考0.6817135A。用户随后要求最大电流6A，本轮据此把采样过流
改为6A，电流参考仍1A。6A不代表恒流设定或实际瞬时峰值已受控；根因/实测波形未确认。
新门限raw3822约5.99333A通过、raw3823约6.00142A首次关断；ADC端点、反向/冷启动等保持。

随后用户在6A固件交付后报告“这次报错4，把输出电压保护升高到15v”。本次仅把24V档
14/12→15/12，目标12V对应15V、目标6V对应7.5V；目标上限12V、6A采样过流、1A参考保持。
旧14V与15V之间的14.2V样本通过，raw865≈14.98461V通过、raw866≈15.00193V首次锁存关断。
尚未取得本次故障4的RAM/实测峰值或板上身份；此次是用户要求的门限试验。

电流参考调整有模型依据：实际C模型0.5A在24→12V只到6.367V，0.75A在28V输入只到8.826V。
采样电流由固定相位决定，不能以100Ω负载平均电流0.12A推断0.5A参考必定充足。
1A在20/24/28V下收敛约11.997–11.998V；名义输出峰值≤12.589V、采样峰值≤1.079A，
名义动态测试仍要求采样峰值<1.5A，不随新6A保护放宽。
这不代表电流标定、元件应力、实际峰值和板上稳定性已验证。

用户已确认负载额定150W、输出电容耐压50V。若仍使用100Ω，12V为1.44W、15V为2.25W，
这两项额定值有余量。150W是额定功率，不是本次测试要吸收的功率；若使用电子负载，
其设定模式/阻值仍需与测试条件相符。用户随后说明输入/输出对称、输入已24V，
并确认正常STOP、输出关闭；按其描述将两侧电容记录为50V，未独立核对其他器件，
50V元件额定值不代替实际输出/电流波形验证；本轮15V门限来源是用户明确指令。

1. 在当前12V试验结束后正常STOP，确认输出关闭；停止状态下下载24V固件并核对新身份。
   下载会复位，不自动发送启动命令。若输入仍12V，本档拒绝启动属于预期行为。
2. 停止输出后按台架正常流程切换至24V，确认负载额定功率和元件耐压满足要求；
   初始保留现有电源限流设置，并观察电源是否进入恒流，避免把限流下掉压当作PI故障。
   若仍为0.2A，24V额定输入功率上限4.8W，仅是电源设置上限，不证明瞬时应力已受限。
3. 先不启动，比较万用表/OLED左输入约24V、右输出残压≤1V和近零电流读数。
   残压未降至门限时等待放电。启动后连续运行，不在运行期间暂停/单步CPU。
4. 用示波器记录输出启动峰值和12V稳态；确认OLED持续更新、K4 STOP有效。
   若报错先保留fault/detail/首故障样本及波形，按K4停止后再连接调试器读取耗时。
   不通过扩大840/936时序门限或无依据继续扩大电流/电压门限来掩盖故障。

本轮软件验证32组主机PASS；旧28组保持，新24V后端、开关模型、菜单和实时UI通过。
ARM6.18为0错误0警告；Code40420/RO1288/RW32/ZI4264，CCM3380字节，加载0x080095B8。
CCM/显示向量及缓冲SRAM检查通过；HEX SHA256：
`744BE08E77F5F78F9F5DD417255C01ABC313BEF55D8D97FED45A5A227BA5788C`。
当前15V/6A固件由用户自行下载，助手本轮未连接/下载/复位/启动；下载前正常STOP。
旧1.5A版曾在18:46:59校验通过，用户后来确认身份并启动报8；不混作当前15V/6A版板测。
实际12V输出、板上24V时序、电压峰值与电流标定仍待验证。
当前动态模型只覆盖目标12V、100Ω及三个输入点；其他目标/负载尚未动态验证。
独立审查未发现默认固件的重要问题。次要待补：24V早采样=0后端测试的条件编译，
以及静默OLED=0菜单测试的身份断言；默认24V晚采样/DMA固件与32组回归不受影响。

## 以前12V档的变化与测量依据

- 2026-10-28：只改变输入电压的采样路径。ADC1原电流、左电压、右电压三路
  注入采样及TRG2/CMP2保持；ADC2规则组在Timer A CMP4=23040，即周期4.8µs，
  由HRTIM TRG1采同一PA0。输入控制、启动判断和输入故障快照使用ADC2。
- ADC2每周期必须同时有EOC/EOS且无OVR；缺失、不完整或溢出不退回ADC1早样本。
  活动阶段立即报ADC故障，停止阶段取消样本有效资格。初始化失败不启动PWM计数器。
- 2026-10-29用户在调整PLECS电容后要求提高至8V。当前FAST保护比率由7/6改为8/6，
  6V目标对应8.0V；低目标仍按比例（3V对应4V），其他构建仍为1.1倍。
  超出门限仍单次采样关断。PI、目标上限6V、10–14V输入窗口及840/936周期保护保持。
- 用户所述6A为仿真电流参考上限；本轮没有提高实板的0.5A电流参考或1.5A过流门限。
- 按用户要求，启动请求、初始预充电和等待使能阶段统一使用
  `|采样电流| < 0.5A`、`右输出电压 <= 1V`。电流恰好 ±0.5A 仍拒绝。
- 仅在本工程裁掉不参与 Buck 控制的 Boost 预充电、延时及额外斜坡计算。
  有效 Buck 滤波、软启动、PI、积分更新次序和抗饱和保持原算法。
- 非 Buck 模式在后端拒绝；若直接误调控制器，也会锁存错误并清零控制输出。
- 仍为 12V 受限台架：输入 10.0–14.0V，目标 1–6V，电流参考上限0.5A，
  采样过流1.5A。OCP 未确认；没有把硬件保护标成已验证。
- 2026-10-29：用户报告实板稳定6V、显示冻结。原FAST故意在活动期间静默；
  当前候选版恢复RUNNING/HOLD遥测，每200ms调度一帧、8页异步I2C DMA。
  启动请求、预充电和等待使能仍静默，已在途的单包可结束；回调不启动下一包。
  使用DMA1通道1/DMAMUX I2C1_TX；DMA/I2C中断优先级3，控制中断仍为0。
  独立页快照避免重绘改写发送数据。按键和STOP先处理，屏幕繁忙不等待。
  显示错误/单包50ms超时后锁定离线至复位，只禁用显示的3个IRQ，不复用发送缓冲。
  `POWER_BENCH_LIVE_OLED=0`可编译原FAST全活动态静默对照；默认1。所有时序保护保持原值。

2026-10-26追加：用户报告实际输入在万用表及示波器上约11.9–12V，而故障
采样先后为13.53V及10.31V，并要求适当增加报错范围。仅在当前FAST工程把输入窗口
由10.5–13.5V改为10–14V，启动请求和运行期间共用门限。越界仍单次采样关断，不增加滤波
延迟。这不是采样链路修复；后续若仍出现较大采样偏差，应检查ADC分压点及地参考。

提高启动电压门限只是允许更多残余电压，不代表此前0.346V/0.589V采样
已证实为噪声。允许带电输出冷启动可能增加反向电流，实际需台架观察。
HOLD 恢复条件不属于冷启动，仍沿用原来的0.25A，当前受限 Buck 不进入该反向路径。

## 为什么写入期限是840周期

150MHz CPU、150kHz PWM，每周期1000个CPU时钟。
代码在写PWM之前要求本次中断耗时不超过1000−160=840周期（T3），
并要求定时器不超过32000−5120=26880刻度（T4）。5120刻度相当于160个CPU时钟。
前者监控计算耗时，后者监控真实周期位置；中断入口有延迟，所以两者都需要。
写入后还有936周期收尾检查（T5）及下一周期到达检查（T6）。

160是软件预留裕量，不是芯片指定的常数。若要缩小，需要测量最坏写入/
收尾耗时和入口抖动，不能只为消除报错而改。当前截图931周期、计数31744，
距32000仅256刻度，约8个CPU时钟或53ns；即便单独把T3改为950，仍违反T4。

左右PWM比较值先写入预装载寄存器，再在周期边界生效。成对写入期间禁止
两桥更新。错过边界可能使旧占空比多保持一周期，增加控制延迟，跨边界写入
也会破坏预期更新时序。是否造成危险取决于电流、电感、占空比及负载，
不能把“未立即损坏”当作时序正确。

## 验证与下一次操作

当前候选版本地主机测试28组通过，包括新增DMA传输、实时UI及FAST静默对照，
以及54万个采样点的普通/优化Buck分支逐位输出及
有效状态对比、正负启动电流/电压边界、故障停机、理想开关模型，以及ADC2配置失败、
早/晚输入分歧和各活动阶段坏样本保护。8V版还验证6.6875V及7.05056V可通过，
8V两侧相邻ADC码的通过/关断和首次故障快照，以及3V目标对应4V的比例保护。
理想模型仍保留更严格的6.6V启动峰值回归断言，不因提高保护线而放宽模型要求。
这些不能替代板上时序和电气验证。ARM编译0错误0警告；CCM向量、启动拷贝、
代码位置和无插桩检查通过，CCM代码3384字节。forward_step仍为696字节，
字节数不等于周期数。37.5MHz ADC时钟下，计算的ADC2最晚完成时刻约5.853µs，
距周期末约0.813µs；需实测确认。固定4.8µs也不保证所有占空比下都远离开关沿。

1. 在功率输出已停止且旧现场已保存后下载本工程固件，核对首页身份。
   保持此前12V电源、0.2A电源限流、右侧100Ω负载和6V目标。
2. 先不发启动命令，比较ADC1 JDR2与ADC2 DR/`power_status.raw_vh`的直流读数及
   万用表输入电压。两颗ADC的偏置/增益可能不同，不能把偏置变化误判为相位去噪。
   调试暂停会使标志溢出，只在停止状态暂停，随后恢复并等待连续新样本再启动。
3. 正常连续运行后手动启动，用相同示波器设置对照输入/PA0波形与故障输入值。
   活动期间不要单步或暂停CPU。新DMA版启动期间静默，RUNNING参数页应持续更新；
   观察输出读数变化和STOP是否有效。若只显示旧数字，先记录是否整屏冻结、按键反应及故障，
   不在运行时用复位尝试恢复屏幕。显示总线失败会锁定离线至下次正常停机后的复位。
4. 若报错，输出关断后再暂停读取：`fault`、`fault_detail`、`fault_elapsed_cycles`、
   `fault_counter_ticks`、`fault_raw_vh`、`fault_input_volts`、`v_reference`、
   `fault_v_right`、`fault_il`。新构建后地址可能变化，使用匹配AXF的符号和map。
5. 若正常运行，先按K4停止，再读取`isr_cycles_max`，记录实际输出峰值、稳态值、
   显示更新和是否仍报输入保护。观察足够长运行及按键/刷新重叠时的最坏耗时；
   若触发64/T3等时序故障，保留首故障数据，与`POWER_BENCH_LIVE_OLED=0`对照。
   不扩大840/936门限来消除报错。旧版755/773周期不可当作本版实测值。

2026-10-28已直接读取到板上Flash和CCM的7/6保护系数，本次取证未下载或启动硬件。
目标6V时首故障采样7.05056286V，上一控制步反馈5.94187450V；用户尚无同次示波器波形。
下一次先同步抓输出电容两端与PA1输出分压点的启动到关断过程，保留预触发波形，
判断真实输出是否与ADC读数对应。当前DMA/8V候选版本轮尚未下载，用户已报告当前板可稳态6V，
但板上固件身份未在本轮读取核对。复测时记录实际输出峰值
及新的故障采样；旧7V故障记录保留。只改输入的晚采样不改变PA1输出采样相位。
输入噪声是否改善、ADC2直流一致性及最坏IRQ开销仍待实测。
提高保护线只增加允许的过冲，不改变PI；需用示波器记录启动峰值、稳态值及故障采样，
不能把不再报故障4直接当作超调已经修复。

本轮构建SHA256：`9444BC857DAE17ED4159AE13CA9BB7AD78FC476571A9F70DAEE89ED407FFC924`。
Keil Code40412/RO1288/RW32/ZI4264；CCM3384字节，加载0x080095AC、运行0x10000000。
DMA/I2C真实向量及缓冲SRAM位置检查：
`verify_build.ps1 -Uninstrumented -LiveOled`（仍需提供MapPath/HexPath）。
