meetyaothenstop/vscode/docs/12V正向Buck测试.md

# 12 V 正向 Buck 首轮测试

按用户选择，先使用现有 INA240/PA2 的 ADC 软件保护，不新增 PB1/PA7
硬件过流飞线。电源设置 12 V、0.2 A 限流。此处是受限测试配置，未证明
实板闭环或保护可靠；电源限流不能限制已充电母线电容释放的瞬时电流。

## 测试固件

- Keil 项目：`MDK-ARM/bench12_buck.uvprojx`，目标 `bench12_buck_sw`。
- HEX：`MDK-ARM/bench12_buck/bidreaction_bench12_buck_sw.hex`。
- 最新诊断版首页显示 `12V BUCK SW DIAG`；参数页标题带 `SW`。
- 默认 forward 12→6 V；只允许正向 Buck，输出目标 1～6 V；实测输入
  须在 10.5～13.5 V，启动及运行期间均检查。Boost、反向、较高电压请求
  会被拒绝。界面仍允许编辑原范围，超出测试范围的启动报 `FAULT:128`。
- 电流参考限值 0.5 A；软件按采样点的 |IL|≥1.5 A 或 ADC 靠近上下轨
  关断。电流参考不是峰值限流，也不是独立的输出电流限制。
- 测试版 Buck 的小于约267 ns上管脉冲使用合法零占空比，避免控制器
  要求零能量时仍强制最小导通；默认版本的占空比映射保持原有策略。
  冷启动在使能下管前及准备开放上管期间重新核对最新电流和输出残压，
  不满足冷启动条件即关断；该新鲜采样检查也适用于默认构建。
- 硬件保护配置标志仍为 0，`power_status.protection_ready=0` 如实保留；
  PB1/PA7不配置。此构建明确允许在上述限制内使用软件保护启动。
- 默认 `MDK-ARM/bidreaction.uvprojx` 不带测试宏，仍要求硬件保护就绪，
  缺少接线时 `FAULT:512`。不要改成 `POWER_OCP_WIRING_CONFIRMED=1`
  来假装已经接线。

## 操作顺序

1. 首先在 MOS 尚未安装、功率通路隔离时烧录测试版。确认首页测试标识、
   ADC显示及按键；先检查四路逻辑 PWM、驱动波形、上下管无重叠和自举
   电压。高边 VGS 应相对其源极测量，使用合适的差分探头或隔离测量。
2. 安装 MOS 并进入功率测试前，断电确认新增 5 mΩ 电阻实际串在 SW_1
   与电感之间，两根 INA240 Kelvin 线接在电阻端点、正向左到右为正。
   对照已知小电流检查读数和极性。电压标定通过不代表电流已校准。
3. 接线或更换负载时断电。左侧接可调电源 12 V / 0.2 A；右侧接
   100 Ω、额定至少 1 W 的电阻负载（6 V 时约 0.06 A、0.36 W）。
   右侧不接外部电源。先保持 STOPPED，确认电源维持12 V、没有恒流
   指示；若静态就恒流，先排查静态功耗或接线，不直接提高限流并启动。
4. 确认输出电容低于 0.25 V、静态 |IL|<0.25 A。进入 forward，核对
   input_v=12、output_v=6，才按 start。此固件不自动启动。
5. 首轮记录输入实际电压、电源电流、输出实际电压、OLED IL、故障码
   及示波器启动波形。电源进入恒流、明显异常或输出达到 6.6 V 以上时
   停止，保留故障信息。不要通过反复清故障、扩大门限来掩盖问题。
6. 停止用 stop/K4；带功率运行时不要在Keil暂停CPU或单步中断。故障
   保持锁存，清故障只回 STOPPED，不会重新开PWM。再次启动前放电。

常见故障：8=采样过流/ADC轨，16=反向电流，64=控制时序，128=启动
条件或测试范围不满足。默认工程的512表示硬件保护未就绪，不是下载失败。

## 诊断版的故障记录

烧录同一路径的最新测试HEX，复位后确认首页 `12V BUCK SW DIAG`。
出现故障后先记录完整底行，不要立即清除、复位或重新烧录。

- `FAULT:128 S1～S7`：分别为模式、采样有效性、输出设定范围、输入范围、
  静态电流、输出残压、实际输入与目标关系不满足。
- `FAULT:128 S8/S9`：启动接受后或冷启动准备期间，新采样的电流/输出
  残压不满足冷启动条件；静态屏幕正常不能排除这些瞬时读数。
- `FAULT:64 T1/T2`：相邻控制中断间隔过长/进入相位太晚。
- `FAULT:64 T3/T4`：写PWM比较值前，CPU耗时过长/定时器相位太晚。
- `FAULT:64 T5/T6`：中断结束耗时过长/新的周期事件已经发生。
- `FAULT:2 IN x.xx V`：触发输入范围保护时最后完整采样的输入电压；
  不会被故障后恢复正常的实时读数覆盖。

Keil Watch可看 `power_status.fault_detail`、`fault_elapsed_cycles`、
`fault_spacing_cycles`、`fault_counter_ticks`，以及 `fault_v_left`、
`fault_v_right`、`fault_il` 和 `fault_raw_vh/vl/il`。这些值锁存至显式
清故障。当前所有启动、电流、输入及时间门限保持原值；未关闭保护。

主机测试和编译只验证软件行为。实际门极/死区、自举、电流传感器瞬态、
150 kHz ISR预算及闭环稳定性都需实测，当前没有通过记录。

软件验证：十五组主机测试通过；12→6 V、100 Ω、22 μH、690 μF的理想
开关模型最终约5.999 V，电流峰值约0.561 A、采样峰值约0.520 A。模型
使用理想12 V输入，不模拟0.2 A限流电源、二极管、门极驱动及采样前端。
这些值不代表实板测试结果。
