meetyaothenstop/vscode/.superpowers/bench24-oc6/progress.md

# SDD ledger — plan: docs/superpowers/plans/2026-10-29-bench24-oc6.md

Base6aea1de. User explicitly raises maximumcurrentto6A afterfault8.
Ruling: contextmeans sampledtrip1.5→6A for24profile, keepIref1A; announceduserbeforeediting.
Rootcauseunproven; user-directedthresholdexperiment, not a calibration/stability claim.
Fault8saved HOTPLUGrawlog .superpowers/bench24/fault8-hotplug.log; noreset/clear/start byagent.
RED backend: recorded1.652746Asample still tripsold1.5Aline; new6Aboundarytest added.
Samecheckout/activeproject; unrelatedIDE/scratch preserved. Finalfreshreviewpending.
Task1GREEN:6AadjacentADCcodes3822/3823andfirstfaultlatch,old1.652746Asamplepass;
new21colidentitytestsGREEN.32/32fullhostPASS;originalnominalmodel1.5Apeakguardunchanged.
ARM6.18zeroerror/warning Code40424 RO1288 RW32 ZI4264;CCM3384load0x080095B8,
actualHEXCCM/copy/vector/uninstrumented+OLEDvector/SRAMPASS.
AXFexportHEXexactmatchE1FA8AE4D6E6CC338F8278BAF22C41BF28DBF1C5F6CA2D62A61E24328145066B.
Fault8evidence/rawmemorysavedseparatelywithoutprobeserial.6Aimageunflashed;reviewpending.
Finalreviewcomplete:codeapproved,noCritical/Important. Old/newhashreferentdocumentationcorrected
beforecommitforREADMEaccuracy; norelatedproductionchange. Board-current/rootcauseclaimsstayunverified.
Task1complete;Task2softwarechecks/docscomplete. Pendingselected-filecommit/pushandstopped-stateflash.
Code/evidencecommitce229bdf8a867ad860d098395381fdd1f9b5eafdandcandidate tagpushed,
remoteSHAverified. Usersteered: no needagentcomputercontrolfordownload;handofffirmwareto
userforflashing. No6Aboarddownloadorstartperformed;hardwarephaseoutsidecurrentagentdelivery.
