meetyaothenstop/vscode/.superpowers/bench12-buck/review.md

# Independent review and disposition

Reviewer: /root/review_bench12, read-only, no edits or hardware operations.

Important 1: forced 4% source pulse with zero commanded Buck duty violates
the restricted bench current expectations. Fixed for the opt-in bench
profile using the existing reverse mapper's null-duty policy. Permanent
zero/subminimum/threshold and ideal switching checks now pass; default
mapper remains unchanged.

Important 2: pending-start bootstrap enable occurred before fresh source
and current validation. Fixed by moving validation before enable, adding
fresh cold current/output checks through cold arming and excluding HOLD
resume. Regression tests first failed with enabled low outputs, then pass
with no enable strobe for rejected samples. Both build profiles tested.

No other Important/Critical findings. Default Keil project and protection
header match backups; separate test target/output and truthful readiness
were verified. Pending Stop/Clear assertions added for the bench profile.

Declined physical waveform, analog sensing, actual ISR budget and stability
judgment: neither source review nor synthetic tests establishes those.
Disposition: document remaining board checks and make no physical pass claim.
