meetyaothenstop/vscode/.superpowers/ccm-base/progress.md

# SDD ledger — plan: docs/superpowers/plans/2026-10-26-ccm-base.md

Continuing authorized T3 work: compare without section-probe overhead before
considering algorithm changes. Backups and profiled CCM HEX retained in originals/.
Pre-flight: gate must still enforce bench/mute when unified diagnostics is0.
Task1: complete. Old guard RED then menu runtime identity RED; baseline configuration/menu GREEN.21host groups passed, ARM0errors0warnings. Artifact checker passes -Uninstrumented, rejects profiled CCM; negative guards reject unrestricted/unmuted configurations.
Independent review: /root/review_ccm_base found no Critical/Important issue; delivery housekeeping completed. No controller/ADC/clock/protection changes, no hardware download/start, no board deadline success claim.
