meetyaothenstop/vscode/.superpowers/ccm-base/review.md

# Uninstrumented CCM review — 2026-10-26

Fresh reviewer /root/review_ccm_base (GPT-6-astra high), read-only. Verdict: ready
for the documented one-run board validation; no Critical or Important findings.

Confirmed restricted bench/mute guard independent of profiler, preserved canonical
first-fault capture and T1..T6, unchanged power_control source/header hashes,
no probe/private storage or stale power_diag Watch entries, correct CCM/Flash copy,
IRQ vector/veneers and ordinary SRAM separation. Independently reran read-only
artifact verifier. HEX hash matches manifest; logs show21host groups and0ARM errors/
warnings. No builds, hardware downloads or starts performed by reviewer.

Minor housekeeping was pending task/plan checkboxes while review ran. Updated at
delivery; no firmware change. No other new minor findings.

Not established by this review: actual deadline margin, T3 elimination/speedup,
hardware cold boot, stable6V, analog accuracy, gates/deadtime or protection latency.
The prior profiled-stage remaining-count/capture-time test gaps remain unchanged.
