meetyaothenstop/vscode/.superpowers/fast-buck/review.md

# Independent review — 2026-10-26

Reviewer: /root/review_fast_buck, read-only fresh context.

No actionable P0-P2 findings in scoped changes. Pruned states have no remaining
consumers outside guarded Boost branches; active Buck PI/filter/ramp/update
order matches baseline. FAST guard/project restrictions and initialization/
error latch are consistent. Thresholds only affect FAST cold request/bootstrap/
arming; running current and timing logic unchanged. Reviewer independently ran
the540000sample equivalence/rejection executable and read final25group and ARM
0error/0warning logs.

Not established by this review: real-board deadline compliance, electrical
behavior with charged output up to1V, ADC wiring/calibration/noise, or hardware
overcurrent protection readiness. User-requested startup threshold increase
is acceptance-policy relaxation, not proof these phenomena were repaired.
