meetyaothenstop/vscode/.superpowers/oled-timing-ab/review.md

# Focused review and verification

Reviewer /root/review_fault_diag: no Important/Critical findings. Active
mute follows key processing and refreshed telemetry; stopped/faulted states
resume full frame. Flag defaults0, requires bench profile, separate outputs.

Minor dispositions: experimental SWD1 MHz versus saved normal SF10000 is
explicitly called out in board steps: set both1 MHz, identical debug setup.
Warn frozen screen can retain STOPPED while PWM runs, require K4 stop before
CPU halt. Direct active->fault regression enhancement deferred: current
test checks active mute, stop recovery and later fault display; source review
checks the direct transition. No observed fault-recovery bug.

Physical timing, actual key shutdown and OLED causality are not established
by host review; retained as board verification, not claimed fixed.

RED: new accepted-start UI test failed on page_calls==before, before source
gate was added. GREEN: full16 groups pass in host_tests.log. Normal bench
full rebuild:0 errors/0 warnings Code34152/RO1272/RW28/ZI3932. Experimental:
0 errors/0 warnings Code34252/RO1272/RW28/ZI3932. Build logs are
MDK-ARM/oled_ab_normal_build.log and oled_ab_mute_build.log.
Normal HEX remains byte-identical to prior diagnostic image:
B8B9CA4013CF3B18C9D7B4397602AFD7E620FE21A50FC7EDCBB4765EC4B4703C
Experiment HEX SHA256:
897D555B2A369637C9A33EC3F25BA7B9D702D331FB9470ECA36D5A9DE3958B7B
Watch1 in new .uvoptx prefilled with fault/detail/elapsed/max/spacing/ticks
and current/fault voltage fields. No board download/start by the assistant.
