meetyaothenstop/vscode/.superpowers/reverse-integration/progress.md

# Reverse integration ledger — plan: docs/superpowers/plans/2026-10-22-reverse-integration.md

- User authorized inspect-and-integrate. Original exports are read-only inputs; no hardware start/download is authorized or performed.
- No Git repository. Preserve pre-change project files under originals/ in this directory; work in the explicitly requested outer project.
- Baseline: all seven existing host test groups pass.
- Export SHA256 reverse.c: 1691F36BAEA16EDFC648DE773E6F564EF7B157E209516417C34866F4810170C0; reverse.h: 39E6F4C89A2D1E439ECF37253D64E662289F592E1658B7ECDF31DC796CD2DBC3.
- Initial findings: 150 kHz matches. double arithmetic; reference begins at24 V and increments120 V/s without target cap; precharge increments500 A/s without cap; voltage current reference cap10 A; Boost feedforward is Vin/Vref−1 then clipped nonnegative; D_cm_R4 is precharge-done. Init clears X but not B/Y.
- Task 1: complete. Original probe showed144V reference and500A precharge after1s; independent math audit confirmed wrong Boost FF, unbounded ramps, retained output/init states and handover gap.
- Task 2: complete. Project copies usefloat, configurable bounded reference6A/precharge2.5A, conditional PI, correctFF. Eight average models and eleven fixed-ADC-phase ideal switching models pass. Original exports unchanged (SHA256 rechecked).
- Ruling: reverseBuck/precharge commandmax1 butphysicalhigh<=.85, threshold99%; source subminimum pulse usesCMP1=0 HRTIMv2 null duty per AN4539 A.1.9 with currentcontinuous/PERset/CMPreset/EQUAL setup. Fixes startup forced-pulse oscillation and near-source Boost-entry surge.
- Ruling: CHANGEOVER disables all outputs until valid Boost plan crosses an actual preload boundary. No stale Buck plan is enabled.
- Ruling: no-load simulation exposed96V output; HOLD at1.005target, resume below.99target and|IL|<.25, bootstrap30+arm2. Initial resume integrated whileoff and peaked17A; hold helper now freezesVPI/zerosIPI, resume resetsPI/ref to measuredoutput while retainingBoost latch. Eleven switching cases now meet voltage/current bounds.
- Ruling: reverse synchronous resume ripple +1.917A persists5samples in light-load model; reverse oppositecurrent>1A requires16consecutive samples (107us), with healthy sample reset; absolute7.5A immediate. Forward polarity rule unchanged.
- Task 3: complete. Independent real-backend tests first failed unsupportedmode3, nowpass startup/bus/current/ADC/timing/commands/HOLD/preload tests. Menu reverse tests failed oldblock, nowmap3/4, autoBuckBoost, HOLDstop/lock tests pass.
- Task 4: complete. All10host groups PASS; Keil final full build0errors/0warnings, Code34860 RO1272 RW40 ZI4072. Callgraph foreground528B +IRQ136B +FPframe104B≈768B/1024B; reverse_step no double library calls. Documentation updated. No hardware flash or physicalpower operation.
- Final independent review found only a pre-existing bootstrap off-by-one. Tightened test to30complete periods, observedRED, then skipped the enablingIRQ decrement after normal protection. BackendGREEN; reviewer rechecked fix and reran backendPASS, no remaining findings. Final suite10/10 saved to host_tests.log; Keil log MDK-ARM/reverse_build.log; HEX MDK-ARM/bidreaction/bidreaction.hex. Source timing/stack inspected after final rebuild. Hardware Fault path remains unconfigured and real power-stage stability/timing unverified.
