meetyaothenstop/vscode/.superpowers/unified-diagnostics/review.md

# Unified diagnostic delivery review

Fresh read-only reviewer: `/root/review_unified_diagnostics`, GPT-6-astra high,
2026-10-25. Compared current files to the preserved originals; inspected tests,
source, delivery configuration, map/disassembly and saved build evidence.

Verdict: deliverable as a diagnostic build; no Critical or Important issues found.
Protection values, trigger route, clocks, controller settings and enable sequencing
are preserved. First-fault timing/sample metadata is atomically committed after
output disable. Live profiling is gated out of the uninstrumented comparison.

Minor (deferred): `tests/power_control_test.c`, stage test around line 747, does not
assert each bootstrap_remaining/arming_remaining value and zero outside its state.
The fields were reviewed in code; a future broken counter capture could evade tests.

Minor (deferred): timing test around line 801 does not separately assert
capture_elapsed_cycles > timing_elapsed_cycles under simulated probe time. Existing
tests cover canonical deadline, checkpoint partition and wrap, but could miss a
future confusion between capture-time and deadline-time fields.

Review scope boundaries (all retained as delivery limitations):
- Actual T3/S8/S9 cause and resolution need the new board record.
- Actual probe overhead, latency and final margins need hardware measurement and
  an uninstrumented validation build; synthetic host timing is not a benchmark.
- Analog accuracy, gate/deadtime waveforms, closed loop and physical shutdown need
  board measurements.
- Hardware protection remains intentionally unconfigured in this bench image;
  synthetic hardware-fault tests do not prove installed comparator wiring.

Evidence: 18 host groups passed (`host-tests-final.log`); both `unified_diag_build.log`
and `compare_build.log` report 0 errors and 0 warnings. No board download/start was
performed. OLED DMA remains a later independent change.
