meetyaothenstop/vscode/docs/superpowers/plans/2026-11-08-forward-boost-25k.md

# 正向Boost 25/5kHz实施计划

用户已明确批准：仅主工程正向Boost电流/电压计算25/5kHz，PWM/ADC/快速保护仍150kHz；其余模式50/10kHz。连续PI增益保持，积分和滤波重算。欠压10V等电气保护保持。助手不操作下载。

基线8564652556f6b00d7ef3f25437e28822fa7baba6及pre-forward-boost-25k-20261108已推送并核对远端后开始修改。继续固定主工程及当前分支，保留原IDE改动，不新建工程。

设计：

- mode2真实worker每6个PWM请求一次，40us截止窗口；其他模式仍每3个PWM、20us。发布/取消及T1～T7规则保持。
- 仅受保护Boost模板使用40us电流/200us电压步长。6238rad/s反馈和预充低通按Tustin重算；120V/s参考、500A/s预充、100/s交接斜坡和连续PI增益保持。
- 原单步逻辑延迟在25kHz下为40us，实际换向至少全关断3个PWM并等待新Boost plan；不声称换向仍恰好20us。
- 公共入口、Buck、反向、非多速率兼容和bench系数保持；无新增快中断浮点计算。菜单以B25/5标记本版及正向Boost。
- 独立307bcdd旧源在相同25/5kHz离散系数下比对完整B/X/Y；不能把新旧不同采样频率轨迹宣称逐位相同。

任务与验证：

- [x] 新增真实worker mode2六周期/其他模式三周期、T7、每PWM快速保护及40/200us时基测试；先见RED。
- [x] 实现模式专用调度、离散系数及标识；更新独立旧源同速率参考和换向等待断言。
- [x] 完整主机回归、名义开关模型；主/bench ARM重建0错误0警告，bench HEX保持；实际映像/CCM/整数快速路径及AXF导出核验。
- [x] 独立只读审查，补充README和测试记录；提交并推送版本标签，核对远端SHA，交给用户下载。

审查重点：mode2的请求节拍与实际模型dt一致；其余模式不变；滤波使用各自更新周期；全关断及保护不因worker降频减速；静态/主机验证不能证明实板T7或输入9.9V问题已解决。
