meetyaothenstop/vscode/docs/superpowers/plans/2026-10-29-main-buck.md

# Main Buck Integration Implementation Plan

> Use superpowers:executing-plans with focused parallel implementation owners and one fresh final review.

**Goal:** 主工程保留四模式，支持Buck标称12–40V/菜单0–36V和6A控制参考，用户自行下载。
**Architecture:** 主配置与能力宏、单模板fast/full控制步、模式相关保护、CCM/晚ADC/DMA。
**Spec:** docs/superpowers/specs/2026-10-29-main-buck-design.md

## Constraints / review focus

不创建工程副本；保留用户IDE状态；明确ADC-only授权但不伪造硬件就绪；不操作硬件。
零输出全部关断/不清故障；Boost/反向不被bench裁掉；保护/采样模式一致；旧32回归保持。
所有热路径真实链接到CCM；DMA数据仍普通SRAM；0V为OFF而非主动放电；不冒充全范围板测。

## Task 1: 控制步（owner main_buck_arch_audit）

Files forward.c/new private step template/tests forward equivalence.
- [x] 提取单步模板，主工程fast/full dispatch保留其他模式；旧构建保持。
- [x] 主工程fast/full与旧基准轨迹/模式切换测试RED→GREEN，汇报符号和测试接口。

## Task 2: 后端与0V（owner main_zero_range_audit）

Files power_control.c/tests power_control_test.c（及必要fixture）。
- [x] 0V全部阶段、四模式、ADC-only与就绪guard、范围/不可达、模式采样与保护先RED。
- [x] 实现主工程模式相关限值/零关断/晚ADC选择，旧32后端分支保持GREEN。

## Task 3: 菜单与前台（owner main_ui_integration）

Files power_menu.c/power_ui.c/new main menu/UI tests，已有测试按需guard。
- [x] 主菜单12–40/0–36、0动作、四模式/新身份、DMA准备静默/实时/STOP测试。
- [x] 通用DMA能力接入，旧菜单/UI保持。

## Task 4: 配置/链接/驱动/交付（owner root）

Files build_config/OLED driver/pwm_plan/main uvprojx/new main scatter/verifier/run_tests/docs。
- [x] 提供约定宏；主工程CCM/DMA/null PWM；主工程定义/scatter，关闭调试自动下载。
- [x] 补主工程动态模型，合并各owner回归、完整主/bench ARM和实际HEX检查。
- [x] 新鲜独立审查及交付说明纠正；README/AGENTS/记录/manifest完成。

交付步骤：提交当前分支及候选标签，上传后核对远端SHA；结果在交付回复中记录。
