meetyaothenstop/vscode/docs/superpowers/plans/2026-10-29-bench24-ovp15.md

# 24V OVP15 Implementation Plan

> Use superpowers:executing-plans inline, with final independent review.

**Goal:** 12V目标输出保护改15V，6A采样过流/1A参考保持。
**Architecture:** 24V配置宏和版本身份，后端算法不变。
**Spec:** docs/superpowers/specs/2026-10-29-bench24-ovp15-design.md

## Constraints / review focus

同一活动工程；保留IDE未提交改动；旧配置隔离；相邻ADC码首次保护；新身份21列。
提高门限不放宽原模型峰值断言；用户自行下载；软件验证不等于板测。

- [x] 先观察旧14V保护/旧身份RED，改15/12与新身份，GREEN。
- [x] 完整回归、ARM/CCM/链接核对、独立审查。
- [x] README/测试记录/manifest标明用户故障4与未下载状态。
- 交付：按长期约定Git提交/标签/推送，远程SHA在交付消息核对。
