meetyaothenstop/vscode/docs/superpowers/plans/2026-10-29-bench24-oc6.md

# 24V6A Trip Implementation Plan

> **For agentic workers:** Use superpowers:executing-plans inline; final fresh review.

**Goal:** 按用户指令设置24V档采样过流6A，参考仍1A。
**Architecture:** 既有受限配置宏和OLED身份，控制算法保持。
**Tech Stack:** STM32G474/Keil6.18/GCC。
**Spec:** docs/superpowers/specs/2026-10-29-bench24-oc6-design.md

## Global Constraints

只用bench12_buck_fast；保留IDE状态/旧12V回归；不重放功率启动；先保存故障8现场。

## Review Focus

- 6A是采样门限，1A参考未变；旧配置隔离。
- 6A在ADC可表示范围，量程端点/反向/启动保护保持。
- 6A相邻ADC码首次关断及锁存，原名义模型峰值要求保持。
- 21列新身份可区分旧版，烧录AXF/HEX一致，板测状态不混淆。

## Task 1: 门限与身份

- [x] 写1.652746A通过及6A相邻ADC码用例，旧1.5A保护RED。
- [x] 新身份RED，24V宏改6A并GREEN，旧配置回归。

## Task 2: 验证与交付

- [x] 完整主机、ARM/CCM/链接检查和独立审查。
- [x] 保存故障8证据、更新记录；按长期约定提交推送，结果在交付消息核对。
- [x] 用户最新要求无需助手控制电脑下载：交付已验证固件供用户自行烧录，本轮未下载/启动。
