meetyaothenstop/vscode/docs/superpowers/plans/2026-10-29-bench24.md

# 24V Buck Implementation Plan

> **For agentic workers:** REQUIRED SUB-SKILL: Use superpowers:executing-plans for inline execution, with focused independent test work and final fresh review. Checkboxes track completion.

**Goal:** 在唯一FAST工程准备24V→12V受限测试，并保留12V回归。
**Architecture:** 配置开关限定24V档；后端消费现有配置宏，菜单消费默认输入/输出。
**Tech Stack:** STM32G474/HAL/Keil6.18、GCC主机回归。
**Spec:** docs/superpowers/specs/2026-10-29-bench24-design.md

## Global Constraints

- 保留既有IDE未提交改动；不新增工程、二进制或IDE状态提交。
- 20–28V输入、1–12V目标、14/12输出保护比；24V档参考1A/采样过流1.5A。
  旧12V档参考0.5A，启动门限、PI、ADC、DMA、840/936保持。
- 当前板运行状态不由旧确认继承，下载前取得本次STOP确认；24V上电由用户执行。

## Review Focus

- 编译默认值/旧FAST显式0/非FAST隔离；旧测试不可因新档位静默失效。
- 输入请求、预充电、使能、运行、调试命令均使用一致门限和目标。
- 14V附近ADC量化及低目标比例、首次故障快照不被放宽。
- 真实24V开关模型与输入/电流采样相位；不能只验证12V运行后改宏。
- OLED帧宽、菜单默认24/12、运行实时显示与STOP。

## Task 1: 配置与后端

Files: Core/Inc/power_build_config.h; tests/power_control_test.c; tests/run_tests.ps1.

- [x] 增加24V后端用例分支并观测旧配置拒绝24V的RED。
- [x] 实现受限24V配置开关，保留12V显式0和非FAST旧值。
- [x] 运行24V后端GREEN及旧FAST回归；覆盖各保护/命令及错误路径。

## Task 2: 菜单/UI/动态模型与交付

Files: Core/Src/power_menu.c; tests/bench12_menu_test.c; tests/power_ui_test.c;
tests/bench12_switching_test.c; tests/run_tests.ps1; README.md; docs/板上测试记录.md;
docs/Buck优化版测试.md; .superpowers/bench24/manifest.json.

- [x] 菜单24/12身份先RED，改用默认输入宏；实时UI和STOP回归。
- [x] 使用24V/12V实际参数的开关模型，保持旧12V峰值断言。
- [x] 完整主机、ARM构建、CCM/向量/SRAM检查、独立审查。
- [x] 更新反馈与测试步骤/元件额定值待确认。
- 交付：按长期约定提交、推送并核对远程SHA，结果在交付消息报告。
