meetyaothenstop/vscode/docs/superpowers/plans/2026-10-25-bench12-buck.md

# 12 V forward Buck bench implementation plan

> **For agentic workers:** REQUIRED SUB-SKILL: Use superpowers:executing-plans to implement this plan task-by-task. Steps use checkbox (`- [x]`) syntax for tracking.

**Goal:** Generate an isolated, restricted software-protection-only bench image.
**Architecture:** Opt-in build configuration sets operating limits and permits
missing hardware readiness only in this build. Hardware readiness is never
fabricated. Backend validates every start path and checks source voltage
while operating; menu identifies the build and defaults to 12->6 V.
**Tech Stack:** STM32G474 HAL/HRTIM, C11 host tests, Keil Armclang 6.18.
**Spec:** ../specs/2026-10-25-bench12-buck-design.md

## Global Constraints

- POWER_BENCH_12V_BUCK_TEST defaults to 0.
- Test: mode 1 only, input 10.5-13.5 V, output 1-6 V, reference 0.5 A,
  sampled absolute trip 1.5 A; protection_ready stays 0 without comparators.
- Default readiness guard and existing software protections remain active.
- Separate project and output; no hardware download or automatic start.

## Review Focus

- Debugger commands and direct API requests cannot bypass test restrictions.
- Input changing between request acceptance and arming causes shutdown.
- Invalid/nonfinite targets, missing ADC events, and rail currents stop outputs.
- Fault clear/stop never resumes PWM, including pending starts.
- Hardware-readiness display remains truthful; default build is unaffected.

### Task 1: Restricted build and integration verification

Files: create Core/Inc/power_build_config.h and
MDK-ARM/bench12_buck.uvprojx; modify Core/Src/power_control.c,
Core/Src/power_menu.c, tests/power_control_test.c, tests/run_tests.ps1;
add tests/bench12_menu_test.c and docs/12V正向Buck测试.md.

Interfaces: existing Power_RequestStart, Power_TimerIRQ, Power_Service and
Menu_Init/Menu_Render stay unchanged. Compiler define selects the profile.

- [x] Add bench integration tests using the existing synthetic register
  fixture: readiness remains 0; valid 12->6 starts; all other modes, >6 V,
  out-of-range source and invalid targets reject; 1.6 A / ADC rails / lost
  samples / timing / overvoltage / negative polarity stop and latch.
- [x] Add menu test for forward 12->6 and visible SW label.
- [x] Run tests with the test macro before production edits; expect the
  valid ADC-only start and menu defaults to fail.
- [x] Implement the build flag, limits, backend gate and menu profile.
- [x] Run tests/run_tests.ps1; expect all default and bench groups PASS.
- [x] Create separate Keil profile/output and usage document; rebuild
  default and bench profiles; expect 0 errors and 0 warnings.
- [x] Review the full change and record output hashes and remaining board
  checks. No commit: this workspace is not a Git repository.
