meetyaothenstop/vscode/docs/superpowers/plans/2026-10-26-ccm-base.md

# Uninstrumented CCM Validation Plan

> **For agentic workers:** REQUIRED SUB-SKILL: Use superpowers:executing-plans to implement this plan task-by-task. Steps use checkbox (`- [ ]`) syntax for tracking.

**Goal:** Measure CCM control with unified probes compiled out and protections intact.
**Architecture:** Separate target sharing the CCM scatter; canonical first-fault data remains.
**Tech Stack:** STM32G474CB, C, Armclang6.18, PowerShell/gcc.
**Spec:** `docs/superpowers/specs/2026-10-26-ccm-base-design.md`

## Global Constraints

- Keep bench10.5..13.5V input,1..6V target,.5A reference,1.5A trip,.25A/.25V startup checks,840/936-cycle deadlines.
- Keep150MHz CPU/150kHz PWM, ADC trigger, controller and gate sequencing.
- Keep Flash-backed CCM copy and96KiB ordinary SRAM; no hardware download/start.

## Review Focus

- Disabling profiler must not disable timing/ADC/current protection or snapshot latching.
- CCM identity must remain gated by restricted bench/mute even without unified probes.
- No debugger references to absent power_diag symbols in baseline Watch.
- Actual map must exclude probe storage/functions and retain valid startup copy/vector.
- Runtime margin cannot be concluded from compilation or a phase-mismatched screenshot.

### Task1: Gated baseline configuration and delivery

**Files:** build config/menu, bench menu test/runner, new bench12_ccm_base project/options,
CCM artifact checker and docs. No changes to controller/power_control sources.

- [x] Add baseline host/menu cases and observe RED on old guard/identity.
- [x] Implement restricted guard/identity and prepare target with profiler0.
- [x] Compile ARM, verify CCM/no-probe map and copy/vector HEX, run full host suite.
- [x] Independent review, preserve measurements/baseline hashes and deliver one-run instructions.
