meetyaothenstop/vscode/docs/superpowers/plans/2026-10-26-fast-buck.md

# Restricted Buck computation pruning

User authorized continuation of software debugging. No hardware download/start.

Evidence: CCM BASE screenshot a65751c7: fault64/detail3, elapsed931,
spacing1000, counter31744, reference0.1V, output0.01732325V, current0.028059A.
At150MHz elapsed6.207us exceeds840-cycle write deadline by91cycles. Previous
S9 screenshot d2c80f4c is a separate attempt: output0.346465V >0.25V,
current-0.077021A; no control step. No sampling-threshold change justified.

Design: opt-in POWER_BENCH_FAST_BUCK only with bench, OLED mute and CCM.
Compile out inactive Boost/precharge calculations in the existing forward_step
body; preserve active Buck arithmetic, filter, PI, anti-windup, ramp and order.
Reject any non-Buck input mode and latch error until initialization. Inactive
Boost debug state is not maintained. Default/general controller stays intact.
Separate bench12_buck_fast target, same CCM linker layout, no timing probes.
PWM, ADC, running current and timing protection stay unchanged.

User steering during implementation: explicitly set preparation current
absolute limit to0.5A and output limit to1V. Implement only in the new fast
bench image, consistently for request/initial bootstrap/arming. Keep strict
current comparison, inclusive voltage comparison, and HOLD-resume0.25A.
This relaxes cold-start acceptance; it does not correct the unexplained
output sampling or establish safety of a charged-output start on the board.

Alternatives: relaxing deadline is rejected (counter already31744/32000).
Slower outer loop would require control redesign, deferred while unused work
can be removed without changing accepted Buck trajectories.

Steps:
1. Add reference-implementation trajectory comparison and non-Buck rejection
   tests; observe rejection fail before implementation.
2. Prune inactive branches, add guarded build and OLED identity.
3. Run full host suite, build ARM, verify CCM vector/copy and uninstrumented image.
4. Review changes; deliver exact project and manual board verification steps.

Host comparison must cover cold start, restarts, target clamps, saturation and
transient inputs. It cannot prove ARM cycle budget or real electrical behavior.

Completed software verification: all25 host groups PASS, including540000
bitwise Buck samples. Keil rebuild0errors0warnings; CCM copy/vector and
uninstrumented checks PASS. Controller code1496->696bytes. Baseline HEX
unchanged. Independent read-only reviewer found no actionable P0-P2 issues.
User guide: docs/Buck优化版测试.md. Board timing/electrical result remains pending.
