meetyaothenstop/vscode/docs/版本与备份对照.md

# 固件版本与修改前备份对照

主工程固定为`MDK-ARM/bidreaction.uvprojx`，唯一受限bench为`bench12_buck_fast.uvprojx`。
历史工程共享源码，打开旧uvprojx不能恢复旧算法；复现版本要在独立检出目录使用对应Git标签重建。
IDE界面状态、Flash首选项、临时排查文件和可重建二进制不作为源码版本提交。

|标签|性质及对应修改|源码提交|已知验证/实板边界|
|---|---|---|---|
|main-reverse-boost-align-20261109|反向Boost保护对齐正向、计算改25/5kHz；保留旧反向0.8/10、完整前馈、99%预充、HOLD|9fa695f|86组、ARM0/0；未证明实板稳定|
|pre-reverse-boost-uv7-20261109|降低欠压到7V之前，保存用户反向12→18V默认|e197a11|此时反向欠压仍9V|
|main-reverse-boost-uv7-20261109|仅反向Boost欠压9→7V，其余三模式9V；控制算法仍旧反向|d023414|86组、ARM0/0；用户后报可RUNNING但约16V且抖动|
|pre-reverse-forward-control-20261110|**本次完整替换反向控制之前的回退点**：旧反向控制、mode4欠压7V、默认反向12→18V；含16V排查文档|d000bfb0218a561984a27f3e56d5e5f3fb1ae33e|2026-11-10编辑前已上传并核对远端；固件源码与d023414相同|
|main-reverse-forward-control-20261110|**FCTRL1：MAIN反向Buck/Boost全套共用正向初始化/PI/前馈/预充/软启动，独立状态，移除MAIN旧HOLD/恢复**；mode4欠压7V保持|69f9cd5bd3550b5aea11a124b42e82be39fc452c|89组、144万步状态比对、ARM0/0及独立审查；12V输入模型闭环，24/35→36V模型按原过流保护关断；实板待验|

## 本次修改前固件指纹

`pre-reverse-forward-control-20261110`对应生产源码没有未提交改动。
以下是编辑前磁盘映像指纹；不宣称已核对板上Flash：

```text
主HEX SHA256：54B96039A64A9CFA48E7ABD7A8A880C63BCA93AA66AE67188BF7F5E18FC23479
主AXF SHA256：AD6744977400927DCD830305DA732E193771122A5393DED38A28CA3F5EC0B5EE
bench HEX SHA256：A9BA257BA3FFBB49C8FAED9803E3462671F692A9B4D063C9975512D09EF6D451
```

## FCTRL1交付映像与选择方法

```text
主HEX SHA256：8335E0910AECE02CA2D87E3F88C80C4CA665CDF798BE3172CDD0171EAA39390F
主AXF SHA256：C0CBC8C4D726A072A1DC63CB7E70053F16B20978B98B2AF8035055DD9046352B
bench HEX SHA256：A9BA257BA3FFBB49C8FAED9803E3462671F692A9B4D063C9975512D09EF6D451（保持）
```

- 需要回到“旧反向7V、约16V抖动待查”：用`pre-reverse-forward-control-20261110`。
- 需要本次“全套共用正向控制”：用`main-reverse-forward-control-20261110`，页面FCTRL1。
- 需要回到“欠压降至7V之前”：用`pre-reverse-boost-uv7-20261109`。

`标签^{}`是Git对注释标签所固定源码提交的解析表达式，不是另一个可变分支。
备份不覆盖、不移位；源码、验证和限制详见[反向共用正向控制测试](反向共用正向控制测试-20261110.md)。

2026-11-11只新增[接管输入冲击机制分析](Boost接管输入冲击机制-20261111.md)，没有新固件版本或标签变动。
