meetyaothenstop/vscode/.superpowers/bench24-oc6/review.md

# Final fresh review

Reviewer bench24_oc6_review,gpt-6-astra/high;selected6aea1de→workingtree read-only.
Code approved; noCritical/Important. Confirmed24-only6A/ref1A,old12/nonbenchunchanged,
inclusivecomparison,positiveADC3822/3823boundaries,endpoint/reverseguards,
firstfault/outputoff/latchtests,21-columnidentityandunchangednominal1.5Amodelguard.
Saved32group/ARMlogsinspected;zeroerrors/warningsandsizesconfirmed.

One editorial provenance correction: old1.5Aflashparagraph referredto“上述哈希”nowpointingto
new6Acandidate. Replacedwith explicitoldF07116B02C42882430DAC75602AEECB8F07C36F70CA7D4FD1BD4841EB189E631
beforecommit. RequiredtoaccuratelykeepREADMEfirmwarehistory; nocodechange ornewtestneeded.

Physicalcurrentaccuracy/peak/readiness/timing/startupstability/rootcauseremainunverified;
6Athresholdisuser-directedexperiment,notproofofmisreportorrootfix. No deferrednewcodefindings.
