meetyaothenstop/vscode/.superpowers/bench-fault-diagnostics/review.md

# Read-only diagnostic review

Reviewer /root/review_fault_diag: no Important or Critical findings.
Checked output-disable ordering, foreground snapshot PRIMASK coverage,
priority-0 HRTIM timer/fault serialization, fault clearing without restart,
unchanged guards and truthful readiness. Review did not modify files.

Minor deferred: diagnostic T1/T2 selection duplicates the existing1256-cycle
spacing threshold. It matches today; share the constant if that threshold
is changed later to prevent mislabeled details. It does not alter protection.

Declined physical latency, actual CPU timing, analog accuracy and root-cause
claims. Disposition: these remain unverified; the diagnostic image gathers
evidence instead of asserting a fix. No protection thresholds were relaxed.

Final evidence: full15-group host suite PASS, both Keil builds0 errors/
0 warnings. Bench disassembly saved in bench_disassembly.txt; its
Power_RequestStart stores readiness but contains no readiness rejection
branch before the fault-pending check. The default build still has that guard.
Final image hashes and sizes are recorded in diagnosis.md.
