meetyaothenstop/vscode/.superpowers/start1a3v/review.md

# Independent startup1A/3V review

Fresh read-only reviewer review_start1a3v: ready to commit/push, no Critical,
Important or Minor findings. Confirmed mode1-only selection, common request
checks and IRQ cache before publication, strict current/inclusive voltage,
rechecks before all cold preparation enables, retained reverse priority and
immutable first fault. Tests cover request/ADC boundaries and other profiles.
Identity fits21 columns; current docs and manifest agree with the candidate.

Reviewer independently ran completed MAIN control/guard/phase/menu/UI exes
with exit0, counted47 suite groups, checked clean main/bench ARM logs and
verified actual HEX/AXF/bench fingerprints against the manifest.

Declined to judge board startup/transients/S8 physical cause, hardware WCET
and OCP readiness due to no board evidence. These remain explicitly unverified.
Preexisting bench project/IDE edits are excluded. Commit/push verification
remains root's responsibility after this read-only review. No files or
hardware changed by reviewer.
