meetyaothenstop/vscode/.superpowers/main-forward-ovp15/review.md

# Focused independent review

Reviewer review_forward_ovp15 inspected source/test diffs againsta32304c and
the design. No Critical or Important code defect; no actionable Minor code item.
Confirmed MAIN forward-only cached selection beforeDMB/start_pending, reverse
and Boost/bench scope preservation, first-fault boundary tests, and21-column IDs.

Pending documentation finding resolved by root before handoff: README and new
test record/manifest now state mode ratios, identities, actual current evidence,
54V-vs50V limitation and hardware-unverified/current24V experiment scope.

Reviewer did not rerun the suite or certify placement/WCET/physical safety.
Root separately completed47-group run in this directory's suite.log, ARM main/
bench builds, actual image/CCM/DMA checks, AXF export match, ARM mode ratio
selection and home immediate-store decoding. tests/main_forward_full_suite.log
is stale history and is excluded from this release's verification evidence.

The first ad-hoc contiguous-home-string search failed because ARM emitted the
home text as immediate stores. Source was not changed to satisfy that search;
the actual store instructions decode toMAIN ADC OVP1.5 6A, and M-OV1.5 is also
present in actual HEX. This was a verification-method correction, not a firmware
test failure or evidence of stale code. Electrical/board timing claims remain unmade.
