meetyaothenstop/vscode/.superpowers/main-opt2/review.md

# Final review — OPT2

Fresh read-only reviewer: `main_opt2_review_resume`, base dd3e6ff to selected
working-tree changes. Previous `main_opt2_review` stopped on usage limits without
findings; this replacement completed the final review.

Verdict: acceptable for OPT2 firmware handoff; no Critical, Important or Minor
findings. The compare-only adapter validates before writing either output and
its local full plan is initialized on success. The IRQ only consumes initialized
comparison fields. HOLD retains both consumed comparisons; static initialization
keeps the later resume copy safe, with mode/start reset handling intact.
Forward expressions/null policy, generic/reverse behavior, include/config order
and enable sequencing are preserved.

Fresh resumed host run:46/46 PASS in host-tests-resume.log. Reviewed final main
and bench zero-error/warning ARM logs. Actual main HEX, AXF, exported HEX and
bench HEX match manifest. Actual Buck assembly has no mapper call and stores
only comparison results, not unused duty fields. No cycle saving is inferred
from instruction count or code size.

Reviewer declined to judge OPT2 actual timing savings or T4 elimination; root
agrees these require user board measurements. Review performed no writes,
builds, tests or hardware actions. No deferred findings or second review needed.

Delivery: commit/push selected source, tests and documents plus candidate tag;
verify remote branch and annotated tag point to HEAD before reporting upload.
The user operates downloads. No board actions are part of this handoff.
