meetyaothenstop/vscode/.superpowers/main-opt/review.md

# Final review — 2026-10-30

Fresh read-only reviewer: `main_opt_review`; base8dc59c7 to selected working tree.
Verdict: approve as behavior-preserving optimization candidate. No Critical,
Important or Minor findings.

Source and ARM disassembly confirm all five cached values are written before
the existing DMB/start_pending publication. STOPPED IRQs return before using
them; fault-interrupted initialization still fails the final commit check.
Threshold comparisons, fresh sample checks, first fault, .95 reachability and
gate sequencing retain semantics. Main mode1 guarantees BOOST_RUN=0, making the
fixed-Buck entry equivalent to the shared generic implementation.

46 groups pass; main/bench ARM builds have zero errors/warnings. Actual main
HEX/AXF and bench HEX hashes independently match manifest. Bench hash unchanged.
Main image checker covers new mapper/all modes/CCM copy/vectors/no probes/DMA.
Static code sizes are not timing measurements. Reviewer declined to judge
board timing improvement or electrical behavior; root agrees these remain open.
No hardware actions or builds by reviewer. Root only expanded/scrolled Watch
in the existing debug session before preparing files; user operates downloads.

Missing specialized API and OPT identity observed RED before implementation;
mapping equivalence and old protection/mode regressions GREEN. The cache
refactor uses existing adjacent-ADC and cross-target/mode coverage, not a fake
host cycle benchmark. A first full runner stopped at stale UI identity tests;
those expectations were updated and the final complete46-group run passed.
One bench build invocation used the wrong target label; the corrected XML-based
invocation rebuilt successfully. No product change was made for that tool error.

Delivery: commit and push the selected files and candidate tag; verify remote
branch/tag SHAs before reporting upload. Native board timing remains unverified.
