meetyaothenstop/vscode/.superpowers/main-timing/review.md

# Review and verification — 2026-10-30

Fresh read-only review by `main_t3_diag_review`: approve diagnostic candidate;
no Critical/Important findings. Verified scope, first-control partial-profile
regression, unchanged control/protection/timing behavior, honest diagnostic docs,
45 passing host groups, main ARM logs and firmware fingerprints.

One minor test gap: the diagnostic identity assertion assumed ADC-only policy,
although the capability also permits guarded main diagnostics. Root reproduced
the guard identity failure, then made the expectation respect the software-only
flag. Focused guarded identity and full 45-case runner are checked after this
test-only correction. Production files/binary are unaffected by the correction.
Hardware readiness, board timing/hotspots and T3 resolution remain unverified.

RED: main diagnostic compile rejected by old bench-only guard; after enabling
the capability, diagnostic menu identity assertion failed on the old normal
title. GREEN: capability and diagnostic identities pass; first control fault
test confirms ARMING entry/RUNNING captured state, mask63, immutable coherent
first record and output disable. No board operations or project copies.
