meetyaothenstop/vscode/.superpowers/main-buck/review.md

# Final review — 2026-10-30

Fresh independent reviewer: `main_final_review_resume` (GPT-6 Astra).
The previous reviewer had stopped on usage limits without a verdict.
Scope: base `c59df1c` to selected main-integration working-tree changes.

Verdict: approved, no Critical or Important code findings. The reviewer confirmed
zero/-zero all-off and fault preservation, four-mode dispatch, mode-specific
limits, ADC phase/freshness handling, template equivalence with original step
non-comment tokens, 43 passing host groups, main/bench ARM logs and actual main
HEX CCM/DMA image checks.

One minor finding: README's later build section still named the bench image as
the primary HEX. Root reproduced that contradiction and corrected primary output
to `MDK-ARM/bidreaction/bidreaction.hex`, explicitly labeling the bench image as
reference. This is required delivery correctness; only documentation changed.

Declined to judge: hardware OCP wiring/readiness, board timing, electrical
stability, full-load capability and flashing outcome. Root agrees those remain
unverified and preserves that limitation in README/manual/manifest. No board
actions occurred. No deferred code findings, no second review requested.
