meetyaothenstop/vscode/.superpowers/bench24/review.md

# Fresh-context final review

Reviewer bench24_final_review (gpt-6-astra, high), read-only selected9799a57→workingtree,
including config/menu/tests/spec/plan and updated delivery docs. No Critical/Important findings.
Verdict: suitable offline candidate for the proposed24V→12V default configuration.

Strengths: guardedFAST-only config and old explicit0 regressions; shared request/IRQ thresholds;
real24V switching plant/controller/PWM/samplephase; ADCcodeOVP firstfault and proportional tests;
startup/ADC/timing/STOP; 21-column identities and liveUI busySTOP; honest physical/model boundaries.

Minor deferred: optional FAST override test compatibility. New24V backend test calls
late_input_sampling/init_failures unguarded, so compiling that test withLATE_INPUT_ADC=0
fails, although active default late-input=1 compiles/passes. New24V menu test assumesDMA
identity whenLIVE_OLED=0; production correctly rendersFAST identity. Default32groups and
activefirmware unaffected; comparison-test guards/title expectation are follow-up work.

Declined-to-judge decisions:
- Hardware calibration/ratings/instantaneouscurrent/ISRtiming remain unverified; no24Vboardrun.
- Dynamic behavior at every accepted1–12Vtarget/load is not demonstrated: model checks12V/100Ω
  at20/24/28V; lower-target tests establish protection semantics only. No broaderclaim.
- ExistingdirtyIDEsettings/unrelatedscratch remain excluded and preserved.

Executor evidence:32/32hostPASS, ARM6.18zeroerrors/warnings, actualHEXCCM/copy/vector,
displayvectors/SRAMPASS. No product changes after those checks or review.
