meetyaothenstop/vscode/.superpowers/live-oled/progress.md

# SDD ledger — plan: docs/superpowers/plans/2026-10-29-live-oled.md

Base: 82e7f81. Existing dirty uvprojx/uvoptx and untracked directories are unrelated.
Ruling: continue existing codex branch/checkout, no copied project — one active Keil project.
Ruling: existing 200ms display interval and new asynchronous transport fulfill the reported
stale display issue; no firmware download on a currently running board.
Ruling: raw Master_Transmit_DMA includes SSD1306 control byte — local Mem_Write_DMA
contains polling; callbacks only mark state and foreground schedules the next packet.
Ruling: stuck/error display latches offline until reset — never wait/abort synchronously
or reuse DMA buffers on a failed bus; keys/control continue.

Task 1: complete — original blocking driver RED at DMA initialization assertion;
new packet/snapshot/drain/error/timeout/rollover/IRQ tests GREEN. Existing renderer PASS.
Task 2: implementation complete — original active mute RED at RUNNING page count;
new UI test GREEN including 5.90→6.00 V, busy STOP, startup, error and transition page 0.
Verification: full host suite 27/27 PASS; ARM 6.18 rebuild 0 errors / 0 warnings;
Code40324 RO1288 RW32 ZI4264. Board untouched; independent review pending.
Verification: expanded suite 28/28 PASS, including FAST explicit LIVE=0 mute regression.
CCM/vector/copy/uninstrumented PASS3384 bytes at0x10000000 loaded0x08009554.
LiveOled linked-image check PASS: all3 real vectors and immutable buffers in ordinary SRAM.
HEX SHA25695AB7FD904E53866CF4A2C5EE7DA6EF4D0D3C2F06EAD958CCBE6486474F819DE.
Final review: fresh gpt-6-astra; one Important (HAL_BUSY latched offline), no Critical/minor.
Final: fixed BUSY handling — driver command/data repeated BUSY→success, snapshot,
startup cancellation and data retry deadline regression RED→GREEN; full rerun pending.
Final: Ruling: board-dependent cadence/timing remains unverified; linked vectors/SRAM
are executor-verified. Risk: actual board may still hit display errors or timing protection.
Final: Ruling: legacy full-refresh helpers stay outside active live PowerUI (header contract);
boot blocking-write policy unchanged before power startup. Risk: future callers must use
Poll/RefreshPage rather than legacy helpers in live mode.
Final: Ruling: document review exclusions resolved with candidate status/test records;
existing IDE/power code remains outside scope, preserving the running board and user state.
Final verification after fix: full28/28 host PASS, ARM6.18 zero errors/warnings;
Code40412 RO1288 RW32 ZI4264. CCM3384 bytes loaded0x080095AC,
all3 display vectors/SRAM checks PASS. Final HEX
9444BC857DAE17ED4159AE13CA9BB7AD78FC476571A9F70DAEE89ED407FFC924.
Task 2: complete — review fix verified, README/test/board records updated.
Delivery: retain existing feature branch, explicit selected-file commit and same-repo
HTTPS push authorized by standing user agreement. Do not stage unrelated IDE state or binaries.
