meetyaothenstop/vscode/.superpowers/live-oled/review.md

# Final fresh-context review

Reviewer: live_oled_final_review (gpt-6-astra, high), read-only selected changes
from82e7f81 to working tree; design/plan and local HAL inspected.

Strengths: independent static page buffers, deferred foreground chaining, keys/STOP
before transport, page0 transition redraw, nonblocking HAL error handling,
display priority3 preemptible by control0, no shared-clock reset or buffer reuse on error.

Important: HAL_BUSY before submission was treated as permanent offline at both
Master_Transmit_DMA calls. Local HAL returns BUSY without submitting. UI tests
did not exercise driver-level BUSY. Critical/minor findings: none.

Fix: regression injected repeated BUSY at command and data submission, then success,
immutable data retry, startup cancellation and bounded data wait. Original code RED
at command BUSY assertion. Updated code GREEN: command not accepted returns BUSY
and retains UI page; data preserves its snapshot and retries from foreground within
50ms. Genuine errors and expired data deadline still latch offline.

Declined-to-judge decisions:
- Physical compatibility/cadence/control timing remain board measurements; no board claims.
- Executor separately inspected actual ARM image vectors/SRAM with verified build script.
- Legacy synchronous full-refresh helpers are excluded from active live PowerUI; header
  documents the restriction. Only RAM DrawStr plus Poll/RefreshPage are used in this path.
- Existing blocking boot writes ignore I2C failures; unchanged before power startup;
  runtime new transport handles errors. Boot API rewrite is outside this display fix.
- README/test record completeness: executor updated identities, unflashed status,
  user-reported6V, build/hash and next board measurements.
- Existing dirty IDE settings/power algorithms are excluded and preserved.

Final disposition: Important finding addressed RED→GREEN; full28/28 regression PASS,
ARM6.18 zero errors/warnings, CCM and actual OLED vectors/SRAM checks PASS after fix.
No second review, per executing-plans single fix pass. Board remains unflashed this task.
