meetyaothenstop/vscode/docs/previews/oled-menu.png

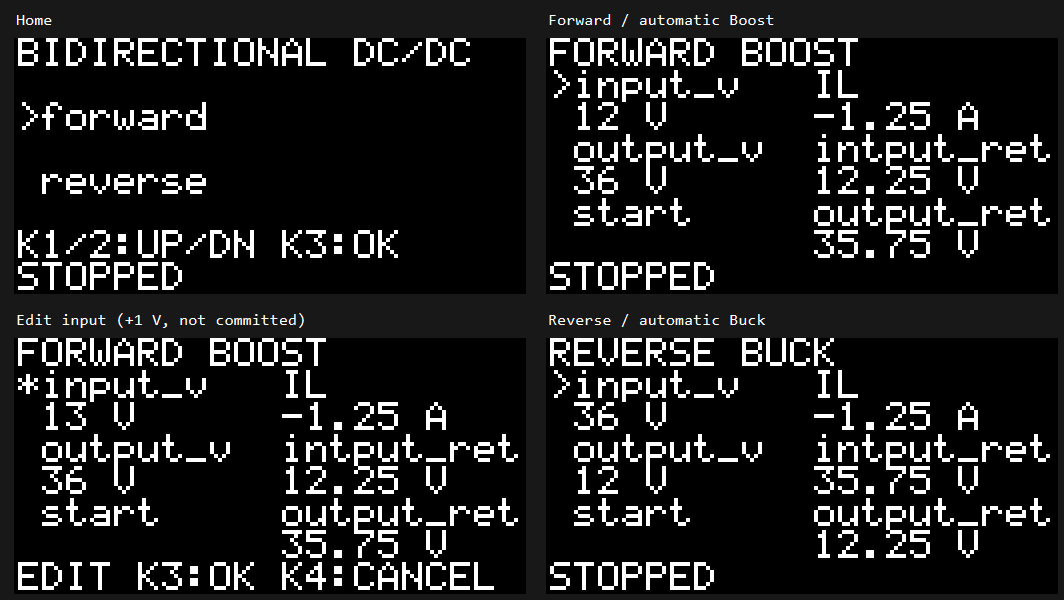
docs/previews/oled-menu.png
