meetyaothenstop/vscode/docs/故障报错对照清单-20261109.md

# 故障报错对照清单

整理日期：2026-11-09。依据《双向buckboost.md》历史记录及当前故障代码；本日后续已按用户要求将反向Boost门限和控制频率对齐正向Boost，未操作板子。

**“触发条件”是代码已经确认的判断；“物理原因”可能仍需测量。不要把保护被触发，直接等同于硬件已经损坏或采样一定误报。** 下表包含实际反馈；后面的完整S/T表供查阅，不表示每个子码都已在板上出现。

## 一、先看当前门限，避免混用历史版本

2026-11-10当前控制版为`main-reverse-forward-control-20261110`（FCTRL1），MAIN反向已完整共用正向算法并取消旧HOLD调节，见[替换测试记录](反向共用正向控制测试-20261110.md)。下表电气门限保持，反向Boost7V仍是试验配置。此前`main-reverse-boost-uv7-20261109`及同日早先对齐版属于旧反向算法，板上固件身份应单独核对。

|项目|MAIN正向Buck、正向Boost、反向Buck|MAIN反向Boost|
|---|---|---|
|输入电压保护|9～42V|7～42V（用户要求试验）|
|冷启动电流互锁|电感电流绝对值严格小于1A|严格小于1A|
|冷启动输出残压|不超过3V|不超过3V|
|过压线|min(max(最终目标×1.5,6V),40V)|相同|
|采样绝对过流线|7.5A|7.5A|
|运行电流参考上限|6A|6A|

正反Boost均25/5kHz计算，两个Buck50/10kHz；PWM/ADC/快速保护仍150kHz。

Buck还要求目标≤实际输入×0.95；Boost目标必须高于实际输入。以上启动1A、运行参考6A、采样过流7.5A和台式电源CC限流0.7/0.9A是不同概念。
受限bench使用独立策略：当前24V FAST配置输入20～28V、采样过流6A，电流参考仍1A；12V FAST配置输入10～14V、采样过流1.5A。不能套用MAIN门限。

## 二、你实际提过的报错与排查结论

|报错或显示|代码直接触发条件|这次/历史排查中已确认或待确认的原因|
|---|---|---|
|**1**|ADC样本无效：ADC1注入序列缺JEOS、队列溢出，或需要的ADC2延后样本缺失/溢出。|反向启动曾锁存ADC1入口只有ADRDY、缺JEOS，尚未投入正常PI；已定位到ADC有效性分支。究竟是触发、转换、清标志时序还是其他原因，尚未实板唯一确认。|
|**2 IN13.53V**（旧台架）|输入超过当时13.5V上限。|13.53V越过旧软件边界；该次输入尖峰是真实波形还是采样偏差没有确定。后来12V FAST范围放宽到10～14V。|
|**2 IN10.31V**（旧台架）|输入低于当时10.5V下限。|10.31V越过旧下限，独立于上一行的另一尝试；不能拼成同一波形。|
|**2 IN9.9V**（正向Boost）|输入低于当时MAIN的10V下限。|当时Buck用ADC2、Boost用较早ADC1样本，来源差异已由代码和合成输入复现。后来两正向模式统一ADC2，欠压又改为9V；原现场是真实瞬降还是干扰仍未确认。|
|**2 IN8.99V**（12→36V）|输入ADC换算值低于当前9V下限。|100Ω负载下36V需12.96W；12V输入理想至少1.08A，按90%效率约1.20A。电源限流0.7A、后来0.9A均不足以维持该稳态，输入限流/压降应优先检查；尚无CC指示或板端瞬态波形证明唯一根因。|
|**2 IN8.99V**（右侧反向12→18V）|当时反向Boost9V版本采到低于9V的输入。|用户确认限流0.9A、100Ω；18V稳态需3.24W，12V/90%估算输入0.30A，不能单凭0.9A认定稳态供电不足。真实瞬降与ADC干扰未区分；后续按用户要求仅mode4欠压改7V试验。|
|**4**|输出采样超过该版本过压线。|旧6V台架有一次实际启动峰6.6875V，超过当时6.6V保护线，示波器支持真实过冲。后续其他版本报4仍须看各自首包；当前MAIN目标6V的过压线是9V，不能把旧6.6V线当成现值。|
|**8**（历史24V台架）|采样电流绝对值达到该版本过流线，或电流ADC接近量程两端。|用户曾在24→12V试验报8并要求6A采样停机线；受限24V台架因此改为6A，参考仍1A。它不是“输出平均电流必定达到6A”，真实峰值与采样干扰需结合波形。当前MAIN采样线为7.5A。|
|**16**|电流方向保护：正向IL<−1A立即触发；反向IL>+1A连续16个PWM样本触发。|反向有效首包曾有+1.232A、+1.006A的异常正电流。已确认满足软件方向条件；真实回流、采样尖峰或偏置尚未区分。反向正常传能的IL符号应为负。|
|**64 T3**|写PWM比较值前，相对本次快速IRQ起点已超过840个CPU周期。|历史首控制步出现过855周期、931周期等越线，属于写前时间预算不足；具体耗时受版本和路径影响，不能一律归因于OLED或某一个PI运算。|
|**64 T4**|写PWM比较值时，HRTIM绝对相位已超过允许窗口。|历史反向Buck有792/1000/27232的现场：相对耗时未超840，但27232超过当时26880相位线。当前MAIN Buck相位线27904，Boost26880。|
|**64 T5**|快速IRQ退出检查时，相对耗时或模式对应的绝对相位超限。|历史反向HOLD恢复现场907/1000/31072：907未超936，但31072超过退出相位29952。已确认是恢复后开低侧的路径过晚，后来做分步恢复；为何先进入HOLD及电压下跌仍不是由该时序记录唯一解释。|
|**64 T7**|上一后台控制请求尚未完成/发布，就已到下一次请求截止时刻。|旧50/10kHz Boost有效首包约3388周期=22.59μs，超过20μs请求窗口。OPT1精简后用户仍报T7，后来正向Boost改25/5kHz、窗口40μs。未独立确认所有实板工况T7已消失。|
|**128 S7**|启动模式、目标与实测输入关系不符：Boost目标≤输入；Buck目标≥输入，或MAIN Buck目标>输入×0.95。|最新在电源限流提高到0.9A后出现，但S7检查的是电压关系，不是电流。真实mode、请求目标、ADC输入及板上固件尚未核对，原因待查。若确为Boost、目标36V、实测12V，这条关系本应通过。|
|**128 S8**|请求被接受后，待启动/冷启动自举/装载阶段的新样本电流不满足启动互锁。|旧Boost曾用0.25A门限，之后MAIN共享改为严格<1A。原先超门限的原因可能是未消退电流、偏置、真实瞬态或采样扰动，不能仅凭S8选定物理原因；也不是运行7.5A过流。|
|**128 S9**|上述冷启动阶段，输出采样超过允许残压。|旧版现场有0.346V、0.589V、1.646V等，分别会超过当时0.25V或1V门限。当前MAIN共享残压≤3V；曾经拒绝是按当时边界工作，残压由未放电、回灌还是采样偏差造成仍需区分。|

## 三、128 S1～S9完整对照

128表示启动拒绝或启动阶段复查不通过，S编号说明具体原因。该表是完整代码参考，不表示你实际遇到过全部九项。

|子码|触发条件|核对重点|
|---|---|---|
|S1|模式编号非法，或受限bench不支持所选模式。|MAIN mode1/2/3/4分别为正向Buck/Boost、反向Buck/Boost。|
|S2|样本不足两组或所需采样无效。|新鲜样本及ADC标志；不是“输入电压等于2V”。|
|S3|目标不在允许区间，包括NaN/无穷等非法目标。|MAIN Boost目标须在1～36V；Buck的0V是特定关断命令。|
|S4|启动请求时实际输入超出输入保护窗口。|MAIN反向Boost7～42V试验，其他三模式9～42V；检查ADC而不只看菜单设定。|
|S5|启动请求入口电流绝对值不满足启动互锁。|MAIN共享<1A；与S8判断时机不同。|
|S6|启动请求入口输出残压过高。|MAIN共享≤3V；与S9判断时机不同。|
|S7|启动模式/目标相对实际输入不合理。|Boost目标必须高于输入；MAIN Buck目标≤输入×0.95。|
|S8|请求接受后，待启动/自举/装载期间新采样电流超启动互锁。|看当次fault_il，不能用电源面板CC设置代替电感电流采样。|
|S9|同阶段电流检查通过，但输出残压超限。|看当次fault_v_left/right；停机后实时电压可能已经变化。|

重要区别：S5/S6是请求入口，S8/S9是接受请求后的新采样复查。仅在菜单输入框改电压，不会强行改变实际ADC测值。

## 四、64 T1～T7完整对照

时序值按当前150MHz CPU、150kHz PWM说明；旧截图应对照其所属版本。T1/T2/T6在历史文档中也有定义，以下完整列出，不据此认定各项都有可靠实板首包。

|子码|触发条件|直观解释|
|---|---|---|
|T1|相邻快速IRQ入口间隔>1256个CPU周期，约8.37μs。|中断入口间隔过长，可能被阻塞或延迟；并非只看本次函数耗时。|
|T2|快速IRQ入口HRTIM计数>8192ticks，约PWM周期起点后1.71μs。|这次进中断时，在PWM周期中的位置已经太晚。|
|T3|写前IRQ相对耗时>840个CPU周期，约5.60μs。|本次快速处理到写寄存器之前花费过久。|
|T4|写前绝对相位超过模式对应窗口。|MAIN Buck方向27904ticks，Boost26880ticks；历史旧Buck曾用26880。|
|T5|退出相对耗时>936个CPU周期，或MAIN模式对应退出相位超限。|MAIN Buck相位线29952ticks；某些路径耗时未超也可因相位过晚触发。|
|T6|退出检查时发现下一次定时器重复事件REP已经挂起。|处理延续到了下一PWM事件；需要看入口、执行和抢占，不能只归因于某一模块。|
|T7|后台请求在下一请求到来时仍未完成/发布。|MAIN正向Boost窗口40μs（25kHz），其他模式20μs（50kHz）。包括等待与抢占，不等于纯PI时间。|

T1～T6主要约束每个快速PWM中断；T7约束多速率后台请求。把Boost计算降到25kHz，不等于把ADC或快速保护也降到25kHz。

## 五、其他故障码参考

以下是源码定义，未据此断言你实际报过：

|代码|意义|可能触发情况|
|---|---|---|
|32|控制器或PWM规划结果异常。|控制器错误状态、非法占空比、无效计算结果或映射失败。|
|256|硬件保护路径报告故障，或保护初始化失败。|应检查真实故障输入与初始化返回；不代表硬件OCP接线已验证。|
|512|请求启动时保护就绪条件不满足。|当前MAIN允许用户授权的ADC软件保护测试，protection_ready=0可为该策略预期，不能简单改1绕过。|

## 六、你遇到过的Keil/Watch提示

这些属于调试工具问题，不是OLED上的功率保护码。

|提示|含义与已有结论|
|---|---|
|Cannot access Memory|调试器无法可靠读取目标内存。曾有同一fault独立项与结构体矛盾、多个浮点同为异常小数，不能拿残留读数分析电气原因。|
|Cannot access target. Shutting down debug session.|目标连接或访问失败。历史有断电后出现，也有请求暂停时出现；不能统一归因于一个硬件原因，更不能认为CPU已成功暂停。|
|Internal command error|曾与上述访问失败同时出现，是调试命令失败提示；不是新的控制器故障编号。|
|power_diag.fault cannot evaluate / undefined identifier|当前统一诊断可被编译关闭，没有该对象时不能求值属预期；不证明ADC没工作。|
|静态sample_valid或旧Watch表达式cannot evaluate|符号作用域、表达式、优化或AXF不匹配等可能导致无法求值。优先看当前配套AXF的公开power_status，不把它当作ADC故障1。|

## 七、如何对应“原因”而不误判

- fault是位掩码，不是顺序编号。0x40=64，0x10=16；后续故障可能OR入，要优先看首故障。复合数值不能直接套单码名称。
- 优先保存power_status的fault/detail、fault_v_left/right、fault_il、fault_input_volts与fault_raw_*；时序再看fault_elapsed_cycles/fault_spacing_cycles/fault_counter_ticks。
- 看power_event.fault.valid/code/detail/state及ADC专用adc_reason、入口标志；停止后仍更新的实时v_left/v_right不是当时首故障值。
- **S7等请求拒绝时，power_event中的mode/target可能属于上一次配置**：active_mode/active_target在校验通过之后才更新。要结合实际菜单或Power_RequestStart入参确认本次请求。
- 当前固定4.8μs输入采样没有动态避沿；“同样采样频率”也不等于电流/两路电压都在同一个时刻采到。
- 12V、100Ω升36V所需理想输入1.08A已超过0.7/0.9A电源限流；这是已确定的功率预算不足。它不能直接解释S7，CC限流导致瞬降是否就是本次欠压的唯一原因仍需波形证实。

## 依据位置

- Core/Inc/power_control.h：故障位定义。
- Core/Inc/power_build_config.h：当前输入/电流/残压等门限。
- Core/Src/power_control.c：Power_RequestStart的S1～S7、ADC有效性、S8/S9及快速时序检查。
- Core/Src/power_raw_fast.inc：整数快速保护及启动复查。
- Core/Src/power_multirate.inc：后台T7和提交前检查。
- docs/对话接续摘要-2026-11-08.md、最初双向buckboost.md历史：实际报错现场及版本背景。
- docs/反向Buck写入窗口W128测试.md、docs/反向Buck分步恢复测试.md、docs/ADG1故障1定位测试.md等：对应时序与ADC历史现场。

本清单用于解释和追溯，不新增放宽保护、下载、复位或操作电源的授权；也不代表所有物理根因已解决。
