meetyaothenstop/vscode/docs/EVT1反向故障16现场-20261103.md

# EVT1反向12→6V故障16现场

2026-11-03。固件5b242c7c5e41273c6d195c40af8c3acc84c4d62e，标签main-eventdiag1-20261103。
用户沿用反向12→6V、100Ω测试并提供截图；助手在既有已暂停的Keil现场仅添加/展开power_event.fault。
没有运行、暂停、单步、复位、下载、清故障或写目标变量；本次不修改固件，原现场保留。
旧RAW1绝对地址在EVT1中失效，原Watch中0x2000021C等数值不能解释成旧自举变量。

## 首故障锁存

| 字段 | 本次值 |
| --- | --- |
| event.fault.valid / code / detail | 1 / 0x10 / 0 |
| state / mode / run_id / clock_ready | 3=RUNNING / 3=反向Buck / 1 / 1 |
| run_age_cycles / ticks | 0x66AD8982=1722648962周期，即11.484326s / 0x2CDC=11484ms |
| bootstrap_resume / bootstrap_remaining / arming_remaining / resume_pending | 1 / 0 / 0 / 0 |
| polarity_samples | 0x10=16 |
| target / reference / duty | 6V / 4.29981804V / 0.377516657 |
| left_compare / right_compare | 0x6E00 / 0x2BDC |
| power_status.fault_v_left / right / il | 5.45297575V / 12.0396585V / +1.00610352A |
| fault_raw_vh / vl / il | 0x0137 / 0x02B7 / 0x0C85 |
| control_steps / voltage_steps | 0x56C24=355364 / 0x164CD=91341 |

本次明确发生于RUNNING，至少经历过一次HOLD恢复，而非尚未完成的自举/装载等待。
连续16个采样超过反向+1A门限；仅末次原始样本锁存，不等同真实电流波形或平均负载电流。
参考低于输出约1.153V，但末次包不能重建参考变化、恢复次数及电流反转因果链。本次不是T7。

## 前台与界面锁存

| 指标 | 值及换算 |
| --- | --- |
| foreground_age_cycles / ticks | 0x3E5D0=255440周期，1.702933ms / 1ms |
| ui_entry_age_cycles / ticks | 0x3CABC=248508周期，1.656720ms / 1ms |
| ui_progress_age_cycles / ticks | 0x3A78E=239502周期，1.596680ms / 1ms |
| ui_page_age_cycles / ticks | 0x264696=2508438周期，16.722920ms / 0x11=17ms |
| foreground.gap_cycles_max | 0x325ACE=3300046周期，22.000307ms |
| ui.gap_cycles_max | 0x324E9B=3296923周期，21.979487ms |
| foreground.calls / ui.calls | 各0xE34=3636 |
| ui.stage / page / io_status | 7=RENDER / 8 / 0=HAL_OK |
| ui.page_submissions / last_page | 0x278=632 / 0 |

这次约11.48秒运行中，已观测相邻入口最大约22ms，末次尚未完成间隔约1.7ms；结合两种时钟的运行时长，
不支持“前台数秒完全没执行”的解释。RENDER年龄含抢占，不能直接称渲染卡死；页面提交被接受不等于面板显示完成。
末次提交第0页与632次总提交，不能单独证明每次都只发第0页。

## 界面问题的主机复现

power_ui.c在状态变化时重置next_page为MENU_ROWS，STARTING静默路径也重置；重返RUNNING便重画并从第0页开始。
临时探针复用真实power_ui.c/power_menu.c和main_ui_test夹具，模拟400组BOOTSTRAP/RUNNING交替，HAL传输始终OK，
断言第7页应有提交。结果失败：第0页401次，第1/2页各1次（含循环前菜单准备），第3～7页均0。
探针/日志在忽略目录.superpowers/eventdiag/ui-churn.c/.log。这证明状态频繁变化可以使后续页饥饿，
不依赖前台数秒停摆；仍需修复后的板测确认是否为实板界面的主因。
修复必须兼顾启动静默、不可变DMA快照及静默期间命令包被取消后的重试，不能简单去掉所有重置。

## 边界与下一步

真实回流/采样异常尚未区分；16保护保持。电流故障发生于恢复后的RUNNING，不能再用旧自举变量猜测阶段。
原文档记载电压前端100Ω/470nF约47us；将名义模型加入该电压一阶环节并延长到12秒，仍无故障，输出6.004V、峰6.010V。
这只是探索实验，未核实当前左输出模拟前端/电容实际参数，不证明板上稳定性。
本次不修改频率、PI、门限或UI行为；未验证板上最坏时序或硬件OCP接线。
