meetyaothenstop/vscode/.superpowers/oled-menu/originals/Core/Src/main.c

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
/* Includes ------------------------------------------------------------------*/
#include "main.h"

/* USER CODE BEGIN Includes */
#include "key.h"
#include "OLED_IIC_Config.h"
#include "forward.h"
#include "adc_acquire.h"
#include "power_control.h"
/* USER CODE END Includes */

ADC_HandleTypeDef hadc1;

HRTIM_HandleTypeDef hhrtim1;

I2C_HandleTypeDef hi2c1;

UART_HandleTypeDef huart2;

/* USER CODE BEGIN PV */
AdcMeasurements adc_measurements;

/* USER CODE END PV */

void SystemClock_Config(void);
static void MX_GPIO_Init(void);
static void MX_ADC1_Init(void);
static void MX_HRTIM1_Init(void);
static void MX_I2C1_Init(void);
static void MX_USART2_UART_Init(void);
/**
  * @brief  The application entry point.
  * @retval int
  */
int main(void)
{

  /* MCU Configuration--------------------------------------------------------*/

  /* Reset of all peripherals, Initializes the Flash interface and the Systick. */
  HAL_Init();

  /* Configure the system clock */
  SystemClock_Config();

  /* Initialize all configured peripherals */
  MX_GPIO_Init();
  MX_ADC1_Init();
  MX_HRTIM1_Init();
  MX_I2C1_Init();
  MX_USART2_UART_Init();
  /* USER CODE BEGIN 2 */
  if (HAL_ADCEx_Calibration_Start(&hadc1, ADC_SINGLE_ENDED) != HAL_OK)
  {
    Error_Handler();
  }
  Key_Init();
  OLED_Init();
  forward_initialize(0.0);
  if (Power_Init(&hadc1, &hhrtim1) != HAL_OK)
  {
    Error_Handler();
  }
  /* USER CODE END 2 */

  /* Infinite loop */
  /* USER CODE BEGIN WHILE */
  while (1)
  {
    /* USER CODE END WHILE */

    /* USER CODE BEGIN 3 */
    Power_Service(&adc_measurements);
    HAL_Delay(1);
  }
  /* USER CODE END 3 */
}

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
