meetyaothenstop/vscode/Core/Inc/main.h

#define key4_Pin GPIO_PIN_13
#define key4_GPIO_Port GPIOC
#define key1_Pin GPIO_PIN_4
#define key1_GPIO_Port GPIOB
#define key2_Pin GPIO_PIN_5
#define key2_GPIO_Port GPIOB
#define key3_Pin GPIO_PIN_6
#define key3_GPIO_Port GPIOB
