meetyaothenstop/vscode/Core/Inc/boost_control_rates.h

#ifndef BOOST_CONTROL_RATES_H
#define BOOST_CONTROL_RATES_H
#include "control_rates.h"

/* Protected MAIN mode2/mode4 workers share this profile. Public controller
 * entries and both Buck modes retain CONTROL_* rates. Fast safety stays150kHz. */
#define BOOST_CONTROL_PWM_PERIODS 6U
#if POWER_MULTIRATE_CONTROL
#define BOOST_CONTROL_CURRENT_DT 0.000040f
#define BOOST_CONTROL_VOLTAGE_DT 0.000200f
/*6238/(s+6238), Tustin b=w*T/(2+w*T), a=(2-w*T)/(2+w*T), state=b*(1+a).*/
#define BOOST_CONTROL_FILTER_B 0.38416061091267395f
#define BOOST_CONTROL_FILTER_STATE 0.47316247187175015f
#define BOOST_CONTROL_FILTER_A 0.23167877817465202f
#define BOOST_CONTROL_PRECHARGE_B 0.11092144101852841f
#define BOOST_CONTROL_PRECHARGE_STATE 0.19723574988180306f
#define BOOST_CONTROL_PRECHARGE_A 0.7781571179629432f
#define BOOST_CONTROL_DELAY_STEPS 1U /*one40us control step; backend also gates outputs*/
#else
#define BOOST_CONTROL_CURRENT_DT CONTROL_CURRENT_DT
#define BOOST_CONTROL_VOLTAGE_DT CONTROL_VOLTAGE_DT
#define BOOST_CONTROL_FILTER_B CONTROL_FILTER_B
#define BOOST_CONTROL_FILTER_STATE CONTROL_FILTER_STATE
#define BOOST_CONTROL_FILTER_A CONTROL_FILTER_A
#define BOOST_CONTROL_PRECHARGE_B CONTROL_PRECHARGE_B
#define BOOST_CONTROL_PRECHARGE_STATE CONTROL_PRECHARGE_STATE
#define BOOST_CONTROL_PRECHARGE_A CONTROL_PRECHARGE_A
#define BOOST_CONTROL_DELAY_STEPS CONTROL_DELAY_STEPS
#endif
#endif
