meetyaothenstop/vscode/Core/Inc/control_rates.h

#ifndef CONTROL_RATES_H
#define CONTROL_RATES_H
#include "power_build_config.h"

/* PWM/ADC/fast safety stay150kHz. MAIN Buck/public arithmetic rates;
 * protected Boost directions share the profile in boost_control_rates.h. */
#ifndef POWER_MULTIRATE_CONTROL
#define POWER_MULTIRATE_CONTROL POWER_MAIN_APPLICATION
#endif
#if POWER_MULTIRATE_CONTROL && !POWER_MAIN_APPLICATION
#error Multirate control requires the main application.
#endif
#ifndef POWER_RAW_FAST_IRQ
#define POWER_RAW_FAST_IRQ POWER_MULTIRATE_CONTROL
#endif
#if POWER_RAW_FAST_IRQ && !POWER_MULTIRATE_CONTROL
#error Raw fast IRQ requires MAIN multirate control.
#endif
#if POWER_MULTIRATE_CONTROL
#define CONTROL_CURRENT_DT 0.000020f
#define CONTROL_VOLTAGE_DT 0.000100f
#define CONTROL_FILTER_B 0.2377467794801433f
#define CONTROL_FILTER_STATE 0.3624464966539268f
#define CONTROL_FILTER_A 0.5245064410397133f
#define CONTROL_PRECHARGE_B 0.05871721982718048f
#define CONTROL_PRECHARGE_STATE 0.11053901584589407f
#define CONTROL_PRECHARGE_A 0.8825655603456389f
#define CONTROL_DELAY_STEPS 1U /*20us: legacy delay was3x6.667us*/
#else
#define CONTROL_CURRENT_DT 6.66666666666666665e-06f
#define CONTROL_VOLTAGE_DT 6.66666666666666665e-06f
#define CONTROL_FILTER_B 0.0203698000000000004f
#define CONTROL_FILTER_STATE 0.0399097424959199976f
#define CONTROL_FILTER_A 0.959260400000000013f
#define CONTROL_PRECHARGE_B CONTROL_FILTER_B
#define CONTROL_PRECHARGE_STATE CONTROL_FILTER_STATE
#define CONTROL_PRECHARGE_A CONTROL_FILTER_A
#define CONTROL_DELAY_STEPS 3U
#endif
#endif
