meetyaothenstop/vscode/Core/Src/power_ui.c

#include "power_ui.h"
#include "power_menu.h"
#include "power_control.h"
#include "power_build_config.h"
#include "key.h"
#include "OLED_Function.h"
#include "power_event_diag.h"
#if POWER_EVENT_DIAGNOSTICS
#define EVENT_UI(stage,page,status) PowerEvent_UIMark((stage),(page),(uint32_t)(status))
#else
#define EVENT_UI(stage,page,status) ((void)0)
#endif

#define DISPLAY_PERIOD_MS 200U

static PowerMenu menu;
/* Foreground-only scratch frame: keep 176 bytes off the shared IRQ stack. */
static MenuFrame frame;
static uint32_t frame_tick, retry_tick, last_fault;
static MenuState last_state;
static uint8_t next_page, dirty, display_failed, last_pending, last_valid;
#if POWER_OLED_FRAME_RESUME
static uint8_t page_inflight,urgent_redraw;
#endif

void PowerUI_Init(void)
{
    Menu_Init(&menu);
    frame_tick = retry_tick = last_fault = 0;
    next_page = MENU_ROWS;
    dirty = 1;
    display_failed = last_pending = last_valid = 0;
    last_state = MENU_IDLE;
#if POWER_OLED_FRAME_RESUME
    page_inflight=urgent_redraw=0;
#endif
}

static MenuTelemetry telemetry(const AdcMeasurements *measurements)
{
    MenuTelemetry data = {0};
    /* Read pending before state: if the IRQ consumes pending between these
     * reads, its new starting state still prevents edits and permits stop. */
    data.pending = (uint8_t)Power_IsStartPending();
    switch (power_status.state) {
    case POWER_BOOTSTRAP: case POWER_ARMING: case POWER_CHANGEOVER:
        data.state = MENU_STARTING; break;
    case POWER_RUNNING: case POWER_HOLD: data.state = MENU_RUNNING; break;
    case POWER_FAULT: data.state = MENU_FAULT; break;
    default: data.state = MENU_IDLE; break;
    }
    data.fault = power_status.fault;
    data.fault_detail = power_status.fault_detail;
    data.fault_input_volts = power_status.fault_input_volts;
    data.valid = (uint8_t)Power_SamplesAreValid();
    /* Power_Service already copied/converts the three ADC channels in the
     * foreground. No format or OLED operation masks the control interrupt. */
    data.v_left = (float)measurements->v_high;
    data.v_right = (float)measurements->v_low;
    data.il = (float)measurements->il;
    return data;
}

static void sync_control_state(const MenuTelemetry *data)
{
    if (data->state != last_state || data->fault != last_fault || data->pending != last_pending) {
        menu.notice = MENU_NOTICE_NONE;
        if (data->pending || data->state == MENU_STARTING || data->state == MENU_RUNNING)
            menu.editing = 0;
        dirty = 1;
#if POWER_OLED_DMA
#if POWER_OLED_FRAME_RESUME
        /* Transient active states coalesce into the next complete frame.
         * Stop/fault, user actions and accepted cold starts replace stale UI. */
        if(data->fault!=last_fault || data->pending!=last_pending ||
           data->state==MENU_IDLE || data->state==MENU_FAULT ||
           last_state==MENU_IDLE || last_state==MENU_FAULT)urgent_redraw=1;
#else
        /* A completed old packet may drain, then restart the new state at page 0. */
        next_page = MENU_ROWS;
#endif
#endif
    }
    if (data->valid != last_valid) dirty = 1;
    last_state = data->state;
    last_fault = data->fault;
    last_pending = data->pending;
    last_valid = data->valid;
}

void PowerUI_Service(const AdcMeasurements *measurements)
{
    EVENT_UI(POWER_EVENT_UI_ENTRY,next_page,HAL_OK);
    EVENT_UI(POWER_EVENT_UI_KEYS,next_page,HAL_OK);
    Key_Scan();
    uint8_t up = Key_IsPressed(KEY_ID_1);
    uint8_t down = Key_IsPressed(KEY_ID_2);
    uint8_t ok = Key_IsPressed(KEY_ID_3);
    uint8_t back = Key_IsPressed(KEY_ID_4);
    MenuKey key = back ? MENU_KEY_BACK : (ok ? MENU_KEY_OK :
                  (up ? MENU_KEY_UP : (down ? MENU_KEY_DOWN : MENU_KEY_NONE)));
    MenuTelemetry data = telemetry(measurements);
    sync_control_state(&data);
    if (key != MENU_KEY_NONE) {
        MenuRequest request = Menu_HandleKey(&menu, key, &data);
        if (request.action == MENU_ACTION_STOP) Power_Stop();
        else if (request.action == MENU_ACTION_START) {
            unsigned mode = (unsigned)request.mode + (menu.direction == MENU_REVERSE ? 2U : 0U);
            Menu_StartResult(&menu, Power_RequestStart(mode, request.target_volts));
        }
        data = telemetry(measurements);
        dirty = 1;
#if POWER_OLED_FRAME_RESUME
        urgent_redraw=1;
#endif
    }
    sync_control_state(&data);

#if POWER_OLED_DMA
    uint8_t allow = (uint8_t)(!data.pending && data.state != MENU_STARTING);
    EVENT_UI(POWER_EVENT_UI_POLL,next_page,HAL_OK);
    HAL_StatusTypeDef transfer = OLED_TransferPoll(allow);
    if (transfer == HAL_BUSY) {
        EVENT_UI(POWER_EVENT_UI_WAIT_DMA,next_page,transfer);
        return;
    }
    if (transfer != HAL_OK) {
        EVENT_UI(POWER_EVENT_UI_IO_ERROR,next_page,transfer);
        display_failed = 1;
        next_page = MENU_ROWS;
        dirty = 1;
#if POWER_OLED_FRAME_RESUME
        page_inflight=0;urgent_redraw=1;
#endif
        return;
    }
#if POWER_OLED_FRAME_RESUME
    if(OLED_TakePageComplete() && page_inflight) {
        page_inflight=0;++next_page;
        if(next_page==MENU_ROWS)EVENT_UI(POWER_EVENT_UI_FRAME_DONE,MENU_ROWS-1U,HAL_OK);
    }
    if(urgent_redraw) {
        next_page=MENU_ROWS;page_inflight=0;urgent_redraw=0;
    }
#endif
    if (!allow) {
        /* Poll may drain an old packet, but RefreshPage must not start a new
         * command during startup, even when legacy OLED mute is disabled. */
#if !POWER_OLED_FRAME_RESUME
        next_page = MENU_ROWS;
#endif
        dirty = 1;
        EVENT_UI(POWER_EVENT_UI_STARTUP_MUTED,next_page,HAL_OK);
        return;
    }
#endif
#if POWER_TEST_SKIP_OLED_ACTIVE
    if (data.pending || data.state == MENU_STARTING ||
            (!POWER_OLED_DMA && data.state == MENU_RUNNING)) {
        /* Key/start/stop handling above stays live. Restart a complete
         * display frame once faulted/stopped instead of sending stale pages. */
        next_page = MENU_ROWS;
        dirty = 1;
        return;
    }
#endif
    uint32_t now = HAL_GetTick();
    if (display_failed && now - retry_tick < DISPLAY_PERIOD_MS) {
        EVENT_UI(POWER_EVENT_UI_WAIT_REFRESH,next_page,HAL_OK);
        return;
    }
    if (next_page == MENU_ROWS && (dirty || now - frame_tick >= DISPLAY_PERIOD_MS)) {
        EVENT_UI(POWER_EVENT_UI_RENDER,next_page,HAL_OK);
        Menu_Render(&menu, &data, &frame);
        OLED_ClearRAM();
        for (unsigned row = 0; row < MENU_ROWS; ++row)
            OLED_DrawStr(0, (int16_t)(row * 8U), frame.rows[row]);
        next_page = 0;
        frame_tick = now;
        dirty = 0;
        EVENT_UI(POWER_EVENT_UI_FRAME_READY,next_page,HAL_OK);
    }
    if (next_page < MENU_ROWS) {
        EVENT_UI(POWER_EVENT_UI_SUBMIT_PAGE,next_page,HAL_OK);
        HAL_StatusTypeDef result = OLED_RefreshPage(next_page);
        if (result == HAL_OK) {
#if POWER_OLED_FRAME_RESUME
            page_inflight=1;
            EVENT_UI(POWER_EVENT_UI_PAGE_QUEUED,next_page,result);
#else
            ++next_page;
            EVENT_UI(POWER_EVENT_UI_PAGE_QUEUED,next_page-1U,result);
#endif
            display_failed = 0;
        } else if (result != HAL_BUSY) {
            EVENT_UI(POWER_EVENT_UI_IO_ERROR,next_page,result);
            /* An absent display never blocks key handling or power control. */
            display_failed = 1;
            retry_tick = now;
            next_page = MENU_ROWS;
            dirty = 1;
        } else {
            EVENT_UI(POWER_EVENT_UI_PAGE_BUSY,next_page,result);
        }
    } else {
        EVENT_UI(POWER_EVENT_UI_IDLE,next_page,HAL_OK);
    }
}
