meetyaothenstop/vscode/(commit log)

2026-05-22 first stage
2026-05-22 second stage
2026-10-26 Record Buck FAST input fault and observed ISR timing
2026-10-26 Allow 14V input margin in restricted Buck FAST bench
2026-10-26 Set restricted Buck FAST input window to 10-14V
2026-10-26 Match Buck bench model to 460uF and record measured overvoltage
2026-10-27 Record Watch 2 setup and inconsistent attached fault snapshot
2026-10-28 Sample bench input later with independently triggered ADC2
2026-10-28 Raise FAST bench output trip to 7 V at the 6 V target
2026-10-28 Record fault 4 with confirmed running 7 V protection
2026-10-29 Raise FAST bench output trip to 8 V at the 6 V target
2026-10-29 fix: restore live OLED telemetry with asynchronous I2C DMA
2026-10-29 Prepare restricted 24V to 12V Buck bench with voltage margins
2026-10-29 Record user-confirmed 150W load and 50V output capacitors
2026-10-29 Record verified 24V bench programming after STOP confirmation
2026-10-29 Raise 24V sampled overcurrent trip to 6A and preserve fault8 evidence
2026-10-29 Raise 24V output protection to 15V at the 12V target
2026-10-30 Integrate optimized Buck into four-mode main application
2026-10-30 Reduce main Buck loop work while preserving protection and PWM behavior
2026-10-30 Inline main Buck compare mapping and preserve only consumed resume fields
2026-10-30 Bound forward Buck write window and check absolute exit phase
2026-10-31 Record stable higher Buck targets and lower-target output fault feedback
2026-10-31 Record 11V fault feedback and low-target nominal model comparison
2026-10-31 Record confirmed 9V output fault snapshot and control evidence limits
2026-10-31 Analyze same-fault PI snapshot and adjacent output sample jump
2026-10-31 Set main forward Buck overvoltage ratio to1.5 and preserve other modes
2026-10-31 Cap main forward Buck OVP trip setting at 40V
2026-10-31 Set main forward Buck cold-start limits to 1A and 3V
2026-11-02 Set 6V minimum OVP threshold for main forward Buck
2026-11-02 Prepare main reverse Buck 12V-to-6V control and protection
2026-11-02 Reduce protected reverse Buck first-step overhead
2026-11-02 Apply W128 write phase window to main reverse Buck
2026-11-03 Stage main reverse Buck HOLD recovery before bootstrap enable
2026-11-03 Document conversation handoff through reverse Buck RES1
2026-11-03 Separate 150kHz protection from 50kHz current and 10kHz voltage control
2026-11-03 Move main fast protection and PWM density to integer ADC path
2026-11-03 Record RAW1 reverse current-direction fault and read-only board observations
2026-11-03 Record EVT1 running-state direction fault and reproducible OLED frame starvation
2026-11-04 Resume MAIN OLED frames across startup transitions and track long-run sample ages
2026-11-04 Record restored FRM1 display and intermittent ADC-validity fault report
2026-11-04 Capture first-fault ADC entry flags without changing guards
2026-11-04 Retain ADC fault entry spacing and phase for startup diagnosis
2026-11-07 Centralize power-on voltage defaults without changing firmware
2026-11-07 Preserve user-selected forward 12V to18V test defaults
2026-11-07 Set MAIN forward Boost cold-start current check to1A
2026-11-07 Align MAIN forward Boost electrical limits with Buck
2026-11-08 Run MAIN forward Boost at25kHz current and5kHz voltage rates
2026-11-08 Share fixed ADC2 input sampling between MAIN forward Buck and Boost
2026-11-09 Add reported fault checklist with current limits and S/T code references
